DeeEmm/DIY-Flow-Bench/PCB/PCB Bottom.png

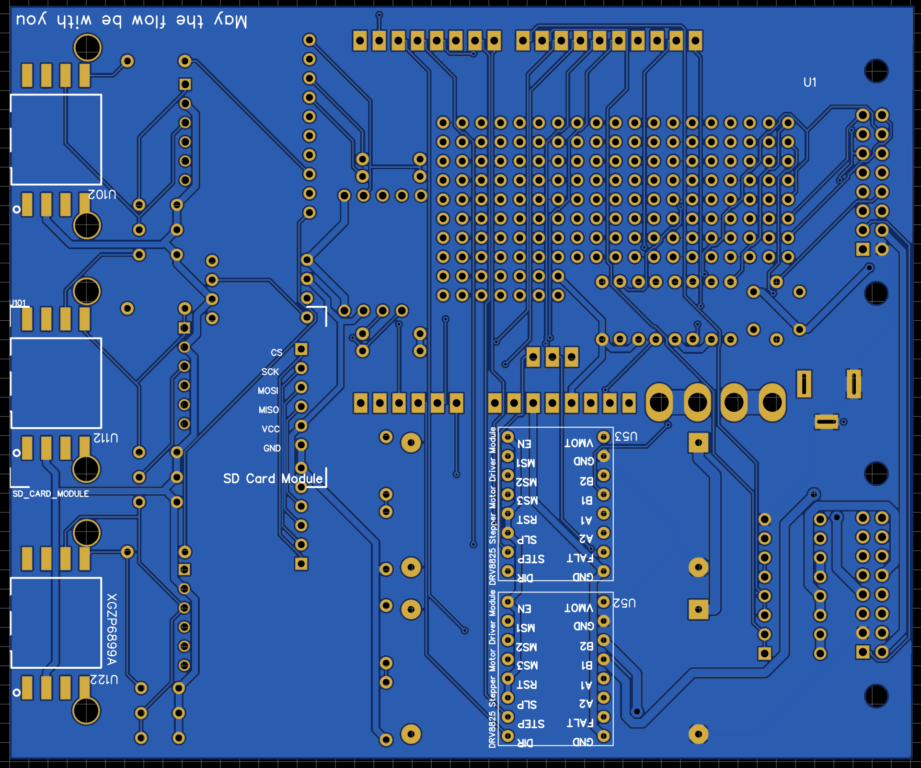
PCB/PCB Bottom.png
