DeeEmm/DIY-Flow-Bench/PCB/PCB Top.png

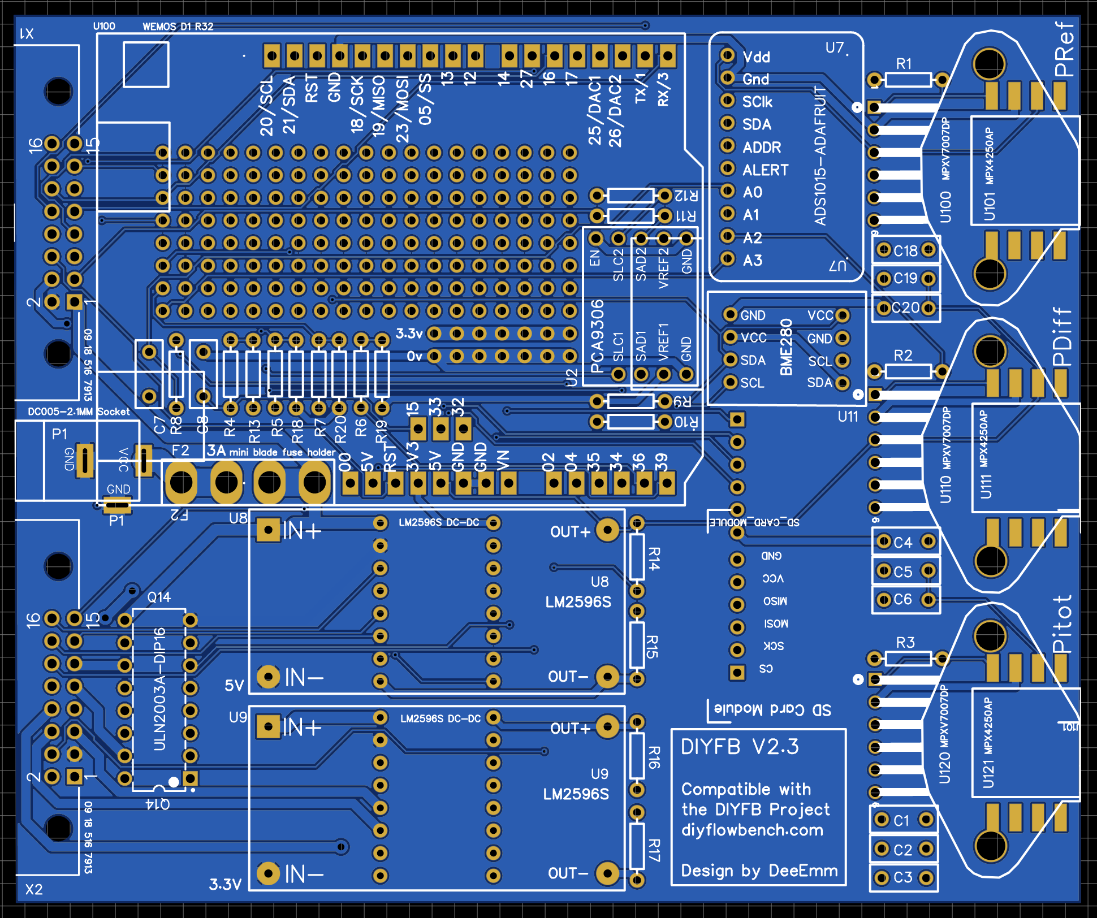
PCB/PCB Top.png
