DeeEmm/DIY-Flow-Bench/docs/BOM_DIY-FLOW-BENCH-V2-3.csv

ID | Name | Designator | Footprint | Quantity | Manufacturer Part | Manufacturer | Supplier | Supplier Part | Price
1 | 330nF | C1 | 3MM_X_7.5MM_W/_.5MM_LEADS_AT_5MM | 1 | CT4-0805Y334M500 | CT4-0805Y334M500 | LCSC | C3784
2 | 10nF | C2,C5,C19 | 3MM_X_7.5MM_W/_.5MM_LEADS_AT_5MM | 3 | CT4-0805B103K500F3 | FH | LCSC | C94713 | 0.027
3 | 1uF | C3,C6,C7,C8,C20 | 3MM_X_7.5MM_W/_.5MM_LEADS_AT_5MM | 5 | CT4-0805B105K500F3 | FH | LCSC | C94708 | 0.053
4 | 330nF | C4,C18 | 3MM_X_7.5MM_W/_.5MM_LEADS_AT_5MM | 2 | CT4-0805Y334M500 | ReliaPro | LCSC | C3784
5 | mini blade fuse holder | F2 | BLADE FUSE PCB V | 1 | ?
6 | DC005-2.1MM Socket | P1 | RS-PRO 884-0957 DC005-2.1MM | 1 | RS PRO Through Hole DC Power Socket 2.1mm Right Angle 2A | RS | RS-Online | 884-0957
7 | ULN2003A-DIP16 | Q14 | DIP-16_L20.4-W5.8-P2.54-LS7.6-BL | 1 | ULN2003A-DIP16 | MIXIC | LCSC | C112203 | 0.167
8 | 10KΩ(1002) | R1,R2,R3,R4,R5,R6,R7,R13,R14,R15,R16,R17,R18,R19,R20 | RESISTOR | 15 | MF1/4W-10KΩ±1% T52 | CCO | LCSC | C119347 | 0.01
9 | 0Ω(LINK) | R8 | RESISTOR | 1 | MF1/4W-10KΩ±1% T52 | CCO | LCSC | C119347 | 0.01
10 | 4k7Ω | R9,R10,R11,R12 | RESISTOR | 4
11 | WEMOS D1 R32 | U1 | WEMOS_ESP32_D1 | 1
12 | Sparkfun PCA9306 Logic Level Translator | U2 | SPARKFUN PCA9306 V2 | 1 |  | PCA9306 | Sparkfun | PCA9306
13 | ADS1015-ADAFRUIT | U7 | ADS1015_MODULE | 1 | ADS1015_12Bit | Adafruit
14 | LM2596S DC-DC | U8,U9 | LM2596S | 2 | OZ0055 | - | QLOUNI | -
15 | PROTO-AREA | U10 | PROTO-AREA | 1 |  |  | DeeEmm | DIYFB-V2.2-PROTO-AREA
16 | BME280-Dual-Footprint | U11 | BME280-DUAL-FOOTPRINT | 1
17 | SD_CARD_MODULE | U50,U51 | SD_CARD | 2
18 | DRV8825 Stepper Motor Driver Module | U52,U53 | DRV8825 STEPPER MOTOR DRIVER CARRIER | 2 | DRV8825 Stepper Motor Driver Module
19 | MPX4250AP | U100,U110,U120 | FREESCALE_CASE_867B-04 | 3 | ?
20 | MPXV7007DP | U101,U111,U121 | SENSOR-SMD_MPXV7007DP | 3 | MPXV7007DP | NXP(恩智浦) | LCSC | C881771 | 15.174
21 | XGZP6899A | U102,U112,U122 | SENSOR-SMD_XGZP6899A | 3 | GZP6899A001KPW50K | Sencoch(芯感智) | LCSC | C3038031 | 8.988
22 | 09 18 516 7913 | X1,X2 | 918516X913 | 2
