DeeEmm/DIY-Flow-Bench/ESP32/DIY-Flow-Bench/tools/MAF polynomial calcs V3.xlsx

Sheet: ACDELCO_92281162
V3
X Values | Y Values
millivolts | kg/hour | Calculated |  | C6 | C5 | C4 | C3 | C2 | C1 | C0
 |  |  | Coeff | 1.114334908e-21 | -3.244159168e-17 | 9.639231496e-13 | 0.000000006 | 0.000010148 | 0.007062544 | 1.734046571 | DEC
0 | 0 |  |  | 1.114334908e-21 | -3.244159168e-17 | 9.639231496e-13 | 6.388302762e-09 | 1.014759427e-05 | 0.007062543912 | 1.734046571 | E+n
10 | 1.81 | 1.805693167 | R2 | 0.9999999999
20 | 1.88 | 1.879407747
30 | 1.96 | 1.955228987 |  | C0 | C1 | C2 | C3 | C4 | C5 | C6
40 | 2.04 | 2.033195794 |  | 1.734046571 | 0.007062544 | 0.000010148 | 0.000000006 | 9.639231496e-13 | -3.244159168e-17 | 1.114334908e-21 | DEC
50 | 2.12 | 2.113347304 |  | 1.734046571 | 0.007062543912 | 1.014759427e-05 | 6.388302762e-09 | 9.639231496e-13 | -3.244159168e-17 | 1.114334908e-21 | E+n
60 | 2.19 | 2.195722886
70 | 2.28 | 2.280362134
80 | 2.37 | 2.367304874
90 | 2.46 | 2.456591161
100 | 2.55 | 2.548261276
110 | 2.64 | 2.64235573
120 | 2.74 | 2.73891526
130 | 2.84 | 2.837980831
140 | 2.94 | 2.939593633
150 | 3.05 | 3.043795086
160 | 3.15 | 3.150626832
170 | 3.26 | 3.260130741
180 | 3.37 | 3.372348907
190 | 3.48 | 3.48732365
200 | 3.61 | 3.605097513
210 | 3.72 | 3.725713265
220 | 3.84 | 3.849213897
230 | 3.98 | 3.975642624
240 | 4.1 | 4.105042884
250 | 4.23 | 4.237458337
260 | 4.37 | 4.372932866
270 | 4.51 | 4.511510577
280 | 4.65 | 4.653235794
290 | 4.8 | 4.798153066
300 | 4.95 | 4.94630716
310 | 5.09 | 5.097743064
320 | 5.25 | 5.252505988
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
4910 | 1520.51 | 1520.506551
4920 | 1530.03 | 1530.027543
4930 | 1539.59 | 1539.591654
4940 | 1549.2 | 1549.199004
4950 | 1558.85 | 1558.849716
4960 | 1568.54 | 1568.543911
4970 | 1578.28 | 1578.28171
4980 | 1588.06 | 1588.063234
4990 | 1597.89 | 1597.888605
5000 | 1607.75 | 1607.757946

Sheet: BOSCH_0280218067
V3 |  |  |  | Values include reverse flow portion from 1v down to 0v
X Values | Y Values
millivolts | kg/hour | Calculated |  | C6 | C5 | C4 | C3 | C2 | C1 | C0
 |  |  |  | Coeff | -2.736176114e-20 | 1.006005487e-15 | -2.686283635e-12 | -0.000000006 | 0.000090925 | -0.152947520 | 81.928368451 | DEC
20 | 73.6 | 78.90573578 |  |  | -2.736176114e-20 | 1.006005487e-15 | -2.686283635e-12 | -6.476436318e-09 | 9.092490865e-05 | -0.1529475199 | 81.92836845 | E+n
40 | 71.6 | 75.95552625 |  | R2 | 0.9999536889
60 | 69.6 | 73.07741399
80 | 67.6 | 70.2710636 |  |  | C0 | C1 | C2 | C3 | C4 | C5 | C6
100 | 65.6 | 67.53613052 |  | Coeff | 81.928368451 | -0.152947520 | 0.000090925 | -0.000000006 | -2.686283635e-12 | 1.006005487e-15 | -2.736176114e-20 | DEC
120 | 62.6 | 64.87226139 |  |  | 81.92836845 | -0.1529475199 | 9.092490865e-05 | -6.476436318e-09 | -2.686283635e-12 | 1.006005487e-15 | -2.736176114e-20 | E+n
140 | 61.6 | 62.27909448
160 | 59.6 | 59.75626
180 | 57.6 | 57.30338055
200 | 55.6 | 54.92007145
210 | 53.6 | 53.75438368
230 | 51.6 | 51.47469388
250 | 50.6 | 49.26358341
270 | 48.6 | 47.12064513
290 | 47.6 | 45.04546629
310 | 45.6 | 43.03762893
330 | 43.6 | 41.09671026
350 | 42.6 | 39.22228299
370 | 40.6 | 37.41391573
390 | 39.6 | 35.67117333
410 | 37.6 | 33.99361726
430 | 36.6 | 32.38080597
450 | 34.6 | 30.83229526
470 | 33.6 | 29.34763861
490 | 31.6 | 27.92638757
510 | 30.6 | 26.56809209
530 | 29.6 | 25.2723009
550 | 27.6 | 24.03856186
570 | 26.6 | 22.8664223
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
4860 | 1613.6 | 1611.19599 | 1611.513903
4880 | 1640.6 | 1639.404426 | 1640.171333
4900 | 1669.6 | 1668.051774 | 1669.322696
4920 | 1695.6 | 1697.143676 | 1698.976986
4940 | 1723.6 | 1726.685822 | 1729.143362
4960 | 1753.6 | 1756.683946 | 1759.831147
4980 | 1805.5 | 1787.14383 | 1791.049834

Sheet: DELPHI AF10118
V3
X Values | Y Values
millivolts | kg/hour | Calculated |  | C6 | C5 | C4 | C3 | C2 | C1 | C0
 |  |  | Coeff | -9.556008283e-19 | 1.317681456e-14 | -6.821730339e-11 | 0.000000168 | -0.000180578 | 0.080079937 | -1.006588218 | DEC
0 | 0 | 0 |  | -9.556008283e-19 | 1.317681456e-14 | -6.821730339e-11 | 1.680282772e-07 | -0.000180577572 | 0.0800799375 | -1.006588218 | E+n
600 | 5.62 | 10.46663831 | R2 | 0.9985975854
800 | 8.982 | 9.643659746
940 | 10.711 | 10.02249742 |  | C0 | C1 | C2 | C3 | C4 | C5 | C6
1000 | 12.44 | 10.52796485 | Coeff | -1.006588218 | 0.080079937 | -0.000180578 | 0.000000168 | -6.821730339e-11 | 1.317681456e-14 | -9.556008283e-19 | DEC
1300 | 19.597 | 16.55600609 |  | -1.006588218 | 0.0800799375 | -0.000180577572 | 1.680282772e-07 | -6.821730339e-11 | 1.317681456e-14 | -9.556008283e-19 | E+n
1400 | 22.382 | 19.85212344
1500 | 25.456 | 23.73566309
1600 | 29.251 | 28.15422496
1700 | 33.526 | 33.05135173
1800 | 38.137 | 38.37167655
1900 | 43.036 | 44.0653827
2000 | 48.175 | 50.09197514
2100 | 53.987 | 56.42336415
2200 | 59.222 | 63.04626083
2400 | 74.112 | 77.19698273
2600 | 91.259 | 92.78153075
2800 | 111.144 | 110.3118333
3000 | 132.95 | 130.5299208
3200 | 158.262 | 154.3194554
3400 | 187.177 | 182.5732261
3600 | 217.724 | 216.0166104
3800 | 258.503 | 254.9870015
4000 | 295.631 | 299.1692013
4250 | 342.461 | 359.6618743
4500 | 421.04 | 420.7196224
4750 | 490.925 | 472.4091462
5000 | 490.925 | 498.9563941
 |  |  |  | NOTE: Calculated data column should match the Y column values. It is calculated from the generated polynomials and X value. Use it as a validation check
 |  |  |  | C0 | -1.006588218
 |  |  |  | C1 | 0.0800799375
 |  |  |  | C2 | -0.000180577572
 |  |  |  | C3 | 1.680282772e-07
 |  |  |  | C4 | -6.821730339e-11
 |  |  |  | C5 | 1.317681456e-14
 |  |  |  | C6 | -9.556008283e-19

Sheet: BOSCH_0280002421
V3
X Values | Y Values
millivolts | kg/hour | Calculated |  | C6 | C5 | C4 | C3 | C2 | C1 | C0
 |  |  | Coeff | 1.698421826e-19 | -2.424047372e-15 | 1.821794921e-11 | -0.000000059 | 0.000123116 | -0.094665483 | 18.539247499 | DEC
0 | 0 | 0 |  | 1.698421826e-19 | -2.424047372e-15 | 1.821794921e-11 | -5.853131689e-08 | 0.0001231159214 | -0.09466548312 | 18.5392475 | E+n
1231.5 | 15 | 14.98592449 | R2 | 0.9999999127
1475.8 | 30 | 30.04502093
1831 | 60 | 59.94071279 |  | C0 | C1 | C2 | C3 | C4 | C5 | C6
2307.4 | 120 | 120.0341167 | Coeff | 18.539247499 | -0.094665483 | 0.000123116 | -0.000000059 | 1.821794921e-11 | -2.424047372e-15 | 1.698421826e-19 | DEC
2921.2 | 250 | 250.0564767 |  | 18.5392475 | -0.09466548312 | 0.0001231159214 | -5.853131689e-08 | 1.821794921e-11 | -2.424047372e-15 | 1.698421826e-19 | E+n
3287.4 | 370 | 369.7892392
3546.1 | 480 | 480.214746
3843.2 | 640 | 639.9343947
4149.9 | 850 | 849.9891884
4331.2 | 1000 | 1000.01018
 |  |  |  | NOTE: Calculated data column should match the Y column values. It is calculated from the generated polynomials and X value. Use it as a validation check
 |  |  |  | C0 | 18.5392475
 |  |  |  | C1 | -0.09466548312
 |  |  |  | C2 | 0.0001231159214
 |  |  |  | C3 | -5.853131689e-08
 |  |  |  | C4 | 1.821794921e-11
 |  |  |  | C5 | -2.424047372e-15
 |  |  |  | C6 | 1.698421826e-19

Sheet: BOSCH_0280218008
V3
X Values | Y Values
millivolts | kg/hour | Calculated |  | C6 | C5 | C4 | C3 | C2 | C1 | C0
 |  |  | Coeff | 3.87964694e-19 | -6.742284983e-15 | 5.333133272e-11 | -0.000000215 | 0.000488590 | -0.526769493 | 215.833017131 | DEC
0 | 0 | 0 |  | 3.87964694e-19 | -6.742284983e-15 | 5.333133272e-11 | -2.150081845e-07 | 0.0004885899551 | -0.5267694935 | 215.8330171 | E+n
1339.5 | 15 | 14.98890353 | R2 | 0.9999999329
1625.1 | 30 | 30.03942921
2010.9 | 60 | 59.94244566 |  | C0 | C1 | C2 | C3 | C4 | C5 | C6
2556.4 | 120 | 120.0470834 | Coeff | 215.833017131 | -0.526769493 | 0.000488590 | -0.000000215 | 5.333133272e-11 | -6.742284983e-15 | 3.87964694e-19 | DEC
3265.5 | 250 | 249.9928146 |  | 215.8330171 | -0.5267694935 | 0.0004885899551 | -2.150081845e-07 | 5.333133272e-11 | -6.742284983e-15 | 3.87964694e-19 | E+n
3671.7 | 370 | 369.9022205
3949 | 480 | 480.1526031
4260 | 640 | 639.918381
4572.7 | 850 | 850.0161192
 |  |  |  | NOTE: Calculated data column should match the Y column values. It is calculated from the generated polynomials and X value. Use it as a validation check
 |  |  |  | C0 | 215.8330171
 |  |  |  | C1 | -0.5267694935
 |  |  |  | C2 | 0.0004885899551
 |  |  |  | C3 | -2.150081845e-07
 |  |  |  | C4 | 5.333133272e-11
 |  |  |  | C5 | -6.742284983e-15
 |  |  |  | C6 | 3.87964694e-19

Sheet: BOSCH 0280218038
V3
X Values | Y Values
millivolts | kg/hour | Calculated |  | C6 | C5 | C4 | C3 | C2 | C1 | C0
 |  |  | Coeff | 1.500832877e-19 | -2.326988882e-15 | 1.814731441e-11 | -0.000000071 | 0.000167232 | -0.168837155 | 60.012246926 | DEC
0 | 0 | 0 |  | 1.500832877e-19 | -2.326988882e-15 | 1.814731441e-11 | -7.088416805e-08 | 0.0001672318786 | -0.1688371547 | 60.01224693 | E+n
1269.5 | 10.28169014 | 10.25327361 | R2 | 0.999999914
1406 | 15.42253521 | 15.49089444
1710 | 30.84507042 | 30.76295998 |  | C0 | C1 | C2 | C3 | C4 | C5 | C6
2156.3 | 61.69014085 | 61.76721282 | Coeff | 60.012246926 | -0.168837155 | 0.000167232 | -0.000000071 | 1.814731441e-11 | -2.326988882e-15 | 1.500832877e-19 | DEC
2752.2 | 123.3802817 | 123.3177158 |  | 60.01224693 | -0.1688371547 | 0.0001672318786 | -7.088416805e-08 | 1.814731441e-11 | -2.326988882e-15 | 1.500832877e-19 | E+n
3507 | 257.0422535 | 257.1172307
3939.3 | 380.4225352 | 380.3320377
4234.9 | 493.5211268 | 493.5731809
4566.9 | 658.028169 | 658.0192969
 |  |  |  |  |  |  |  |  |  |  |  | 71 | 73
 |  |  |  |  |  |  |  |  |  |  |  | 55.7632696 | 57.33406593
 |  |  |  |  |  |  |  |  |  |  |  | 0 | 0
 |  |  |  |  |  |  |  |  |  |  |  | 10 | 10.28169014
 |  |  |  |  |  |  |  |  |  |  |  | 15 | 15.42253521
 |  |  |  |  |  |  |  |  |  |  |  | 30 | 30.84507042
 |  |  |  |  |  |  |  |  |  |  |  | 60 | 61.69014085
 |  |  |  |  |  |  |  |  |  |  |  | 120 | 123.3802817
 |  |  |  |  |  |  |  |  |  |  |  | 250 | 257.0422535
 |  |  |  |  |  |  |  |  |  |  |  | 370 | 380.4225352
 |  |  |  |  |  |  |  |  |  |  |  | 480 | 493.5211268
 |  |  |  |  |  |  |  |  |  |  |  | 640 | 658.028169
 |  |  |  |  |  |  |  |  |  |  |  | (flowRateKGH / oldMafArea) * newMafArea;
 |  |  |  | NOTE: Data is transposed from 0208217531 as this uses same HPM5 style sensor but has different housing diameter
 |  |  |  | C0 | 60.01224693
 |  |  |  | C1 | -0.1688371547
 |  |  |  | C2 | 0.0001672318786
 |  |  |  | C3 | -7.088416805e-08
 |  |  |  | C4 | 1.814731441e-11
 |  |  |  | C5 | -2.326988882e-15
 |  |  |  | C6 | 1.500832877e-19

Sheet: BOSCH 0280217531
V3
X Values | Y Values
millivolts | kg/hour | Calculated |  | C6 | C5 | C4 | C3 | C2 | C1 | C0
 |  |  | Coeff | 1.459714168e-19 | -2.263235762e-15 | 1.765012772e-11 | -0.000000069 | 0.000162650 | -0.164211479 | 58.368075777 | DEC
0 | 0 | 0 |  | 1.459714168e-19 | -2.263235762e-15 | 1.765012772e-11 | -6.894213605e-08 | 0.0001626501833 | -0.1642114792 | 58.36807578 | E+n
1269.5 | 10 | 9.972362 | R2 | 0.999999914
1406 | 15 | 15.06648637
1710 | 30 | 29.92013916 |  | C0 | C1 | C2 | C3 | C4 | C5 | C6
2156.3 | 60 | 60.07496042 | Coeff | 58.368075777 | -0.164211479 | 0.000162650 | -0.000000069 | 1.765012772e-11 | -2.263235762e-15 | 1.459714168e-19 | DEC
2752.2 | 120 | 119.9391482 |  | 58.36807578 | -0.1642114792 | 0.0001626501833 | -6.894213605e-08 | 1.765012772e-11 | -2.263235762e-15 | 1.459714168e-19 | E+n
3507 | 250 | 250.072923
3939.3 | 370 | 369.9119819
4234.9 | 480 | 480.050628
4566.9 | 640 | 639.991371
 |  |  |  | NOTE: Calculated data column should match the Y column values. It is calculated from the generated polynomials and X value. Use it as a validation check
 |  |  |  | C0 | 58.36807578
 |  |  |  | C1 | -0.1642114792
 |  |  |  | C2 | 0.0001626501833
 |  |  |  | C3 | -6.894213605e-08
 |  |  |  | C4 | 1.765012772e-11
 |  |  |  | C5 | -2.263235762e-15
 |  |  |  | C6 | 1.459714168e-19

Sheet: BOSCH 0280218019
V3
X Values | Y Values
millivolts | kg/hour | Calculated |  | C6 | C5 | C4 | C3 | C2 | C1 | C0
 |  |  | Coeff | 1.912436353e-19 | -3.589391483e-15 | 3.06368606e-11 | -0.000000130 | 0.000308055 | -0.344050939 | 146.507540239 | DEC
0 | 0 | 0 |  | 1.912436353e-19 | -3.589391483e-15 | 3.06368606e-11 | -1.30212445e-07 | 0.0003080547392 | -0.3440509394 | 146.5075402 | E+n
1239 | 8 | 7.873897204 | R2 | 0.9999992952
1364.4 | 10 | 10.25636546
1524.1 | 15 | 14.91101283 |  | C0 | C1 | C2 | C3 | C4 | C5 | C6
1874.8 | 30 | 29.86112554 | Coeff | 146.507540239 | -0.344050939 | 0.000308055 | -0.000000130 | 3.06368606e-11 | -3.589391483e-15 | 1.912436353e-19 | DEC
2371 | 60 | 60.17983608 |  | 146.5075402 | -0.3440509394 | 0.0003080547392 | -1.30212445e-07 | 3.06368606e-11 | -3.589391483e-15 | 1.912436353e-19 | E+n
2999.8 | 120 | 119.8670596
3749.4 | 250 | 250.1023378
4169.5 | 370 | 369.926057
4457.8 | 480 | 480.0223084
 |  |  |  | NOTE: Calculated data column should match the Y column values. It is calculated from the generated polynomials and X value. Use it as a validation check
 |  |  |  | C0 | 146.5075402
 |  |  |  | C1 | -0.3440509394
 |  |  |  | C2 | 0.0003080547392
 |  |  |  | C3 | -1.30212445e-07
 |  |  |  | C4 | 3.06368606e-11
 |  |  |  | C5 | -3.589391483e-15
 |  |  |  | C6 | 1.912436353e-19

Sheet: BOSCH 0280217123
V3
X Values | Y Values
millivolts | kg/hour | Calculated |  | C6 | C5 | C4 | C3 | C2 | C1 | C0
 |  |  | Coeff | 4.284611064e-21 | 1.353821019e-16 | -8.807727452e-13 | 0.000000003 | 0.000004256 | -0.005188161 | -0.000474950 | DEC
0 | 0 | 0 |  | 4.284611064e-21 | 1.353821019e-16 | -8.807727452e-13 | 2.949491767e-09 | 4.255630533e-06 | -0.005188161384 | -0.0004749497582 | E+n
1483.7 | 8 | 8.054453699 | R2 | 0.9999995229
1581.9 | 10 | 10.01021913
1789.8 | 15 | 14.84595676 |  | C0 | C1 | C2 | C3 | C4 | C5 | C6
2273.9 | 30 | 30.15989377 | Coeff | -0.000474950 | -0.005188161 | 0.000004256 | 0.000000003 | -8.807727452e-13 | 1.353821019e-16 | 4.284611064e-21 | DEC
2886.8 | 60 | 59.89751006 |  | -0.0004749497582 | -0.005188161384 | 4.255630533e-06 | 2.949491767e-09 | -8.807727452e-13 | 1.353821019e-16 | 4.284611064e-21 | E+n
3625.5 | 120 | 120.0422488
4472.7 | 250 | 249.986505
4940.6 | 370 | 370.0036877
 |  |  |  | NOTE: Calculated data column should match the Y column values. It is calculated from the generated polynomials and X value. Use it as a validation check
 |  |  |  | C0 | -0.0004749497582
 |  |  |  | C1 | -0.005188161384
 |  |  |  | C2 | 4.255630533e-06
 |  |  |  | C3 | 2.949491767e-09
 |  |  |  | C4 | -8.807727452e-13
 |  |  |  | C5 | 1.353821019e-16
 |  |  |  | C6 | 4.284611064e-21

Sheet: VDO_5WK96132Z
V3
X Values | Y Values
millivolts | kg/hour | Calculated |  | C6 | C5 | C4 | C3 | C2 | C1 | C0
 |  |  | Coeff | -5.037325452e-19 | 7.412988999e-15 | -3.886082116e-11 | 0.000000098 | -0.000100137 | 0.059430983 | -1.095527704 | DEC
0 | 0 | 0 |  | -5.037325452e-19 | 7.412988999e-15 | -3.886082116e-11 | 9.785115778e-08 | -0.0001001373663 | 0.05943098274 | -1.095527704 | E+n
5 | 1.78 | 0.05381361982 | R2 | 0.9999124262
10 | 2.23 | 1.127655567
20 | 2.69 | 2.130474697 |  | C0 | C1 | C2 | C3 | C4 | C5 | C6
40 | 3.14 | 3.066603983 | Coeff | -1.095527704 | 0.059430983 | -0.000100137 | 0.000000098 | -3.886082116e-11 | 7.412988999e-15 | -5.037325452e-19 | DEC
60 | 3.58 | 3.940235609 |  | -1.095527704 | 0.05943098274 | -0.0001001373663 | 9.785115778e-08 | -3.886082116e-11 | 7.412988999e-15 | -5.037325452e-19 | E+n
80 | 4.03 | 4.755423726
100 | 4.48 | 5.5160872
120 | 4.92 | 6.226012329
140 | 5.38 | 6.888855539
160 | 5.81 | 7.508146058
180 | 6.28 | 8.087288561
200 | 6.72 | 8.629565802
220 | 7.25 | 9.13814121
240 | 7.55 | 9.616061475
260 | 7.86 | 10.0662591
280 | 8.17 | 10.49155494
300 | 8.48 | 10.89466071
320 | 8.81 | 11.27818145
340 | 9.14 | 11.64461804
360 | 9.47 | 11.99636958
380 | 9.81 | 12.33573585
400 | 10.17 | 12.6649197
420 | 10.53 | 12.98602939
440 | 10.89 | 13.30108096
460 | 11.27 | 13.61200058
480 | 11.66 | 13.92062678
500 | 12.05 | 14.22871281
520 | 12.45 | 14.53792884
540 | 12.88 | 14.8498642
560 | 13.3 | 15.16602961
580 | 13.73 | 15.48785935
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
4820 | 911.05 | 936.4145627
4840 | 923.3 | 949.6491056
4860 | 935.61 | 962.9712182
4880 | 948 | 976.3776507
4900 | 960.48 | 989.8650049
4920 | 973.06 | 1003.429731
4940 | 985.73 | 1017.068126
4960 | 998.53 | 1030.776328
4980 | 1011.42 | -1.095527704
5000 | 1023.98 | -1.095527704

Sheet: MH95_3000_100
V3
X Values | Y Values
millivolts | kg/hour | Calculated |  | C6 | C5 | C4 | C3 | C2 | C1 | C0
 |  |  | Coeff | #VALUE! | #VALUE! | #VALUE! | #VALUE! | #VALUE! | #VALUE! | #VALUE! | DEC
0 | 0 | 0 |  | #VALUE! | #VALUE! | #VALUE! | #VALUE! | #VALUE! | #VALUE! | #VALUE! | E+n
880 1 | 1156 | #VALUE! | R2 | #VALUE!
896 1 | 1271 | #VALUE!
912 1 | 1390 | #VALUE! |  | C0 | C1 | C2 | C3 | C4 | C5 | C6
928 1 | 1512 | #VALUE! | Coeff | #VALUE! | #VALUE! | #VALUE! | #VALUE! | #VALUE! | #VALUE! | #VALUE! | DEC
945 1 | 1637 | #VALUE! |  | #VALUE! | #VALUE! | #VALUE! | #VALUE! | #VALUE! | #VALUE! | #VALUE! | E+n
961 1 | 1767 | #VALUE!
977 1 | 1900 | #VALUE!
993 2 | 2037 | #VALUE!
1009 | 2179
1025 | 2325
1042 | 2476
1058 | 2631
1074 | 2792
1090 | 2958
1106 | 3130
1122 | 3307
1139 | 3490
1155 | 3678
1171 | 3873
1187 | 4075
1203 | 4283
1219 | 4498
1235 | 4720
1252 | 4948
1268 | 5185
1284 | 5428
1300 | 5680
1316 | 5939
1332 | 6207
1349 | 6483
1365 | 6767
1381 | 7060
1397 | 7361
1413 | 7672
1429 | 7992
1445 | 8322
1462 | 8661
1478 | 9009
1494 | 9368
1510 | 9737
1526 | 10117 |  |  | NOTE: Calculated data column should match the Y column values. It is calculated from the generated polynomials and X value. Use it as a validation check
1542 | 10506
1559 | 10907
1575 | 11319
1591 | 11741 |  |  | C0 | #VALUE!
1607 | 12176 |  |  | C1 | #VALUE!
1623 | 12621 |  |  | C2 | #VALUE!
1639 | 13078 |  |  | C3 | #VALUE!
1656 | 13548 |  |  | C4 | #VALUE!
1672 | 14029 |  |  | C5 | #VALUE!
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
4677 | 543155
4693 | 549762
4709 | 556427
4725 | 563149
4741 | 569930
4758 | 576769
4774 | 583667
4790 | 590624
4806 | 597641
4822 | 604718
4838 | 611855
4855 | 619052
4871 | 626311
4887 | 633630
4903 | 641012
4919 | 648455
4935 | 655960
4952 | 663528
4968 | 671159
4984 | 678854
5000 | 686611

Sheet: CALCS
Gram/sec | kg/h
2.38 | 8.568 | 0
2.68 | 9.648 | 181 | 1.81 | {0,0}, | 0 | 0 | 0 | 0 | 1.78 | 2.23 | 2.69 | 3.14 | 3.58 | 4.03 | 4.48 | 4.92 | 5.38 | 5.81 | 6.28 | 6.72
3.02 | 10.872 | 188 | 1.88 | {1500,142}, | 7.25 | 7.55 | 7.86 | 8.17 | 8.48 | 8.81 | 9.14 | 9.47 | 9.81 | 10.17 | 10.53 | 10.89 | 11.27 | 11.66 | 12.05 | 12.45
3.38 | 12.168 | 196 | 1.96 | {1625,176}, | 12.88 | 13.3 | 13.73 | 14.19 | 14.64 | 15.09 | 15.58 | 16.06 | 16.56 | 17.06 | 17.58 | 18.11 | 18.64 | 19.19 | 19.75 | 20.31
3.78 | 13.608 | 204 | 2.04 | {1750,210}, | 20.91 | 21.5 | 22.09 | 22.72 | 23.34 | 24 | 24.66 | 25.33 | 26.02 | 26.73 | 27.45 | 28.2 | 28.95 | 29.73 | 30.53 | 31.34
4.21 | 15.156 | 212 | 2.12 | {1875,248}, | 32.19 | 33.05 | 33.94 | 34.84 | 35.77 | 36.72 | 37.69 | 38.69 | 39.69 | 40.72 | 41.77 | 42.83 | 43.91 | 44.98 | 46.09 | 47.2
4.68 | 16.848 | 219 | 2.19 | {2000,286}, | 48.33 | 49.47 | 50.61 | 51.77 | 52.92 | 54.09 | 55.28 | 56.47 | 57.67 | 58.89 | 60.13 | 61.38 | 62.64 | 63.92 | 65.22 | 66.53
5.18 | 18.648 | 228 | 2.28 | {2125,326}, | 67.88 | 69.23 | 70.63 | 72.03 | 73.45 | 74.92 | 76.41 | 77.92 | 79.47 | 81.05 | 82.64 | 84.28 | 85.97 | 87.67 | 89.42 | 91.2
5.73 | 20.628 | 237 | 2.37 | {2250,370}, | 93.03 | 94.89 | 96.78 | 98.7 | 100.67 | 102.67 | 104.7 | 106.78 | 108.88 | 111.03 | 113.2 | 115.42 | 117.67 | 119.95 | 122.28 | 124.64
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
 |  | 149220 | 1492.2
 |  | 150159 | 1501.59
 |  | 151103 | 1511.03
 |  | 152051 | 1520.51
 |  | 153003 | 1530.03
 |  | 153959 | 1539.59
 |  | 154920 | 1549.2
 |  | 155885 | 1558.85
 |  | 156854 | 1568.54
 |  | 157828 | 1578.28
 |  | 158806 | 1588.06
 |  | 159789 | 1597.89
 |  | 160775 | 1607.75
