DeeEmm/DIY-Flow-Bench/3D Parts/110mm Dia MAF Mount v4.stl

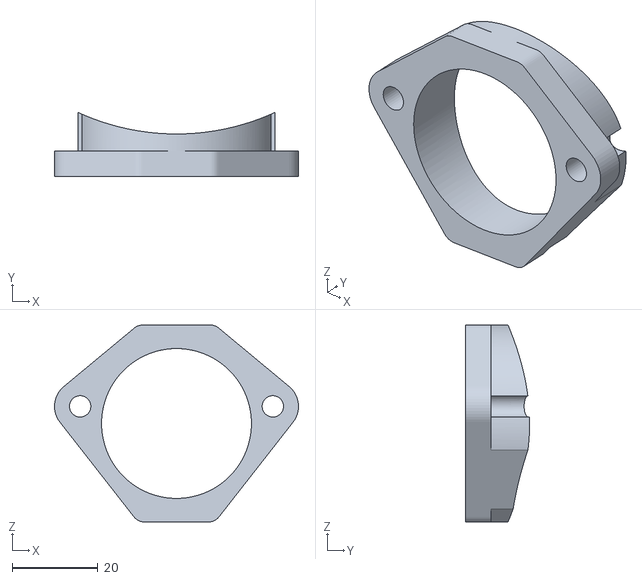
[picture p4: CAD file, 2020-08-11]
3D Parts/110mm Dia MAF Mount v4.stl
57.0 x 15.0 x 46.0
