DeeEmm/DIY-Flow-Bench/(list of files, cad)

Other CAD files:
3D Parts/110mm Dia MAF Mount v4.f3d
