DeeEmm/DIY-Flow-Bench/(threads)

Thread 1 (2019-12-06):

Add support for additional pressure sensors

DeeEmm, 2019-12-06:
Integrate support additional sensors within the code.

DeeEmm, 2019-12-08:
Moved out to V2

DeeEmm, 2019-12-23:
Added support for two BMP libraries

Closed 2019-12-23.

Thread 2 (2019-12-06):

Add support for temperature sensor

DeeEmm, 2019-12-06:
Add integration for temperature sensors

DeeEmm, 2019-12-08:
Moved out to V2

DeeEmm, 2019-12-20:
Added integration for BMP280 adafruit sensor

Closed 2019-12-20.

Thread 5 (2019-12-06):

Add error / info / warning popups to menu display

DeeEmm, 2019-12-06:
Use integrated tcMenu function to display warning / info / error messages over main display.

One example for this is if the calibration or leak checks return a non-compliant condition.

DeeEmm, 2019-12-08:
Build 19120801

Created error handling function and split display popover dialog out into separate function.

void errorChecking(int errorNum)
void displayDialog(const char *dialogTitle, const char *dialogMessage)
void onDialogFinished(ButtonType btnPressed, void* /*userdata*/) {

Closed 2019-12-08.

Thread 7 (2019-12-06):

Update calibration functions

DeeEmm, 2019-12-06:
Calibration functions currently use a two point method to determine response slope, however this only works for MAF sensors with a linear output.

It is proposed that MAF algorithms are to be hard coded such that the MAF sensors characteristics are defined by a lookup table or by mathematical means if possible.

For this reason it will only be necessary to calibrate the sensor to a single known value.

It is also proposed that a Compact Disc is used as the calibration orifice as this is a commonly available object.

DeeEmm, 2019-12-08:
Added support for single calibration offset.

Menu function 'Calibrate Offset' will compare current flow to calibrationFlowRate value at the calibration test pressure defined by calibrationRefPressure and store the difference in NVM.

This offset is then used in float getMafFlowCFM () function to offset flow value.

calibrationFlowRate is set to 14.7 (cfm) by default in configuration.h this is the flow rate of the hole in the centre of a compact disc at 10"/wg

For this value to be correct, calibrationRefPressure must also be set to 10 (in/wg)

Closed 2019-12-08.

Thread 8 (2019-12-06):

Reference pressure menu item

DeeEmm, 2019-12-06:
Add menu item to be able to select the reference pressure value

DeeEmm, 2019-12-08:
Moving out to V2

DeeEmm, 2022-12-19:
Commit https://github.com/DeeEmm/DIY-Flow-Bench/commit/31bd75b5060e5e4ee337d3f3975db7e8dafa8cfe adds ability to select reference pressure for adjusted flow. Adjusted flow is displayed in GUI. Clicking on flow reading swaps display tile between flow value and adjusted flow value

Closed 2022-12-19.

Thread 9 (2019-12-06):

Max flow error check

DeeEmm, 2019-12-06:
Ref pressure check - compare actual pressure against stored max ref pressure (ie max flow).

If pressure drop is approaching stored value, then the flow is nearing limits of vac source, so display error message on screen to alert user.

DeeEmm, 2019-12-08:
Added function to display popup dialog on screen to show error message.

Function void errorChecking()

can also be expanded to cover other checks if required.

Closed 2019-12-08.

Thread 10 (2019-12-07):

Change MAF scaling to use lookup table

DeeEmm, 2019-12-07:
Integrate lookup table for MAF sensor within a separate file called from within calibration.h

Users can then create simple volts / flow lookup table to describe the output function of their MAF sensor.

File should be named with MAF part number to make it easy for others to identify the data.

File format should be header file with function that loads data into array.

MAF is therefore set at compile time.

DeeEmm, 2019-12-07:
Created MAF data files within src/mafData subdir

MAF Data stored within array.
Can use either mV/CFM or raw analog data as reference

Files created
exampleSensor.h
SIEMENS_5WK9605.h
DELPHI_AF10118.h

Closed 2019-12-07.

Thread 12 (2019-12-08):

Add support for additional languages

DeeEmm, 2019-12-08:
Language based strings split out into separate file (EN_Language.h)

Include call to file can easily be changed for difference languages

~~Also need to translate tcMenu files for full language support~~

Need to look at how to handle web page translations

DeeEmm, 2021-08-20:
Created Wiki page for language support - https://github.com/DeeEmm/DIY-Flow-Bench/wiki/Langauge-Support

DeeEmm, 2021-08-25:
For web page translation the easiest way to handle language support is to simply translate index.html

This avoids needing to implement additional complex code to manage language templates.

May revisit this down the track but for now I am closing it out

Closed 2021-08-25.

Thread 14 (2019-12-09):

Make sure that we are reading MAF data array from lowest value to highest

DeeEmm, 2019-12-09:
MAF check is looking for first higher value in data array, however this will only work is we are reading the array from its lowest value to its highest.

This may not be an issue if MAF Data file is sorted in correct order but need to verify this is the case as if data is in high to low order the value returned will be incorrect (it will return first value)

DeeEmm, 2019-12-10:
Have sorted data in low to high order in Delphi MAF data file.

Still need to do further validation on error.

DeeEmm, 2020-08-01:
After consideration, MAF Data files need to be in the correct format / order so this check is redundant.

Closed 2020-08-01.

Thread 16 (2019-12-10):

Low flow error when no sensor connected

DeeEmm, 2019-12-10:
Sensor input floating so code returns a low flow error.

DeeEmm, 2019-12-10:
added additional validation checking in bench running function

Closed 2019-12-10.

Thread 18 (2019-12-20):

Compile error for BMP280 library

DeeEmm, 2019-12-20:
Code will not compile when BMP280 sensor calls are enabled

DeeEmm, 2019-12-20:
Issue with pre-directives casusing library not to be initiated correctly in all cases.

Restructured pre-directives so that they worked in all cases

Closed 2019-12-20.

Thread 19 (2019-12-23):

Add support for RH sensor

DeeEmm, 2019-12-23:
Need to include RH measurements to allow correct conversion of Mass to Volumetric flow

Look at integration of DHT11 Sensor / Library

DeeEmm, 2019-12-23:
Added support for DHT11 using simple DHT library - https://github.com/winlinvip/SimpleDHT

Need to test as sampling rate is 1khz so may need to delay read to every 2 secs or so

ModchipMan, 2019-12-24:
Is Humidity displayed on LCD in some Menu..?

DeeEmm, 2019-12-26:
No, but I've now added it to the menu. Will be included in next release.

Also fixed compilation error #23 DHT11 Won't compile

DeeEmm, 2020-07-28:
Humidity now included in Build 20072901 using Adafruit BME280 combined sensor

Closed 2020-07-28.

Thread 20 (2019-12-23):

Verify Pressure sensor types

DeeEmm, 2019-12-23:
Need to validate / verify pressure sensor choice and code for:

- Reference pressure sensor (should use absolute pressure sensor)
- Baro pressure sensor (requires absolute pressure sensor)

ModchipMan, 2019-12-23:
MPXV7007DP as ref pressure, works, but the maths needs work, raw value at atmosphere is 510-520, so will need to calibrated for zero reading, probably at bench start time or when you do bench calibration..

ModchipMan, 2019-12-23:
ilibBMP280 as intake temp and Baro pressure, works, but needs these two lines in each section or it dosnt update values, just stays on startup value,
ilibBmp280.awaitMeasurement();
ilibBmp280.triggerMeasurement();
Temp dosnt really need rounding..

DeeEmm, 2019-12-26:
I've uncommented the lines in the code in the next release.

MPXV7007DP _should_ give a zero value as it is a differential sensor. It should not need calibrating as it's only displaying the difference between the two ports.

Will take a further look.

ModchipMan, 2019-12-26:
MPXV7007DP has a raw value of around 512 - 2.5v, which is about centre of 1024 or 5v, the 2 x ports both take vac or pressure, the only difference is  if you get less or more raw value with vac or pressure, hence differential pressure between the ports
So im using the port that raw value rises with pressure and reduces with vacuum, leaving the other port open to atmosphere.
with weather change and between both the MPXV7007DP's  the other being pilot pressure they can be between 510-520 raw value difference.
I think because they are si fine in resolution they see weather pressure change as well.
You should be up and running soon and can have a look..

DeeEmm, 2019-12-26:
There were some issues with the formula used to decode the input for the DP sensor. Should be good now.

Closed 2020-08-03.

Thread 21 (2019-12-23):

Calibration offset giving large negative value

DeeEmm, 2019-12-23:
Need to validate & test

DeeEmm, 2020-08-04:
Discussions on calibration function - https://diyflowbench.com/forum/software/29-calibration-function#54

DeeEmm, 2020-08-06:
Calibration offset appears to be working fine however large values appear to be as a result of the flow conversion function convertMafFlowInWg().

I'm not too sure at this stage if this is a valid result. More testing / research needed.

I will close this out and open another issue

Closed 2020-08-06.

Thread 22 (2019-12-23):

Floating MAF voltage

DeeEmm, 2019-12-23:
MAF I/P showing 4v with no sensor disconnected.

Need to validate with sensor connected

ModchipMan, 2019-12-23:
Im getting 3.42cfm with zero flow.

DeeEmm, 2019-12-23:
Does it disappear if you add the following line to your Maf Data file
{0,0},

Add it above the other values

ModchipMan, 2019-12-24:
added above to MAF Data file, still the same with weather change, it is now at 3.48cfm

DeeEmm, 2020-08-03:
MAF decode now tested and stable

Closed 2020-08-03.

Thread 24 (2019-12-24):

Erratic Rotary Encoder

ModchipMan, 2019-12-24:
This could be my wiring issue.
I have the 2 x Caps 150n attached
fly lead length is about 2ft long from encoder to arduino.
Pin A = D2
Pin B = D3
Pin C= GND
switchP1 = GND
switchP2 = D5

Issue is it will only go in a down direction with counter clockwise rotation or clockwise rotation, The push button for OK is very hit and miss to function.

DeeEmm, 2019-12-26:
Do you get the same results if the caps are removed?

ModchipMan, 2019-12-26:
Its the same with or with out caps..

ModchipMan, 2019-12-29:
I have found out what is causing this,
its the the delays in program
I created a simple menu with tcMenu and it worked a treat, as soon as i added delay(1000); in to program, the encoder become very hit and miss..

ModchipMan, 2019-12-29:
Also, the encoder needs the 150n caps, or it also becomes erratic.

DeeEmm, 2019-12-30:
Cool. Good catch. I will remove the delay from the next update. Just set it to zero for the time being.

The delay was only there to give us an easy way to stabilise the display readout. We can also achieve that by other methods. (eg sample average).

DeeEmm, 2019-12-30:
What build are you using?

The delay has already been removed in the latest version

DeeEmm, 2020-08-03:
Any update on this?

DeeEmm, 2020-08-06:
I'm going to close this one out. I cannot reproduce it.

Closed 2020-08-06.

Thread 26 (2020-04-26):

Frequency based MAF sensor

DeeEmm, 2020-04-26:
Add support for frequency based MAF sensors

As requested by Branco Jurgec via FB - https://www.facebook.com/branko.jurgec?comment_id=Y29tbWVudDoyNzA3NTkwOTg5Mjk4OTk2XzI5OTIwOTY4NDA4NDg0MDg%3D

DeeEmm, 2021-08-21:
Example Frequency MAF data file. (GM Monaro)

```
/***********************************************************
 * VDO-AFM-043.h
 *
 * Manufacturer: VDO | Siemens
 * Part#: AFM-043 | 25008302 | A2C59506198
 * MAF file for type: GM GenIII LS1 / VT-VX-VY 5.7 Commodore / Monaro
 * File units = 100 * gm / sec
 * Comments: Basic test data
 * Status:
 * Support: https://github.com/DeeEmm/DIY-Flow-Bench/wiki/MAF-Data-Files
 * Discussion: https://github.com/DeeEmm/DIY-Flow-Bench/discussions/51
 ***/
#pragma once

#include "../mafData.h"
#include "../constants.h"

MafData::MafData () {

}

/***********************************************************
 * MAF Type
 *
 ***/
String MafData::mafSensorType () {

	String mafSensorType = "VDO-AFM-043";

	return mafSensorType;

}

/***********************************************************
 * MAF Output Type
 *
 * VOLTAGE
 * FREQUENCY
 ***/
int MafData::MAFoutputType() {

	int MAFoutputType = FREQUENCY;

	return MAFoutputType;
}

/***********************************************************
 * MAF Data format
 *
 * KEY_VALUE
 * RAW_ANALOG
 ***/
int MafData::MAFdataFormat () {

	int  MAFdataFormat = KEY_VALUE;
	return MAFdataFormat;
}

/***********************************************************
 * MAF Units
 *
 * KG_H
 * MG_S
 ***/
int MafData::MAFdataUnit () {

	int MAFdataUnit = MG_S;
	return MAFdataUnit;
}

/***********************************************************
 * Kay>Val MAF Data
 *
 ***/
long MafData::getMafData() {

	long mafLookupTable [][2] = {
		{1500,214},
		{1625,259},
		{1750,307},
		{1875,359},
		{2000,415},
		{2125,474},
		{2250,540},
		{2375,610},
		{2500,685},
		{2625,767},
		{2750,855},
		{2875,948},
		{3000,1050},
		{3125,1159},
		{3250,1276},
		{3375,1402},
		{3500,1534},
		{3625,1695},
		{3750,1866},
		{3875,2052},
		{4000,2229},
		{4125,2416},
		{4250,2616},
		{4375,2826},
		{4500,3048},
		{4625,3283},
		{4750,3530},
		{4875,3791},
		{5000,4066},
		{5125,4354},
		{5250,4657},
		{5375,4974},
		{5500,5306},
		{5625,5655},
		{5750,6019},
		{5875,6398},
		{6000,6795},
		{6125,7209},
		{6250,7641},
		{6375,8091},
		{6500,8558},
		{6625,9045},
		{6750,9550},
		{6875,10074},
		{7000,10620},
		{7125,11184},
		{7250,11770},
		{7375,12376},
		{7500,13004},
		{7625,13654},
		{7750,14326},
		{7875,15020},
		{8000,15738},
		{8125,16479},
		{8250,17244},
		{8375,18032},
		{8500,18846},
		{8625,19684},
		{8750,20548},
		{8875,21438},
		{9000,22353},
		{9125,23295},
		{9250,24264},
		{9375,25260},
		{9500,26284},
		{9625,27337},
		{9750,28417},
		{9875,29527},
		{10000,30666},
		{10125,31834},
		{10250,33033},
		{10375,34262},
		{10500,35521},
		{10625,36813},
		{10750,38135},
		{10875,39490},
		{11000,40877},
		{11125,42297},
		{11250,43750},
		{11375,45237},
		{11500,46758},
		{11625,48313},
		{11750,49902},
		{11875,51199},
		{12000,51199}
	};

}
```

NOTE: Need to use interrupt capable pin to be able to measure frequency

DeeEmm, 2021-08-24:
Frequency based MAF sensor code implemented.

MafData file format changed from class structure back to header file to address conflicts.

WIKI info for MAF file creation updated

```
/***********************************************************
 * ACDELCO-19330122.h
 *
 * Manufacturer: AC Delco
 * Part#: 19330122
 * MAF file for type: Corvette Z06
 * File units = 100 * gm / sec
 * Comments: Basic test data
 * Status:
 * Support: https://github.com/DeeEmm/DIY-Flow-Bench/wiki/MAF-Data-Files
 * Discussion: https://github.com/DeeEmm/DIY-Flow-Bench/discussions/51
 ***/
#ifndef MAFDATA
#define MAFDATA

//#ifdef ACDELCO_19330122

#include "../constants.h"

/***********************************************************
 * MAF Type
 *
 ***/

String mafSensorType = "ACDELCO_19330122";

/***********************************************************
 * MAF Output Type
 *
 * VOLTAGE
 * FREQUENCY
 ***/

int MAFoutputType = FREQUENCY;

/***********************************************************
 * MAF Units
 *
 * KG_H
 * MG_S
 ***/

int MAFdataUnit = MG_S;

/***********************************************************
 * Kay>Val MAF Data
 *
 ***/

 long mafLookupTable [][2] = {
		{1500,142},
		{1625,176},
		{1750,210},
		{1875,248},

                ... etc ...

		{11625,39951},
		{11750,41377},
		{11875,42845},
		{12000,44360}
	};
#endif
```

DeeEmm, 2023-02-01:
Codebase has changed substantially and as a result the code for frequency based MAFs is now broken.

Need to revisit this feature and get it working again.

The main issue that was encountered was the interrupt nature of operation clashing with the task based operation. This was the reason that this code was removed.

Need to find a better way of implementing frequency based support

DeeEmm, 2023-02-01:
I've pushed this out to the next release as I need to get the basic code finalised.

DeeEmm, 2023-02-02:
Just going to leave an idea here, whilst doing some work on the shield I had the idea that the frequency measurement should be moved out to hardware by using a frequency to voltage converter. This will eliminate the software interrupt issues whilst still catering for both types of MAF.

MAF data will need to be remapped from frequency to voltage, but this should be simple to do in excel. Software will see no differentiation between MAF types.

This needs some more investigation but it  could be as simple as utilising an external converter like [this one](http://www.icstation.com/frequency-voltage-converter-module-1khz-digital-analog-voltage-signal-conversion-module-p-12428.html) or integrating an IC directly into the shield.

The BOB above is limited to 1khz which I believe makes it unsuitable to read most MAFs which are IRO 0-3khz but there are likely other more suitable solutions out there.

DeeEmm, 2023-04-12:
Further to the above discussion of a hardware based frequency converter I stumbled across the following whilst looking for MAF Data...

https://www.thirdgen.org/forums/tpi/596907-cheap-frequency-voltage-converter.html

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

It's an old post but no reason it should not work..

> I found this going thru some of my old stuff. Its a circuit that uses an LM2917 freqency to voltage converter. I used this for a year or two before I converted over to a PCM that could read the MAF in directly. It works reasonably well for reading in the freqency based MAFs. Basically the circuit works as a charge pump that pumps charge into a capacitor that results in a voltage thats proportional to the frequency. The output is 0-5V for 0-12000 Hz input. The only special concerns with the circuit is that the 1000pf cap. and 55 kohm resistors need to be 5% or tighter tolerance wise. Its also recommended to use a mica capacitor for the 1000pf unit as they have very little variation with temperature. Also, make sure all electrolytic caps used in the circuit are rated for at least 35V, and proper polarity is observed.
>
>You'll need to assemble it yourself, but it shouldnt cost more than $15-20 dollars for the parts.

Thread 27 (2020-04-26):

Support for pressure drop benches

DeeEmm, 2020-04-26:
Add support for pressure drop style benches

Requested by Edvinas Juodviršis on FB

DeeEmm, 2021-07-27:
Created discussion #59

DeeEmm, 2024-09-21:
I'm bringing this forwards.

Officeial discussion - https://github.com/DeeEmm/DIY-Flow-Bench/discussions/173

DeeEmm, 2024-09-22:
Functional code published in build 24092301.

Please test and report back in support thread #173

Thanks.

/DM

DeeEmm, 2024-11-11:
Going to close this as working

Closed 2024-11-11.

Thread 28 (2020-07-29):

CFM Reads Zero on V1 Beta Release #9

930MAF, 2020-07-29:
Just loaded beta9 for some reason the CFM only reads zero the MAF voltage does change
 with airflow. I may be doing something wrong.
A clear and concise description of what the bug is.

**To Reproduce**
Steps to reproduce the behavior:
1. Go to '...'
2. Do this '....'
3. See error

**Expected behavior**
A clear and concise description of what you expected to happen.

**Arduino (please complete the following information):**
 - Firmware Version: [e.g. 1.0.20042001]
 - Hardware Type [e.g. Mega 2560]

**Additional context**
Add any other context about the problem here.

DeeEmm, 2020-07-29:
Check your configuration file to make sure that the pin assignments and configuration match that which you previously used. Some of the defaults may have changed now that the ilib BME280 library has been removed.

930MAF, 2020-07-29:
Using A0 the CFM stays at 0.00 but the MAF voltage changes from 0.00 to 4.00 volts when I use A1 the MAF voltage stays at 4.00 volts and CFM reads 0.00

This in the pin config in configuration.h

// Define Physical Pins

    #define VOLTAGE_PIN A0

    #define MAF_PIN A1

    #define REF_PRESSURE_PIN A2

    #define REF_VAC_PIN A3

   #define PITOT_PIN A4

    #define TEMPERATURE_PIN A5

    #define REF_BARO_PIN A6

    #define HUMIDITY_PIN A7

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

930MAF, 2020-07-30:
did some messing around and changed from this

//int numRows = sizeof(mafMapData)/sizeof(mafMapData[0]);

int numRows = sizeof(mafMapData[0])/sizeof(mafMapData[0][0]);

to this

int numRows = sizeof(mafMapData)/sizeof(mafMapData[0]);

//int numRows = sizeof(mafMapData[0])/sizeof(mafMapData[0][0]);

now it displays CFM

not sure if this dosen't cause other issues

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

DeeEmm, 2020-07-31:
Val, I'll have to do some testing to determine what I was doing there. It's basically setting the size of the array based on the number of data points in the mafData file. If it was previously not responding, and now you are getting valid figures then perhaps it is now correct.

It's been six months or so since I last looked at the code, It is possible I was half way through testing something that I failed to finish. (and have subsequently forgotten).

Keep me posted with your testing. When I have had a chance to do some testing myself I will report back here.

DeeEmm, 2020-07-31:
BTW. Anyone else seeing this same issue?

DeeEmm, 2020-07-31:
It is possible that this is related to bug #14 which also relates to mafData files. I note that this is still open and was last updated in December. I will do a review on mafData file importing and try to close both of these out. It's important to get this right as everything depends on it.

DeeEmm, 2020-07-31:
BTW @930MAF what MAF are you using?

930MAF, 2020-07-31:
5WK9605 and a 74-9505 For Ford MAF also I am going to use a 1K potentiometer as a voltage divider to check to see my MAF data is reading from low to high and increment properly.

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

DeeEmm, 2020-07-31:
Do you have data for the 74-9505 sensor? is this in volts / kg/h?

It might interest you to know that I've just added some data for a Ford Ford 1L3F-12B579-AB sensor in the forums. It is possible that this might be shared with your sensor? Might be worth a part number comparison / checkup.

https://diyflowbench.com/forum/mafdata/15-ford-1l3f-12b579-ab

This is in RAW analog data point format (1024 data points)

The data originated from the megasquirt site, so I assume it is accurate.

DeeEmm, 2020-07-31:
BTW, if you have MAF data, please share it in the MAF data forum - https://diyflowbench.com/forum/mafdata

930MAF, 2020-07-31:
Also another thing I notice if a use one of the included MAF samples such as DELPHI_AF10118.h the CFM increase up to.5 volts anything above .5v on the maf pin the CFM will decrease and becomes unstable. So I made a test maf data file all I did was add a zero to the MV column so the Left millivolts column start at100 and ends at 5000 the right KGH/1000 column starts at 100 and ends at 660000. This gives me 0 CFM to 324CFM to if I set the 5000mv much above 660000 KGH/1000   the CFM displays 326 and  then the CFM displays a negative number and starts counting back down. This just a test maf file has no calibration value. Just want if the CFM would increment smoothly for ov to 5v.

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

DeeEmm, 2020-07-31:
That's a good validation method.

So when you use test values in the MAF file that exceed 660000 the behaviour is that the CFM displays a negative number and starts counting back down?

This could indicate that we are overflowing a variable somewhere.

930MAF, 2020-07-31:
Yes that is what I am seeing.

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

DeeEmm, 2020-08-01:
So I've been testing and made some changes to the code that I'm pretty happy fix this issue.

There's a few changes, including a bit of a schoolboy error in the mafData files where instead of 0-5000mv (5v) I had the scaling at 0-500mv (0.5v) which had a bit of an obvious effect (oops).

In testing this all out I also added some additional debug commands to the serial API.

To see a realtime printout of the MAF voltage + kg/h value and calculated cfm value, just issue a 'D' command via the serial interface. To turn it off again, issue a 'd'. Full listing of the API functions are in the WIKI - https://github.com/DeeEmm/DIY-Flow-Bench/wiki/API

Let me know how you get on.

930MAF, 2020-08-02:
Nice!

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

DeeEmm, 2020-08-03:
If there's no objections I'm going to close this one out.

Closed 2020-08-03.

Thread 29 (2020-07-31):

MAF Data File configuration variables

DeeEmm, 2020-07-31:
**Describe the solution you'd like**

Additional variables in MAF Data files to be able to differentiate between different MAF Types

Discussion in forums - https://diyflowbench.com/forum/software/18-maf-data-file-standardisation#27

The inclusion of the following variables will allow differentiation between different sensor types when the data file is read in. It will also provide some amount of future-proofing as additional types can easily be added should it be required.

MAF Output Type
- Voltage
- Frequency

MAF Data Format
- Key / Value
- RAW Analog data

MAF Data Unit
- mg/s
- kg/h

DeeEmm, 2020-08-01:
Added in Build 20080201

Closed 2020-08-01.

Thread 31 (2020-08-03):

Drop support for BMP sensor in favour of BME sensor

DeeEmm, 2020-08-03:
**Is your feature request related to a problem? Please describe.**
No

**Describe the solution you'd like**
Drop support for BMP sensor in favour of BME sensor

**Describe alternatives you've considered**
None

**Additional context**
BMP sensor does not support humidity.
BME sensor is more appropriate choice for project

DeeEmm, 2020-08-04:
BMP support removed as part of issue #32

Closed 2020-08-04.

Thread 32 (2020-08-03):

LS2 MAF file is pushing memory over 8k limit

DeeEmm, 2020-08-03:
**Describe the bug**
Memory issue when using Analog MAF data

**To Reproduce**
Steps to reproduce the behavior:
1. Memory error when trying to upload program

**Expected behavior**
Program should upload

**Arduino (please complete the following information):**
 - Firmware Version: 1.0.20080307
 - Hardware Type:  Mega 2560

**Additional context**
Only happens when trying to compile for analog MAF sensor support.
Trying to compile for LS2 MAF

DeeEmm, 2020-08-03:
Flash / Program memory  256k bytes (of which 8k is used for the bootloader)
SRAM / Runtime memory  8k bytes
EEPROM 4k byte

LS2 MAF file is pushing memory over 8k limit.

Have reduced program size as much as possible without having a refactoring, but size is still too big.

Will look at using PROGMEM directive to push the MAF array into the program memory space

DeeEmm, 2020-08-03:
Using PROGMEM unnecessarily complicates the program.

Have managed to reduce MAF array size by changing from a 2D array to 1D. Program now loads. (yay)

This most likely also means that there will be an upper limit to key>data array size of approx 256.

DeeEmm, 2020-08-04:
Fixed in Build 20080401

Closed 2020-08-04.

Thread 33 (2020-08-03):

Humidity correction creating error in calculated result

DeeEmm, 2020-08-03:
**Describe the bug**
CFM reading high when baro + temp + RH correction enabled

**To Reproduce**
Steps to reproduce the behavior:
1. Enable baro + temp + RH correction

**Expected behavior**
Results not dissimilar to those recorded with ambient settings

**Arduino (please complete the following information):**
 - Firmware Version: 1.0.20080307
 - Hardware Type: Mega 2560

**Additional context**
BME280 sensor being used

DeeEmm, 2020-08-03:
Need to determine which is causing issue - Baro / temp / RH

DeeEmm, 2020-08-04:
Humidity correction is causing issue

DeeEmm, 2020-08-04:
Value read from sensor expressed as 36% but code required 0.36

Changed line 321 to -  relativeHumidity =  SparkFunBME280.readFloatHumidity() / 100;

Fixed in Build 20080401

Closed 2020-08-04.

Thread 34 (2020-08-04):

Update calibration file settings in WIKI

DeeEmm, 2020-08-04:
The calibration file settings need to be added to the configuration page in the WIKI.

Essentially the setting and a short explanation of what it does needs to be added for each setting.

For example...

***

### SELECT BOARD TYPE

_Uncomment / Comment board as required. (Default Board is Mega2560.)_
#define ARDUINO_MEGA_2560
//#define ARDUINO_UNO

***

### GENERAL SETTINGS

 _Minimum pressure that we consider the bench is 'operational' / 'running' / vac source is on_
#define MIN_BENCH_PRESSURE 0

_Flow rate in cfm below which bench is considered off_
#define MIN_FLOW_RATE 3          

_Number of scans over which to average output (helps stabilise results)_
#define CYCLIC_AVERAGE_BUFFER 5  

_Minimum voltage that we consider the bench is 'operational' / 'running' / vac source is on_
#define MIN_MAF_MILLIVOLTS 100

Closed 2020-08-04.

Thread 35 (2020-08-04):

Validation

DeeEmm, 2020-08-04:
- [x] Creation of calibration plates
- [ ] 3rd party calibration of test orifices
- [ ] Calibration of bench to test orifice
- [ ] Verification of correct flow rates for other test orifice sizes
- [ ] Results obtained from more than one system

DeeEmm, 2020-08-04:
Need to validate system operation on different benches

DeeEmm, 2021-07-19:
I have closed out the V1 project #54 as the new ESP32 development has now taken over where that left off.

Whilst this task was associated with the V1 project it still remains open as validation is still required.

I still need people to get on board with building and evaluating the DIYFB controllers.

My aim is now to package up the ESP32 boards along with the DIYFB Shield and offer them to the community for testing.

DeeEmm, 2023-02-01:
I've moved this to the V2 release as calibration orifices and a method for commonising test orifices. Originally the proposed method was to use a CD as this had a common and universal size that could easily be found worldwide. The issue found with this during testing was that the CD deformed under pressure which broke the seal to the bench receptacle. Whilst it was okay for lower test depression values, the issue became evident for higher test depressions.

I did make some orifice plates to a known dimension and calculate the flow rates, which was good for testing but this is not a great solution for everyone else.

The current best method is to use a saw blade as these are flat, made from steel and have a common universal bore size.

Further testing is required to determine what the flow rates are for the commonly available bore sizes

DeeEmm, 2024-11-04:
(moved comment from #76)

I want to open this up again and discuss some methods for flow validation so that we can agree on a set of universal tests.

Ultimately we need to establish the accuracy of DIYFB based systems. More specifically we need to establish the accuracy of sensor based systems running the DIYFB code. So rather than look at the system as a whole, we do need to look at each one as the sum-total of it's parts.

It is easy to do some bench to bench comparisons to compare what we all get flowing a common reference sample. But what we really need to do is record ALL sensor / data streams when doing so. This way we can compare not only the result, but how each individual bench has determined that measurement. It will give a better idea for the reasons for any differences in flow

Down the track, this methodology can also be used by new bench builders when setting up their benches to provide a kind of benchmark snapshot that can be analysed by the community. A bit like a hardware log file that can be used to help fix issues or validate builds.

We've been using the CD orifice tests for while now, and whilst these are super accessible, they fall over at higher depressions as they tend to warp and deform, leading to leaks. What I proposed a while back was to expand this test to include circular saw blades. These are also found in standard sizes (10 / 20 / 30mm) and also in imperial sizes (1/4, 1/2, 5/8").

So firstly we need to determine the flow values for these items. I did already purchase a bunch of blades and give them to a local fella to get them flowed, but despite following up several times I never received any results. I have access to another local bench, as well as potentially one stateside, so my next task is to populate a matrix of flow values.

I will update the code to generate an file that includes all of the necessary data. This way the file can be generated and then either posted here, or emailed to me so that the data can be analysed. I plan to keep all of the data in a spreadsheet or database so that we can keep track of the performance of the systems running the DIYFB code as well as undertake statistical analysis.

But. What I need is to determine a range of tests, or a testing regimen that can be carried out. Here's what I am thinking so far....

1 - RAW open test. This is with no flow calibration values or leak offsets. Just open system.
2 - RAW leak test. Same but with closed system
3 - RAW orifice test. Same with nominated test orifice (can be repeated for several different orifice sizes)
4 - Calibrated open test
5 - Calibrated leak test
6 - Calibrated orifice test(s). Calibrated system flowing nominated orifice(s)

Would be great to do this across 10/20/30mm orifice range and for range of depressions. Maybe 5 / 10 / 15"

Test 3 will be interesting as this will demonstrate the difference between the calibrated value and actual. In a perfect world
the MAF will correctly show the flow.

Test 6 should theoretically show no difference between the calibrated value and actual as it has been calibrated.

What other tests should we consider?? Please discuss!

DeeEmm, 2025-02-13:
Based on observation by @black-top, we are seeing some deviation between the results recorded by different MAF sensors in a side-by-side comparison - https://github.com/DeeEmm/DIY-Flow-Bench/discussions/141#

The reasons for this variation are at this point unknown. We have largely been taking the accuracy of the MAF data at face value, as focus has been elsewhere with the code development. But now that the code development is essentially finished for the current version, we no need to shift our attention to accuracy.

The fundamental basis for accuracy of the system is the accuracy of the MAF data used to decode the MAF signal. If we have bad MAF data, then the decoded flow value will be inaccurate. Whilst we have tested the system to compare the generated results against the results from the MAF data tables, we have not yet validated the MAF Data tables themselves.

So this is where we currently stand. We need to devise a way to be able to test the MAF data for any given MAF sensor to validate it. This only needs to be done once for each MAF sensor.

----------------------------------------------------

My thoughts copied from other thread - https://github.com/DeeEmm/DIY-Flow-Bench/discussions/141#

So we calibrate at a chosen data point. i.e. Ideally approx 80% of published MAF flow. If we calibrate at the higher end of the flow scale, any error should theoretically decrease as the flow reduces. If we calibrate at the lower end of the flow scale (for any given MAF) then any error could potentially increase as flow increases.

Next we test at various other data points along the scale - perhaps 10% increments. Maybe ideally at 5% increments

This means that we need multiple calibrated orifices, or a way to approximate them.

I did purchase this device some time ago...

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

It's a drafting device for drawing circles. A quick way to approximate different orifices.

We could calculate the idea sharp edged orifice diameter for any given flow and reference pressure and then set this device to that diameter. This would allow a quick and easy validation test but would obviously not be as accurate as a proper manufactured and calibrated orifice. But I would expect that it could get to within a few CFM of target. Enough to be able to validate the MAF to within a reasonable error.

----------------------------------------------------

With some care and accuracy, it would even be possible to map a MAF sensor across its entire range. This may actually generate more accurate results than using a generic MAF data table as the characteristics would be 'tuned' to the actual flow bench. i.e. the MAF data would be compensated for any losses or deviations arising from the design or integration of the MAF sensor.

This is definitely possible now that the method for converting flow data into 6th order polynomial data has been cracked. We could theoretically do this with just a handful of data points - much like the published Bosch MAF data.

Using this method ANY MAF sensor could be used, whether it had data or not...

- Install MAF
- Determine required flow value at predefined reference pressure
- Calculate ideal sharp edged orifice diameter
- Take voltage readings with orifice installed
- Repeat at various data points throughout MAFs published (or assumed) range
- Pump voltage + flow values into polynomial calculator to generate polynomials

DeeEmm, 2025-02-13:
Thinking further on this...

Lets say we adopt this as the preferred way to set up a new bench. We can provide an online calculator that allows the user to input the measured values and generate the polynomials. We can then save that data in a database. This way we can store multiple different snapshots of the same MAF, which will highlight differences between benches. It would also store a characterisation for each MAF of actual measured data, nit just published data.

It would also provide a quick lookup for anyone who wants to use a MAF - enter the MAF part number and it will show the polynomials / max flow / etc.

Of course this would depend on the accuracy of the orifuce used. So it would be good to do some tests to try and work out how accurate this could be

DeeEmm, 2025-02-13:
(Some food for thought)

black-top, 2025-02-13:
My system is made with 100mm diameter pipe, and MAF adapters are bellmouth velocity stack shape that gradually match MAF housing size. For 067 MAF I can make a 100mm housing to match the pipe, but 5wk MAF are one piece design, so I can't remove the flow element from it, so the size is fixed for it and a lot of MAFS are like that.
Yes, I agree that it is a single observation, and we can not draw conclusions from it, because the actual cause is not entirely clear, but I still think that using % error correction, to match as close as possible lets say 3 or 4 orifice flow, is far better than subtracting offset from single orifice flow. Even if the results are not match 100% on all orifices, it is still more accurate than match 100% at only one point.
The option to generate polynomials from measured points looks like the best solution so far, because it eliminates variables. But we get additional problems like orifice sets. That variable "orifice" looks like an interesting solution, but it might be flexing different amounts depending on diameter, etc. Maybe the better solution will be a single metal plate with multiple holes, similar to D.W. calibration plate shown in his book. The main problem with D.W. plate is that all orifices have different angles. If we decide optimal 6 or 8 hole diameters (all need to fit to a single plate) and we do it with the same angle, say 45°, I think it will be possible to order a batch of these plates at a reasonable price. Laser cut will be the cheapest option, but holes are not perfect, and the chamfer needs to be machined afterward, so maybe CNC milling from lets say 2 or 3mm mild steel plate will be optimal.

black-top, 2025-02-13:
And BTW, capturing all available data at the same time for data validation is great to have, because writing down all data by hand while switching between flow variables, adjusting the pressure and etc, increases the risk of the error. There are quite a lot of steps to do for each measurement, especially if switching between different mafs or comparing data with cylinder head measurements, not just with orifice plates.

black-top, 2025-02-13:
Ok, I understand what You are saying. In that case, offset calibration is correct, but we should adjust the curve to match flow with different size orifices or generate a new curve from scratch.

DeeEmm, 2025-02-13:
Yes. I think that if we use a method like the one I outlined, then we can match the curve to the bench. The question is whether this method will give accurate results.

it is obviously bette with a range of calibrated orifices, but I do not think that this is achievable for the average user.

It should also follow that the MAF sensor should give the same results for every bench without the curve needing to be adjusted, just the initial offset calibration. This is also something that we need to validate.

black-top, 2025-02-16:
I did some more testing today. My flow bench pipe is 100mm id and I use original MAFs housings, and I made adapters with gradually changing diameters to match MAF housings, but as You have mentioned that housing diameter might be the problem, I did a simple experiment.  I set flow bench at 28" pressure with a 100cfm orifice and just kept reducing the MAF housing diameter setting until flow was matching 100CFM.  After that, I tested CD at 10" at pressure.
Results are with reduced maf size diameter to match 100cfm orifice, the CD flow also match expected flow in 1-2CFM range.
So the MAF curve is matching with these settings.
 I did same test with two MAF mounted one after the other (067 and 5WK), with two mafs the correct 067 readings was at 70mm diameter setting (close to 72mm 5wk diameter) and did same test with only 067 maf in the system, at this time I get correct readings with 80mm housing diameter even if original housing is 82mm and the pipe is 100mm.
In all tests, the calibration flow offset was set to 0.

Thread 36 (2020-08-04):

MPX4250 Ref Pressure Scaling error

930MAF, 2020-08-04:
When using the MPX4250 for pressure ref pin A2 i am seeing -43 at zero volts and 1044 at 4.8 volts.

**Arduino (please complete the following information):**
 - Firmware Version: Release V1 Beta Release #13 · Build 20080401
 - Hardware Type  Mega 2560 DFROBOT display

DeeEmm, 2020-08-07:
refPressureKpa = (((refPressMillivolts / supplyMillivolts ) - 0.04) / 0.00369) - getBaroPressure(KPA);

DeeEmm, 2020-08-07:
Added some additional code for dealing with the barometric offset in Build 20080704

DeeEmm, 2020-08-09:
No further response so I'm going to mark this as closed.

Closed 2020-08-09.

Thread 37 (2020-08-04):

BME280 Sensor fault causes blank display.

930MAF, 2020-08-04:
If  a BME 280 is selected in the config.h for Baro, Temp or humidity sensor it will not boot up the display, it will stay blank.  but if you fire up the serial monitor it will return The sensor did not respond. Please check wiring.
Using SPARKFUN_BME280

**Arduino (please complete the following information):**
Firmware Version: Release V1 Beta Release #13 · Build 20080401
Hardware Type Mega 2560 DFROBOT display

**Additional context**
Add any other context about the problem here.

DeeEmm, 2020-08-05:
I think that this is a conflict with I2C addresses between the display and BME unit. (they both default to 0x77)

On the BME unit I have, there are some solder pads on the underside that need to be changed to change the address. There are three pads at the opposite end of the hole marked 'ADR'

https://cdn.sparkfun.com/r/600-600/assets/learn_tutorials/4/1/9/bottomside.png

The trace to the left pad (Pad 'I') needs to be cut
The trace to the left pad (Pad 'O') needs to be soldered

I'm changing the code at the moment but have some compilation errors I'm working through.

DeeEmm, 2020-08-06:
I'm still seeing the issue after resolving the compilation errors. I think it may be a conflict between the Sparkfun and TCmenu libraries. I'm going to reach out to the TCmenu dev and see if he has any ideas.

DeeEmm, 2020-08-06:
Okay, after a bit of digging I've found the reason for the issue. On line 138 there is a freeze statement

`while(1); //Freeze`

This was in the original BME280 example. It's not a very good way of error handling as it just locks up the system.

I've commented it out for now but need to work out why the BME is failing to initiate.

DeeEmm, 2020-08-06:
Fixed in Build 20080603

DeeEmm, 2020-08-07:
Going to mark this as closed.

Closed 2020-08-07.

Thread 38 (2020-08-06):

Version and build not displaying on lcd screen

DeeEmm, 2020-08-06:
**Describe the bug**
Version and build not displaying on lcd screen

**To Reproduce**
View version / build menu items

**Expected behaviour**
version / build to be show.

**Arduino (please complete the following information):**
 Build 20080602

**Additional context**
Might be a variable type / variable typecasting issue

DeeEmm, 2020-08-06:
Fixed in Build 20080603

Closed 2020-08-06.

Thread 39 (2020-08-06):

Flow value fractional part displaying zero

DeeEmm, 2020-08-06:
**Describe the bug**
Flow value fractional part displaying zero on LCD screen

**Expected behavior**
flow value displayed to 1 or 2 decimal points

**Arduino (please complete the following information):**
 - Firmware Version: Builld 20080603
 - Hardware Type: Mega 2560

DeeEmm, 2020-08-06:
Changed datatype long to double

DeeEmm, 2020-08-06:
Fixed in build 20080604

Closed 2020-08-06.

Thread 40 (2020-08-06):

Adjusted flow value displays zero

DeeEmm, 2020-08-06:
**Describe the bug**
Adjusted flow value displays zero

**To Reproduce**
View AFlow value on LCD

**Expected behaviour**
AFlow value displays scaled version of actual flow based on ref pressure.

**Arduino (please complete the following information):**
 - Firmware Version: Build 20080603
 - Hardware Type Mega 2560

**Additional context**
Add any other context about the problem here.
It's not working, but not really sure it's needed on a MAF style bench

DeeEmm, 2020-08-06:
Changed long ints to doubles

Fixed in Build 20080604

Closed 2020-08-06.

Thread 41 (2020-08-06):

Pitot bar graph display

DeeEmm, 2020-08-06:
Display pitot differential (Percentage) as a bar graph on the LCD display or alternatively external LED bar graph

This would give quick visual indication of high / low flow areas without having to view numbers on the screen.

KirikauKiwi, 2024-11-25:
This would be useful, also this would be a good way to display the changing P_total for the non-pitot probing of the port, i.e. the single port probe as discussed in #249

Thread 42 (2020-08-06):

Flow conversion generating large differences

DeeEmm, 2020-08-06:
**Describe the bug**
Issue described in bug #21 where converted flow figures seem to be abnormally different fro original value.

**To Reproduce**
Flow values converted by the convertMafFlowInWg() function appear to be large / different
eg 100cfm@4" = 158cfm@10"

**Expected behaviour**
Unsure. More info needed

**Arduino (please complete the following information):**
 - Firmware Version: Build 20080604
 - Hardware Type: Mega 2560

**Additional context**
The large difference in values may be normal. Need to validate whether results are okay.

DeeEmm, 2020-08-07:
Validated code (found source of original code).

Looks to be normal.

Have added additional comments to function

Closed 2020-08-07.

Thread 46 (2020-08-15):

Validate mass > volumetric flow calc

DeeEmm, 2020-08-15:
**Describe the bug**
Reference pressure not included in mass > cfm calcs

Mass flow value is ABSOLUTE (unaffected by environment).  Does reference pressure affect the calculation from Mass flow to Volumetric flow?

**Expected behavior**
CFM should be accurately calculated from Mass flow value for ALL test environments

**Additional context**
Currently only barometric pressure is taken into account in conversion. I suspect that reference pressure also needs to be factored into algorithm.

**Example**

 - 28"/wg is approximately equivalent to 1.01psi.
 - Current conversion in undertaken at atmospheric pressure with baro correction for environment (nom 14.7 psi).
 - Therefore at 28" reference pressure the reference pressure is effectively (14.7-1.01)=13.06psi.
 - This offset provides a deviation of some 20cfm at a nominal flow value of 150cfm.

**Need to validate results.**

Either:
 - Conversion is calculated at nominal barometric pressure and then result is offset for environment (baro + ref pressure)
 - Both baro and reference pressure offset are factored into conversion

DeeEmm, 2020-08-16:
The calculation from mass flow into volumetric flow is made using the formula found here - https://www.pdblowers.com/tech-talk/volume-and-mass-flow-calculations-for-gases/

The formula is based on the ideal gas law and states pressure simply as 'gas pressure'. I believe that this is generally regarded as static (barometric) pressure however in our use case we should really adjust this value as the pressure at the MAF will be slightly lower than the ambient barometric pressure due to the restriction caused by the test object.

I have modified the convertMassFlowToVolumetric function to take the reference pressure into account in the conversion.

` mafFlowCFM = ((massFlowLbm * 1545 * tempInRankine) / (molecularWeight * 144 * gasPressure)); `

I think validation of this should be considered as part of the RC testing

DeeEmm, 2020-08-16:
Change committed in Build 20081601

Closed 2020-08-16.

Thread 60 (2021-07-29):

Support for digital gauges

DeeEmm, 2021-07-29:
Add support for standard digital gauge protocol to be able to record valve lift as suggested by Edvinas Juodviršis.

- Support standard serial gauge protocol.
- Lift value recorded and stored with flow data
- Lift value displayed on dashboard

DeeEmm, 2021-07-29:
Some information on serial gauge protocol - https://sites.google.com/site/marthalprojects/home/arduino/arduino-reads-digital-caliper

DeeEmm, 2021-07-29:
Additional Gauge protocol information

https://hackaday.io/project/511-digital-dial-indicator-cnc-surface-probe

https://forum.arduino.cc/t/garant-digital-dial-indicator-encoder-digimatic-rs232-without-data-cable/543582

DeeEmm, 2021-09-22:
Received ebay el-cheapo digital dial indicator that has serial data capabilities.

Not planning to take a look at this just yet as I need to finalise the shield design and testing but it's here and ready to go when I do.

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

baker27, 2021-09-23:
Do you need code for reading the dial indicator?

DeeEmm, 2021-09-23:
If you have some or want to write some, that'd be great.

I was going to adapt the examples above

KirikauKiwi, 2024-11-13:
@DeeEmm do you have the [serial cable](https://vi.aliexpress.com/item/1005006288776709.html) to plug in to your digital dial indicator?

It also looks like there are [USB versions](https://vi.aliexpress.com/item/1005002989551967.html) of the DDI too, the port on the DDI is USB and not a proprietary style like on the serial version.

I wonder if the data output is the same for the DDI's measuring 0.01mm and 0.001mm as the USB version has a 0.01 or 0.001 selector switch on the box in the middle of the USB cable.

DeeEmm, 2024-11-13:
I don't recall. I suspect not. I seem to recall that I found the pin outs and intended to solder direct. But that looks like a bargain and worth it for the cable alone.

The USB version looks like it's using a UART Serial converter.

IIRC the intent was to use Serial 2 to connect the gauge, so the first style is more appropriate.

Gauge[Serial] -> ESP32[serial 2]

The USB version would need to be converted back to straight serial to connect to serial 2 so you would need to add a USB host controller into the pipe...

Gauge[Serial] -> UART Slave -> UART Master -> ESP32[serial 2]

DeeEmm, 2024-11-13:
> I wonder if the data output is the same for the DDI's measuring 0.01mm and 0.001mm as the USB version has a 0.01 or 0.001 selector switch on the box in the middle of the USB cable.

Not sure. I seem to recall that they follow a common standard, so suspect that they output would be the same. This is definitely true if they are using a UART as they are simply converting the data stream

DeeEmm, 2024-11-13:
Bought a couple for 'research' purposes :laughing:

stefan63, 2024-11-17:
Me thinking loud again.........
If we are using 1.8 deg (200 steps/rev) stepper motors driving a lead screw with 2mm pitch will gwt us (1 mm) / 800 =
0,00125 mm  / revolution. Knowing this will make the messurement with a digital gauge unnecessary!
https://www.circuitist.com/how-to-calculate-steps-per-mm-lead-screw-and-gt2-timing-belt/

DeeEmm, 2024-11-17:
> Me thinking loud again......... If we are using 1.8 deg (200 steps/rev) stepper motors driving a lead screw with 2mm pitch will get us (1 mm) / 800 = 0,00125 mm movement/step. Knowing this will make the messurement with a digital gauge unnecessary! https://www.circuitist.com/how-to-calculate-steps-per-mm-lead-screw-and-gt2-timing-belt/

Indeed. This is the exact idea. Also with automated valve adjustment and automated flow control it will be possible to map the entire valve lift range automatically.

stefan63, 2024-11-17:
Maybe one of those could work, almost plug&play!
https://www.aliexpress.com/item/1005007160376705.html?

stefan63, 2024-11-17:
There is also .9 degree steppers available ;)

Den sön 17 nov. 2024 22:29Mick Percy ***@***.***> skrev:

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

Thread 61 (2021-08-05):

OTA Update

DeeEmm, 2021-08-05:
Add support for OTA firmware update.

Using SPIFFS / ESP partitioning it is possible to perform an 'over the air' firmware update allowing users to update firmware via the web GUI.

This massively simplifies the process of installing firmware updates making this more accessible to the end users.

OTA does however require some amount of free partition space, which will impact storage capacity for datalog files.

One solution is to add support for and SD card and move all datalog storage there.

DeeEmm, 2021-08-05:
Added request for SD card support #62

stefan63, 2024-10-29:
OTA   Github => ESP32
https://medium.com/@adityabangde/esp32-firmware-updates-from-github-a-simple-ota-solution-173a95f4a97b

Best regards/Stefan

DeeEmm, 2024-10-29:
Thanks Stefan.

I am trailing the  ESPAsyncWebServer version as this is the Webserver library that we use. Although I did take a look at a few others.

One caveat that I did not know is that once the ESP has been updated Over-The-Air, it will no longer update using serial, which I think is a bit of a barrier at this point in time. This is related to the way that the partition schema works.  Essentially the OTA update is alternately stored on the OTA1 and OTA2 partitions. Whereas the USB update is stored to the Main partition which is only a fallback in case OTA1/2 are corrupted or cleared.

For OTA to work successfully the update process needs to solely use OTA. This is not an issue per-se, but does require commitment that once the switch is made it will define how all future updates are managed.

What I am currently working on is to extend the current file upload functionality so that the user can manually upload the firmware binary via the GUI. This means that we can package up the Binary and index.html files into each Github release so that the update path for anyone with a working installation is simply a case of uploading the firmware.bin and index.html files via the browser. No need to crack out a computer compile and connect it up to the flow bench.

Ultimately we could extend this to use the full  OTA functionality, in which case the update process would fetch the files from a remotely hosted server triggered by an update function in the GUI. This then negates the need for users to download anything and allow them to check to see if there is an update available from the UI.

But I think for the time being a simplified disconnected update using the DIYB GUI is a good compromise.

stefan63, 2024-10-29:
I agree and ESP32 download tool is already available an quite easy to use.
https://www.aeq-web.com/esp32-flash-tool-exported-program-upload-bin-hex-file/?lang=en

DeeEmm, 2024-10-29:
The binary created by VSCode compiler is available within the project tree at .pio/build/release/firmware.bin

I've merged commits from the OTA branch as the GUI firmware update is now working. #185

For time being I will close this out as complete but may revisit it if we decide to implement OTA proper

Closed 2024-10-29.

Thread 63 (2021-08-05):

Review ESPduino I/O

DeeEmm, 2021-08-05:
With reference to Issue #62 SD Card Support, we need to review available / spare I/O on the current ESPduino board to determine whether it has enough I/O to support all planned features. These include:

Support for Pitot / Orifice benches
Support for Fan bank control
Support for VFD Fan speed control
Support for SD Cards
Support for external measuring devices
Support for Stepper valve opener

It is possible to provide SD or additional I/O support via I2C which may negate the need for additional I/O, however this introduces additional componentry which may simply be negated by moving to a different ESP processor / breakout board.

This task therefore should aim to:

- Capture & tally all current and future planned I/O requirements, preferably allowing spare capacity for future expansion.
- Compare I/O requirements with ESPduino I/O availability
- Compare I/O requirements with other ESP32 processors / breakout boards
- Make an informed choice for processor selection

### Best case
- All features supported
- 25% spare I/O capacity

### Marginal case
- All features supported
-  no spare capacity

### Worse case
- insufficient I/O

Potential solutions...

- Prioritise Features
- Reuse I/O (no need for simultaneous MAF and Orifice support)
- Use I2C devices (Pressure / baro / I/O etc)
- Employ expansion boards

At this stage I am confident that all features can be supported on the same shield, however processor choice and control methodology may need to change.

DeeEmm, 2021-08-05:
I will finalise this before Merging the ESP32 code.

DeeEmm, 2021-08-17:
This is what I currently have assigned. We either have no spare or 3 spare depending on whether the BME280 is used to handle temp, baro & relh...

```
/***********************************************************
* ESP32 / ESP32DUINO
*
* NOTE: the ESPDuino has 18 available I/O pins
* On the Wemos D1R32 board there are also 3 additional I/O pins not on the header - 15/32/33
*
* Available GPIO Pins = 2/4/35/34/36/39 | 18/19/23/5/13/12 | 14/27/16/17/25/26
* 1/3/21/22 reserved for Serial / I2C Additionally 16/17 reserved for external gauge data connection
***/
#ifdef ESP32DUINO

    #define BOARD_TYPE              "ESP32DUINO"

    // Define Physical Pins

    // VAC CONTROL
    #define VAC_SPEED_PIN           14                      // DAC speed reference for VFD
    #define VAC_BLEED_VALVE_PIN     27                      // DAC bleed valve control

    #define VAC_BANK_1              5                       // vac motor(s) on/off
    #define VAC_BANK_2              13                      // Provision for staged Vac motor control
    #define VAC_BANK_3              12                      // Provision for staged Vac motor control

    //STEPPER MOTOR CONTROLLER
    #define AVO_ENBL                18             
    #define AVO_STEP                19
    #define AVO_DIR                 23

    #define VOLTAGE_PIN             0

    // SENSORS
    #define SPEED_SENSOR_PIN        25                       // turbine speed for turbo flow bench

    #define MAF_PIN                 2
    #define REF_PRESSURE_PIN        4
    #define DIFF_PRESSURE_PIN       35
    #define PITOT_PIN               34

    #define TEMPERATURE_PIN         26                      // NOTE: these become spare if BME280 used
    #define REF_BARO_PIN            36                      // NOTE: these become spare if BME280 used
    #define HUMIDITY_PIN            39                      // NOTE: these become spare if BME280 used

    // COMMS

    #define SERIAL0_TX              1                       // API
    #define SERIAL0_RX              3                       // API
    #define SERIAL2_TX              16                      // GAUGE PROTOCOL
    #define SERIAL2_TX              17                      // GAUGE PROTOCOL
    #define SCA_PIN                 21                      // BME280 etc
    #define SCL_PIN                 22                      // BME280 etc

    // Wemos D1R32 also has additional spare I/O points broken out on the board but not in the header (defined below)
    // Preference is NOT to use these in the core code as it ties the project to this specific board (other boards do not have these)
    // These are included here for for users making a custom shield that need additional I/O

    #define SPARE_PIN_1     15
    #define SPARE_PIN_2     32
    #define SPARE_PIN_3     33

#endif
```

This pin mapping also includes pins for the following future features:

- Staged vac motor handling
- VFD control
- External gauge serial protocol
- Orifice and pitot style benches
- Stepper controlled valve opener
- Turbo speed sensor

I have not included SD card support. It seems pointless utilising an SD card when we can easily access data files via the GUI.

With the Wemos D1R32 board there are also 3 additional I/O available on the board but not broken out to the headers. So there is some spare capacity should users want to hack the shield to do other stuff. (6 spare in total if I2C used for the BME280)

So I think that the ESPduino is still a good option for the standard project board and has some spare availability to accommodate other stuff down the track.

I have considered moving from the ESPduino to a smaller footprint to save some space but ultimately I do not see the value as the shield still needs space to include pressure sensors, stepper drivers, PSU, etc. These really determine the physical size. Additionally once mounted inside a case with the relevant external ports and connectors broken out to be able to hook it up, making a compact sized board really has little value.

Closed 2021-08-17.

Thread 66 (2021-08-05):

ESP32 Data Logging

DeeEmm, 2021-08-05:
ESP32 Web UI
- [x] Log to SPIFFS
- [x] Display from SPIFFS
- [x] Datalog Metrics file (lift reference)
- [ ] ~~SD card integration~~
- [ ] Serial communication
- [x] Data export (Save to disc)
- [ ] Automation (auto stepper for valve lift)

DeeEmm, 2021-08-25:
I've moved this out of the ESP32 port with the aim of releasing the ESP32 port sooner

DeeEmm, 2023-05-10:
I'm going to call this one done for the time being. Most of the functionality has been integrated into V2 with the exception of SD card support and Automation, which are both captured under separate tasks

DeeEmm, 2024-10-29:
Re-opening based on improving data logging functionality for V3 - Forum discussion #184

Need to split out some of these features into individual tasks - specifically automation (Poss V4 feature)

Data logging improvements relate to data captured and how it is presented / managed

Thread 68 (2021-08-05):

Device Status (ESP32)

DeeEmm, 2021-08-05:
- [x] IP Address
- [x] Memory Usage
- [x] ~~Uptime~~
- [x] Maf Sensor Info
- [x] Pressure sensors Info
- [x] Baro sensor Info
- [x] RH Sensor Info
- [x] Temp sensor Info

DeeEmm, 2021-08-05:
Already Completed

Closed 2021-08-05.

Thread 69 (2021-08-05):

ESP32 Web UI

DeeEmm, 2021-08-05:
- [x] Basic Web Page
- [x] Update data via web sockets
~~Process user actions (Calibrate etc)~~
- [x] Configuration settings dialog
- [x] Add API hooks
- [x] Status Messages
- [x] Auto refresh

DeeEmm, 2021-08-06:
Auto refresh / data streaming added.

Data is streamed via websocket to browser.

Datastream can be started / stopped with on/off buttons on main page.

We can also tie additional relay outputs to these buttons to control fans

DeeEmm, 2021-08-07:
Calibration moved into dedicated task #75

Closed 2021-08-07.

Thread 70 (2021-08-05):

ESP32 Server Initialisation

DeeEmm, 2021-08-05:
- [x] WiFi AP Mode
- [x] Filesystem report
- [x] IP and Multicast DNS name report
- [x] Initialise SPIFFS content (check if exists)
- [x] Serve default AP webpage to client
- [x] Create Byte array for initial vanilla web page
- [x] Create minified monolithic file (html.index.gzip) in data folder
- [x] Move separate html+js+css files into SRC folder

DeeEmm, 2021-08-07:
Need to combine server file data into one file to be able to easily upload to server on initial boot.

(Minified + monolithic HTML + Javascript + CSS)

Initial AP style GUI consists of file upload dialog

- User boots device
- User connect direct to device using AP mode (http://diyfb.local)
- Default AP web page consists simply of file upload dialog
- User uploads index.html.gzip monolithic webpage
- Default AP web page is replaced by index.html.gzip webpage
- User can now update wifi details and save them which creates new config file
- User reboots device which connects to local WiFi

System is now ready and operational

- User only needs to update one file which is provided as part of download in data folder (NOTE: need to move html/js/css to SRC folder)
- Generally a byte array is used for creating the web page, however a byte array is larger than the data it stores as it includes the hex prefix. Minified will most likely be smaller.

DeeEmm, 2021-08-19:
- Server on initial connection will detect if index.html file is present and ask user to upload it if not.
- Monolithic index.html file created and working so user only has to upload single index.html file which contains css + js + html
- only remaining part is to pre-load the configuration and calibration values from memory to allow the user to create the configuration.json and calibration.json files

Closed 2021-08-19.

Thread 71 (2021-08-05):

ESP32 Server Functions

DeeEmm, 2021-08-05:
~~Realtime Clock~~
~~Uptime~~
- [x] File download (SPIFFS)
- [x] File upload (SPIFFS)
- [x] File delete (SPIFFS)

DeeEmm, 2021-08-05:
File download cannot be achieved by websockets which would have been my preference to keep all data handling in one place

Generally we can only serve a file in response to a download request from the browser which means that we cannot 'push' the file to the client via web sockets. This is a security measure to prevent malicious use. However, HTML5 does allow us to do this (see link below), but it requires browser side code which is not compatible for all browsers (yes IE we are talking about you)

So currently we will handle the file download within the server request handlers in the setup function as this does not require additional browser-side code

https://blog.logrocket.com/programmatic-file-downloads-in-the-browser-9a5186298d5c/

DeeEmm, 2021-08-05:
File Delete function completed.

DeeEmm, 2021-08-06:
File upload function completed

Closed 2021-08-06.

Thread 72 (2021-08-05):

ESP32 Configuration Settings

DeeEmm, 2021-08-05:
- [x] Wifi SSID / Password / AP Name
- [x] DNS / Hostname
~~OTA Update (SPIFFS)~~
- [ ] Calibration
~~MAF Sensor Selection (SPIFFS)~~
- [x] Data refresh rate

DeeEmm, 2021-08-07:
Moved calibration update task to dedicated task #75

Closed 2021-08-07.

Thread 74 (2021-08-06):

Hardware abstraction

DeeEmm, 2021-08-06:
At the moment the hardware layer is integrated into the core. Very specifically there is a bunch of library related code that resides within core.ino. This is a bit of an artifact from when the project was just a single file and whilst I have been slowly working towards functional code segregation it needs more work.

I've been addressing some of this as I've been working through the ESP32 port, but there's lots more to do. Ideally the hardware / sensor related processing should be split out into its own file, or even better it's own class / library. This then allows us to separate the core functionality into distinct and easy to understand sections and will provide an abstraction layer between the sensors and the core code. Ultimately this then allows easier adaptation for different hardware configurations and also leaves the core (i.e. maths) functions a lot cleaner with no sensor or hardware related code in there. Where the core code needs to pull in sensor data, it can be done through the class instance.

I have made a start on writing a sensor class which will achieve this. This may eventually expand into a complete hardware class and also incorporate the outputs as well, but at the moment I'm just including the sensor inputs.

This is a fairly large (and breaking) change, but one I feel should be done before V2, so I'm adding it to the ESP Port project.

As it stands there are some issues with the existing sensor libraries and so rather than waste time trying to fix them, it makes more sense to me to write a HAL and deal with them properly.

I'll push my current changes to the ESP32 branch and create a new branch for the HAL stuff.

/DM

DeeEmm, 2021-08-13:
Addressed in build 21081301 with refactor of code to object based class::method structure

Closed 2021-08-13.

Thread 75 (2021-08-07):

Update calibration data handling

DeeEmm, 2021-08-07:
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

The calibration handling ~~ideally~~ needs to be rewritten ~~or at a minimum reconsidered~~

We current display the calibration offset value in the browser within the config settings which is just a visual representation of the config.json file. The calibration offset is not user-editable and can only be updated by performing a calibration.

Currently to update the calibration data we...

- Invoke the calibration from the browser
- Calculate the offset taking into account the reference orifice flow data (stored in the calibration settings)
- Then we push the new offset value to the browser
- Update the calibration form values
- Next we invoke the browser to 'save' the config form back to the ESP32 (as per a normal config update).

This avoids writing an extra calibration function within the ESP32 code as we reuse existing code and communication protocols but we are playing message pingpong and it's not really an elegant way of doing things. It's ended up this way as I have built on the pre-existing calibration functions, and now that we have added another communications layer with websockets trying to avoid code replication has ended up making things a bit too trickety-complicado.

Just to throw some additional complexity into the mix, we can also invoke a calibration from the API which means that if there is not an active websocket connection to a browser we cannot save the calibration data.

So we need to update the calibration handling

### Some considerations

- SPIFFS memory is at a premium and so keeping the codebase small is preferable.
- We should consider that we do not really want to end up with feature bloat with yet another page / modal dialog / form etc. just to display and manage the calibration values.
- With consideration however, this could be a more elegant solution overall.
- We still have to add leak test calibration data
- We should consider future requirements.
- Do we segregate calibration data from configuration data?

### Constraints

- Calibration along with calibration data storage handling should be done entirely server-side
- We can push the updated values to the browser / API as a response to update browser / API clients
- Calibration data should be non-editable
- Need to include leak test data
- Need to accommodate additional future data

DeeEmm, 2021-08-14:
Calibration workflow:

### Leak Test

leak test is automatic.
- user blocks bench off
- ref pressure is basically maxed out with no flow detected
- If ref pressure (vac) is above a threshold (in config file) then we must be in leak test mode
- if reference pressure is within LEAK_TEST_TOLERANCE of REF_PRESS then we turn ref pressure gauge green + display message
- if ref pressure is not within  LEAK_TEST_TOLERANCE of REF_PRESS then we turn ref pressure gauge red + display message
- Colours changed by document.getElementById("MyElement").className = "MyClass";
- this will also work with test piece on and valve closed - so at start of test user should see a green 'go' light when the valve is closed

### Flow Calibration

- User blocks bench off with calibration orifice
- User enters flow and ref pressure values for orifice
- User records calibration
- All future values use this value to offset flow figures.

https://github.com/DeeEmm/DIY-Flow-Bench/wiki/Calibration

DeeEmm, 2021-08-19:
Also need to pre-load calibration data on initial server creation

DeeEmm, 2021-08-19:
Build 21081902 Automatically creates both calibration and configuration json files if not present.

Closed 2021-08-20.

Thread 76 (2021-08-19):

Sensor Unit Tests

DeeEmm, 2021-08-19:
Check all sensor streams and code operate as expected. Many changes have happened in the code refactoring and so unit testing for each sensor needs to be carried out.

- [x] MAF Sensor
- [x] Reference Pressure
- [x] Temperature
- [x] Baro Pressure
- [x] Relative Humidity
- [x] Pitot Pressure
- [x] Differential Pressure

DeeEmm, 2021-09-22:
BME280 code tested / updated and working. Just need to validate humidity.

Reference pressure code inc ADS1015 ADC tested and working. Should be same for other devices using the ADC but will validate those separately.

DeeEmm, 2023-02-15:
All sensors validated in bench tests but further real world testing required.

DeeEmm, 2024-11-02:
I want to open this up again and discuss some methods for flow validation so that we can agree on a set of universal tests.

Ultimately we need to establish the accuracy of DIYFB based systems. More specifically we need to establish the accuracy of sensor based systems running the DIYFB code. So rather than look at the system as a whole, we do need to look at each one as the sum-total of it's parts.

It is easy to do some bench to bench comparisons to compare what we all get flowing a common reference sample. But what we really need to do is record ALL sensor / data streams when doing so. This way we can compare not only the result, but how each individual bench has determined that measurement. It will give a better idea for the reasons for any differences in flow

Down the track, this methodology can also be used by new bench builders when setting up their benches to provide a kind of benchmark snapshot that can be analysed by the community. A bit like a hardware log file that can be used to help fix issues or validate builds.

We've been using the CD orifice tests for while now, and whilst these are super accessible, they fall over at higher depressions as they tend to warp and deform, leading to leaks. What I proposed a while back was to expand this test to include circular saw blades. These are also found in standard sizes (10 / 20 / 30mm) and also in imperial sizes (1/4, 1/2, 5/8").

So firstly we need to determine the flow values for these items. I did already purchase a bunch of blades and give them to a local fella to get them flowed, but despite following up several times I never received any results. I have access to another local bench, as well as potentially one stateside, so my next task is to populate a matrix of flow values.

I will update the code to generate an file that includes all of the necessary data. This way the file can be generated and then either posted here, or emailed to me so that the data can be analysed. I plan to keep all of the data in a spreadsheet or database so that we can keep track of the performance of the systems running the DIYFB code as well as undertake statistical analysis.

But. What I need is to determine a range of tests, or a testing regimen that can be carried out. Here's what I am thinking so far....

1 - RAW open test. This is with no flow calibration values or leak offsets. Just open system.
2 - RAW leak test. Same but with closed system
3 - RAW orifice test. Same with nominated test orifice (can be repeated for several different orifice sizes)
4 - Calibrated open test
5 - Calibrated leak test
6 - Calibrated orifice test(s). Calibrated system flowing nominated orifice(s)

Would be great to do this across 10/20/30mm orifice range and for range of depressions. Maybe 5 / 10 / 15"

Test 3 will be interesting as this will demonstrate the difference between the calibrated value and actual. In a perfect world
the MAF will correctly show the flow.

Test 6 should theoretically show no difference between the calibrated value and actual as it has been calibrated.

What other tests should we consider?? Please discuss!

DeeEmm, 2024-11-04:
I've moved discussion to #35 and going to close this out.

Closed 2024-11-04.

Thread 77 (2021-08-19):

Review error / status messages

DeeEmm, 2021-08-19:
Need to tidy up error and status message handling

DeeEmm, 2021-08-20:
Removed status message reporting from API - API now only returns status via Serial link. It made no sense to have API triggering messages on the Web-UI.

Added a 'boot message'. This is the default value used for the System Status Message and will be visible in the WebUI on initial power-up. This both initialises the Message field and gives users something to tweak. BOOT_MESSAGE is defined within the configuration header file (configuration.h)

DeeEmm, 2021-08-21:
Need to detect size of mafData array and then do some maths to interpolate data values.

For a 12 bit array we can just use the raw value, but for a 10 bit array our 12 bit reference will not work, so we need to work out which two values fall either side of our reference value and then do some interpolation to calculate the actual value. We could of course limit the reference value to 10 bits (probably a good idea initially) but then we lose that extra resolution.

We are already doing a similar thing with the key>value style mafData array as this is not a fixed length array.

There we are using the following interpolation formula:

```
Y=Y0+(((X-X0)(Y1-Y0))/(X1-X0))

where Y = flow and X = Volts
```

We might even be able to recycle this code and move it into a function

DeeEmm, 2021-08-25:
Need to determine what message are displayed to the user via the WebUI.

- [ ] Error messages
- [ ] Status messages
- [ ] Confirmation messages

Need to determine what clears down error messages

- [ ] User confirmation
- [ ] Error remedied
- [ ] Continued operation (error ignored but no longer active)

DeeEmm, 2021-09-22:
API Status messages were being reported to the GUI status field. This was also related to #97 where the status message was incorrectly being sent by debug.print method

Moved API status messages out of global scope and changed to serial.print method.

DeeEmm, 2021-09-23:
Message: 'Flow limit reached'

Description: 'Test object flow exceeds Vac source capability'

Need to display to user when measured flow approaches maximum flow capability of vac source.

Also need to include config setting to set threshold
Also need to be able to calibrate this value i.e. record flow with no test piece

DeeEmm, 2023-01-27:
Some further thoughts on this...

Bench limits can be determined by testing the reference depression. If depression cannot be maintained when increasing flow requirements the bench has reached it's limit. This can be used to determine the flow limit for the bench.

There's essentially two ways I can see this working

1. A range of orifices can be measured to determine what the maximum achievable flow is for a given reference pressure. This flow value can then be 'hard coded' by manually entering it as a configuration parameter.
2. The depression value can be compared to vacuum control 'on-the-fly'. Limit is reached when vacuum control is at or approaching 100% modulation, but reference pressure cannot be maintained

Basically if the reference depression cannot be maintained for a given flow rate, then test piece is outflowing the vac source.

There are two ways to set this up:

1. Manually enter the calculated / measured limit and then compare flow rate to this limit. i.e. if flow_rate >= flow_rate_limit
2. Test limit 'on-the-fly' by comparing vac_speed_ref to ref_pressure. This does not require any specific limit to be measured or set and works for all depressions / flow rates

Option 2 is more flexible but requires integrated vac speed control. Option 1 will work for any setup but requires that the user sets up the initial flow limit.

Thread 79 (2021-08-21):

Maf Data conversion from 10 to 12 bit analog data on the ESP32

DeeEmm, 2021-08-21:
Old analog conversion on Mega / Uno was 10 bit resolution (1024 data points) but ESP32 is capable of 12 bit resolution (4096 data points). In the short term this means that the old code does not work. In the long term it may mean updating both the code and the mafData files to take advantage of the better data resolution.

Proposal is to get code working with existing mafData but with a view to be able to utilise higher resolution data files should they be available.

DeeEmm, 2021-08-21:
Need to detect size of mafData array and then do some maths to interpolate data values.

For a 12 bit array we can just use the raw value, but for a 10 bit array our 12 bit reference will not work, so we need to work out which two values fall either side of our reference value and then do some interpolation to calculate the actual value. We could of course limit the reference value to 10 bits (probably a good idea initially) but then we lose that extra resolution.

We are already doing a similar thing with the key>value style mafData array as this is not a fixed length array.

There we are using the following interpolation formula:

```
Y=Y0+(((X-X0)(Y1-Y0))/(X1-X0))

where Y = flow and X = Volts
```

We might even be able to recycle this code and move it into a function

DeeEmm, 2021-08-21:
Also need to convert from 5v to 3.3V.

Old key>value array data range is from 0-5000 (0-5v) which means that we can no longer use raw analog values to directly interrogate the data array. We first need to scale the reference value, the data or potentially both.

So it looks like the best course of action is going to be to to re-write the MAF data file handling. This will also be in line with Issue #76 which requires a full review and update of the sensor code.

So It is going to be better to use an arbitrary array length that also has an arbitrary scaling. This way we do not care how many data points we have, or what voltage they were recorded at. or even if they relate to voltage. By doing this, we should also then be able to accommodate the frequency based MAF data that we need to integrate as part of issue #26.

I think that we should firstly move to a 2D array for all data. i.e.

```
{{key1, val1} , {key2,val2}, {etc..}}
```

It will be easy enough to transpose the existing array data that we have for analog sensors. where the key value simply takes the existing array reference value.

```
{1,2,5,7,9}

becomes...

{
  {0,1},
  {1,2},
  {2,5},
  {3,7},
  {4,9}
}
```

This move commonalises all Maf Data arrays into the same basic structure which makes the code easier.

We can then use class methods to determine what type of data it is and what scaling it was recorded at.

I have already converted the mafData files to a class / method style of code structure so that we can have multiple instances of maf data, that all share the same data names and data types without generating pages of compiler errors, so we should end up with something like this...

```
class MafData {

	public:
		MafData();
		String mafSensorType ();
		int MAFdataFormat ();
		int MAFdataUnit ();
		int MAFoutputType();
		long getMafData();

		long mafLookupTable[][2];

	private:

};
```

We can expand on the methods above with additional methods as required.

DeeEmm, 2021-08-23:
I've converted the MafData files back to basic header files as I was unable to resolve some clashes with the class definitions. I tried to control this using namespaces but ended digging myself a deeper hole so decide to revert back to the original way of handing this. This has changed the way we interact with the mafData but as all of that stuff is currently in flux changing it is not really an issue.

We still have the array changes noted above and are using a 2D array as a lookup table for all data types (voltage / frequency / etc)

How the array is processed is the same in all instances as it is a simple lookup function.

We take an arbitrary sensor value (millivolts / herts / baked-beans / etc)  and we then look up the corresponding value from the lookup table. This value is in mass-flow (kg/h or g/s). Apart from scaling, the result will always be mass-flow, irrespective of what the input is.

We get the sensor value from the sensors class, so it is there that the analog input value is converted into the relevant format to work with the lookup table. As all mafData variables are exposed to the sensor class it simply uses mafOutputType to determine how to translate the raw sensor value into whatever value the lookup table needs.

In the case of a voltage based sensor I have changed the voltage and input resolution to 3.3v / 12 bit.

```
int mafFlowRaw = analogRead(MAF_PIN);
double mafMillivolts = (mafFlowRaw * (_hardware.getSupplyMillivolts() / 4095.0)) * 1000;
return mafMillivolts;
```

...which concludes this particular issue request. However there is still some work to do to address #26

/DM

Closed 2021-08-23.

Thread 80 (2021-08-22):

Add Software Trimpots

DeeEmm, 2021-08-22:
Conversion between 5v field devices and the 3.3v ESP will be done on the shield with signal conditioning. This should also include some form of trim pot and test point so that the input voltage can be calibrated.

This requests ads software 'trimpots' to  the input channels so that the value can be further dialled in should it require it.

Each Trimpot can either be

- A constant value within the configuration file
- A configurable value that can be dialled in by the API / calibration

As the 5v-3.3v conversion tuff needs to be done for the ESP32. I'm adding this to the ESP32 Port project

DeeEmm, 2021-08-22:
It should be noted that we can already view raw sensor voltage data via the API.

DeeEmm, 2021-08-22:
For the moment I've added some definitions to the config file...

```
#define PREF_TRIMPOT 0.0
```

etc...

DeeEmm, 2021-08-23:
Added trimpots to all input data streams within sensors class.

For example...

```
double mafMillivolts = (mafFlowRaw * (_hardware.getSupplyMillivolts() / 4095.0)) * 1000;
mafMillivolts += MAF_TRIMPOT;
return mafMillivolts;
```

Trimpot value can be determined by comparing measured sensor output voltage and calculated voltage in API. The trimport should be set to the difference to bring the calculated value in-line.

This procedure will form part of initial calibration when setting up the shield.

I may revisit this at a later stage to refine how we do this but for a one-off routine I think it is acceptable.

Closed 2021-08-23.

Thread 81 (2021-08-23):

Review 10-12 bit conversion for all inputs

DeeEmm, 2021-08-23:
Review all sensor inputs:
- Convert from 5v to 3.3v reference
- Convert from 10 bit to 12 bit resolution

DeeEmm, 2021-08-23:
Have already updated MAF sensor and board voltage reference (#79). Need to roll out for remaining inputs prior to unit tests (#76)

Example conversion (from MAF sensor)

```
int mafFlowRaw = analogRead(MAF_PIN);
double mafMillivolts = (mafFlowRaw * (_hardware.getSupplyMillivolts() / 4095.0)) * 1000;
return mafMillivolts;
```

NOTE:
```
_hardware.getSupplyMillivolts()
```
References 3.3 volt supply and integrates supply fluctuations into sensor calculations.

4095 bit resolution = 12 bits

DeeEmm, 2021-08-23:
Remaining references to 10 bit / 5v replaced

Closed 2021-08-23.

Thread 83 (2021-08-23):

Review sensor code

DeeEmm, 2021-08-23:
- [x] MAF Sensor
- [x] Reference Pressure
- [x] Temperature
- [x] Baro Pressure
- [x] Relative Humidity
- [x] Pitot Pressure
- [x] Differential Pressure

DeeEmm, 2021-08-24:
Reviewed MAF code. Have updated code to work for frequency or voltage based MAF sensors.

Needed to do some Voodoo to get ISR to work within class structure. See comments in sensors.h for more details

DeeEmm, 2021-08-24:
#26 closed out - Frequency based MAF support

DeeEmm, 2021-08-24:
Moved sensor related code from maths class into sensors class.
Added GPIO initialisation to hardware class
Reenabled BME280 libraries
General code review

Closed 2021-08-24.

Thread 84 (2021-08-24):

Finalise Orifice and Pitot bench code

DeeEmm, 2021-08-24:
Finalise calculations for ratiometric style orifice and pitot based benches.

Both systems use differential pressure measurements across the reference orifice along with reference pressure to calculate flow.

We need to be able to determine what orifice is being used along with the calibrated flow value for the orifice to be able to calculate the flow.

Suggest that orifice flow values are stored in the configuration parameters in the same way that we currently store the calibration orifice data. This allows the user to manually input the flow data for each of the orifices that they use.

Orifice selection can be made manually via WebUI, or better automatically. Unsure if fan / VFD control can be used to determine what orifice is being used as there will be overlap cases where it would difficult to calculate. A better method would be to use a 'tool' code that uses an electrical method for determining the orifice that is being used.

E.G. Binary coded decimal (BCD) A simple 3 wire system will cater for 8 permutations (2^3). NOTE: we have exactly 3 I/O spare if we used I2C for BME280

DeeEmm, 2021-08-25:
This is more in depth than I anticipated so I have moved it out of the ESP32 port as it will ultimately hold release up.

The net result is that the code will still get finished in the same amount of time, but the ESP32 port can be released sooner.

I have also expanded this updated to include Venturi style benches as well.

Thread 87 (2021-08-25):

[BUG] Not joining WiFi Client network

DeeEmm, 2021-08-25:
**Describe the bug**
Not joining client network

**Expected behavior**
Joins network

**Arduino (please complete the following information):**
 - ESP32

DeeEmm, 2021-08-25:
Config file not loaded early enough.

Added call to load config prior to WiFi connection

Closed 2021-08-25.

Thread 97 (2021-09-21):

[BUG] API disabled by debug mode

DeeEmm, 2021-09-21:
**Describe the bug**
API disabled by debug mode

**To Reproduce**
API only active when debug mode = on

**Expected behavior**
API normally active

**Additional context**
Suspect Serial.print / Debug.print swapped

DeeEmm, 2021-09-21:
Replaced debug.print commands with serial.print

Closed 2021-09-21.

Thread 100 (2021-09-23):

Zero out differential sensors

DeeEmm, 2021-09-23:
**Is your feature request related to a problem? Please describe.**
Differential sensors zero point may drift depending on system design / construction / ambient conditions

**Describe the solution you'd like**
Add a zero button to differential sensors to allow ambient condition to be zero'd

This applies to Pitot, Diff pressure and also Ref pressure as they all use MPX7007DP sensors

DeeEmm, 2024-11-11:
Related to #213 GUI Pitot Display Changes

DeeEmm, 2024-11-16:
I'm going to close this issue out as it is part of #213

Closed 2024-11-16.

Thread 101 (2021-09-23):

Message: 'Flow limit reached'

DeeEmm, 2021-09-23:
Message: 'Flow limit reached'

Description: 'Test object flow exceeds Vac source capability'

Need to display to user when measured flow approaches maximum flow capability of vac source.

Also need to include config setting to set threshold
Also need to be able to calibrate this value i.e. record flow with no test piece

_Originally posted by @DeeEmm in https://github.com/DeeEmm/DIY-Flow-Bench/issues/77#issuecomment-925510153_

KirikauKiwi, 2024-12-12:
Something similar to this would be useful to show that the MAF sensor has gone over range, currently the MAF tile displays 0.0 when the over range occurs.

DeeEmm, 2024-12-12:
haha, I noted earlier that there is already a TODO comment in the MAF code to remind me to do this

It should ideally trigger a system message that is displayed on the GUI where it currently reports the uptime

The only issues is that the the system messaging is yet to be started.

Thread 105 (2022-10-12):

[BUG] - Missing file extensions in configuration.h

DeeEmm, 2022-10-12:
**Describe the bug**
File extensions missing in MAF Data file calls in configuration.h

```
// Uncomment One sensor only
#define MAF_SENSOR_FILE "mafData/ACDELCO_92281162.h"
// #define MAF_SENSOR_FILE "mafData/ACDELCO_19330122.h"
// #define MAF_SENSOR_FILE "mafData/VDO_AFM_043.h"

// #define MAF_SENSOR_FILE  "MH95_3000_100"                 // PMAS MH95-3000 in 100mm housing      
// #define MAF_SENSOR_FILE  "mafData/SIEMENS_5WK9605"       // Data from Tonys tests
// #define MAF_SENSOR_FILE  "mafData/DELPHI_AF10118"        // kg/hr - Data from efidynotuning.com/maf.htm

// #define MAF_SENSOR_FILE  "mafData/TEST"                  // Test Data
```

DeeEmm, 2022-10-14:
Fixed in Dev branch

Closed 2022-10-14.

Thread 110 (2022-12-01):

[BUG] ERROR: Too many messages queued

DeeEmm, 2022-12-01:
**Describe the bug**
"ERROR: Too many messages queued " message in serial monitor

**ESP32 (please complete the following information):**
 - Firmware Version: V.2.0-RC.3-WIP Build 22120103
 - Hardware Type  Wemos D1 R32

**Additional context**
Possibly related to task priority / timing and similar issue with Wifi connection

DeeEmm, 2022-12-12:
This is actually not an error. There is a limit of 16 messages per second - https://github.com/me-no-dev/ESPAsyncWebServer/issues/504

The above error message is only displayed when in debug mode.

Otherwise excess messages are silently discarded

Marking as closed.

Closed 2022-12-12.

Thread 111 (2022-12-01):

[BUG] WiFI fails to connect and defaults to AccessPoint

DeeEmm, 2022-12-01:
**Describe the bug**
Fails to connect to Wifi and falls back to create an AccessPoint

**To Reproduce**
Steps to reproduce the behaviour:
1. reboot board

**Expected behaviour**
Connection to Wifi network

**ESP32 (please complete the following information):**
 - Firmware Version: V.2.0-RC.3-WIP Build 22120103
 - Hardware Type . Wemos D1 R32

**Additional context**
Repeated reboots will eventually get Wifi to connect
Was working fine with same code on ESP-WROVER-KIT dev board
Suspect timing / priority issue
Possibly related to BUG #110

DeeEmm, 2022-12-12:
Similar issue reported here https://github.com/espressif/arduino-esp32/issues/2501 where wifi connection cannot be established. Issue appears to be related to Arduino port of ESP-IDF Wifi library. Several workarounds are suggested some of which I have implemented in commit https://github.com/DeeEmm/DIY-Flow-Bench/commit/7fd547915a78ec22b1302372bc8705cbd1587b81

Establishing wifi connection is now much more reliable (although still not perfect)

Closed 2022-12-12.

Thread 113 (2022-12-07):

Automatic MAF reorientation

DeeEmm, 2022-12-07:
**Is your feature request related to a problem? Please describe.**
Reorientation of MAF sensor for reversing bench flow direction

**Describe the solution you'd like**
MAF reorientates automatically

**Describe alternatives you've considered**
Removing and reinstalling MAF in opposite direction

**Additional context**
MAF removal and reinstallation is cumbersome.

Add some method by which the MAF sensor can be automatically reoriented. This may be possible using a stepper motor and cartridge style MAF.

DeeEmm, 2023-05-10:
The requirement for MAF reorientation is negated when the Audi RS4 MAF is used as this is capable of reading flow in both directions. Whilst  that solution does not physically reorient the MAF sensor is should be adequate in most cases for measuring reverse flow.

Closed 2023-05-10.

Thread 125 (2023-02-01):

MAF Sensor calibration verification methods

DeeEmm, 2023-02-01:
MAF Sensors

- [x] Add data for additional MAF sensors
~~- [ ] Add MAF selection menu~~
~~- [ ] Add MAF Selection via SPIFFS~~
- [x] Add calibration verification methods
~~- [ ] Add support for frequency based MAF sensors~~

DeeEmm, 2024-10-24:
Current calibration discussions #178 / #179

Closed 2024-11-11.

Thread 136 (2023-03-31):

MAF Transfer function for Slot style MAF sensors

DeeEmm, 2023-03-31:
### Discussed in https://github.com/DeeEmm/DIY-Flow-Bench/discussions/135

<div type='discussions-op-text'>

<sup>Originally posted by **DeeEmm** March 30, 2023</sup>
I've put together a quick Excel sheet to translate flow values between different pipe diameters. This allow you to use a slot / cartridge style MAF sensor in a different diameter pipe.

The function is based on volumetric flow velocity formula

```
v = Q / (π · (ø / 2)²)
```

Where
```
Q = Volume flow rate
v = Flow velocity
A = Cross-sectional area
r = Radius
ø = Diameter
```

The formula specifically relates to volumetric flow but should also work for mass flow as the ratiometric relationship between flow and area is the same for both.

Essentially it works as follows. First we convert the flow value to a velocity using the area of the pipe

```
velocity = original_flow_value / original_area
```
or...
```
velocity = original_flow_value / (3.145*(original_diameter / 2)^2)
```

Then we convert this back into a flow value again using the new area

```
new_flow = velocity * new_area
```
or...
```
new_flow = velocity * 3.145*(new_diameter /2)^2
```

Essentially this is just scaling the flow value by the change in pipe area.

The formula is included in the attached Excel sheet. Just paste your MAF flow values in the first column, put in the pipe diameters and drag the formulas down in the second and third columns to suit.

[Flow Transfer Function.xlsx](https://github.com/DeeEmm/DIY-Flow-Bench/files/11110385/Flow.Transfer.Function.xlsx)
</div>

.
### Add transfer function into code to allow end user to configure pipe diameter that they are using.

This requires that original MAF diameter is included within the MAFData file.

User can enter pipe diameter within configuration settings (this will default to original diamter for fixed diamters)

Flow data can then be transposed as part of the MAFData lookup function...

Data-lookup > Data-transpose > Transposed-Flow-Value

DeeEmm, 2023-04-04:
Function added in build 23040302 (Commit https://github.com/DeeEmm/DIY-Flow-Bench/commit/7a2b8deaacc0ce50266aa295c98dd9f75399a60c).

The MAF data files now contain the MAF housing diameter that the flow data relates to. This is generally the OEM housing size but may be other non-standard diameters for custom MAF definitions.

Then on the configuration page in the WebUI there is a MAF Diameter setting. This is the size of the installed housing.

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

The code then scales the flow value based on the difference in housing area using these two values

```
OEM housing area : Installed housing area
```

This will work for both larger and smaller than original MAF housings

If either value is set to zero or the two values are the same the calculation is not performed and the original MAF flow data is used. This means that the scaling is only applied if the original diameter is listed in the MAF Data file and a positive non-standard diameter is entered into the GUI.

Ultimately all new MAF Data files should include the housing diameter that the MAF data was recorded with.

Closed 2023-04-04.

Thread 156 (2023-09-19):

2 hole bench & 2 MAF Sensors

Ronnie180, 2023-09-19:
Not an issue but more a thought & added feature. Reading through this awesome project It hit me that a lot including me tend to build a 2 hole bench, one for Head flowing & one for Carburetor flowing especially for smaller benches used for small single or twin cylinder engines, that way adaptors don't have to be changed. Just close off the one that isn't being used but I've also seen several big diy 2 hole bench builds with flow upwards of 800 cfm's. So just a thought but maybe incorporate it to read 2 seperate MAFS so that a second one can be added & not have to be removing & changing  just one Maf to the hole that is being used or flipped if not using the RS4 Audi as I was informed it flows both ways anyway. Just a thought...

DeeEmm, 2023-09-19:
As per our Discord discussion it should be possible to do this with the current hardware.

Thread 157 (2023-12-17):

LiftGraph.png file has blank data

DeeEmm, 2023-12-17:
Yes it saves liftdata.json and it show values correctly in text format when I open it with notepad, but image LiftGraph.png show 12kb size and 800x750 pix, but when the file is opened it is empty, there is no image, the opened image shows as a transparent rectangle. A simple solution for now is just a screenshot, but probably there is a bug in code, because same problem on phone and pc when image is saved.
Another small detail that would be convenient is the possibility to change not only the lift interval but also the maximum lift and maximum flow values on the graph in the configuration. Now the graph looks out of proportion with the maximum 1000cfm when measuring for example up to 350cfm.

_Originally posted by @black-top in https://github.com/DeeEmm/DIY-Flow-Bench/discussions/155#discussioncomment-7875544_

DeeEmm, 2024-11-25:
Just testing this and appears to be working fine.

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

@black-top are you still seeing this issue?

Does anyone else see the same problem?

black-top, 2024-11-25:
Yes, I get a blank image. If I open an image with a different program, I still see the same view. Same on an Android phone.

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

DeeEmm, 2024-11-25:
Can I ask what browser you are using? Looks to be Chrome?

I'm using Chrome / Firefox / Opera here wth no issues but I run a MAC so do not have a way to test Internet Explorer.

The conversion from the SVG image displayed in the UI to downloadable image happens entirely in the browser. The process takes the SVG image, converts it and presents it the browser as a download. This is done in javascript at runtime.

I suspect that the issue is therefore be browser related. The big question is how / why.

One easy thing to test is to change the file format. I've just committed a change to the DEV branch that changes the file from PNG to JPG. Give that a whirl and see if it is any different.

You will need to compile / upload as well as use the index.html in the data folder.

Let me know if that makes a difference

black-top, 2024-11-30:
Don't have any time to do testing right now, so tested  only different browsers with same firmware in esp32. It looks like the problem is with Firefox, because at the flow bench win7 pc with Firefox and on an Android phone with Firefox, the problem is the same.  With Opera browser, image saving is working.

stefan63, 2024-11-30:
Firefox is picky my experience to!
Chrome is restrictive but at least it give you an option ;)

Den lör 30 nov. 2024 kl 18:06 skrev Black-top ***@***.***>:

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

DeeEmm, 2024-12-01:
Thanks @black-top. Will take a look at the requirements for the image saving in FF.

I use Chrome.

DeeEmm, 2024-12-10:
I have replicated this issue locally in FF.

Changing file download type from PNG to JPG did not resolve the issue.

Seems as if the canvas is not being saved properly. (SVG is painted onto HTML canvas and then saved as an image). There are some references to issues with FF and fixes discussed, but it looks like those fixes are already present in the code.

Currently we have no CSS data associated with the canvas as none is needed, but there is at least some commentary online that it is important to integrate the CSS. Perhaps this needs to be present for this work in FF.

Will try and test again.

DeeEmm, 2025-01-09:
Just re-tested this to work on a fix and this issue now appears to be resolved.

This may possibly be Firefox related - perhaps a recent update. My FF version is V 133.0.3

Closed 2025-01-09.

Thread 158 (2023-12-20):

No option to select the capture mode for adjusted/unadjusted flow.

DeeEmm, 2023-12-20:
Another small thing is that there is no option to select the capture mode for adjusted/unadjusted flow. Now it is only capturing the unadjusted flow.
It would also be good if a table with lift and flow values was shown under the graph, because the exact values are not clearly visible on the graph

_Originally posted by @black-top in https://github.com/DeeEmm/DIY-Flow-Bench/discussions/155#discussioncomment-7907329_

- [ ] Capture mode for lift graph
- [ ] Table of results
- [ ] Dynamic table of results

Also related to #184 - Data logging

DeeEmm, 2024-11-11:
This has two parts. The capture mode, which I think could probably be brought forwards into the RC9 release so that users can choose what value is being stored (ACFM, SCFM,  Adjusted ACFM or Adjusted SCFM) and the table of results.

To a degree both of these are integrated and part of a larger change planned for the V3 release. However, at present only the ACFM value is stored in the flow graph, which may not suit everyones use case.

So I will to bring part of this forwards into the RC9 release and once that is completed we can then push back the remaining features

DeeEmm, 2024-11-23:
Capture datatype pretty much done, just need to save settings to config.

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

The descriptions in the drop down update to reflect current status.

Closed 2024-11-23.

Thread 159 (2023-12-21):

Pitot input calibration for air speed probing

DeeEmm, 2023-12-21:
Will be nice to have feature for pito input calibration for air speed probing so it will display air speed in m/s or ft/s instead of differential pressure if pito input is unused with maf or orifice style flow bench.

My small pump starts to lose pressure after approximately 150-160cfm @ 28in H2o, so corrected and uncorrected flow numbers start to diverge,  so I probably will change to my big pump that was too powerful for my electrical installation, but now I have VFD, so it should be ok.

I still need to fix few leaks and do calibrations for flow bench.

_Originally posted by @black-top in https://github.com/DeeEmm/DIY-Flow-Bench/discussions/155#discussioncomment-7918628_

DeeEmm, 2024-11-11:
This is related to #213 for the Pitot GUI changes so brining forwards into RC9 releae

DeeEmm, 2024-11-16:
I'm going to close this issue out, All pitot related changes are now in #213

Closed 2024-11-16.

Thread 162 (2024-08-05):

Compilation error: 'tiny' does not name a type

stefan63, 2024-08-05:
**Software Version**
- RELEASE (e.g. V.2.0-RC.6)
- BUILD_NUMBER (e.g. Build 23041301)

**Describe the bug**
A clear and concise description of what the bug is.

**Expected behavior**
Trying to upload but Arduino IDE keep complaining with.
"Compilation error: 'tiny' does not name a type   🙁
Seams to be an issue with sensors.cpp how di I solve this?"
......................#ifdef BME_IS_ENABLED
#define TINY_BME280_I2C
#include "TinyBME280.h"
tiny::BME280 _BMESensor;
TwoWire I2CBME = TwoWire(0);
#endif............

"Arduino IDE Version: 2.3.2
Date: 2024-02-20T10:04:35.814Z
CLI Version: 0.35.3"

**Steps to reproduce the bug**
I simply try to upload the sketch and no complains about missing librarys.

**ESP32 (please complete the following information):**
 - Hardware Wemos D1 R32]
 - ESP Firmware ?

**Additional context**
Would be nice to know wich librarys and library versions that was used during a successful upload :D

DeeEmm, 2024-08-06:
Hi Stefan.

I suspect that it might be that the TinyBME280 library is not registered in the Arduino IDE so it cannot find the TinyBME280.h file.

My recommendation is to consider swapping to use the VSCode IDE as there are environment files provided in the project that automagically set up library dependencies. This has to be done manually on the Arduino IDE.

/DM

DeeEmm, 2024-08-06:
For info on installing with the VSCode IDE please refer to the wiki documentation

https://github.com/DeeEmm/DIY-Flow-Bench/wiki/Installation

Let me know how you get on.

/DM

stefan63, 2024-08-18:
Sorted out for now by commenting out the currently non existing BME280 in my test setup.

Closed 2024-08-18.

Thread 163 (2024-08-21):

Toggle switch to allow for dual use of Diff press sensor Pdiff / Pitot

stefan63, 2024-08-21:
Just a thought, if we could implement a switch "software or hardware controlled" to select betwen Pdiff and Pitot we might be able to save some  $  and a sensor?

stefan63, 2024-11-03:
Thinking loud is not always the best haha...
Maybe just close this suggestion since I realize that this need to involve a solenoid valve to be able to switch negative pressure port location from tube to ambient pressure and therefore no savings to be made!
Kind regards/Stefan

DeeEmm, 2024-11-04:
On some aftermarket systems they use a pneumatic manifold to switch tubing configuration. These are commonly used in pneumatic logic and are available at industrial suppliers. This would take care of the physical connection.

The manifolds also can have electrical switches to determine the position.

Switching the sensor source based on an input or even a soft key on the GUI is definitely possible.

Thread 164 (2024-09-03):

[BUG] Baro pressure incorrectly displayed in UI

DeeEmm, 2024-09-03:
**Software Version**
- RELEASE V2.0-RC.6
- BUILD_NUMBER 23041301

**Describe the bug**
Baro pressure value is / 10

maher-nakesh, 2024-09-03:
try this
https://t.ly/zy17A
select the desired compiler in the installer

DeeEmm, 2024-09-03:
Code review in progress.

DeeEmm, 2024-09-04:
OK. so I've fixed this issue, it was sending the incorrect value to the UI

I will not release the fix just yet as there is a small amount of refactoring happening that I am still in the middle of.

Here's the fix for anyone who wants to manually implement it...

in webserver.cpp on line 1042 change...

`  dataJson["BARO"] = sensorVal.BaroKPA;`

to

`  dataJson["BARO"] = sensorVal.BaroHPA;`

This fix will appear from build 24090301 onwards.

Closed 2024-09-04.

Thread 178 (2024-10-22):

[BUG] Leak Test Calibration data - out of range

DeeEmm, 2024-10-22:
**Software Version**
- RELEASE (e.g. V.2.0-RC.7)

**Describe the bug**
Calibration value for leak test incorrect / out of range

Reported by @black-top

Review leak test calibration code

DeeEmm, 2024-10-22:
Looks like the calibration data is simply not being saved to or read from the calibration file.

The -1000 value is just an arbitrary value used in the initialisation...

`
/***********************************************************
 * Calibration Data
 ***/
struct CalibrationData {
  double leak_cal_press_val = 1000.0;
  double leak_cal_vac_val = -1000.0;
  double leak_cal_val = 0.0;
  double flow_offset = 0.0; 
};
`

The reason that the calibration data is not being read or written is that the code is commented out in Calibration::parseCalibrationData

I've uncommented it and tweaked a couple of things.

I will upload to master.

DeeEmm, 2024-10-22:
okay. uploaded to master.

@black-top can you test and see if this fixes the issue

black-top, 2024-10-22:
Thank you for your quick response. Now the "measured leak test value" always stays -1 instead of -1000 as before.

DeeEmm, 2024-10-22:
Haha. okay. So I'm guessing it's either not writing to or reading from the calibration file.

I uncommented the code that was already there, but there is obviously a reason that it was commented out

I'll try and take a look tonight.

DeeEmm, 2024-10-28:
Just trying to get the flow calibration discussion back on topic so moving the discussion from the flow calibration thread to here

https://github.com/DeeEmm/DIY-Flow-Bench/issues/179

@stefan63
> I guess and think that the leak check could be done at a far lower pressure than 28" no reasont to press the system to it maximum. After all its just a way to test for leaks so not super critical but to be able to leak check we need ti be able to create a stable vacuum/pressure and be able to compare it from end to end, if a contant regulation have to be done it will indicate a leak. I also feel that a modulated blead valve is more prcice than a motor speed regulation ever can be, no matter if its a VFD or other type of PID regulated speed controller.

Yes, these are my thoughts too, but I accept that people will want to test at higher depressions. Superflow test at 25", so essentially this is the defacto standard, whether we agree with it or not.

The big problem with trying to leak test a MAF based system is that the system is one single plenum, whereas on a depression style bench the system is split into two plenums by the orifice. So you regulate your test depression by adjusting the depression under the orifice and then measure the depression that you get above the orifice. Any differential and you've got a leak.

With the MAF style setup you cannot do this. All we really have available to us is mass flow. If we register flow, then there is a leak somewhere. In this regards we are not comparing apples with apples by adopting the 25" standard of the Superflow bench.

We can however do a simple test to determine how the reference depression impacts the ability to leak test. We simply introduce a controlled leak of say between 1-3cfm and then map the flow values over a depression range, starting off at a very low reference depression and gradually increasing it. Maybe in 1" increments.

We can also try to predict this...

Flow at the new pressure drop = (SQRT (new pressure drop/old pressure drop)) x CFM at the old pressure drop

Lets start at an arbitrary test with a leak of 1 cfm and a depression of 4" which is about what you can expect out of a shop vac.

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

As you can see the difference between testing at 4" and testing at 28" is about 1.4 cfm.

If we compare the difference between 10" and 28" it drops down to less than 0.5 cfm.

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

I think that this shows that massively increasing the test depression for the leak test does not increase the flow characteristics to the point of it being a benefit. This is different for a differential style bench where increasing the depression increases the differential.

DeeEmm, 2024-10-29:
Hi Guys. I've invited @danielerpl into this discussion from FB. Daniele is running a differential (orifice) style bench. @black-top & @stefan63 I think it is a good opportunity for all of us to get our heads together and work out a solution that works for all bench styles / applications

This is one of the few remaining issues that needs to be resolved for the V2 release. It would be good to get it solved. Obviously my first iteration missed the mark by some distance lol.

So far I think that it is clear that a solution for a MAF based system will not be appropriate for a differential based system and that even between different benches, things like test depressions will differ a lot.

The most basic solution is that the leak test is carried out manually and the resultant CFM figure is manually saved as an offset under the configuration tab > Calibration Data settings. This allows each end user to carry out the leak test that is most appropriate for their system.

~I think that there is a use case for people wanting to run BOTH MAF and Differential systems within the same bench, especially in a retrofit. So we need to consider how offsets work in this situation. Obviously we do not want to double up on the values but it does depend on bench design. Do we therefore need seperate offsets? ~ << I think this should be considered but parked for future development if the use case arises. I would assume that most designs would place the MAF in series with the differential system,

I think a good first step is to change the disabled fields for the configuration tab > Calibration Data settings, add pDiff offset and allow them to be manually updated. This will at least allow people to perform a manual leak test of their own devising.

Then we can try to figure out how to automate the leak test calibration and leak test validation...

Leak test calibration - initial leak test setup - Ideal scenario where test surface is directly blocked with no leak to give baseline leak test reading.

Leak test validation - subsequent tests carried out each time a job is set up to validate the setup - inlet to test piece is blocked to test heads for leaks i.e. loose plug / leaking valves / cracked head / etc

Thoughts...?

DeeEmm, 2024-10-30:
I've added the ability to manually update the calibration values.

This works along side the existing flow calibration function

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

black-top, 2024-10-30:
I was thinking about a solution to fit all, but there are too many differences in systems. I think the simplest and best solution right now is just the ability to manually update the calibration values. So the calibration will be the same for all designs, but the calibration process can be type-specific. The procedure can be updated easily in the wiki and without any code changes. At the end of the day, all types of flow benches need leak value in CFM.  Unless someone has a better idea to discuss and test.

I think more data for data logging will be more beneficial at this stage of code validation because it is a great opportunity to compare data with different types of flow benches, and more data will allow us to see what can cause the differences in readings, but this needs a separate topic.

KirikauKiwi, 2024-10-30:
Thinking thorough the process, the flow bench firstly need to be constructed and tested for leaks etc in the cabinet, piping etc. Once the system is deemed air tight we are then only concerned with a leak between the cylinder head and the measuring devices.

Doing a closed system test, i.e. valves shut on the head, could be difficult as if a perfect seal is achieved there will be zero air flow which will most likely cause stalling/surging in the vacuum pumps.

I think a known test orifice would have to be introduced/designed in to the system that can easily be opened during the leakage test a leakage test port as such, e.g. in the case using a CD @10" with a flow 14.4CFM. If the system is perfectly sealed you would have 14.4CFM at a 10" depression, if there was a leak in the system you would expect a greater flow number than 14.4CFM and the difference between the actual flow and the expected flow would be the leakage offset.

Testing for the leak visually is important too and should checked, with either the likes of an incense stick/joss stick and looking for the smoke being sucked in or you could use the pitot sensor with a tube attached and use it as a sniffer inside the ports and the flow bench to cylinder interface as it would pick up the change in pressure at the leak location. So it could be useful when in leakage test mode, the bench could have some sort of gauge on screen for the pitot sensor sniffer.

DeeEmm, 2024-10-30:
Using the pitot to locate leaks is an interesting idea. There are plans on the roadmap to add a graphical / manometer style display to the GUI for the pressure and pitot gauges - just an analog representation of the value. So using it for leak testing as you describe is a possibility. But that's a down the track enhancement. (V3+)

The orifice idea is used commonly from what I have read and has been discussed previously. I think that this could work equally for the MAF and differential benches if closing the inlet off completely does not work for a particular bench.

After pondering over this today, I think that the method of the test is largely unimportant, as long as the same method that is used to set the baseline is then later used to do the comparison tests. Whether that is using an orifice, or a fixed plate, and whatever the reference depression used. This can be up to the end user to determine and can be driven by both bench type and capability as well as personal preference. We can outline a generic test in the WIKI as a point of reference and mention both fixed pates and small orifices as well as high / low reference depressions. But ultimately in all cases we are simply storing a CFM offset.

The leak test calibration is therefore simply the same as the flow calibration. The flow value is saved as an offset and then applied to all subsequent measurements. Once it is set it becomes the new baseline. The end user can use the 'calibrate leak test' button to store the value automatically or manually type the value into the configuration page and save it,

I think that there may also be some value in having two leak test calibration values. One for the bench itself. i.e. a fixed offset that addresses leaks and disparities found in the system when the test surface is blocked off. And a second value for leaks detected in the job when the test piece inlet is blocked off. This translates for both MAF and Differential style benches.

The reason for this is that the first value will theoretically not change, whereas the second value will potentially change from job to job.

Ideally you want the ability to block off the test surface and run a leak test on the bench itself at any time as part of fault diagnosis. So you never want to overwrite that initial baseline value for the bench. Otherwise you remove the possibility of being able to undertake that test. Baseline data is very important for condition monitoring and fault diagnosis.

I read a story of a guy that managed to detect one of his vac motors slowly getting loose over a period of time because he was seeing a drift away from his baseline leak test values.

You also want the ability to store a temporary offset for each job.  For example you're working on a head that has a crack in it that's going to get welded up later on or has a dodgy sealing surface but will be getting a skim. So you can zero out the leakage from the crack / scratch, do your flow / port work / seat job / whatever and still generate a valid data set that isn't skewed by the crack / scratch leak.

To make the stored leak calibration data useful. The leak test validation just needs a way to compare the current test against the baseline.

Originally I was thinking of a go / no-go style of indication, but now I'm thinking that adding another tile that displays the difference between the current value and the leak test baseline value in CFM would be of more value. There's no pass / fail. The end users just decides if it is good enough by looking at the difference. Then if they want they can manually tweak the value, or hit the leak-cal button to update it and bring the differential back down to zero.

So...

- Baseline Offset (A)
- Leak Cal val (B)

Functionality...

- Both values can be manually updated via the existing configuration page.
- Hitting the leak-cal button saves the current flow value to leak Cal Val (B) only!
- The Baseline Offset (A) value is only manually updated. This will prevent it from getting accidentally overwritten (When you record the initial baseline measurement, you can save to B and manually transfer it to A)

So Value A is essentially permanent, whereas B is easy to set / change from job to job

Resultant maths...

ACFM = RawCFM + FlowCal offset + Baseline Offset (A) +  Leak Cal Offset (B)

The end user can use all or none of these. They can also manually enter in any value and for any reason into the baseline offset field. It gives the system flexibility and the end user the opportunity to use the bench on ways that we may not have considered.

black-top, 2024-10-30:
I agree, that will be the most universal solution.
Just small detail, the corrections  probably division from raw flow, not addition.

And for the leak procedure itself,    the pump surging probably can be fixed with a simple manual valve near the pump, to create a controlled leak,  to stabilize pump running and depression, so all air will flow from the "controlled leak valve" and only leaks before MAF will be registered ass flow if any leak will be induced to the system.

DeeEmm, 2024-10-30:
I think that one we start to look at closed loop motor / bleed valve control this issue will not be so much of a problem

danielerpl, 2024-10-30:
@DeeEmm thanks for adding me in this discussion.
Now I got it..... I was testing the bench with your step by step procedure explained, but was not working the function for the leak test.
I tried also the calibration and apparently it's working fine at the moment. I am not sure if the value it's correct but the result value it's. pretty closed to the expected, described on the PTS orifices I am using.
When you need some test let me know!!

DeeEmm, 2024-10-31:
OK so code updated to reflect methodology discussed above. It is worth noting that there is an allowance for reverse flow, but I am unable to test this on my setup at present.

Both the flow cal and leak cal buttons work - both will save the relevant flow value to to the appropriate settings.

Maths for flow calibration and leak calibration values as follows...

```
sensorVal.FlowCFM = _calculations.convertFlow(sensorVal.FlowKGH) + calVal.flow_offset - calVal.leak_cal_baseline - calVal.leak_cal_offset;
```

So as you can see you can use both the baseline and leak cal values independently.

There is no longer any kind of calibration test. The code for the automatic test along with the settings has been removed. If you want to validate the leak test you need to compare the numbers manually.

I will however add in the additional pane to show the differential between current flow value and leak test value.

black-top, 2024-10-31:
If I understand correctly, the total corrections value should be subtracted from the flow number ?
Because any leak will give additional flow, but If in some case orifice will flow less than should, I think negative number should be written in calibration. So I think it should be like this:

`sensorVal.FlowCFM = _calculations.convertFlow(sensorVal.FlowKGH) - ( calVal.flow_offset + calVal.leak_cal_baseline + calVal.leak_cal_offset);`

KirikauKiwi, 2024-11-01:
Another very useful tweak!!!

> So...

>Baseline Offset (A)
>Leak Cal val (B)

I would think of them as Reference Calibration & Trim offset respectively.

I can see it being very useful for the reasons already mention along with if you were trying to verify a cylinder head that has been worked on already and is claimed for example to flow X? CFM @ 28" and 500 thou lift and you upon running it up on your DIYFB it flow something different. You could then use the offset to make it match and then verify the cylinder head at different lift to see if your data matches their data, I guess allowing for the variation between their bench and yours!!! or it might possibly come in handy as a BS detector.

DeeEmm, 2024-11-01:
Funnily enough I'm actually adding an additional 'user' defined temporary offset value. Call it option (C).

It can be any flow target you want. The target CFM of a head, or a manifold or maybe an object that you have to test a gazillion of, or like you say just an offset so that your bench can match someone else's baseline. I'm sure there are a bunch of other interesting ways to use it. That way we don't need to fudge with the calibration values.

DeeEmm, 2024-11-01:
> I would think of them as Reference Calibration & Trim offset respectively.

The terminology of these things is definitely something that is worth considering.

This is where I am at with the additional tile for viewing the flow differentials...

https://github.com/user-attachments/assets/3488b180-16fb-4792-9904-9e9144ade54a

I've had to reduce the click target to the tile title to allow me to add an additional target to cycle through the flow target types...

It cycles through Baseline > Baseline+Leak > User and back again

I did this to avoid having additional buttons on the GUI and risk things getting too clunky and cluttered.

DeeEmm, 2024-11-01:
OK. Got the user differential flow target working...

https://github.com/user-attachments/assets/bdb6debc-a847-46af-8d4c-952a218498a1

The value is saved with in the calibration file and so will persist across power cycles.

As mentioned previously and elsewhere , the UI still needs a way to save the current state so that it retains the previous user view. I have some ideas on this that does not involve cookies, but that is still a way down the list.

I'll finish up testing and push the changes to master so you you guys can have a play.

If everyone is happy with the leak test and flow calibration stuff I'm keen to get it packaged up as the RC8 release

DeeEmm, 2024-11-01:
ok. just to clarify...

we create the raw cfm value from the mass flow...

```
          sensorVal.FlowKGH = _sensors.getMafFlow();
          sensorVal.FlowCFMraw = _calculations.convertFlow(sensorVal.FlowKGH);
```

we then apply the leak and flow offsets...

```
        // Apply Flow calibration and leak offsets
        sensorVal.FlowCFM = sensorVal.FlowCFMraw  - calVal.leak_cal_baseline - calVal.leak_cal_offset  - calVal.flow_offset;
```

This gives us the main flow value that is displayed in the GUI

The flow differential targets are created like this...

```
        case USERTARGET:
          sensorVal.FDiff = sensorVal.FlowCFM - calVal.user_offset;

        case BASELINE:
          sensorVal.FDiff = sensorVal.FlowCFMraw - calVal.flow_offset - calVal.leak_cal_baseline;

        case BASELINE_LEAK :
          sensorVal.FDiff = sensorVal.FlowCFMraw - calVal.flow_offset - calVal.leak_cal_baseline - calVal.leak_cal_offset;
        
```

Note that the baseline differentials are based on the raw flow value. This avoids applying the offset twice.

So for example if we want to do a leak test, we set the bench up in the same way that we originally undertook  the leak calibration (for example blocked off with a plate on the test surface). We can then select the 'Baseline' Flow differential. The resultant value should read zero.

This assumes / requires a few things...

- For initial calibration all offsets are zeroed
- First thing to be calibrated is leak test of bench with seal (or orifice) placed at test surface. This the baseline value
- Next we perform the flow calibration using the test orifice

Later, when we want to calibrate a job for leaks...

- job is placed on test surface
- valves are closed + plugs installed
- inlet ports is sealed with plate (or small orifice)
- This is the leak calibration value (or trim offset as KirikauKiwi describes it)

Note this value needs to be zeroed down for each job as it will change from job-to-job.

This is the basic functionality and flow. Agree that terminology definitely needs to be revised to avoid creating confusion / ambiguity. Would be good to align with language used by other manufacturers.

There is a caveat with this and one that I've gone through a few iterations of code and procedure with.

It is possible to flow test and leak test in any order.

```
sensorVal.FlowCFM = sensorVal.FlowCFMraw  - calVal.leak_cal_baseline - calVal.leak_cal_offset  - calVal.flow_offset;
```

Not we do not differentiate between the flow calibration value or the leak calibration value. The are all applied at the same time.

This means that if we first leak test. Then when we do the flow test, the value we store already has the leak test offset applied.

Conversely, if we do the flow test first, and then the leak test, the resultant value will be incorrect.

There is no real way to pick this up without further complicating the code. So at this point in time, it is reliant on people following the correct procedure to calibrate. But it is possible to calibrate in the wrong order and create an error of the magnitude of the leak test.

DeeEmm, 2024-11-01:
Okay. All changes now pushed to master.

Please test / review / critique and get back to me

black-top, 2024-11-01:
I did some more testing,  everything is working as intended,  I don't see any new issues.
BTW, I see now reverse flow when the pump is surging, so it looks like this code is working too.

danielerpl, 2024-11-01:
It is possible to have a step by step procedure to make the leak test and calibration test? We can put it in the wiki section. Should be very helpful bevause a wrong leak test or calibration, can make a wrong result value

DeeEmm, 2024-11-02:
Hi Daniel.

Yes we do already have the flow and leak calibration procedures in the WIKI, however I do need to update them as we have added the additional baseline values to the code.

https://github.com/DeeEmm/DIY-Flow-Bench/wiki/Calibration

I update it shortly

danielerpl, 2024-11-02:
Perfect! I got it ✌🏼
Sorry if i didn’t see it before, is my bad 😉
I was looking for it but i didn’t found it.

have you tried the functionality to update the index.html?
i was investigating on it yesterday and the first time you upload the file it works welle, but when you use the delete or file’s upload functionality nothing is working.
Also in the log nothing is displayed.
It’s like the “data” info from the html form it’s not valorized as expected
I continue to make some test to understand where is the problem

DeeEmm, 2024-11-02:
All good, just finished updating it.

Yes the file upload works perfectly here. Are you using the current versions for both the main code and index.html (in 'data' folder)?

https://github.com/user-attachments/assets/7c67dc32-a21c-4488-8a79-191f7f1ad592

If you cannot upload the index.html via the browser then you will need to upload it via VScode

DeeEmm, 2024-11-02:
> It’s like the “data” info from the html form it’s not valorized as expected

Can you post a screen shot?

KirikauKiwi, 2024-11-03:
I don't have a MAF sensor connected to my DIYFB currently, I am curious to know that with an otherwise working system sitting statically why I would have a flow difference being displayed. I would assume that a static system should read zero?

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

This also lead me to the configuration page to test the offsets etc, I intuitively entered a negative number as I wanted the reading to be lower than displayed it added it to what was already displayed.
What feels like a normal convention for everyone, for me it would be my preference to enter a negative number if I wanted to reduced the offset, it would be good to get a general consensus on this.

DeeEmm, 2024-11-03:
Could be a couple of things...

If you take a look at the configuration tab, you will note that there  are settings for minimum flow + pressure. Normally these are set to 1, which means that for all flow values below this threshold, the flow value shown on the GUI will be zeroed down.

There will always be some small +/- fluctuation in value around zero. It will never be perfectly 0.0. So the threshold values act as a filter.

Without a MAF the input value is just floating, so you will generally see some kind of value there. You can try to connect up a potentiometer to mimic the MAF. Using a large value pot like 10k, hook up the outside legs to +5v and GND and connect the middle wiper terminal to the MAF input.

BTW, the zero threshold code may be the reason the flow field does not show -ve values. i.e. it is filtering all values < threshold

black-top, 2024-11-03:
I repeated the same test in a few days, and the results looks good. CD flows in 1-2CFM with same calibrations. For cylinder head flow, there are the same problems that we were discussing about filtering. The value fluctuates in the 1–5 CFM range and sometimes in the 5–10 CFM range (with cycle average filter). Maybe turbulence from the cylinder head influences that, but my MAF is far from the cylinder head and 4 or 5  90deg bends, so it should be quite laminar.  I was trying to write down minimum values, because it looks like it repeats most accurately.
With these results, I think it will be a good option to have at settings to select simple number rounding to a whole number, because the system will probably never be that stable to see less than 1CFM with MAF setup.
Also, the"Average Minimum" filter may be worth trying.

DeeEmm, 2024-11-03:
I am happy to look at trying some different filters.  I think that reading stability is a necessary part of V2, even if it is not specifically written.

The output can be truncated by modifying the following line...

javascript.js approx line 54

```
            document.getElementById(key).innerHTML = myObj[key].toFixed(2);
```

change it to

```
            document.getElementById(key).innerHTML = myObj[key].toFixed(0);
```

Not sure how to integrate this programmatically as it affects the javascript source file. Essentially the javascript file would need to modify itself.

I've made a quick hack to add a couple of variables to the top of the javascript.js file so that it is at least easy to change. But the file will need to be recompiled by gulp. You can also do a search-and-replace in the resultant index.html file within the data folder

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

```
var decimalPlacesFlow = 0;
var decimalPlaces = 1;
```

decimalPlacesFlow relates to all flow values including the differential, whereas decimalPlaces relates to all other values

```
if (key === 'FLOW' || key === 'AFLOW' || key === 'MFLOW' || key === 'FDIFF'){
  document.getElementById(key).innerHTML = myObj[key].toFixed(decimalPlacesFlow);
} else {
  document.getElementById(key).innerHTML = myObj[key].toFixed(decimalPlaces);
}
```

DeeEmm, 2024-11-03:
Okay. so after some experimenting it looks like I can use templating variables in the javascript file which means we can pull these values out into the configuration.

I have also been playing around with the round function to allow us to round to nearest 0.5cfm

```
round(x * 2.0) / 2.0;
```

I will package up this up within the configuration settings tab as a new group of settings under the filters

Round to nearest integer
Round to nearest 0.5
Decimal places for flow variables 0/1/2
Decimal places for everything else 0/1/2

black-top, 2024-11-03:
Tomorrow I will try to edit the index file, and test it on the flow bench, but I'm not sure how to compile the javascript.js file after editing.

DeeEmm, 2024-11-03:
To 'compile' the Web UI files, we use GULP. This basically minifies and joins the HTML, Javascript and CSS together in a single GZipped file. It's not really 'compiling' in the true sense. In fact at present I have disabled the minification and GZip as we are in development and we do not have a space issue on SPIFFS. So the co-joined file is currently both humanly readable and easily editable.

You can also just upload the index.html, javascript.js and style.css files to SPIFFS separately via the file interface in the GUI and the code will still work. I've done this to make it easier for anyone who wants to play around with the GUI files.

There is some info in the WIKI on the Web UI files and GULP...

https://github.com/DeeEmm/DIY-Flow-Bench/wiki/WEB-UI

DeeEmm, 2024-11-04:
Added rounding / truncation to issue #180

DeeEmm, 2024-11-04:
> I repeated the same test in a few days, and the results looks good. CD flows in 1-2CFM with
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

Thread 179 (2024-10-22):

[BUG] Incorrect flow calibration data

DeeEmm, 2024-10-22:
**Software Version**
- RELEASE (e.g. V.2.0-RC.7)
- BUILD_NUMBER (e.g. Build 31012301)

**Describe the bug**
Incorrect flow calibration

Reported by @back-top

Review and update

DeeEmm, 2024-10-22:
Incorrect comparison in Calibration::setFlowOffset()

Changed to

  // compare it to the calibrated orifice to generate our flow offset
  double flowCalibrationOffset = convertedOrificeFlowCFM - config.cal_flow_rate;

DeeEmm, 2024-10-22:
uploaded to master.

@black-top can you test and see if this fixes the issue

DeeEmm, 2024-10-22:
Closed by accident

DeeEmm, 2024-10-23:
The difference in reading may be due to the flow calibration data being previously incorrect.

NOTE: The calibration data for the orifice needs to be entered first for the calibration to work. (flow and pressure).

Then, when you calibrate, if all goes well the offset will be zero - as your bench will be flowing exactly the same as the calibration orifice recorded flow value at the same pressure. If for some reason there is a deviation, it will record the difference as the calibration offset.

For example. Orifice flows 12cfm, but the bench reads 11cfm. The value 1 is recorded as the calibration offset. Then each subsequent time that the bench is used, it will always add 1cfm to the reading to compensate for the error.

It should be noted that there is both pressure and vacuum calibration offsets. The bench will determine if it is seeing pressure or vacuum and when you calibrate save the offset to the appropriate variable.

With regards to the value not changing, I suspect that the issue may be the same as #178 and the calibration file read / write.

DeeEmm, 2024-10-23:
Is it possible to turn debugging on and then check the serial monitor to see if you get the message "Writing to cal.json file..." when you calibrate.

Also, you should be able to download the calibration file using the file browser in the Web GUI. Look for file "cal.json".

You can open the file and view it in a text editor. It is in JSON format but pretty easy to read. You should be able to tell if the file is being updated and what values are being saved. This will hopefully tell us if it is a read issue or a write issue.

DeeEmm, 2024-10-23:
The flow offset looks like it could be valid. You can also try to edit the file and then upload it via the GUI. Set all values to zero. Alternatively you can just delete the file and it will be recreated using the default data from structs.h

This way we can tell what, if anything, is being written.

black-top, 2024-10-23:
Yes, I just deleted the file, and it is fresh for new calibration.
If I see in this case 17CFM and the CD should flow 14.4CFM, and the depression is set stable with vfd at 10'h2o ,  doesn't offset value should be 2.6?

By the way, for the leak test, I pressure tested my system, and it is leak-free, but when I seal the system, my pump starts to oscillate, and I get 2-5cfm readings, I think this is because the pump sucks air from the exhaust side when it does that.

DeeEmm, 2024-10-23:
The oscillations are likely a characteristic of the system. My guess is that the air into the system is restricted, so vacuum builds until it exceeds the pumps limit, at which point the is slip which causes reverse flow bypassing the rotors. I would imagine that this is also coupled with oscillations in the motor speed / torque, although they may be too small to notice without measurement.

I think that the leak test needs a bit of a rethink. I'm not convinced that the current philosophy is the best approach for a MAF system.

With a traditional bench the reference orifice separates the vac source from the measurement chamber. As such we can set the vac source to the desired pressure (pRef) independently of the rest of the system. We then then look at the pressure of the measurement chamber in isolation to see if there are any leaks in the setup (pDiff) by comparing the value against that achieved against a dead head. This is achieved with a small orifice limiting the system pressure but giving an accurate reference pressure.

With the MAF system I am unsure if we are able to replicate this. There is no seperation between the reference pressure and the system pressure, it is all one. If there is a leak, then the system will simply compensate by increasing the vacuum until we read the same reference pressure, essentially nullifying the test.

When I initially wrote this I was trying to replicate the superflow leak test, but I now realise that I had not fully considered the differences between the systems.

The reason that it was commented out is that it was still a work in progress. as it remains unfinished on the roadmap ( #125 )

So we may need to go back to the drawing board...

This is the Superflow leak test instructions...

`
--------------------------------------------------------
5.2.5 Leakage
The flowbench measures all airflow between the calibrated range orifice and the open end of the device
under test, including air leakage anywhere in the path. This leakage can be measured and compensated
for in the FlowCom flow readings.
1. Close all normal openings on the test device (close the valves on a cylinder head, block off the end of a
filter or muffler, etc.).
2. Set the flowbench to range #1 (see section "5.2.1 Setting the Flow Direction and Range" on page
30).
3. Enter a leakage value of zero:
3a. Press TEST button ( F3 ) on the FlowCom panel. The Test menu appears.
3b. Use the UP or DOWN ARROW buttons to scroll to Leakage. Press ENTER button ( leakage rate screen appears.
). The Enter
4. 5. 6. 7. 8. 3c. Using the numeric keypad, press 0, then press ENTER.
3d. Use the UP or DOWN ARROW buttons to scroll to the desired units of measurement. This must
match the units used in the normal testing.
3e. Press ENTER to return to the previous screen.
3f. Press any of the F keys to return to the current data screen.
Set the Test Pressure to the desired value (see section "5.2.2 Setting the Test Pressure" on page
32).
Press the green motor ( ) button to turn ON the flowbench motors.
Allow the flowbench reading to stabilize, and note the flow rate.
Turn the flowbench motors OFF.
Repeat step 3 and enter the leakage value.
--------------------------------------------------------
`

When the superflow bench measures flow, it is simply the comparison between pRef and pDiff, which it is able to do as these tap points sit either side of the orifice plate. (differential)

So I think that we need a different approach.

Using the MAF sensor is the obvious choice (we currently use pRef). It stands to reason that if there is no flow in the system, we should see zero flow. I was initially thinking that this may not be accurate enough, as most MAF will struggle to measure down to such small values, but then after reading the Superflow instructions, which only compensates in steps of 1 cfm. I realised that this does not matter...

- If the MAF sensor is able to detect flow, it can be used to provide the compensation figure.
- If it is unable to measure sub cfm values, then the deviation is trivial and can safely be ignored.
- If the deviation is large, then the user needs to address the leak and re-test.
- If the MAF sensor cannot measure larger cfm values to order of say 1-5cfm (or more), then this will surely means that the - - MAF is not accurate enough for use in this type of application.

So. I think that the current leak test code and process should be changed.

- Leak test performed at very low pRef (need to determine what value to recommend)
- Leak test uses MAF cfm value
- At point where pump regulation is controlled by the ECU, pRef is automatically controlled (Perform Leak Test button action)
- Leak Test compensation field to be added, which saves measures cfm value to offset all subsequent measurements

Thoughts?

black-top, 2024-10-24:
I agree with most of the thoughts, but for leak test pressure, I think we should use same depression as the measurement (in most cases, 28"h20), because the higher the depression, the higher the chance for leaks and the leak value itself, so if a leak test is performed at the same depression as the measurements, it should be close to the reality. At low pressures, I get a 0 flow value all the time, but even with a needle-sized hole, I can see some flow.  The problem in my case is the pump oscillations  at higher pressures with a sealed system,  but maybe active control can be tuned to avoid that,  maybe with PID? It can also oscillate even more with PID...
Other thought, may be the flow offset calibration is enough with the MAF setup for both leak and flow offset?  The leakage is important only before the MAF sensor, that is why I was trying to put it close to the cylinder head, but turbulent airflow was the problem for reading fluctuations, but still if the leak is after the MAF sensor, it really does not matter even if the leak is hi if the pump sufficient to keep the set depression.
So in conclusion, may be flow offset will be sufficient for a MAF  style bench, and may be different orifices can be used for these tests, for example, a small hole orifice for leak test offset and a CD or saw blade for main calibration,  to get accurate small readings for leak tests.
Another thing that might help in my pump oscillation situation is that audi MAF has the ability to measure reverse flow ( I think its 0-1V range is reverse flow ant 1-5V is forward flow) so maybe it can be used to compensate for oscillations.

DeeEmm, 2024-10-24:
I did some digging and found that Superflow use 25" to do their leak test. However, they are also measuring on the smallest measurement range. i.e. the smallest orifice. Our test is essentially using the largest orifice. i.e. system wide open. So it is maybe not apples and apples.

Ironically, whilst digging I found the hyperflow instructions. They have a novel way of testing. This involves sucking air from a barbed fitting using your mouth and a length of tube. You do this until the manometer deflects a certain amount. You then put your finger on the end of the tube. If the manometer stays at the same level after a period of time, then there are no leaks. I assume that the system is completely sealed to do this. In this case the pressure is largely immaterial. A small vacuum can easily identify a leak in the system., even a pin hole leak. But this is a different principle to the one we are using as we have an open system.

When I was digging I also found that many Superflow users have a permanent leak offset value to the value of 3cfm, which to me does not sound right.  This could be indicative that the method itself is flawed. This differential could even be a result of the bench design. What I find surprising is that users just punched the value into their flow com and not think any more about it, simply because that's what the instructions tell them. One commenter suggested that the leaks came from the orifice plate mechanism, which seems entirely possible. But how on earth can you trust any measurement that the bench produces if it starts off with an in built error of 3cfm. That's just madness. One commentator stated that when sharing results, the differences they see from bench to bench for the same heads could be because some people simply do not bother to leak test. He then  went on to say that as long as it was repeatable on his bench then all was good. This seems to be the common consensus, however when someone states that, all I hear is that the accuracy is bunk.

Testing at the normal measurement depression would eliminate any non linearity in the leak as pRef increased. So this does make the most sense. I think that the test pressure will also be different from bench to bench, depending on what vac source people are using. I think that this is the most reasonable way to document the test. - Basically use the reference pressure you would normally use.

PID control is definitely on the roadmap, but just not at this point.

Are the oscillations any better if you test at 25"? Is there a reason that Superflow leak test at 25"? Is it to overcome the oscillations?

DeeEmm, 2024-10-24:
Also... yes I can add in mode to the smoothing.

DeeEmm, 2024-10-24:
Added #180

black-top, 2024-10-24:
If the tool is not repeatable, it's driving me crazy. That is why I'm trying to figure out the stability issues.

25"h2o was the standard before 28"h2o,so  maybe the reason is that ?

The higher depression don't help much with oscillations, it just changes oscillation frequencies and I can feel at pump exhaust that air pulsates in both directions, so I think that concludes that it sucks air back in the system from exhaust side.    It stabilizes more at over 100"h2o, but I think it is not worth chasing this problem at this stage.

I was testing my system with a hand held vacuum pump tester, but it was difficult to seal the exhaust side, but it is because of my construction, so it's kind of a similar procedure.

So I did leakage testing with compressed air and soupy water. So my system is leak-free. That is why I think that flow calibration should be good enough for now.

Probably a small orifice at the normal measurement depression for the "leak test" and a regular size orifice for normal flow offset will be sufficient solution for now.

DeeEmm, 2024-10-24:
The 'leak' test is not really testing the physical system. That should only really need to be performed once. After it is built. Once it is tested, there should be no need to re-test the system unless there is some damage. Although it is a good idea to re-do this test periodically. Your initial test with soapy water and compressed air is good enough. You have proven your construction is good.

The leak test is really to test the head is sealed to the bench.  So ideally it needs to be done for each job.

- Initially you take a baseline reading, with the bench blanked off, which should be zero flow
- Then each time you set a job up, you blank off the inlet port of the head and re-test the flow.
- It should also read zero

To do this you do not really need a 'leak-test' function. After all you are just performing a regular flow test. The expected result is that the flow should be zero.

The leak test calibration (offset) is only if you find a leak or register flow and you want to normalise this leaky value as zero. This could also be a manually inputted field  in the configuration settings

I agree, that for a MAF based system with sealed and glued manifolds, there is very little value in leak testing the system and recording an offset. Simply as the system itself should not leak. If you have a leaky MAF system, then there are some serious issues with it.

Also as you pointed out, leaks downstream of the MAF are irrelevent. Which essentially excludes any leaks in the vacuum source.

Reality is that you can pretty much negate the need for the leak test if you are satisfied that the head is sealed to the bench properly. This could be by simple procedure, or by using some sealing method that satisfies your confidence.

However as this is a generic solution, I do somehow need to cater for a leak test for other scenarios, such as a retrofit to a leaky Superflow bench lol.

On reflection I think that the best solution might be to have a field under the configuration tab that can be manually updated. As such leak test calibration then becomes a manual process. The leak test itself is just a regular test. The offset is just a way to apply a fixed offset to all measured values

With regards to using an orifice to leak test. It could possibly work...

- Perform calibration offset measurement - this records actual flow value of orifice
- Fit head to bench and instead of closing off inlet port, fit test orifice to inlet port
- Provided that test orifice flows less than the port. flow value should not be able to exceed the calibrated value
- Any increase in flow over the recorded flow value, means that there is a leak
- Again this can be performed as a regular flow test. No need for a specific leak test. unless we want to record a permanent offset

As an aside. My original idea with the leak test was to give a visual indication that the system failed the test by flashing the screen red. Similarly when the bench started to approach is limits the screen would flash red. This behaviour has not been implemented at this stage, but visual feedback would be a great thing as it simplifies things.

Thinking further on this, perhaps there is some value in adding some additional tiles on the GUI that display a differential value.  This could be a manual value / target, or simply the calibration orifice flow value.

This way it would be trivial to call up the orifice flow value and see what the current differential is. No need to navigate away from the main page. The leak test process then becomes...

- Fit head to bench and instead of closing off inlet port, fit test orifice to inlet port
- Click through tiles in GUI until calibration differential is displayed.
- Tile shows difference between orifice calibrated flow value and current flow value

- Alternate differential tiles show difference between fixed manual value and current flow / pressure etc
- This way we can add in additional test orifices or targets. Need to flow at leat 232cfm - add this as the target and it will show you how many cfm difference you are at.

black-top, 2024-10-24:
Yes I agree and configuration tab that can be manually updated is also good solution for leak value and the procedure will depend on flow bench style.

With small orifice will solve problem with pump oscilation, because it will have enough flow to keep it working.

Now probably the main question what is the problem with flow calibration and how to make it work properly, because writing data to the file looks like working as should.

black-top, 2024-10-25:
Can you add MAF (KG_H or MG_S) readings to main data screen? I saw it at serial monitor, but It will be good reference to see in main page and maybe to datalog to data file together with CFM@ lift.
I think the more data logged, the better. Maybe in the future it will be a good option to have at settings for selecting what data can be captured in the datalog file, for example, all environmental data, MAF kg/h, correction factors and etc.

DeeEmm, 2024-10-25:
Yes, this is actually on the roadmap. A more granular data logging. I originally put this off until the validation testing was done, but happy to take a look at it.

I think at this stage of the project, even with validation still in process it would be good to start looking towards the next version. It has been a long time since an update so it would be good to make some progress.

black-top, 2024-10-25:
Thank you. That will give better ability for troubleshooting, and it will be interesting to compare actual mass flow with cfm readings.

DeeEmm, 2024-10-25:
Ultimately the MAF data is the raw data and so the most accurate. If everyone was familiar with MAF flow then there would be no need for CFM readings and flow conversion. It's a bit like comparing %AFR with LAMBDA in tuning. Most people are familiar with %AFR so that's what is generally used, but LAMBDA is the better way to measure as it is fuel agnostic, but it requires a shift in thinking and reconfiguration of tuning software to work in LAMBDA.

If we record MAF + Temp + Baro + Humidity then we can always calculate the CFM. This is the best way to data log - with raw date. Essentially because CFM is calculated, it is a very vulnerable measurement. If any of the four measurements that it relies on are inaccurate then the end result is inaccurate too.

black-top, 2024-10-25:
Yes, I agree, but I think the calculated CFM value should be logged together with  MAF + Temp + Baro + Humidity, because it will be much quicker to compare just by looking at the data and seeing if there are any issues, than calculating the CFM afterward.  I think data capacity or file size should not be a problem, especially if data is saved to a PC after every test, even without SD card support.

DeeEmm, 2024-10-25:
Absolutely. The data size is trivial TBH.

I only mentioned this to state the value of the data.

We cannot get rid of CFM data as this is what 99% of people understand.

black-top, 2024-10-25:
Yes, that is true.

DeeEmm, 2024-10-26:
OK, So I have been doing come testing. Issue is half fixed. I've updated the current master.

Can do both flow cal and leak cal from the serial monitor. File is being written correctly. Values are being saved.

However, in my tests here, the calibration routines are not being called from the buttons in the GUI.  I suspect that it is either a javascript issue, or possible a bug within webserver.cpp

Need to do more testing to track it down.

black-top, 2024-10-26:
Good news! Do you need any additional testing from me, or can I wait for the full fix update?

DeeEmm, 2024-10-26:
OK, so hopefully should be fixed now. The Hardware::benchIsRunning method was tripping up on negative numbers which was restricting the FlowCal method from running.

I've added the fix to master.

Yes, if you can test to see if it behaves as expected, that would be great. There may still be an issue determining positive and negative flow.  Just need to make sure that the relevant values are gong to the correct variables

DeeEmm, 2024-10-26:
BTW, the bench has to be running before the calibration functions can be used.

black-top, 2024-10-26:
I should press start bench, or just flow should be present? I don't use output control from the board, so I don't press start or stop flow bench.

black-top, 2024-10-26:
Ok, so calibrations look like they are working, but the flow value I think is still wrong.
{
  "FLOW_OFFSET": 0.134765275,
  "LEAK_CAL_VAC_VAL": 0,
  "LEAK_CAL_PRESS_VAL": 14.83010745
}

I see reading about 17-18CFM, and after calibration, looks like same value,
 I expect to see close to 14.40 .

DeeEmm, 2024-10-26:
It looks at pRef to determine if the bench is running.

There's no need to press start / stop if you are not using that functionality.

I should probably give the end user the option to hide those buttons

black-top, 2024-10-26:
Ok, so calibrations look like they are working, but the flow value I think is still wrong.
{
  "FLOW_OFFSET": 0.134765275,
  "LEAK_CAL_VAC_VAL": 0,
  "LEAK_CAL_PRESS_VAL": 14.83010745
}

I see reading about 17-18CFM, and after calibration, looks like same value,
 I expect to see close to 14.40 .

One small thing, when I press calibrate, I don't see actual values, so sometimes it is 0 and some time it is let say 2, because of fluctuations, so maybe the real time value on the settings page will be beneficial to "catch" value?

DeeEmm, 2024-10-27:
Yes I would also expect the same. The flow value should equal the calibrated value. Looks like I have some further digging to do.

When you say that you don't see actual values. What values are you referring to? Where? and what would you like to see?

If you can bullet point a sequence that makes sense to you, we can look at how to integrate that.

black-top, 2024-10-27:
At the settings page, I don't see any live measured data, so when I press "calibrate leak test" or "calibrate flow offset," I do it blindly, and if the value, for example, for a leak test is fluctuating from 0 to 2CFM, sometimes my calibration value can be 0 and sometimes 2 or something in between, so I can't "catch" value.  So I don't know what is better, to be able to set calibration values manually or see live data at config page and try to "catch" the right value.

DeeEmm, 2024-10-27:
Ahh gotcha. Yes, would make more sense to be able to see what is happening. The easiest solution is to move the calibration buttons onto the main tab. (Done and committed as build 24102701 ). However this is not without some risk as now they are vulnerable to being accidentally pressed.

I think that I need to hide the buttons so that a secondary action is required to calibrate. I'll figure something out.

DeeEmm, 2024-10-27:
OK. I've hidden the calibration buttons inside a modal window. To display the modal dialog, simply double click the status message. The modal dialog displays over the main page so that you can still see the data values. Hopefully this works for all screen sizes / resolutions.

Will update the WIKI to include revised instructions

DeeEmm, 2024-10-27:
Still need to figure out why the calibration / flow values are different to expected

black-top, 2024-10-27:
I can't do testing today, but it looks like that small value ""FLOW_OFFSET": 0.134765275," is not a flow difference value but a depression difference value. Maybe variables got mixed up ?

DeeEmm, 2024-10-27:
Ahh okay, will take a look. Gives me a place to start

KirikauKiwi, 2024-10-28:
Not sure if I have got this correct but looking at the code in the calibration .cpp

```
// convert the calibration orifice flow value  to our current ref pressure
  double convertedOrificeFlowCFM = _calculations.convertFlowDepression(config.cal_ref_press, RefPressure,  config.cal_flow_rate);

  // compare it to the measured flow to generate our flow offset
  double flowCalibrationOffset = convertedOrificeFlowCFM - MafFlowCFM;
```
and from what @black-top has written previously that he is getting 17-18CFM @ 10" should the flowCalibrationOffset calculation just be flowCalibrationOffset = config.cal_flow_rate - MafFlowCFM as this would directly give you the expected offset of -2.6CFM since the testing of the test orifice has been done at 10".
I see with the current calculation the test orifice would have to have the depression adjusted to get the flow rate to match 14.4CFM which would give you a different depression reading this would then stop the sqrt of 1 from happening, which I think might be the problem that @black-top is experiencing.

DeeEmm, 2024-10-28:
Yes, Just looking at this same thing.

The flow depression conversion is to allow people to calibrate at a different reference pressure than their orifice is calibrated at. It is a trivial conversion, but I did wonder if it is causing an issue, simply as I cannot see that it is anything else.

If the two reference pressures were the same the equation would be negated. The square root of 1 is 1, and if the pressure ratio is also 1 then the net effect is that the value is unchanged. But, whist the code tests for the value being equal to bypass the conversion, it is unlikely that it ever will be exactly equal so the conversion will likely be made each time.

I don't _think_ that this is the issue, but it is trivial to remove this piece of code from the calibration process. I guess that the end users could actually do this conversion outside of the app and then enter the resultant value into the calibration orifice fields as part of the initial set up. i.e. they obtain a calibration orifice that is calibrated at 15" but their bench can only achieve 12" The convert these using a calculator / excel / pen and paper, and then input the converted values into the configuration params.

It should be noted that the convertFlowDepression conversion is also used to convert the CFM displayed value on the main page. (converted CFM) This gives a live readout of the flow value at an alternate reference pressure.

I'm just working through where else this is applied, maybe we are doubling down on this conversion (don't think so, but hey?)

DeeEmm, 2024-10-28:
Ahh yes also see what you are saying RE the orifice test pressure being different to the actual test pressure.

The most accurate way would be for the test to be carried out at the orifice test pressure and remove the conversion. Ideally the end user should create / obtain a test orifice that has been measured at the test pressure they would normally run the bench at.

KirikauKiwi, 2024-10-28:
I think it would work either way that the calibration offset is just either a difference between the expected flow and the measured flow.
flowCalibrationOffset = config.cal_flow_rate - MafFlowCFM

Or you adjust the depression to match the expected flow rate during the calibration procedure  in this instance with the test orifice being a CD with 14.4CFM

The second method would work without any code modifications, just a change to the calibration method.

DeeEmm, 2024-10-28:
OK. So I've updated the way that flow calibration is undertaken, and removed the code for calibrating at a difference reference pressure to the calibrated orifice. Now the calibration must be done at orifices calibrated test pressure. I think it is cleaner and still gives people the option to manually transpose the calibrated orifice data if they want.

There's also a bunch of other updates in with this commit the main one being a change to the partition schema as well as a bug fix for initially uploading the index.html file. So, you will need to build and upload the the filesystem image after updating. (which is how I discovered the issue with index.html).

My tests indicate that flow calibration is now behaving in line with expectations, but this is only bench testing and not with vac source, so not a real-world test.

DeeEmm, 2024-10-28:
> Can you add MAF (KG_H or MG_S) readings to main data screen?

New tile added - click through on the flow display and you will see MAF data

black-top, 2024-10-28:
I tested the latest code, so now the calibration offset value is correct, but after calibration, the ACFM value stays the same, so it looks like the offset is not subtracted.

DeeEmm, 2024-10-28:
The threshold is only for the test, not the calibration.

The calibrated value is whatever the value is when the operator presses the button.

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

Thread 180 (2024-10-24):

[FEATURE REQUEST] Add additional flow smoothing filters

DeeEmm, 2024-10-24:
Include 'MODE' for averaging function for flow value smoothing

Suggested by @black-top

DeeEmm, 2024-10-28:
I've added a data filter drop down to the configuration tab in latest commit

So far all that is functional is Rolling Median smoothing, but it is written to include Cyclical Average and Mode, but the maths for those needs to be written.

DeeEmm, 2024-10-29:
Discussion relating to Mode filtering in flow calibration thread

https://github.com/DeeEmm/DIY-Flow-Bench/issues/179#issuecomment-2443394451

DeeEmm, 2024-10-29:
I'm going to assign this target to the V3 release, however it will likely be possible to squeeze additional filters in between now and then as the main core filter management code is now in place.

Potential to include filters to truncate and then use standard deviation methods...

Truncated Median
Truncated Average
Truncated Mode

We can also consider removing larger deviants from the data set...

change > x cfm

In theory if we add a number of (different) filters then hopefully each end user will find one that is suitable for their setup.

DeeEmm, 2024-11-04:
From discussion in issue https://github.com/DeeEmm/DIY-Flow-Bench/issues/178#issuecomment-2453430005

Additional flow value manipulation using truncation and rounding...

Changes to javascript.js to truncate displayed values...

```
var decimalPlacesFlow = 0;
var decimalPlaces = 1;
```
```
if (key === 'FLOW' || key === 'AFLOW' || key === 'MFLOW' || key === 'FDIFF'){
  document.getElementById(key).innerHTML = myObj[key].toFixed(decimalPlacesFlow);
} else {
  document.getElementById(key).innerHTML = myObj[key].toFixed(decimalPlaces);
}
```

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

DeeEmm, 2024-11-04:
@black-top from https://github.com/DeeEmm/DIY-Flow-Bench/issues/178#issuecomment-2453379664

> I repeated the same test in a few days, and the results looks good. CD flows in 1-2CFM with same calibrations. For cylinder head flow, there are the same problems that we were discussing about filtering. The value fluctuates in the 1–5 CFM range and sometimes in the 5–10 CFM range (with cycle average filter). Maybe turbulence from the cylinder head influences that, but my MAF is far from the cylinder head and 4 or 5 90deg bends, so it should be quite laminar. I was trying to write down minimum values, because it looks like it repeats most accurately. With these results, I think it will be a good option to have at settings to select simple number rounding to a whole number, because the system will probably never be that stable to see less than 1CFM with MAF setup. Also, the"Average Minimum" filter may be worth trying.

After pondering this last night. I think that this needs further investigation. We should easily be able to get down to sub CFM measurements. We see fractional values in the MAF table and also interpolate the MAF data. If we use simulated input, the readings are very stable, which leads me to think that the fluctuations are external, and potentially hardware related. I think the pulsing that you see when you close off the inlet at 28" is indicative of this. It would be really good to try and isolate the cause.

It would be good to try and pin down the exact cause of the fluctuations. Whilst software filters are an 'easy' solution, they are not taking causality into account. We are only addressing the symptom of the problem and not the problem itself.

Do you have an oscilloscope?. The first step is to determine whether the fluctuations are external to the board. You can monitor the input voltage of the MAF wth a scope to determine this.

Assuming that the fluctuations are external, we then need to determine if they are from the MAF, or as a result of system design, which ideally requires measuring the air flow with a secondary device or monitoring system pressure.

If it is a physical phenomenon, I would expect it to be easily measurable.

If it is not a physical phenomenon, then the solution would be electronic filtering in the form of RC filter(s). There is already a rudimentary RC filter in the design. But the values can easily be tweaked. I think that this would be a more appropriate solution and more robust.

DeeEmm, 2024-11-04:
@Black-top I've added the changes to truncate / round the flow values in the GUI to the configuration tab. Let me know how this works for you. You will need to upload both the project and the index.html file

DeeEmm, 2024-11-04:
Screenshots...

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

black-top, 2024-11-04:
I have been trying to solve those issues since the beginning. The latest iteration has properly shielded cable to MAF, and since rs4 MAF needs 12V and 5V for reference, I made a small pcb based on a speeduino power supply, so a 5V power supply with all filtering and stabilization is connected a few centimeters away from the MAF connector. The 5V is as stable as possible, don't see any variation. I was probing signals with scope and don't see any noise, unless easp32 is connected to the pc, but I connect it only for firmware update, so it is not connected all the time. The MAF signal at the connector, compared to the signal at the PCB is undisturbed. All grounds are connected to the same place, so there are no ground loops. I see some signal pulsating directly from MAF, there is also some small variation in depression. My guess is that air flow is pulsing, and that might be the cause.  I think I need to add a manual valve near the pump, for "controlled leak", so the pump will run stable.

I lost track a little bit. I don't need to do code modifications, it is already in the master?

black-top, 2024-11-04:
Well, close loop control will be great, but it requires a lot of work, and probably quite complex strategies. Probably one PWM output for vfd and a second pwm output for DBW. Or maybe at first just DBW pwm output, but pump control leave manual, because two control systems might fight each other. Or maybe a simple strategy for vfd just ramp up pump speed open loop and PID only for DBW control.

DeeEmm, 2024-11-04:
A very basic implementation might not be too bad. Just controlling the bleed valve, with manual vac motor control.  No bells and whistles, just a very basic control.

I'm thinking that if it adds value to the initial release and helps us to produce a more stable / accurate measurements, then it will actually help with validation, which I see as the most important issue at present.

black-top, 2024-11-04:
Yes, even basic control setup will be a big step forward and probably will solve some issues with stability.

DeeEmm, 2024-11-04:
I will take a look after I've finished with what I'm currently working on.

black-top, 2024-11-05:
I tested the rounding functions, and it looks like everything is working as intended, didn't find any issues.

KirikauKiwi, 2024-11-05:
@black-top great to read that probing with a scope the DIYFB signals appear noise free and that the MAF and pressure sensors are showing signs that are indicating actual air flow pulsation, awesome stuff that the sensors are picking this up.
Do you have a water manometer that can measure 28" it would be a good test to see if the water level is also pulsing up and down too, double verification.
Do the pulsations exist all the time or do they increase when the level of vacuum increases.
Then you can be certain about where they are coming from and then look at physical methods of trying to control the pulsations.

I would be curious to know if the pulsations are 50 or 60Hz or multiples of. If so, this could be due to the motor being AC driven, the pulsations could also be coming from blades on the impeller inside the housing. You may have to look at coming up with some sort of pulsation damper for your system.
Are you are using a regenerative style of blower/airpump?

black-top, 2024-11-06:
@KirikauKiwi
 I have somewhere my old water manometer from the old flow bench setup, but the pump exceeds 100"h2o at low lifts, so I need to be careful with vfd to not suck water into the system. I also have manometers for carb/itb synchronization, so I think I will connect one of these for reference. Pump is driven by VFD, so I think it is probably the resonance of the system, but not just 50/60hz from main.  I don't have much spare time, so I can't play too much with it, but I will do more electronics testing, maybe FFT on signals, to see frequencies if close loop bleed valve control still don't give a better stability. I think it needs some air just to keep running stable.  Yes, both pumps s are regenerative style of blower/air pump.

KirikauKiwi, 2024-11-07:
Great idea with the FFT on the signals, it could help identify if it is indeed air pulsations in the pipes.
One idea I had today whilst out driving if it is air pulsations is to try either an accumulator plumbed in to your system, or the likes of a quarter wave or hermholtz side branch resonator to act as a fluid damper.

DeeEmm, 2024-11-11:
Based on the philosophy of 'if it's currently in the GUI it has to work' I've moved this into the RC9 stuff.

DeeEmm, 2025-01-06:
Stumbled across the following whilst looking for data on issue #307

Savitzky–Golay filter - https://en.wikipedia.org/wiki/Savitzky-Golay_filter

Seems like it might be suitable for flow smoothing.

It requires equally spaced data and can work on a live data stream.

DeeEmm, 2025-01-13:
I've added some basic filters for Average, median and mode.

Each filter can be tweaked / tuned using the following macro variables in system.h

```
// MAF Data Filters
#define ALPHA_MEDIAN 0.01f
#define ALPHA_AVERAGE 0.65f
#define ALPHA_MEAN 0.1f
```

Will close this  out for the time being, we can revisit this later if these do not meet our needs or need to be modded

Closed 2025-01-13.

Thread 182 (2024-10-28):

Temp conversion "RANKINE"

KirikauKiwi, 2024-10-28:
Whilst looking through the code for #179 I noticed this in the calculations.cpp Line 180 The RANKINE offset should be +491.67 looks like a copy and paste with the KELVIN offset.
Not sure if it is actually used in the code anywhere, but thought best to point it out in case it is.

```
// Then convert DegC to required value and return
  switch (unitsOut) 	{

    case DEGF:
      convertedTemp = (inputTempDegC * 1.8) + 32;
      return convertedTemp;
      break;

    case RANKINE:
      convertedTemp = (inputTempDegC + 273.15 ) * 1.8;
      return convertedTemp;
      break;

    case KELVIN:
      convertedTemp = inputTempDegC + 273.15;
      return convertedTemp;
      break;
```

DeeEmm, 2024-10-28:
This is correct.

°R equals K multiplied by, 9 divided 5

9/5 = 1.8

Hence conversion to Kelvin and then from Kelvin to Rankine

Could also have used

°R = °C * 1.8 + 491.67

Much of a muchness really

DeeEmm, 2024-10-28:
BTW.

In an older iteration of the software Rankine was used in the conversion from Mass flow to volumetric flow. But those calcs now use SI units so currently not used anywhere.

DeeEmm, 2024-10-28:
Sorry was a bit hasty in closing this as it's blocked responses,

KirikauKiwi, 2024-10-28:
Yes I see, may bad in reading the code in relation to Kelvin, cheers for clarifying.

DeeEmm, 2024-10-28:
All good. It's nice to have someone to check my work.

Your feedback / advice / input is welcomed and valued

Closed 2024-10-29.

Thread 187 (2024-10-31):

[BUG]

stefan63, 2024-10-31:
**Software Version**
- RELEASE (e.g. V.2.0-RC.8)
- BUILD_NUMBER 24103101

**I want to use a XGZP6899A010KPDPN

And made this config.**

* CONFIGURE REFERENCE PRESSURE SENSOR
* If you want to modify the code to include additional reference pressure sensors
* You will need to add your volts to kPa algorithm in the function sensors->getPRef()
*
* Recommended sensor is the MPXV7007DP or XGZP6899A007KPDPN
***/

#define PREF_IS_ENABLED                                     // Comment to disable reference pressure related code

#define FIXED_REF_PRESS_VALUE 1                             // Fixed pressure value in Pascals

// Set signal source (Uncomment One line only)
// #define PREF_SRC_PIN
#define PREF_SRC_ADC

// Set sensor type (Uncomment One line only)
// #define PREF_SENSOR_TYPE_LINEAR_ANALOG
//#define PREF_SENSOR_TYPE_MPXV7007
// #define PREF_SENSOR_TYPE_MPXV7025
// #define PREF_SENSOR_TYPE_XGZP6899A007KPDPN
#define PREF_SENSOR_TYPE_XGZP6899A010KPDPN

#define PREF_MV_TRIMPOT 0.0                               // Millivolt offset
#define PREF_ANALOG_SCALE 1.0                             // Scaling factor used for raw analog value
#define PREF_ADC_CHANNEL 1

**Then I get this :( when I compile (build) in PlatformIO is there a bug in censors.ccp?**

ESP32/DIY-Flow-Bench/sensors.cpp: In member function 'double Sensors::getPRefValue()':
ESP32/DIY-Flow-Bench/sensors.cpp:651:37: error: expected ';' before 'if'
   sensorVal = sensorVolts * 5 - 12.5
                                     ^
                                     ;
ESP32/DIY-Flow-Bench/sensors.cpp:660:2:
  if (sensorVal > 0) {
  ~~
ESP32/DIY-Flow-Bench/sensors.cpp:662:4: error: 'else' without a previous 'if'
  } else {

stefan63, 2024-10-31:
Compiles fine if I change to #define PREF_SENSOR_TYPE_MPXV7007 or MPXV7025
 But nider of the XGZP6899A007KPDPN    or   XGZP6899A010KPDPN   works.

DeeEmm, 2024-10-31:
Sorry.

Yes the line is missing the terminator character.

in sensors.cpp, around line 651 change...

```
sensorVal = sensorVolts * 5 - 12.5
```

to...

```
sensorVal = sensorVolts * 5 - 12.5;
```

The code will then compile.

I believe the maths is correct as I would have pulled this from the datasheet when I added it.

DeeEmm, 2024-11-01:
Fix for this pushed in build 24100101 so I'm going to close this as is now resolved.

stefan63, 2024-11-01:
I just checked 24100101 and I guess you overlooked the 007 sensor (sorry for being pain in the a...).

	#elif defined PREF_SENSOR_TYPE_XGZP6899A007KPDPN

		// Linear response. Range = 0.5 ~ 4.5 = -7 ~ 7kPa
		sensorVal = sensorVolts * 3.5 - 8.75

	#elif defined PREF_SENSOR_TYPE_XGZP6899A010KPDPN

		// Linear response. Range = 0.5 ~ 4.5 = -10 ~ 10kPa
		sensorVal = sensorVolts * 5 - 12.5;

		Also shouldnt it be? I guess both might be working but I did:  sensorVal = (sensorVolts * 5 - 12.5);

DeeEmm, 2024-11-02:
Haha. that's typical lol.

Thanks. I'll fix it up.

Closed 2024-11-01.

Thread 195 (2024-11-04):

Move configuration.h file into SPIFFS

DeeEmm, 2024-11-04:
The "GUI Firmware updates now possible" is great feature, but I think we need the ability to select all sensors at GUI configuration because firmware.bin  files will be compiled with all default sensors ?

_Originally posted by @black-top in https://github.com/DeeEmm/DIY-Flow-Bench/discussions/189#discussioncomment-11135934_

@DeeEmm ...

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

DeeEmm, 2024-11-04:
Would also need to move pins.h from pre-compile to post-compile

Closed 2025-01-16.

Thread 203 (2024-11-07):

[BUG]Large ACFM values with most recent build

KirikauKiwi, 2024-11-07:
Using Build 24110704

I don't have a MAF sensor connected, currently using a 10 kOhm trim pot, since updating to the latest build I now get very large ACFM values.
**MAF Voltage about 0.047V**
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

This is with the Audi RS4 MAF sensor defined and PRef is defined/active.
NO calibration or leak offsets have been applied. All set to zero.

No config setting or such had been changed so remained the same as the previous build, but now I am seeing the very large ACFM numbers.

KirikauKiwi, 2024-11-07:
Checking further MAF Flow KGH is also effected very large number displayed, Adjusted flow is blank

DeeEmm, 2024-11-07:
Hmmnnn that is strange.

I am not seeing that here.

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

I cannot seem to replicate it for any combinations of values of pRef / MAF.

What do you have for version / hardware?

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

KirikauKiwi, 2024-11-08:
It appears I have something happening with my index.html file.

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

DeeEmm, 2024-11-08:
The data circle elements are for the lift graph. It is a small dot that displays the point value when hovered over. It should be commented out.

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

But.... I was looking at this last week. Perhaps your index.html file is outdated?

Maybe try to re-upload the file from the repo's data folder

Or rename the file below and upload via the GUI (delete the old file first)

[index.html.txt](https://github.com/user-attachments/files/17671072/index.html.txt)

DeeEmm, 2024-11-08:
There is one thing that I have noticed. I do not see the Adjusted Flow value update where the Depression is negative.

KirikauKiwi, 2024-11-08:
Good spot with the adjusted flow.

I am back up and running now, I think you are correct somehow my index.html hadn't updated, looking in my file browser it was from four days ago.
Something was up with my computer, and it all fixed it self with a restart.

I am see the same as you know regarding the adjusted flow.

KirikauKiwi, 2024-11-08:
The adjusted flow is working, it is not handling the negative value correctly, at least that's what I think.
If I adjust the slider I have to display a positive "Depression" on the GUI the "Adjusted Flow" appears.

https://github.com/user-attachments/assets/ed74816b-11d3-41e3-b38e-56dc545f1047

KirikauKiwi, 2024-11-08:
Digging around I found in the structs.h
```
int adj_flow_depression = 28;                  // Adjusted flow depression in inches of water
```
If I change the 28 to -28, the adjusted flow will display for a negative depression and not for a positive depression, so it inverts problem.

Consulting my C++ guru that is ChatGPT it is telling me that in C++ it does not handle the square root of a negative number correctly.
```
scaleFactor = sqrt(pressureRatio);
```

Taking the absolute values for the pressure ratio appears to work. Will this break any other calculations that use the same conversion?
```
      pressureRatio = (abs(newPressure) / abs(oldPressure));
```
I am sure there is another way to handle this too, possibly with the <complex.h>

stefan63, 2024-11-09:
Having similar issues. Plus an issue with Ref Press Sensor shows Not enabled (Using XGZP6899A010KPDPN) and sensor works and shows correct value.
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

DeeEmm, 2024-11-09:
> Having similar issues. Plus an issue with Ref Press Sensor shows Not enabled (Using XGZP6899A010KPDPN) and sensor works and shows correct value.

The fix in @KirikauKiwi last PR addresses this.

I will take a look at the sensor description. This should not effect the rest of the code.

stefan63, 2024-11-09:
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

I have like tryed to delete and reupload index.html about a million times. I finally tryed to remove all files in upload menu and then reboat the ESP and now I'm finally back in buisness. (Exept for that Diff Press Sensor information).

DeeEmm, 2024-11-09:
ok I found an issue with the pressure sensor descriptions for the info pane.  The fixes are in with the SCFM code that I am working on. I will create  PR once the code has been properly tested.

DeeEmm, 2024-11-09:
> I have like tryed to delete and reupload index.html about a million times. I finally tryed to remove all files in upload menu and then reboat the ESP and now I'm finally back in buisness. (Exept for that Diff Press Sensor information).

The trick is to go to the file dialog and delete the index.html file. It will then ask you to upload the new one.

If you try to upload without first deleting it, it will not overwrite the existing file

stefan63, 2024-11-09:
That is the way I have done it. However it didn't work at that time.
Deleting all files and then reboot the board worked!?
ESP's can be hard to tame sometimes :)

Den lör 9 nov. 2024 kl 10:57 skrev Mick Percy ***@***.***>:

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

DeeEmm, 2024-11-11:
This should be addressed in the latest PR. Let me know if this is still a problem.

Is this related to #217 ?

DeeEmm, 2024-11-11:
Ok looks like this is a different issue to #217 so will close this out

Closed 2024-11-11.

Thread 205 (2024-11-08):

Post-Compile Configuration

DeeEmm, 2024-11-08:
It's a fair bit of work to get to a dropdown for each setting. First we need to get all of the settings out into dedicated files and then we can look to create GUI elements to manage each setting. Ultimately down the track something like this would be the goal but for the time being just the ability to change settings post compile time will allow the OTA firmware to function correctly.

It's quite interesting changing the settings from pre-compile to post-compile. It presents a number of technical challenges.

We need to change the following files to be loaded after the ECU has booted

- pins.h  - pins definitions + I/O assignments
- configuration.h - configuration settings > begin() & initialise() vars setup
- maf.cpp - MAF data creation
- language.h language file

Changing to a JSON format and reading the variables in from a file is not too hard as we already use the arduinoJSON library which makes relatively easy work of this, most of the settings are easy enough to translate apart from the large data array that is used for the MAF file, which I have yet to do. There is some creative coding needed to ensure that we can typecast correctly from char* arrays to whatever variable type we require to get the settings from JSON. This typecasting was previously taken care of automagically by the #define precompile directive and was transparent. So there is an amount of work to do there. Also char* / string management in C++ is woeful. Give me PHP any day lol.

There are also some additional challenges depending where we need to replace compile time directives within the code. Previously we #include the files at the top of each class or file as required. This meant that the values from those files were available right away to use. However when we have some #ifdef statements in the header section of the class definitions, we cannot use regular conditional logic to replace them, as we cannot use if-then-else logic in the header section of the file. So some creative solutions are required.

We also need to bypass pretty much all of the code until the I/O and configuration files are present. So we need to be able to block out large portions of the code so that it skips directly to the webserver to allow the relevant files to be uploaded. The big challenge there is dealing with unassigned I/O and variables (because we've essentially removed most vars from the code) and so we have to bypass the code that relies on them whilst still allowing it to function afterwards. The existing code flow is not ideal for this as we did all of the I/O and configuration stuff first, whereas we are now trying to do it last.

Today has been working through many errors line by line to get the code to compile without having the configuration and I/O assigned.

Very challenging lol.

_Originally posted by @DeeEmm in https://github.com/DeeEmm/DIY-Flow-Bench/discussions/189#discussioncomment-11174761_

DeeEmm, 2024-11-08:
Parking this for the time being.

Changes are stashed on WIP branch.

Look to implement non-breaking changes from WIP into main code over time so that eventual move to post-compile configuration handling has less impact.

Also need to look at better controlling initialisation sequence. Sequence needs more granularity so that breaking aspects like I/O and Variable assignment can be more easily worked around.

Need to bring ALL initialisation into main startup.

DeeEmm, 2024-11-15:
Stumbled across an interesting stand alone binary uploader...

https://github.com/marcelstoer/nodemcu-pyflasher

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

This could be very useful coupled with the ability to upload binaries via the GUI. It would mean that no one needs to use VSCode to get up and running. Just download this program, flash the binary in the first instance and then all updates and setup is done via the GUI.

I did download it and test it. It seemed to happily uploaded the binary, but there is unfortunately an error on boot. It seems that this error means that there is no program present.

```
rst:0x10 (RTCWDT_RTC_RESET),boot:0x13 (SPI_FAST_FLASH_BOOT)
invalid header: 0x63206f74
invalid header: 0x63206f74
invalid header: 0x63206f74
invalid header: 0x63206f74
invalid header: 0x63206f74
invalid header: 0x63206f74
invalid header: 0x63206f74
```

Hopefully the source could be updated to work. (I suspect that this might actually be a partition issue.) anyone game enough to try?

stefan63, 2024-11-15:
I have used this ESP32 Flash tool for some of my previous projects and it works fine:
I sugest you try it before doing any unnessesary changes :D
https://www.aeq-web.com/esp32-flash-tool-exported-program-upload-bin-hex-file/?lang=en

DeeEmm, 2024-11-15:
Thanks Stefan.

Will give them a try.

DeeEmm, 2024-11-27:
Been having a play with the firmware uploader, and have a working version.

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

I've stripped out the chaff to leave just what is necessary.

ATM I'm looking at how we can spit out a combined binary as this is required for the firmware loader. This includes bootloader.bin + partitions.bin along with the firmware.bin in a single file.

Currently platformio does not support this out-of-the-box, but others have integrated the ability to do this.

With a single binary, any firmware uploader can be used, there are even browser based loaders such as this Adafruit version

https://adafruit.github.io/Adafruit_WebSerial_ESPTool/

and an expressif version

https://espressif.github.io/esptool-js/.

It should actually be noted that these browser based uploaders do support uploading separate bootloader / partition / firmware binaries, it is just a case of putting the correct memory addresses in. For example using the expressif tool works...

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

(Using this method it is also possible upload the spiffs.bin file as well.)

The underlying code that supports the browser based upload is available for anyone to use - esptool-js, which means that we can easily deploy it on the main website. [ESP-tool Documentation](https://espressif.github.io/esptool-js/docs/index.html). We could also modify it to link the source code directly to the current release to pull in the appropriate files.

We can also do the same with the Firmware loader app. Then installing code is simply a case of visiting the URL or using the app. There would be no need to manually handle files or type in register addresses, we can include all of that boilerplate stuff within the app / browser loader so that it is transparent to the user

Of course this is only needed for the initial upload. Once the device has firmware installed, we then move to the GUI style update. In this case it should be possible to do a similar thing where we can either link to, or fetch the remote firmware file.

If this can be implemented, then the steep learning curve of having to use VSCode or the Arduino IDE to flash the board will be eliminated, which I think will be a gamechanger.

There's still a bunch of work to do on this, but we now have a basic proof of concept.

DeeEmm, 2024-11-27:
So managed to sort out the creation of a merged binary.

Also expanded on this to populate a 'release' folder with the merged binary, firmware binary and GUI file...

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

The merged binary is created by the merge-firmware.py file which is called as an extra script in platformio at compile time.

So now for each commit and pull request binaries are automatically created. This means that it should be very straightforwards for anyone wanting to upgrade. Unless you are not running the default MCU. That will however be addressed when I sort out the rest of the post-compile configuration stuff.

DeeEmm, 2024-11-28:
Updated the wiki to include instructions for uploading firmware using a firmware uploader. Currently the web based version is working and the app just needs a bit of tweaking.

https://github.com/DeeEmm/DIY-Flow-Bench/wiki/Installation

I'm going to pull this back into the V2 release. I think that it will just make a more rounded product and hopefully open it up to people who are not so tech savvy.

I know it is a bit more work, but not too much.

DeeEmm, 2024-11-28:
Ahh yes. the Firmware uploader code is now uploaded to the repo - https://github.com/DeeEmm/DIYFB-firmware-flasher

At the moment the Mac App works from the VSCode environment but stalls when run standalone.

I have no way of testing on Windows. If anyone is keen to have a go.

I know that the app is not a requirement for the V2 release, but would be good to get both executables working

KirikauKiwi, 2024-11-28:
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

This is awesome!!!!!
Would be good to add to the Web flash section about which browser to use, e.g. Google Chrome and Microsoft Edge [version 89 or later](https://developer.mozilla.org/en-US/docs/Web/API/Serial#browser_compatibility) browsers

DeeEmm, 2024-11-29:
Will add that in. There' still a lot of tidying to do in the WIKI.

Current status of this is that the mods to get the config stuff moved over to configuration.json are done but not 100% tested. This is due to the MAF stuff still being in process. Currently I've created a MAF.json file and have read the MAF data into a JSON object.

```

    "sensor_type" : "ACDELCO_92281162",
    "output_type" : "voltage",
    "maf_units" : "KG_H",
    "maf_scaling" : 0.1,
    "maf_diameter" : 94,
    "maf_lookup_table" : {
        "8" : 28,
        "15" : 34,
        "23" : 43,
        "31" : 52,
        "38" : 64,
        "46" : 78,
...
        "477" : 15091,
        "485" : 15954,
        "492" : 16852,
        "500" : 17787
    }
}
```

The JSON object does allow some iteration, but this is very basic compared to using an array or vector as we did previously. I've been scouring the ArduinoJSON documentation to see how the JSON object can be accessed in a similar manner to the existing code, but it very much looks like what I need to do is create a vector from the JSON object (actually vector of vectors as it is a 2D array) and then just use the existing code as-is.

So next step is to try to iterate over the ArduinoJSON object and create the necessary vector. (as I do not see an available method to create it directly).

So, we are very close, but still a little way to go.

Will try and get this done over the weekend. I have some other commitments but keen to get this refactor completed before I get too out of step with the DEV branch.

DeeEmm, 2024-12-01:
Had a bit of a nightmare with this, Somehow managed to lose all changes by closing / reopening VSCode, so spent most of yesterday recovering the lost work. Fortunately VS history had a copy of most changes.

Was definitely something screwy going on with my VS as I previously has an issue with a locked PR. Still unsure what that issues is so need to be more vigilant with committing progress. (hadn't committed for four days - lesson learned).

Still got one small compile error that I need to fix.

```
/Users/mick/.platformio/packages/toolchain-xtensa-esp32/bin/../lib/gcc/xtensa-esp32-elf/8.4.0/../../../../xtensa-esp32-elf/bin/ld: .pio/build/esp32dev/src/datahandler.cpp.o:(.literal._ZN11DataHandler13parsePinsDataEN11ArduinoJson8V6215PB218StaticJsonDocumentILj1024EEE+0x10): undefined reference to `pins'
```

I'm out for the rest of the day so that will have to wait until tonight.

DeeEmm, 2024-12-02:
Compile error fixed, just working through validation and tidying.

Have updated the WIKI for the configuration settings... https://github.com/DeeEmm/DIY-Flow-Bench/wiki/Configuration

Will work through MAF settings next

DeeEmm, 2024-12-10:
OK. So I think this is pretty much done.

The change had a massive impact as pretty much every aspect of the code relied on data that was present in the precompile macros. This means that the code changes are pretty substantial.

Making the change broke a lot of functionality, so there has been an amount of time spent on fixing things and in some cases finding different ways of doing things. Other changes were made in the name of code improvement, wherever possible I have replaced if-else logic with switch / select, which is both faster and easier to read.

In reviewing the code I've also found other errors which I have addressed as they have arisen. These are recorded in the changelog.

Some caveats.

- The 5v pin is unable to be used to measure board voltage. It appears that this pin is related to WiFi, so whilst Wifi is in use the pin cannot be used to measure analog voltages. This is actually a bit weird as prior to the change from pins.h to pins.json the compiler never complained. I suspect that this could be as a result of the issue not being presented to the compiler error checking due to being masked by the precompile macro.
- Currently the 5v is set to fixed value. I will of course address this in future PCB versions. It should also be possible to solder a jumper to an unused pin. I'm not sure how much of an error running a fixed 5v value will introduce. I've not seen any variation to the 5v bus in testing here, but other environmental influences may need to be considered. Of course YMMV.

- Memory requirements have changed a lot and the ARDUINO_LOOP_STACK_SIZE has been increased substantially to accommodate the memory consumed by copying the JSON file data into memory. Along with this the allocation for JSON object sizes has also been increased. The consideration here is that the JSON files are to a degree liable to change size based on various factors. We can allow for this where we can predict size changes, such as for the configuration.json file but other files such as the MAF.json and language.json files are able to be modified by the end user, which could result in stack overflows / stack canary watchdog errors if the changes exceed the memory allocation. Not an immediate issue, but one to bear in mind if you see such errors.

- I have created pins.json and maf.json files, however these have not been validated. I know that there will be errors in the pins files. I will work though those next. The format of the files has changed and so will not look familiar. Unfortunately it is not possible the comment JSON files as this results in compilation errors, so the files need to be modified in conjunction with the documentation, which I also need to check and update.
- The WEMOS pins file is fully working.

- File names are dynamically detected. This is to allow the auto versioning to increment file names. These can be uploaded as-is, there is no requirement to rename the files. The code searches for 'index' / 'pins' / 'maf' strings in the filenames.

- From this version onwards it is now possible to upgrade firmware by using the 'upgrade' button in the GUI. This allows you to upload the 'update_binary' from the releases folder. This uses your existing pins / maf / config data.
- Where updates to pins / maf / config files are required as part of an update we will need to look at modifying them programatically.
- Next stages are to look at version / update detection and possibly even upgrading from the remotely hosted binaries. Lots of possibilities, but will leave those for V3. The foundation is now in place, we can build on it later.

Working branch is here - https://github.com/DeeEmm/DIY-Flow-Bench/tree/205-post-compile-configuration

I still have some tidying up to do and also want to make sure that this is tested before merging into DEV.

DeeEmm, 2024-12-10:
Ahh yes amongst the changes I changed the way that the capture works. Previously after every submission the GUI refreshed, which was a bit of a PITA. So I changed the operation to submit the form data by XHR. The only caveat here is that in getting rid of the refresh the graph does not update (it is created at page load). So to view your changes you need to refresh your browser.

I will change this behaviour, but it is a fair bit of code to move the graph data from template variables to ajax / event data, so will not do this until a later version.

At some point we will rewrite the data graph and add in the additional info to the GUI. We can look at changing the behaviour at that stage.

KirikauKiwi, 2024-12-10:
Great work under the bonnet, to the end user it won't look very different!!!!
Three things I have noticed are.
- Pitot GUI display not updating, via the API the sensor is working as expected.
- MAF Flow GUI display, with the Bosch MAF when the voltage is below 1V the display shows a very long number for some of the look up table values and displays correctly for others, it appears to alternate when doing a voltage sweep. Working as expects at voltages above 1V.
- There appears to but a latency with the GUI display updating, most noticeable with the Environmental data.

MAF Data error
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

Version and hardware information
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

Latency of GUI display updating
https://github.com/user-attachments/assets/757381ad-4f65-415a-aebf-db797994c482

KirikauKiwi, 2024-12-10:
Further information for the MAF GUI,

It appears that with the 20mV steps in the MAF lookup table that when the voltage is below 1V the large number is being display when the MAF voltage is between the 20mV steps.
```
        "86" : 94,
        "88" : 83,
```
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

DeeEmm, 2024-12-10:
I had also previously noted the out of range value for the flow. I had added fabs() to each value generated by ADC and also changed the code for the validation to prevent values going negative, which I assumed were the cause. In local tests this appeared to eliminate the out of range value, but that is obviously not the case.

I also noticed some latency in the GUI, which seemed to settle after a short time. I am unsure of the reason, possibly as a result of additional processing requirements ??

Will take another look at the OOR value and optimising the code

DeeEmm, 2024-12-10:
BTW your GUI version is very different from the current version - 2412100100. I don't think that this could be the case for the latency or OOR value, but nothing should be overlooked.

KirikauKiwi, 2024-12-10:
Thanks for the heads up, I initial flashed this 205 Build over top of the the DEV build on my ESP32.
I have cleared the flash on the ESP32 and then ran the did an upload and monitor which showed on the serial monitor as up and running, I couldn't access DIYFB local.
Went back and run the GULP commands and the upload and monitor which has worked. However the GUI version numbers is out of whack.

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

KirikauKiwi, 2024-12-10:
The pitot ∆ display is working as expected other than when it is zero'd.
After zeroing the Pitot Display the ∆ has a a small area of voltage between 2.47 - 2.5V where the ∆ is displayed as a negative above to 2.5V crossing point the ∆ is displayed correctly and it is also displayed correctly as a positive value from 0 - 2.47 V.

DeeEmm, 2024-12-10:
The @@version@@ is the template placeholder that is replaced during the gulp build.

This is present in the source file (/src/index.html)  but gets replaced during the gulp tasks when the /build/index.html is created and is carried into the /releases/V2.0-RC8_2412100100_index.html file, which is essentially just the /build/index.html file renamed and copied into the releases folder

You can see this in the gulp.js file...

`
	var result = data.replace("@@version@@", new_build_number);`

The overall process is that the GUI source files reside in the src folder

```
index.html
style.css
javascript.js
```

These are the three main files for the GUI that get combined and minfied by GULP

Additionally there is the preload.html file, which is the basis for the HTML code presented in the boot loop. This actually resides in the language.json file as a minified version but the unmodified souce version is in the /src folder.

When GULP is run (combine) the index.html, style.css and javascript.js files are combined into a single file that is stored in the /build folder.

Previously this was the index.html file that we used in the GUI. But now we copy this to the releases folder and rename it with the current version info. A small change tot eh build process but one that allows us to easily keep track of versions. In addition to the @@version@@ variable displayed in the info modal, we also have the filename as a point of reference.

It's a bit of a change for those of us used to grabbing the index.html file from the data folder, but moving forwards the documentation will direct everyone to the release folder.

DeeEmm, 2024-12-10:
> The pitot ∆ display is working as expected other than when it is zero'd. After zeroing the Pitot Display, the ∆ has a a small area of voltage between 2.47 - 2.5V where the ∆ is displayed as a negative. Above the 2.5V crossing point the ∆ is displayed correctly, it is also displayed correctly as a positive value from 0 - 2.47 V.

I want to look at all of the pressure sensors in the context of zeroing / calibration values. We added zeroing to the pitot and differential, but we really need to make trimpot and calibration functions much easier to use.

I feel that there is a bit of work to so there

DeeEmm, 2024-12-10:
As this is working with a few residual issues not directly related to the post-compile-config I've merged PR into main and will close out this issue

We can flag those incidental issues up individually under new issue reports

The zeroing / calibration discussed above is probably best taken care of as part of #236

Closed 2024-12-10.

Thread 208 (2024-11-08):

[FEATURE REQUEST]SCFM Conversion/Display/Logging

KirikauKiwi, 2024-11-08:
With a few of us getting close to having the DIYFB hardware and Flow benches/Test rigs up and running, would it be useful to implement SCFM conversions in the DIYFB firmware as this would give us a way to normalise our reading since we are not all in the same room on the same day.

Then, when we start testing our systems will are able to have flow results that will be directly comparable because of the standard set of conditions.

Having a poke around on the web this is the formula that would do it.
SCFM = ACFM × (P_act / P_std) × (T_std / T_act) × (1 / (1 - (RH / 100)))

Where the standard condition are;
P_std = Standard pressure (usually 101.325 kPa or 14.7 psi or 29.92 inHg)
T_std = Standard temperature (usually 293.15 K or 20°C or 68°F)
Dry Air 0%RH

DeeEmm, 2024-11-08:
Yes. Absolutely.

I will try and find the conversation that we previously had about standardisation, it is worth a read.

I cannot quote the exact standard number from memory, will have to look it up IIRC it was a DIN standard.

But, the most appropriate standard (and there are many) is the standard that relates to automotive power testing. i.e the standard that governs how car manufacturers test their engines / vehicles to be able to provide a SAE/DIN power rating in KW.

Using the 'dyno' test standard makes a lot of sense when you consider that (ideally) the flow testing will then be carried out exactly the same conditions as the dyno testing.

Of course It should also be possible to swap out the reference standard so that people can use a difference reference standard should they wish.

Easy enough to achieve.

I will put something together.

DeeEmm, 2024-11-09:
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

OK so I've hashed in the basic code, now I just need to do the maths part and test.

I've included several reference standards that specify Temp / Baro / RH. Unfortunately NIST do not specify RH so cannot be included (I will remove this entry)

All of these standards are either directly relevant, or generic.

DeeEmm, 2024-11-09:
I've corrected my previous reply above. it is actually ISO1585 that is the Automotive engine testing standard. SAE J1394 is the standard for non-metallic tubing, so somewhat unrelated.

DeeEmm, 2024-11-09:
> Having a poke around on the web this is the formula that would do it.
> SCFM = ACFM × (P_act / P_std) × (T_std / T_act) × (1 / (1 - (RH / 100)))

What's the source for this?

Seems a little too simplistic.

DeeEmm, 2024-11-09:
Okay. I've re-jigged the calcs for air density and broken them out into a dedicated method (calculateAirDensity). This method is used by both mass flow to volumetric flow calcs, as well as transposing between current and reference standard conditions.

I've based calcs on the following - https://neutrium.net/general-engineering/conversion-of-standard-volumetric-flow-rates-of-gas/

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

Specifically as we can calculate both the current air density and the air density at the reference standard.

The following reading may also be of interest https://www.buildingcalculators.com/standard-cfm-and-actual-cfm-convert

I've pushed the changes to the following branch - https://github.com/DeeEmm/DIY-Flow-Bench/tree/SCFM-Conversion-%23208 but not keen to create a PR until we are happy that this is correct.

I also note a comment I made within the mass to volumetric conversion relating to how we add the reference pressure to the baro for the purpose of the conversion. Whilst seperate to this conversion, it is worthwhile getting a sanity check on this

calculations->convertFlow()
```
  // TODO validate reference pressure adjustment - do we add it or subtract it? Should be baro pressure less vac amount
  double refPressurePascals = sensorVal.BaroPA - this->convertPressure(sensorVal.PRefKPA, PASCALS) ;
```

DeeEmm, 2024-11-09:
BTW the dropdown is not working. At present it is just using default values for ISO 1585

DeeEmm, 2024-11-09:
It is interesting to see that I am getting an approximate 10cfm difference between my current reading and the standard

```
Local Conditions - 23.4 | 101.79 | 45.5%
ISO 1585 Std     -   25 | 100    | 0%
```

https://github.com/user-attachments/assets/0e205fb1-80a6-426c-ae7f-9686a7c5c339

DeeEmm, 2024-11-09:
OK. Dropdown now also working.

If anyone is happy to test this and give some feedback on the SCFM.

KirikauKiwi, 2024-11-09:
Yes it is interesting, and in deed and shows exactly why when trying to compare one flow bench to another it is like comparing 🍏  to 🍊.
At least with Standard conditions applied we will be able to compare 🍏 to 🍏 and 🍊 to 🍊

In your example of a 10CFM difference this is mostly influenced by the Humidity difference as it will have the biggest scaling factor.
I see at your location it is 23.4 | 101.79 | 45.5%, I currently have 20.7 | 101.80 | 59.6%, also interesting to note as I have Temp/Humidity monitoring in several rooms at home, all temps are within 1 °C of each other, but there is a 7% difference in RH

KirikauKiwi, 2024-11-09:
Running the SCFM version now, looks bloody good, Nice work 👍

Only so far comment is that on the dashboard display it would be great to include the SCFM depression inches and the Standards number.
That way we can easily see what version of SCFM we are using at a glance.

Nice to see ISA in there too.

I am liking the look of ISO5011 as it has a good real world values for the Temp,  %RH and is based at STD sea level.
i.e. the Temp and %RH are probably a good real world median.

Will take a while to verify the formulas used in the calculations but noting is looking out of sorts currently.

❤️ this update

DeeEmm, 2024-11-09:
The depression is not part of the reference standard. As such we are free to nominate a depression reference for collective results. Obviously 28"/H2O is the obvious depression to choose, but not all of us have systems that will achieve 28" (myself included). For comparing results I propose that we measure across a range of depressions so that it can cater for all benches.

I agree that ISO5011 is the closest to real world conditions, but do like that ISO1585 specifically relates to engine test conditions. I suppose that the actual reference standard chosen is more or less arbitrary and the actual temp/baro/RH is immaterial. Once we have a result that conforms to one reference standard it is easy to convert to any other standard.

My take on ISO 1585 compared to ISO 5011 is that 1585 follows the other International standards that use 0%RH as the baseline. Obviously it is almost impossible (perhaps actually impossible) to test engines at 0%RH and so the 0%RH figure only serves as a comparison baseline.

ISO 5011 on the other hand, uses a mid range RH value which is easily achievable in test conditions. I suspect that the actual RH can directly impact the efficiency of air filters (ISO5011 is an air filter test standard) and that testing at 0% yields far more favourable results.

I agree that ISO 5011 will give results that most closely match real world conditions.

Happy to change the default to 5011

DeeEmm, 2024-11-09:
Default changed to ISO5011 and reference added to tile

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

KirikauKiwi, 2024-11-09:
I wasn't referring to fixing the SFCM tests to 28 inH2O, only to display what the inH2O has been set to in the configuration page.

Maybe what I am trying to convey is, would it also be useful to be able to view the "Standard adjusted flow" too.

DeeEmm, 2024-11-10:
> I wasn't referring to fixing the SFCM tests to 28 inH2O, only to display what the inH2O has been set to in the configuration page.
>
> Maybe what I am trying to convey is, would it also be useful to be able to view the "Standard adjusted flow" too.

There is no way to specifically offset the depression for SCFM. The depression setting in the configuration is only for the adjusted flow value, it does not change or translate the SCFM value.

SCFM is displayed at whatever the current active depression is. So the actual depression is already being displayed on the 'Depression' Tile

All calibrations (and therefore bench comparisons) must be done at the actual depression that the calibration orifice was originally tested at.

So if the orifice was tested at 10in/H2O, that is what the standard flow musts also be measured at.

Hope this makes sense.

KirikauKiwi, 2024-11-10:
Yes that makes sense.
Fact checking here. so if we have a SCFM value at what ever the measured depression is say 10 inH2O as you refer to above. I thought the SCFM @10inH2O would be able to be converted to SCFM @ ?? inH20 with the pressure ratio calculation as it is done with ACFM.
Secondly would't you be able to do the SCFM conversion on the ACFM adjusted flow, so it would make sense that the math should work either way, or am I over looking something here.

DeeEmm, 2024-11-10:
> The case for Adjusted Standardised flow
>
> I accept that some people will want to do this. But it must be applied to the Adjusted flow value and not the other way around.

Further to this, it would also need to be obvious to the user, what adjustments are applied to the adjusted flow figure...

We currently have...

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

We would need to change that to...

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

But the change is not obvious and is easily overlooked / misunderstood.

90% of blokes do not bother to read instructions / the WIKI so they would miss this sublety and end up with a measurement result that was not what they expected, plus be completely oblivious to it

It is a similar story with adding an additional tile

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

We would end up with 5 different flow tiles in that position, which for some  may be information overload when all they want is a CFM reading

-----------------------------------------------

So I am happy to add it to the adjusted flow, but unsure of the best way to proceed.

Perhaps it is a setting in the configuration and the end user selects one or the other when they initially set their bench up

DeeEmm, 2024-11-11:
Checkbox in configuration added to enable / disable standardised flow for adjusted flow value

Changes in master

KirikauKiwi, 2024-11-11:
Thanks for adding it in.

I agree with you that each bench should only be used within its actual physical performance capabilities and that calculated data is usually not as good as measured data so is best to avoid if possible, you could argue that the adjusted ACFM should be hidden away too.
The main reason to add it in for me was that it is at least keeping the standard conditions calculations across the board and in line with what can be done with the ACFM, I am interested to see how repeatable testing will be comparing ACFM to SCFM over a period of time, as in my eyes ACFM measurements are essential used like a comparator, so my test today won't be the same as my test tomorrow if the ambient conditions have changed. So if working away on a project for a few months using ACFM readings it will be hard to get any form of repeatability due to the different conditions each time the measurement are made, only the changes you make on the day will be able to be seen i.e did you improve the flow or not.

It will be interesting overall to see how good the accuracy and precision will be of the different DIYFB builds over time.

PS, Thanks for you work in this, in creating a great software and hardware tool for the community.

DeeEmm, 2024-11-11:
Thanks.

I think it is a useful feature, and for some will likely be the default mode, especially those with a shop-vac and floating depression style setup. I mean it doesn't get any simpler than a MAF and shop-vac. If that kind of system can spit out repeatable and somewhat accurate flow numbers then the software truly becomes a useful tool.

I too am very keen to see how the figures compare from bench to bench as this will be the real test. I want to get some of these additional requests added in so that we can sew up the V2 stuff. Your pitot request is next on the list.

The final change will be adding in some form of 'system report' for comparing performance data. I've got some ideas on that but will start another thread (if there is not one already)

Closed 2024-11-11.

Thread 211 (2024-11-08):

[BUG]Flow Diff view on the DIYFB GUI

KirikauKiwi, 2024-11-08:
**Software Version**
- RELEASE V.2.0-RC.8
- Build 24110802
-

**Describe the bug**
Should the three labels at the lower area of the "Flow Diff" match the first three labels from the configuration page Calibration Data, currently they do not.

It appears that all three of the Calibration Data offsets gets applied to the "Flow Rate" and "Adjusted Flow" as expected and only two of them appear to be applied to the "Flow Diff" the total numeric value is correct, but when you switch between the three options for "Flow Diff" the value only changes twice, I would expect it to change three time if there is data in all three of the calibration data.

Would it be useful to add the applied offset value to the text label that is displayed at the lower part of the "Flow Diff"
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

KirikauKiwi, 2024-11-08:
LOL, got stuck and couldn't getting my head around it, but the penny dropped finally lol.

KirikauKiwi, 2024-11-08:
I think I got caught as it looks like the "User Target" has not yet been full setup, is this correct?

DeeEmm, 2024-11-09:
Flow targets were working, but I can see that now it is not.

Normally you click on the 'Unit' part of the tile to cycle through 'User target' / 'Leak Test' / 'Baseline'.

Will take a look

DeeEmm, 2024-11-09:
I can see the event triggering in the console and being received in the serial monitor...

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

but I can also see an error...

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

I note that this is only happening for negative depression values so suspect related to that.

Will continue later this eve..

KirikauKiwi, 2024-11-09:
I think I see the same as you on the screen.
What I think is happening is that on the dashboard page, when "Flow Diff, User Target (cfm)" is displayed where is it picking up its data value from?

Because on the configuration page there in no field labeled "User Target", I only have "Baseline" and "Offset".
Should there be a "User Target" field on the configuration page?

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

DeeEmm, 2024-11-09:
Ahhh okay.

To set the user target you need to click on the value in the tile...

https://github.com/user-attachments/assets/91107995-2d66-434f-a5fb-fa3927905bfc

I added this to the dashboard rather than the config as it is something that will likely get changed often. So this way it is quick to edit.

KirikauKiwi, 2024-11-09:
It would be good I think to add the value of the offset to the view if possible on the dashboard page.

E.g. Currently its displays "Baseline (cfm)" I am suggesting to display  "Baseline (Value)(cfm)"

KirikauKiwi, 2024-11-09:
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

Ahhhh so that is what I was missing, got it now 👍

KirikauKiwi, 2024-11-09:
😂 I can confirm that it is all working as it should!!!!!! Now that I know what to do!!!!

Layer 1, User issue!!!!!!!!

Closed 2024-11-11.

Thread 212 (2024-11-09):

Create Diagnostics Page

KirikauKiwi, 2024-11-09:
**Software Version**
- RELEASE V.2.0-RC.8
- BUILD_NUMBER Build 24110802

More of a refinement than a BUG.
When viewing the INFO page, I am unable to scroll the page all the way to the bottom. I cannot see the last Pressure sensor.

Can you group the pressure sensors so they are displayed next to each other too.

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

DeeEmm, 2024-11-09:
I've reduced the font size a little to hrlp stop the overflow. Let me know how you get on

KirikauKiwi, 2024-11-09:
It has improved it a little. The text is still partially of the screen.
https://github.com/user-attachments/assets/f44f31cc-f237-4d8b-9636-003e2b5a9a79

Personally I preferred the previous text size as it appears to have changed the Dashboard too.

DeeEmm, 2024-11-11:
On the current code I've changed the test size back to previous but added a height component to the modal dialog. Let me know if that changes the issue.

You can also try to manually change the CSS using web developer in chrome and finding a height that works for your display

DeeEmm, 2024-11-11:
OK added scroll to the modals when content overflows.

Should be able to scroll the info modal upwards now.

Changes in master

Let me know how you get on

KirikauKiwi, 2024-11-11:
BUILD_NUMBER "24111107"
RELEASE "V.2.0-RC.8"

It looks like the modal changes have affected the main GUI page and not the INFO pop up page.
https://github.com/user-attachments/assets/6adb2504-d453-4b62-b457-01a8a8a912f7

I liked how the main page had a sticking point so it aligned with the top of the browser window, this has gone now.
https://github.com/user-attachments/assets/6c286a17-f875-4a93-b537-b066e2f23dae

DeeEmm, 2024-11-22:
Might rewind a bit here then.

The overall aim of the GUI is to not need to scroll. It is designed for a touchscreen / tablet.

So everything that needs to be viewed, should be visible within the view-frame without scrolling. Sometimes I forget this when I'm sitting at my 27" monitor 😆

Adding the padding in the footer has created some room for one item but caused a couple of other problems, so not really a workable solution.

I think the best solution here is to revert the changes to the footer and then look at improving the layout of the info modal, perhaps even change it to a tabbed modal to get more realestate.

DeeEmm, 2024-11-22:
There was a suggestion / discussion (somewhere) to include a page for I/O and include mimics to show the state of inputs and outputs. That seems like a logical place to move the sensor stuff. So perhaps creation of the 'diagnostics' page / modal / tab will be the end goal here and kill two birds with one keyboard.

DeeEmm, 2024-11-22:
Ok I've pencilled this in for V3, but it should be possible to get basic tabbed structure in place before then, so that we can move the sensor info.

This will reduce size of info modal and make sensor info readible.

DeeEmm, 2024-11-22:
Got a bit of an interim fix...

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

Changed it to a 2 column layout.  Let me know if that works for you.

DeeEmm, 2024-11-22:
Just tidied up the alignment a little...

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

KirikauKiwi, 2024-11-23:
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

Yes this works great.
Totally agree with you about the rewind and the GUI design/functionality being used primarily for tablet 👍

DeeEmm, 2024-11-23:
Unfortunately still need to scroll on the configuration page, but as that is not accessed too much. is a small compromise and probably less annoying than have to remember which one of the ten tabs had the setting you needed on it. 😆

KirikauKiwi, 2024-11-23:
Minor detail, I am still seeing the scroll bar in the modal window. I notice in your screen shot that it is not there.
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

DeeEmm, 2024-12-11:
Closing as completed

Closed 2024-12-11.

Thread 213 (2024-11-09):

[FEATURE REQUEST]GUI Pitot display changes

KirikauKiwi, 2024-11-09:
Assuming that the "Pitot" displayed currently on the GUIn is intended for probing port velocities
These are my suggested changes for the "Pitot" area of the DIYFB GUI.

Suggested Changes
- Heading of "Pitot" change to "Air Speed" or "Air Velocity"
- Main displayed value is currently "∆Pitot" change to "Speed Value" e.g. display the calculated speed V = sqrt [2 * {pt – ps} / r ]
- "inH2O" to "ft/s" or "m/s" or other preferred unit of velocity
- Include "Pitot ∆ (Value) inH2O" after the unit for velocity, I think will be useful to have on lower part of the display box.

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

Note: units have to be kg/m<sup>3</sup> and Pa or slug/ft<sup>3</sup> and lbs/ft<sup>2</sup> for the velocity formula.

DeeEmm, 2024-11-16:
I've closed out #213 as I feel that it can be rolled up within this change. Whatever solution is implemented on Pitot can be utilised on pDiff / pRef

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

DeeEmm, 2024-11-16:
Also closing out #159 - we'll keep all of the pitot stuff in this issue

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

DeeEmm, 2024-11-16:
First blush...

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

I will eventually add the GUI descriptors to the language overrides so that people can rename things like pitot / depression / etc to their liking.

DeeEmm, 2024-11-21:
So Pitot functionality is working (to a basic fashion).

Both Pitot and PDiff values can be zeroed down by clicking on the value in the tile.

I don't have a sensor or pot hooked up to test with so the values are just floating on my test bench...

https://github.com/user-attachments/assets/53818823-430f-40f0-81d6-1f4f4c3d4c5f

One thing that need to be determined is where the delta is measured between.

Hooking up the pitot across the sensor should return the delta without needing to calculate this in the code, but as I do not have a pitot sensor to test with, someone else may need to validate this for me.

There are a bunch of changes in this commit including the changes to loading the pin definitions and expansion of translation info.

Once everyone is hjppy I will merge the changes into the main branch

black-top, 2024-11-21:
I have a pitot tube. I will order MPXV7007DP for pitot and test it when I get it.

DeeEmm, 2024-11-21:
Created #249 - Pitot improvements to capture additional functions / improvements in pitot functionality for V3

KirikauKiwi, 2024-11-23:
- I am able to zero the differential sensor.
- I cannot zero the Pitot value, the reading ∆ ?? inH2O is not getting displayed.
- the main pitot value being displayed appears still to be the pressure value and not the calculated velocity.
- possibly add a coma between from this m/sec ∆??inH2O to m/sec, ∆??inH20

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

KirikauKiwi, 2024-11-23:
Would also be good to distinguish in someway that you have zero'd the display, as with the Differential tile, the display looks the same if it is zero'd or not.

DeeEmm, 2024-11-23:
The pitot behaviour is a bit strange for me to test. As the value is floating and not stable, it tends to jump around a bit.

A colour or intensity change might be appropriate to indicate if it has been zeroed.

At the moment clicking the value zeroes it, but there is no way to 'un-zero' the value.

So perhaps...

- Click value to zero. [value changes colour indicating it has been zeroed]
- Click value to un-zero. [value changes colour  indicating it has been un-zeroed]

This saves adding yet another control to the GUI and follows the existing control philosophy of clicking / touching the value to manipulate it.

Obvious choice is that the colour change could be red = unset / green = zeroed, but could also use an intensity change such as grey = unset / black = zeroed

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

Red / green is obviously much easier to differentiate between, however we might consider reserving red for any error reporting that we might want to add in the future.

So perhaps pink or a reddish orange.

Pink (kinda looks like a muted red)

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

Which is very easy to differentiate from red...

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

Personally I'm a fan of subtlety, and would use grey / back, however this is open to error of interpretation so a more distinct change will help people know whether the value has been zeroed without them needing to 'think'. Plus a black colour does not distinguish it from any other value state, so is easily overlooked.

Light grey...

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

And of course black..

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

We could of course make the colours user definable, but that's definitely a down the track thing.

I will make the changes and we can hone it after.

DeeEmm, 2024-11-24:
Actually discovered an error. Pitot was saving to wrong calibration variable 😨

DeeEmm, 2024-11-24:
OK so above changes are implemented but I've not created a PR yet as I want to do some more testing.

Will finish off testing once real-life work is out of the way. 😄

DeeEmm, 2024-11-24:
Ok, changes now in DEV. including cookies to retain selected tiles across page loads and reporting sensor voltage to API for pDiff and pRef sensors to aid with setting trim pots

24112402 - #213 Pitot / differential zeroing
                - #254 Report sensor voltage to API
                - Cookie to remember tile status

DeeEmm, 2024-11-24:
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

DeeEmm, 2024-11-24:
@KirikauKiwi  comments moved from #249

> Pitot Display
>
> * I cannot get the Pitot to zero, the number is changing colours, however the numerals stay the same.

The numbers are zeroing here but I don't have a pitot to test with, so flying blind a little.

Are you using Build 24112402?

> * The ∆ pressure is only displaying either 0, 1 or 2, you are not able to see the units/ones, or the decimal values.
> * Based on the above I suggest to put the m/sec above the ∆ ??? inH20, keeping them centre aligned, I think this will be less cluttered and give more space for the ∆ to be displayed.

That's the only issue with adding additional chars in there, real estate is very limited. Adding an additional line will increase the overall viewport height as it will also add a line to all of the other tiles.

I'll revert the change. I don't think that there is a need for an additional commer or delimeter as the ∆ symbol itself is the delimiter between the data.

> * The colour changing number are great to identify what can be interacted with and zeroed, like the green, not so much a fan of the pink/salmon colour it disappears in to the background for me, lack of contrast I think.

See comment above ^^^

KirikauKiwi, 2024-11-25:
Yes on Build 24112402, apologies forgot that detail!!!!!
https://github.com/user-attachments/assets/b2f4adf6-eb4a-4e1d-ab64-f404902517db

DeeEmm, 2024-11-25:
Ok think I might have found the issue...

When zeroing the current value is saved as the calibration offset...

Calibration::setPitotCalOffset()
```
  if (calVal.pitot_cal_offset == 0) {
    // update config var
    calVal.pitot_cal_offset = sensorVal.PitotKPA;
    _message.debugPrintf("Calibration::setPitotDeltaOffset %d kPa\n", calVal.pitot_cal_offset);
  } else {
    // update config var
    calVal.pitot_cal_offset = 0.0;
    _message.debugPrintf("Calibration::resetPitotDeltaOffset %d \n", 0.0);
  }

  saveCalibrationData();
```

This value is then used to offset the value assigned in the main task...

TASKgetSensorData( void * parameter )
```
        #ifdef PITOT_IS_ENABLED
        sensorVal.PitotKPA = _sensors.getPitotValue() - calVal.pitot_cal_offset;
        sensorVal.PitotH2O = _calculations.convertPressure(sensorVal.PitotKPA, INH2O) ;
        sensorVal.PitotVelocity = _sensors.getPitotVelocity();
        #endif
```

So we are only zeroing the differential

But, then when we calculate the velocity, it is grabbing the data directly from the sensor rather than the global struct...

```
	pitotPressure = this->getPitotValue();

	// get air density
	airDensity = _calculations.calculateAirDensity(sensorVal.TempDegC, sensorVal.BaroKPA, sensorVal.RelH);
```

It should be...

```
	pitotPressure = sensorVal.PitotKPA;

```

KirikauKiwi, 2024-11-25:
The zeroing is working now.

I think it might be useful to display something where the Velocity is displayed for when the ∆P is negative. I know we shouldn't probably display a negative velocity, well I guess you can, as it means it is in the opposite direction to what is expected.
e.g. Your Pitot tube is connected up incorrectly, P_total and P_static have been connected to the wrong ports and/or something else could be causing a problem.

Secondly if the output for the Pitot sensor was for some reason reading below its cross over point when both ports are open to atmosphere, this won't get displayed currently (negative velocity), so wouldn't alert you to calibrate/offset for pitot MV_TRIMPOT.

https://github.com/user-attachments/assets/2ed255a7-6a7d-4893-a012-909ca90c5f58

DeeEmm, 2024-11-25:
At the moment the velocity value's sign is removed using fabs(). So if there is negative velocity it's just displayed as a positive number.  It was also the same with the differential but I removed fabs() from that after your previous comments. It's trivial to remove it from both but...

I guess the determining factor here is how / where the user zeroes down the value. If they zero the value and then move the probe to a lower pressure area, it will show a negative value.

But I think that we need to consider if this is actually valid use case. The only real way for the value to go negative is for the user to zero down with the probe in the port. If it is zeroed at ambient then this should never happen.

Swapped probe leads should not be an issue. The calcs only look at the differential, not individual port values. In this case the fabs() function actually solves the issue of swapped leads and 'negative' velocity by dropping the sign. So the fact that the probe reads 'backwards' is not an issue if we leave the fabs() function in place. The probe will read correctly no matter which way around the leads are connected. Ultimately a lot more 'fool-proof'.

>if the output for the Pitot sensor was for some reason reading below its cross over point

Define 'some reason'.

If it is an error we are trying to detect with this change, then we should probably check for the specific error and then flag the error to the user.

The planned 'manometer' or graphic display will assist in helping the user to better visualise what is going on with the pitot values, including crossing the zero line.

As with most processes, the procedure itself forms a large part of the correct operation of the device / machine / process. The philosophy of trying to catch deviations from the correct operational procedures can have a large adverse effect on ease of use. Consider it in the same way as calibration. If it's not done correctly, then the bench will be inaccurate. So we have to trust that the user will follow the correct procedure. This is why the Wiki is so important.

KirikauKiwi, 2024-11-25:
Don’t think I explained that very well,
In the video you can see when the delta P goes negative the velocity reads zero.

KirikauKiwi, 2024-11-25:
I hadn't taken a look at the formula in the sensors.cpp for the pitot velocity before now.
```
	// Convert Pitot pressure to velocity (m3/min)
	// airVelocity = sqrt(2 * (pitotPressure - sensorVal.PRefKPA) / airDensity );
	airVelocity = sqrt(2 * (pitotPressure) / airDensity );

	// Lets make sure we have a valid value to return - check it is above minimum threshold
	// TODO - 'borrowing' min_bench_pressure
	double pitotComp = fabs(airVelocity);
	if (pitotComp > config.min_bench_pressure) {
		return airVelocity;
	} else {
		return 0.0001; // return small non zero value to prevent divide by zero errors (will be truncated to zero in display)
	}
```
Yes the fabs will work for the air velocity.  The airVelocity won't return a value for the sqrt of a negative ∆Pressure.

The velocity formula will need to take the absolute value of ∆Pressure.
```
airVelocity = sqrt(2 * abs(pitotPressure) / airDensity );
```

DeeEmm, 2024-11-25:
> Don’t think I explained that very well,
> In the video you can see when the delta P goes negative the velocity reads zero.

Yes understood

The solution is to revert the change where I allow the differential to go negative

BTW. abs() only works for integers. Needs to be fabs() for floats / doubles. You will note that this is already present on line 978

```
double pitotComp = fabs(airVelocity);
```

We only apply this to the result, not the calculation itself

DeeEmm, 2024-11-25:
Should now only display positive values.

When we add the ability to view pitot pressure we will include ability to view =/-ve pressure values.

This is not necessary for velocity for the reasons outlined previously.

Will add item to Wiki update to outline procedure for pitot zeroing / calibration

KirikauKiwi, 2024-12-01:
I have made a pull request #272 with a few suggested changes that should close this out.

DeeEmm, 2025-01-13:
As #272 is now closed I am going to close this oout

Closed 2025-01-13.

Thread 216 (2024-11-10):

[BUG] MAF data sudenly does not show in UI

stefan63, 2024-11-10:
**Software Version**
Version:V.2.0-RC.8
Build:24110901

 Wemos D1 R32
After that the bench has been running for some time (random) the MAF data dissapears and only shows 0.0.
The only way I can get it back is to delete  config.json, liftdata.json AND cal.json and then power cycle the board.
The files above is then recreating themselfs and the board and UI works normal again.
Next time it hapens I will try deleting one file at the time to pinpoint the trouble maker ;)

DeeEmm, 2024-11-11:
Did you manage to replicate this?

stefan63, 2024-11-11:
Yes, will try to upload latest version since I'm still on build:24110901.
I attatch the files, removing the config file kind of solved the problem but when I then change the maf housing size it shows that  X1000 value again. Will report back if problem still valid after update.
[cal.json](https://github.com/user-attachments/files/17702565/cal.json)
[config.json](https://github.com/user-attachments/files/17702566/config.json)
[liftdata.json](https://github.com/user-attachments/files/17702567/liftdata.json)

stefan63, 2024-11-11:
Realized that I had to change the file type to attach html ;)
[index.html.txt](https://github.com/user-attachments/files/17702630/index.html.txt)

DeeEmm, 2024-11-11:
I cannot see anything untoward in the file.

Would definitely recommend updating to the current version in Master (including index.hml file). This contains all recent changes.

stefan63, 2024-11-11:
rev 06 works much better, will try you MAF look up table A.S.A.P

DeeEmm, 2024-11-22:
Is this now resolved with current version in DEV?

DeeEmm, 2025-01-11:
I'm going to close this issue as MAF Code rewritten

Thread 217 (2024-11-11):

Scaled MAF housing returns out of range value

DeeEmm, 2024-11-11:
I am starting to work out the flow of the code!!!! it is a bit like trying to read a foreign language at times.

With the most current build 24111102, I am still getting wacky numbers on the GUI when I enter a value in the MAF Housing diameter on the config page.

They appear at least in the ball park and correct order of magnitude when I divide the result by one million., see below.
```
// Calculate the 'velocity' for the original pipe area
		mafVelocity = flowRateKGH  / PI * pow(status.mafDiameter / 2, 2);

		// scale the result with the new pipe area and convert back to mass flow
		transposedflowRateKGH = mafVelocity * PI * pow(config.maf_housing_diameter / 2, 2) / 1000000;

		return transposedflowRateKGH;
```
This is what I get on the GUI,
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

Again without the divide by one million.
```
		// Calculate the 'velocity' for the original pipe area
		mafVelocity = flowRateKGH  / PI * pow(status.mafDiameter / 2, 2);

		// scale the result with the new pipe area and convert back to mass flow
		transposedflowRateKGH = mafVelocity * PI * pow(config.maf_housing_diameter / 2, 2);

		return transposedflowRateKGH;
```
This is what I get on the GUI,
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

_Originally posted by @KirikauKiwi in https://github.com/DeeEmm/DIY-Flow-Bench/discussions/174#discussioncomment-11208752_

DeeEmm, 2024-11-11:
Confirm that using different MAF diameter results in abnormal / out of range value

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

Will investigate

DeeEmm, 2024-11-11:
Is this related to #203

KirikauKiwi, 2024-11-11:
> Is this related to #203

No, IIRC that was down to and index.html problem, I had an aged index.html, it was a little tricky to get it to update back then, but have had no other problems like that since.

DeeEmm, 2024-11-11:
Cool. kinda lost track as the two have similar symptoms.

KirikauKiwi, 2024-11-11:
If I calculate the values with pen and paper I get values that seem sensible and expected. When I did the divide by one million it puts the displayed values in the correct order of magnitude but I don't think the values are correct.

IIRC when I did the divide, it displayed about 700-800 KGH, when the manually calculated value was about 280KGH.

Good luck hunting the gremlins.

DeeEmm, 2024-11-11:
Need to track down the source that I used. I note that I did not include the URL.

I suspect that it is a scaling error - similar to that you originally suggested with mm / metres, but tied to the mass flow units

DeeEmm, 2024-11-11:
I cant find the source but the conversion formula is pretty well documented.

https://phys.libretexts.org/Bookshelves/College_Physics/College_Physics_1e_(OpenStax)/12%3A_Fluid_Dynamics_and_Its_Biological_and_Medical_Applications/12.01%3A_Flow_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

https://jackwestin.com/resources/mcat-content/fluids/continuity-equation

However the actual way I am using the formula is a bit bodgy. The formula is essentially for volumetric flow. but I am electing to ignore that on the basis that it is essentially just a ratio-metric relationship and that for the instant in time where we convert the value, there cannot be any changes in volume based on environmental changes to temp, baro and RH. So we can safely ignore them and apply the same ratio directly to the Mass Flow value

What we end up with is a simple scaling formula, This is more evident now that I have broken the area calcs out of each formula

```
// Calculate original MAF area
oldMafArea = (PI * pow((status.mafDiameter / 2), 2)) / 1000000;
// Calculate new MAF area
newMafArea = (PI * pow((config.maf_housing_diameter / 2), 2)) / 1000000;

// Calculate the 'velocity' for the original pipe area
mafVelocity = flowRateKGH / oldMafArea;
// scale the result with the new pipe area and convert back to mass flow
transposedflowRateKGH = mafVelocity * newMafArea;

```

I noted your comments relating to m3, which is the SI for Q in the formula Q=VA, so converting the area A into m2 rather than mm2 is the logical change. This is the divide by 1,000,000 aspect. Doing this generates reasonable results and the large values are now gone.

So the maths now appears to be sound, but I think that we still need to validate my bodgy formula. Have I oversimplified the conversion?

I would like to validate what we are seeing in the GUI using a third party method such as an online calculator.

DeeEmm, 2024-11-11:
Changes are on the 'Out-of-range-value-#217' branch

https://github.com/DeeEmm/DIY-Flow-Bench/tree/Out-of-range-value-%23217

DeeEmm, 2024-11-11:
I am getting very close to the GUI value using the following calculators

https://www.sensorsone.com/volumetric-flow-rate-and-diameter-to-flow-velocity-calculator/#volume-flow

and

https://www.sensorsone.com/flow-velocity-and-diameter-to-volume-flow-rate-calculator/

But there is a discrepancy of about 4cfm based on a change from the 82mm MAF to 100mm. However I see the same 4cfm discrepancy testing at 50 cfm as I do at 250cfm, So I suspect that the discrepancy is not as a result of an issue with the calculation but some other variable.

To give some perspective -  240cfm@82mm increases to 360cfm@100mm.

I'm going to create a PR and bring this into the main code. I am mostly satisfied that the calcs work but would like to do further real world testing.

KirikauKiwi, 2024-11-11:
I entered what I had typed unto verify the formulas and passed it through ChatGPT to help with the Markdown formatting and it came up with this below, using 82mm for the MAF mousing and 100mm for the New housing.

**ChatGPT output**
Ah, got it! You want the formulas and explanation **without LaTeX**, but still in a readable format. Below is the step-by-step solution, written in plain HTML for easy understanding.

### Problem Breakdown:

You have two cases for the MAF sensor: one in the original housing and one in a different-sized housing. The objective is to calculate the changes in mass flow rate due to the different cross-sectional areas of the housings, while the velocity of the air remains the same.

---

### Step 1: Case 1 — Solve for Velocity (V1)

The formula for mass flow in **Case 1** (original housing) is:

**m₁ = ρ * A₁ * V₁**

Where:
- **m₁** is the mass flow rate (kg/s),
- **ρ** is the air density (kg/m³) (same for both cases),
- **A₁** is the cross-sectional area of the original housing (m²),
- **V₁** is the air velocity (m/s) in the original housing.

We want to solve for the **velocity** (V₁). To do this, simply rearrange the formula:

**V₁ = m₁ / A₁**

Where:
- **m₁** is the mass flow rate (kg/s) in the original housing.

---

### Step 2: Case 2 — Calculate Mass Flow (m₂) in the New Housing

In **Case 2**, the MAF sensor is in a new housing with a different cross-sectional area **A₂**, but the velocity **V₁** remains the same (because the sensor reads the same air velocity).

The formula for mass flow in **Case 2** is:

**m₂ = ρ * A₂ * V₁**

Since we know **V₁** from Case 1, we can substitute it into the equation:

**m₂ = A₂ * (m₁ / A₁)**

Where:
- **m₂** is the new mass flow rate in the new housing,
- **A₂** is the cross-sectional area of the new housing,
- **A₁** is the cross-sectional area of the original housing,
- **m₁** is the mass flow rate in the original housing.

Rearranging this:

**m₂ = (A₂ / A₁) * m₁**

This equation shows that the mass flow rate **m₂** in the new housing is proportional to the ratio of the areas **A₂ / A₁** and the original mass flow rate **m₁**.

---

### Conclusion:

So, the formula for mass flow in the new housing becomes:

**m₂ = (A₂ / A₁) * m₁**

Where:
- **m₁** is the mass flow rate in the original housing,
- **A₁** is the cross-sectional area of the original housing,
- **A₂** is the cross-sectional area of the new housing.

---

### Example:

Let's say:
- The original mass flow rate **m₁ = 363.5 kg/h**,
- The area of the original housing **A₁ = 82 mm²**,
- The area of the new housing **A₂ = 100 mm²**.

#### Convert Mass Flow Rate to kg/s:
Since we are working in **kg/s**, we first need to convert **m₁** from kg/h to kg/s:

**m₁ = 363.5 kg/h ÷ 3600 = 0.101 kg/s**

#### Calculate Velocity (V₁) in Original Housing:
Now, we can solve for **V₁**:

**V₁ = m₁ / A₁ = 0.101 / (82 x 10⁻⁶) = 1231.7 m/s**

#### Calculate New Mass Flow Rate (m₂) in the New Housing:
Now, use the formula for **m₂**:

**m₂ = (A₂ / A₁) * m₁**

Substitute the values:
- **A₁ = 82 mm² = 82 × 10⁻⁶ m²**
- **A₂ = 100 mm² = 100 × 10⁻⁶ m²**

So:

**m₂ = (100 × 10⁻⁶ / 82 × 10⁻⁶) * 0.101 = 0.123 kg/s**

#### Convert m₂ back to kg/h:
**m₂ = 0.123 * 3600 = 442.8 kg/h**

Thus, in this example, the mass flow rate **m₂** in the new housing would be **442.8 kg/h**, which is higher than the original mass flow rate **m₁ = 363.5 kg/h**, because the area **A₂** is larger than **A₁**.

---

### HTML Representation (Without LaTeX):

```html
<!DOCTYPE html>
<html lang="en">
<head>
    <meta charset="UTF-8">
    <meta name="viewport" content="width=device-width, initial-scale=1.0">
    <title>MAF Sensor Mass Flow Calculation</title>
</head>
<body>
    <h1>MAF Sensor Mass Flow Rate Calculation</h1>

    <p>We have two cases for the MAF sensor:</p>

    <h2>Case 1: Original Housing</h2>
    <p>The mass flow rate in the original housing is:</p>
    <pre><code>m₁ = ρ * A₁ * V₁</code></pre>
    <p>To solve for velocity (V₁), we rearrange the formula:</p>
    <pre><code>V₁ = m₁ / A₁</code></pre>

    <h2>Case 2: New Housing</h2>
    <p>In the new housing, the mass flow rate is:</p>
    <pre><code>m₂ = ρ * A₂ * V₁</code></pre>
    <p>Substitute V₁ from Case 1:</p>
    <pre><code>m₂ = A₂ * (m₁ / A₁)</code></pre>
    <p>Final formula:</p>
    <pre><code>m₂ = (A₂ / A₁) * m₁</code></pre>

    <h3>Example Calculation</h3>
    <p>Given:</p>
    <ul>
        <li>m₁ = 363.5 kg/h</li>
        <li>A₁ = 82 mm²</li>
        <li>A₂ = 100 mm²</li>
    </ul>

    <p>Step 1: Convert m₁ to kg/s:</p>
    <pre><code>m₁ = 363.5 / 3600 = 0.101 kg/s</code></pre>

    <p>Step 2: Solve for V₁:</p>
    <pre><code>V₁ = m₁ / A₁ = 0.101 / (82 × 10⁻⁶) = 1231.7 m/s</code></pre>

    <p>Step 3: Calculate m₂:</p>
    <pre><code>m₂ = (100 × 10⁻⁶ / 82 × 10⁻⁶) * 0.101 = 0.123 kg/s</code></pre>

    <p>Step 4: Convert m₂ to kg/h:</p>
    <pre><code>m₂ = 0.123 * 3600 = 442.8 kg/h</code></pre>

    <h3>Conclusion:</h3>
    <p>The new mass flow rate in the larger housing is 442.8 kg/h.</p>
</body>
</html>
```

---

### Summary:
- **In the new housing**, with the same velocity, the mass flow rate changes because the area of the housing has changed.
- The mass flow rate in the new housing **m₂** can be calculated by multiplying the original mass flow rate **m₁** by the ratio of the areas **A₂ / A₁**.

Let me know if you'd like further clarification or more examples!

KirikauKiwi, 2024-11-11:
So it looks like it can all be done in one calculation!!!!!

**m₂ = (A₂ / A₁) * m₁**

DeeEmm, 2024-11-11:
Essentially the equation that GPT is using

```
m₁ = ρ * A₁ * V₁
```

Is the same that I used, where Q = volumetric flow and mass is ignored. i.e. flow but actual denomination is unimportant

```
Q = V * A
```

The development of the equation uses the continuity equation which states Q1 = Q2 which can be further expressed as

```
V1 * A1 = V2 * A2
```

So when we transpose for V2 we get

```
V2 = (V1 * A1) / A2
```

Which essentially gives the same  result as GPT where it scales the value based on the relationship between A1 - A2

DeeEmm, 2024-11-11:
I'm going to close this out as working.

I will also tidy up the code and include the GPT version as a comment

```
// scale the result with the new pipe area and convert back to mass flow
transposedflowRateKGH = (flowRateKGH / oldMafArea) * newMafArea;

// Chat-GPT version
// transposedflowRateKGH = flowRateKGH * (newMafArea / oldMafArea);
```

Closed 2024-11-11.

Thread 219 (2024-11-11):

[FEATURE REQUEST] Support for RC-Servo operated valves

stefan63, 2024-11-11:
I realize that stepper motor is in the todo list, but I stll want to lift the posibilty to use RC-servos to controll valves.

DeeEmm, 2024-11-11:
Is this PWM output?

stefan63, 2024-11-11:
Yes and there are loads of code hints for esp32 as well as Arduino in general.
https://en.wikipedia.org/wiki/Servo_control

DeeEmm, 2024-11-11:
PWM is pretty trivial to implement but it will require additions electronics as I suspect that the servomotor will exceed the capabilities of standard output current capacity (nominal 500mA). This is easy enough to do using a mosFET. The new PCB also now has a prototype area where additional electronics like this can be added which includes direct access to molex pins.

I suspect that we will also use the same philosophy for PWM based IAT bypass valve to fine control the bleed pressure

KirikauKiwi, 2024-11-11:
The PWM implementation will also be useful for motor control as discussed in #186 Good for DIYFB V3

Thread 220 (2024-11-11):

Maximum flow value for the graph scaling.

DeeEmm, 2024-11-11:
Together with valve lift interval can be added maximum flow value for the graph scaling.

_Originally posted by @black-top in https://github.com/DeeEmm/DIY-Flow-Bench/discussions/189#discussioncomment-11195707_

DeeEmm, 2024-11-11:
@Stefan63 I've added ability to change Datagraph scale. The setting is in the configuration. Please check and let me know if this works for you

black-top, 2024-11-11:
Scaling looks like it is working ok, but the flow numbers are now are completely wrong. Same setup, same cylinder head, all lift curve now read about 10-12CFM,  before at 13mm was 300CFM.

Closed 2024-11-11.

Thread 222 (2024-11-11):

Adjusted Standardised flow

DeeEmm, 2024-11-11:
>Perhaps it is a setting in the configuration and the end user selects one or the other when they initially set their bench up

_Originally posted by @DeeEmm in https://github.com/DeeEmm/DIY-Flow-Bench/issues/208#issuecomment-2466954136_

Closed 2024-11-11.

Thread 224 (2024-11-11):

[BUG]Calibration offset value error

KirikauKiwi, 2024-11-11:
**Software Version**
BUILD_NUMBER "24111107"
RELEASE "V.2.0-RC.8"

I am seeing an incorrect value being generated for the calibration offset, I am using the default 14.4 CFM and 10 inH2O from the calibration orifice settings no other offsets applied.

**My pre calibration flow and pressure**
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

**My post calibration flow and pressure**
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

Is anybody else seeing similar? I should be seeing a Calibration offset of about two, not thirty

KirikauKiwi, 2024-11-11:
Secondly with the leak test offset the PRef "Depression" value should also be zero'd. Using the pictures below, to then get a 28 inH2O change in "Depression" after the leak test I would have to increase my depression from -8 to -36, if it was zero'd with the leak test calibration I can then easily get to my testing "Depression".

**Pre leak test calibration**
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

**Post leak test calibration**
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

DeeEmm, 2024-11-11:
> I am seeing an incorrect value being generated for the calibration offset, I am using the default 14.4 CFM and 10 inH2O from the calibration orifice settings no other offsets applied.

This seems to be the same issue that I found on your PR #214. Are you still using your modified code?

> Secondly with the leak test offset, the PRef "Depression" value should also be zero'd.
> Using the pictures below, to then get a 28 inH2O change in "Depression" after the leak test I would have to increase my depression from -8 to -36, if it was zero'd with the leak test calibration I can then easily get to my testing "Depression" with out having to think.

Same thing applies here. This looks like it could be related to the issue I saw with your PR.

Additionally there is also an issue with terminology. At some point (not sure when) it was requested to change the description from 'pRef' to 'depression'. The issue with that change is that we have now created this 'double negative' issue.

'depression' by definition is 'vacuum'.

Originally the description was Ref Pressure (based on pRef) i.e. pressure.

So we have changed from a -ve value meaning a negative pressure i.e. vacuum, to a -ve value meaning a negative vacuum i.e. pressure - a double negative

All of the underlying code is based on +/- kPa values (pRef), and as with the PR #214 request, there are a lot of underlying code changes that have to happen to be able to flip the sign on the GUI.

The entire code philosophy is now based on SI units (kPa). So we do all calculations based on +/-kPa, DegC, hPa, etc. not depression in inches of water and cubic feet. We just convert the end units for the GUI to give us CFM and inH20. Originally the code was written using imperial maths - as it was based on feet and inches, and TBH it was a nasty mess and hard to follow. Thank heavens for metrification lol.

I would advise in the first case to make sure that you are running the standard unmodified code as the symptoms appear to be in line with the issues that I saw in your PR. Then if you are still seeing an issue we can take a deeper look.

This issue actually has some further value as I also note that a few of the other issues being reported are as a result of using an out of date index.html so I think that I need to add versioning for the generated index.html file.

KirikauKiwi, 2024-11-12:
I not using the formula I suggested in PR #214, this is with the DIYFB STD formula for Flow calibration and leak offsets.
```
// Apply Flow calibration and leak offsets
sensorVal.FlowCFM = sensorVal.FlowCFMraw  - calVal.leak_cal_baseline - calVal.leak_cal_offset - calVal.flow_offset;
```
I did at first have problems with the index.html, I will ask about the index.html in another post to keep them separate.
The formula is working in line with the expected results so I am certain it has reverted back to the DIYFB STD.

Yes understand what you say about the negative values and the depression heading, being a double negative!!!!
Personally I would prefer the  GUI "Title" to say something like Pressure 1 and Pressure 2 as I think this will help keep the code less confusing when reverse flow is implemented etc as the code for the tasks PRef and PDiff are used for, invert PRef will be doing the job of PDiff and vice versa, possible changing of the labelling of the sensors on the PCB too.
- I think currently the "Title" should match what is on the PCB currently.
Need to consider that in V3 the additional Temp sensor needed for reverse flow and its naming too, possibly a new naming convention of example T1, P1 and T2, P2. Temp and Pressure at location 1 & location 2.

Yeah, in agreement about SI units, I think they must of been thought up by someone with a bit of common sense 👍

KirikauKiwi, 2024-11-12:
Thinking forward a little too in relation to reverse flow. What we see currently as a leak is a gain in CFM, in reverse flow the leak will be a loss in CFM and in theory should be the same absolute value., but in reality could be slightly different due to the reverse flow testing will create a positive change for the reverse flow "increased Baro Pressure", where as the corrections for the normal flow direction see a "decreased Baro Pressure"
**From Calculations.cpp**
```
  // TODO validate reference pressure adjustment - do we add it or subtract it? Should be baro pressure less vac amount
  double refPressurePascals = sensorVal.BaroPA - this->convertPressure(sensorVal.PRefKPA, PASCALS) ;
```

DeeEmm, 2024-11-12:
A lot of valid commentary here. I'm breaking this out into a seperate issue - #230 - Standard Terminology

KirikauKiwi, 2024-11-12:
OK hands up 🙌, I had shot myself in the foot, only partially though. I had not rolled back all the formulas.
Which I have now done, so need a fact check as something is still happening with my calibration offset.

***First fact check please***
This is what is have reverted back to.
**DIY-Flo-Bench.ino**
```
        // Apply Flow calibration and leak offsets
        sensorVal.FlowCFM = sensorVal.FlowCFMraw  - calVal.leak_cal_baseline - calVal.leak_cal_offset  - calVal.flow_offset;

        // Create Flow differential values
        switch (sensorVal.FDiffType) {

        case USERTARGET:
          sensorVal.FDiff = sensorVal.FlowCFM - calVal.user_offset;
          strcpy(sensorVal.FDiffTypeDesc, "User Target (cfm)");
          break;

        case BASELINE:
          sensorVal.FDiff = sensorVal.FlowCFMraw - calVal.flow_offset - calVal.leak_cal_baseline;
          strcpy(sensorVal.FDiffTypeDesc, "Baseline (cfm)");
          break;

        case BASELINE_LEAK :
          sensorVal.FDiff = sensorVal.FlowCFMraw - calVal.flow_offset - calVal.leak_cal_baseline - calVal.leak_cal_offset;
          strcpy(sensorVal.FDiffTypeDesc, "Offset (cfm)");
          break;
        
        default:
          break;
        }
```
The leak calibration offset is working correctly, however when I do a calibration offset is is picking up a value higher than expected and it is also a negative, so with it being subtracted from the value we get the double negative and it is adding it to the raw value. This is with no other offsets applied.

**Flow Calibration**
https://github.com/user-attachments/assets/9c422c9a-1106-46f5-9aad-9ffffc37c76c

KirikauKiwi, 2024-11-12:
Now that my calibrations are being saved and applying the offsets correctly I have noticed something else that I would like to ask about too.

Without any calibration or offsets applied I run my theoretical bench and have a leak of 8.3 ACFM and a MAF Flow reading of 17.5 KGH both on the GUI, I do the automatic leak test on DIYFB and it now the respective flow figures are 0.00 ACFM and 0.00 KGH as would be expected, I then start my testing and increase the flow so the ACFM reading increases to say 2.5 ACFM now when I go to see the MAF Flow it is displaying 22.9 KGH.

At my weather conditions this is what I get converting it manually.
2.5 CFM of air under the given conditions (1030 hPa, 22°C, RH = 55.5%) is approximately 4.93 kg/h.

So it looks like the KGH is not being converted when either a Calibration or Leak offset is applied, or the GUI is displaying the actually RAW MAF sensor KGH

@DeeEmm can you confirm this and does it have any affect on the other calculation in DIYFB whilst a calibration and/or any other offset is applied, be it Leak, or User Target.

KirikauKiwi, 2024-11-12:
Regarding my PR #232 , I am running the master code and I am still having problems with the Calibration Flow Test, I have added a message to the PR, that hopefully better explains what is happening when I try to do the Calibration Flow test.

DeeEmm, 2024-11-13:
So what are you seeing in the GUI when you calibrate the flow?

- Disable minimum flow / pressure thresholds to display all flow values
- Reset Flow offset - note the uncorrected ACFM value
- Perform flow calibration - note value of Flow offset + corrected ACFM value

KirikauKiwi, 2024-11-13:
So with all offsets and calibrations set to zero and the minimums set to zero.

- The uncorrected ACFM value is 2.1 CFM
- Calibration flow offset -12 and the corrected ACFM is 14.4 CFM

This is with the default calibration orifice CFM of 14.4

All explained above and in the updated message in the PR #232

KirikauKiwi, 2024-11-13:
Please accept my apologies for wasting your time, I shut everything down did a clean, build and upload and then rebooted the ESP32. the Default DIYFB is working and I can no longer repeat what I was had stated above.

Sorry again for the wild goose chase 🤦‍♂️

KirikauKiwi, 2024-11-13:
I was starting to go a little crazy 😜, I can now walk away with the problem unknowingly and unwittingly resolved with a bit of egg on my face.

DeeEmm, 2024-11-13:
All good. No shame at all in raising an issue where you find one. Please don't stop. I can appreciate that these kind of issues can become massively frustrating.

The way I see it is that it is much better to raise an issue that ends up to be a non-issue, than not raise an issue that ends up significant.

I'm hoping that the versioning for the index.html file will go a long way towards helping diagnosis of problems such as these. We only have a handful of users at the moment and versioning has already been a contributing factor to several issues. So adding versioning is hopefully a good first level sanity check.

KirikauKiwi, 2024-11-13:
Cheers, Yeah there was a bit of flawed thinking going on too.

Closed 2024-11-13.

Thread 225 (2024-11-11):

[FEATURE REQUEST] Add versioning to index.html file

DeeEmm, 2024-11-11:
Build number or versioning to be added to index.html file to help drtermine what version of index.html file is currently being run.

This will help diagnose issues related to out of data index.html files

DeeEmm, 2024-11-16:
Closing - Duplicate of #228

Closed 2024-11-16.

Thread 226 (2024-11-11):

Stepper Driver Testing

DeeEmm, 2024-11-11:
The last remaining outstanding test on the PCB is the stepper drivers.

Need to undertake a test to validate the stepper drivers.

Test does not have to be related to DIYFB project. It can simply consist of arbitrary code to test PCB functionality

DeeEmm, 2024-11-17:
OK so spent this evening testing steppers.

Have unfortunately found the first issue with the PCB. Not entirely sure how, but the direction pin for the flow control stepper
(FLOW_VALVE_DIR_PIN) is assigned to a pin that can only only used for an input (35).

It also seems that the pin mapping differs from the physical layout as there are a few discrepancies, so I suspect that this has happened in the PCB design stage.

A workaround is to jumper a link from the spare output (4), which just happens to be the pin next to it.

I have amended the pin map to suit.

stefan63, 2024-11-24:
Found this regarding pin35
https://www.esp32.com/viewtopic.php?t=26008

DeeEmm, 2024-11-24:
That's interesting. Will have to check was versions the boards I have are.

Closed 2024-11-17.

Thread 227 (2024-11-12):

[FEATURE REQUEST] Swirl Meter

DeeEmm, 2024-11-12:
Following on from discussion #131 - Official Swirl Meter Thread and the push for getting RC9 completed, I have brought forwards the completion of the swirl meter code.

RC9 is a feature lock release for V2. It follows the philosophy that if it is already in the GUI, then it must work. 'No broken features'

As the swirl code was added some time back along with the GUI tile, then it follows that this needs to work.

The bulk of the code is already done, it just needs to be tested. I do already have the hardware outlined in the discussion above, so hopefully the commissioning of the code is relatively trivial.

DeeEmm, 2025-01-28:
https://docs.espressif.com/projects/esp-idf/en/latest/esp32/api-reference/peripherals/pcnt.html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

Thread 228 (2024-11-12):

[FEATURE REQUEST] index.html versioning

DeeEmm, 2024-11-12:
Add versioning to index.html file

Versioning to follow and utilise existing build numbers

Version number to be updated as part of GULP task.

DeeEmm, 2024-11-14:
OK. So I have the index.html versioning working.

This works as a gulp task and replaces a template marker within the HTML with the version number when the file is processed by gulp (compressed / minified / etc).

The resultant 'compiled' index.html file will have the version number 'hardcoded' within it. The only time that this gets overwritten is when the file is recompiled again from source by running the gulp task

The version number itself is pulled from an external file - in this case version.json. I elected to use JSON as it fitted with other aspects of the project and meant that we could use the existing gulp processes to pull in the JSON data without having to use an additional libraries.

Using JSON meant having to partially revisit the post compile stuff that I worked on as part of #205, which also meant that I could pull in the code from that branch saving a bunch of work, whilst also addressing some of the shortfalls that I previously noted.

What this now means is that moving other config files from pre-compile to upload-able JSON files like mafData and configuration.h is now possible. I have actually already moved pin definitions over as part of the current changes as well a getting rid of the external language file. The plan with the language file is to be able to upload an override file, otherwise it just pulls the default language values from structs.

The one thing that really needs to happen next is to implement a similar strategy for the main C++ compiler. This way all versioning can then be managed from within the version.json file

I have a little tidying to do and then I will publish the code.

-------------------------------

There are a bunch of follow on changes that can now be implemented...

- Remote callback to version.json to check if DIYFB is up to date (both firmware and GUI)
- Automated versioning for main DIYFB code
- Move configuration.h into configuration.json #195
- Move MAFdata.h into MAFdata.json #108
- Create languge.json override

DeeEmm, 2024-11-14:
OK. So before moving on to other stuff, I need to update the documentation to support these changes, as well as create new pin files for the other board variants.

To be able to compile this code there are also some changes to the platformio environment, so it is important for this to be captured.

I have also spent some time pondering if I should just complete the remaining changes to move MAF and Config to post compile. TBH the hard part was getting the PINs to work, which has now been resolved, so the changes to MAF and config are relatively trivial.

What this does is it then allows the GUI firmware update to work properly as the compiled binary will be board agnostic. Existing pindefs and configs will be retained across updates. So the provision of the complied binary and index file is all that will be needed. This is a natural progression of the index.html versioning and further narrows down the possibility of mismatched updates.

I know that this might seem like a bit of a detour from the current project path, but I suspect that what I spend in time implementing it I will save tenfold in support.

KirikauKiwi, 2024-11-14:
I have setup a DEV branch on my Git and have had a look at the new stuff,

I have created the pinout.json for the M5 Stack Core2 and also the other board I am working with, the ESPRESSIF ESP32S3-DEV-KIT-C, and  currently having a little error when I try to upload the board specific .json

This is from the serial monitor after I attempt to upload the pins.json
```
Waiting...
[ 58594][E][vfs_api.cpp:332] VFSFileImpl(): fopen(/spiffs/ESPRESSIF_ESP32_S3_DEV_KITC.json) failed
[222777][E][vfs_api.cpp:332] VFSFileImpl(): fopen(/spiffs/ESPRESSIF_ESP32_S3_DEV_KITC.json) failed
```

Looks like I jumped the gun, got ahead of the ball, but had seen the post 8 hours ago and after dinner tonight got in to it and have come back here to see your latest post about updating the documentation and the new pin files.

Should I wait for what you mention above to be done, or would you like me to do a Pull Request so you get the small bit of work I have done on the json pin file etc.

DeeEmm, 2024-11-14:
Sorry I have pins here, just haven't pushed the changes yet. Only just got back into it.

```
{
    "BOARD_TYPE" : "M5STACK-CORE2",
    "VAC_SPEED_PIN" : -1,
    "VAC_BLEED_VALVE_PIN" : -1,
    "VAC_BANK_1_PIN" : 19,
    "VAC_BANK_2_PIN" :-1,
    "VAC_BANK_3_PIN" :-1,
    "AVO_STEP_PIN" :  -1,
    "AVO_DIR_PIN" : -1,
    "FLOW_VALVE_STEP_PIN" : -1,
    "FLOW_VALVE_DIR_PIN" : -1,
    "VCC_3V3_PIN" : -1,
    "VCC_5V_PIN" : 35,
    "SPEED_SENSOR_PIN" :-1,
    "SWIRL_ENCODER_PIN_A" : -1,
    "SWIRL_ENCODER_PIN_B" : -1,
    "ORIFICE_BCD_BIT1_PIN" : -1,
    "ORIFICE_BCD_BIT2_PIN" : -1,
    "ORIFICE_BCD_BIT3_PIN" : -1,
    "MAF_PIN" : -1,
    "REF_PRESSURE_PIN" : -1,
    "DIFF_PRESSURE_PIN" : -1,
    "PITOT_PIN" : -1,
    "TEMPERATURE_PIN" : -1,
    "REF_BARO_PIN" : -1,
    "HUMIDITY_PIN" : -1,
    "SERIAL0_TX_PIN" :1,
    "SERIAL0_RX_PIN" :3,
    "SERIAL2_TX_PIN" :-1,
    "SERIAL2_RX_PIN" :-1,
    "SDA_PIN" : 32,
    "SCL_PIN" : 33,
    "SD_CS_PIN" : 4,
    "SD_MOSI_PIN" : 23,
    "SD_MISO_PIN" : 38,     
    "SD_SCK_PIN" : 18,
    "WEMOS_SPARE_PIN_1": -1
}

```

Not 100% on the error. But I think it might be an error in your platformIO.ini as I had a similar error here.

Take a look at any build flags where  you are defining  overrides and check that there are no spaces

```
	-D LAST_BUILD_TIME=$UNIX_TIME

        # not

	-D LAST_BUILD_TIME = $UNIX_TIME

```

I'm guessing that you are using a custom platformIo.ini. I've actually tidied it up and refactored it a little, so you might need to either pull the changes in to your local version or add any mods you've done into the new version. The changes were part of the requirements for updating the BUILD_NUMBER / VERSION variables in the main code.

You will note that there is a python script called user-actions.py called at compile time. This pulls in the version data from version.json and adds the variables to the build environment so that they replace the variables at compile time.

We check that this has happened at the bottom of system.h which is the file that system configuration precompile directives now reside in. For example...

```
#ifndef MAJOR_VERSION
#error MAJOR_VERSION UNDEFINED
#endif
...
```
Will throw a compiler error if the variables are not present in the environment.

For this process to work you will need to have python installed, which you can install via the platformIO extensions tab.

You can also uncomment the -D defines in the build_flags section in platformIO and comment out the call to user-actions.py but obviously you will then need to manually update the values.

The changes for compiling the index file in gulp are also very similar - read in the variable from the vesion.json file and then replace the GUI_VERSION in the HTML body

With regards to the rest of the code changes, there's a bit of a change to the loading philosophy. Previously everything was set up in the webserver.begin method, but I found that when I was originally working on the precompile stuff, trying to re-jig the code to allow it to fail nicely in the absence of pins data was starting to get really complicated using procedural logic.

So now everything that was in webserver.cpp has been broken out into comms, data and server functions in comms.cpp, datahandler.ccp and webserver.cpp respectively. This has allowed the program flow to be a little more controlled.

The bulk of the initialisation that was done in webserver.begin, is now in datahandler.begin. This is the stuff that you see happening in the serial monitor on boot. Basically setting up the operating environment.

So in the main file DIY-Flow-Bench.ino -> setup() we firstly call datahandler, before we even look at setting up sensors or hardware or starting the Xtasks

```
void setup(void) {

  extern struct Pins pins;

  // Initialise Data environment
  _data.begin();

  // REVIEW
  // set message queue length
  xQueueCreate( 256, 2048);

  _hardware.begin();

  _sensors.begin();
```

Then within the datahandler.begin method we run through the startup items step-by-step, much as we previously did at the top of websever.begin until we get to the index and pins files

```
    if (SPIFFS.exists("/pins.json"))  {
        pinData = loadJSONFile("/pins.json");
        if (!pinData.containsKey("BOARD_TYPE")) doBootLoop = true;
    } else {
        doBootLoop = true;
        _message.serialPrintf("!! pins.json file missing !!\n");    
    }

    // Check for index file
    if (!SPIFFS.exists("/index.html")) {
        doBootLoop = true;
        _message.serialPrintf("!! index.html file missing !!\n");    
    }

    // Initialise WiFi
    _comms.initaliseWifi();

    // Error Handler - critical files are missing !!
    // Manage on-boarding (index and config file uploading)
    // BootLoop method traps program pointer within loop until files are uplaoded
    if (doBootLoop == true) bootLoop();
```

If either file is missing, we set a flag that then calls the bootLoop method.

This essentially sets up a temporary webserver that serves an upload form and waits for the missing files to be uploaded.

```

    _message.serialPrintf("Spinning up temporary web server\n");
    _message.serialPrintf("View browser to upload missing files\n");

    tempServer = new AsyncWebServer(80);
    tempServerEvents = new AsyncEventSource("/events");

    // Upload request handler
    tempServer->on("/upload", HTTP_POST, [](AsyncWebServerRequest *request) {
        Messages _message;
        _message.debugPrintf("/upload \n");
        request->send(200);
        },
        _webserver.processUpload);

    // Index page request handler
    tempServer->on("/", HTTP_ANY, [](AsyncWebServerRequest *request){
        Language language;
        Webserver _webserver;
            request->send_P(200, "text/html", language.LANG_INDEX_HTML, _webserver.processLandingPageTemplate);
        });

    tempServer->onFileUpload(fileUpload);
    tempServer->addHandler(tempServerEvents);
    tempServer->begin();

    _message.serialPrintf("Waiting...\n");

    do {
    // capture program pointer in loop and wait for files to be uploaded

        // Process API comms
        if (config.api_enabled) {
            if (millis() > status.apiPollTimer) {
                if (Serial.available() > 0) {
                    status.serialData = Serial.read();
                    _api.ParseMessage(status.serialData);
                }
            }                    
        }

        if (SPIFFS.exists("/pins.json") && SPIFFS.exists("/index.html")) doLoop = false;

        vTaskDelay( 1 );

    } while (doLoop = true);

    tempServer->reset();

}
```

Once the files are received, it should then exit the boot loop.

I've left the serial API calls in the loop as it can be useful for debugging, however some of the commands will cause the ECU to crash as they are not initialised at this point in the code.

I have found that sometimes when uploading the files it seems to get stuck in the loop, even after the files are uploaded but rebooting the ECU then allows it to boot up normally. It is trivial to force a reboot at this point but I wanted to try and avoid that as then the WiFi needs to be reconnected, which if the end user is doing manually can be a bit frustrating.

Hopefully that gives you a bit of a head start on the new code flow

DeeEmm, 2024-11-15:
^^^ a lot of this stuff is what I'm now trying to capture in the documentation. 😄

KirikauKiwi, 2024-11-15:
Impressed with all the code changes/ refactoring that you have in this update.

DeeEmm, 2024-11-15:
Thanks 😄

Ahh yes, forgot to mention, you will need to rename your pins file to pins.json, otherwise it will not get picked up. Ideally I would like to prefix or suffix the JSON files and then use a wildcard or regex search to ignore the rest of the filename. This way the files would not need to be renamed. But for the time being it needs to be pins.json when it is uploaded.

Hmnnn maybe we could just change the extension to 'pins'. Might be easier to decode. 🤔

KirikauKiwi, 2024-11-15:
Yes, renaming the file to pins.json, seems obvious now when that it states the file names on the upload GUI,
I did however learn that the error that I posted above was due to the file name being too long, SPIFFS has a max file name of 32 characters.

Yes it would great to be able to use a logical and obvious name for the file, I have always been a fan of it does what it says on the can!

One other question is in side the .json file the "BOARD_TYPE" do we have to use, the "#ifdef" name or the '#define BOARD_TYPE' name.
```
#ifdef ESPRESSIF_ESP32_S3_DEV_KITC
#define BOARD_TYPE              "esp32-s3-devkitc-1"
```

I have tried with both now after renaming the file to pins.json and I am now getting similar to what I had with the undefined pins, which -1 fixed, it appears to be back with this update.
```
Defaulting to AP Mode
Creating WiFi Access Point:  DIYFB
Access Point IP address: 192.168.4.1
Multicast: http://diyfb.local
[   438][E][esp32-hal-gpio.c:102] __pinMode(): Invalid pin selected
[   447][E][esp32-hal-gpio.c:102] __pinMode(): Invalid pin selected
[   453][E][esp32-hal-gpio.c:102] __pinMode(): Invalid pin selected
[   459][E][esp32-hal-gpio.c:102] __pinMode(): Invalid pin selected
[   465][E][esp32-hal-gpio.c:102] __pinMode(): Invalid pin selected
[   471][E][esp32-hal-gpio.c:102] __pinMode(): Invalid pin selected
[   478][E][esp32-hal-gpio.c:102] __pinMode(): Invalid pin selected
[   484][E][esp32-hal-gpio.c:102] __pinMode(): Invalid pin selected
```

This is my pins.json, they are set the same as they were before the changing to DEV.
```
{
    "BOARD_TYPE" : "esp32-s3-devkitc-1",
    "VAC_SPEED_PIN" : -1,
    "VAC_BLEED_VALVE_PIN" : -1,
    "VAC_BANK_1_PIN" : 19,
    "VAC_BANK_2_PIN" : -1,
    "VAC_BANK_3_PIN" : -1,
    "AVO_STEP_PIN" : -1,
    "AVO_DIR_PIN" : -1,
    "FLOW_VALVE_STEP_PIN" : -1,
    "FLOW_VALVE_DIR_PIN" : -1,
    "VCC_3V3_PIN" : -1,
    "VCC_5V_PIN" : 1,
    "SPEED_SENSOR_PIN" : -1,
    "SWIRL_ENCODER_PIN_A" : -1,
    "SWIRL_ENCODER_PIN_B" : -1,
    "ORIFICE_BCD_BIT1_PIN" : -1,
    "ORIFICE_BCD_BIT2_PIN" : -1,
    "ORIFICE_BCD_BIT3_PIN" : -1,
    "MAF_PIN" : -1,
    "REF_PRESSURE_PIN" : -1,
    "DIFF_PRESSURE_PIN" : -1,
    "PITOT_PIN" : -1,
    "TEMPERATURE_PIN" : -1,
    "REF_BARO_PIN" : -1,
    "HUMIDITY_PIN" : -1,
    "SERIAL0_TX_PIN" : 43,
    "SERIAL0_RX_PIN" : 44,
    "SERIAL2_TX_PIN" : -1,
    "SERIAL2_RX_PIN" : -1,
    "SDA_PIN" : 8,
    "SCL_PIN" : 9,
    "SD_CS_PIN" : 4,
    "SD_MOSI_PIN" : 23,
    "SD_MISO_PIN" : 38,     
    "SD_SCK_PIN" : 18
}
```
Where do the PIN numbers from the pins.json file end up next to set the pins, with this new method?

DeeEmm, 2024-11-15:
The pins are now assigned in hardware...
```
Hardware::assignIO (JsonObject pinData)
```

We initially pull the JSON data into a struct, the same as we did before with other variables. Using extern structs allows us to easily pass data between methods without having to create convoluted methods to pass by value or reference. We can make entire variable collections available within methods by simply including the reference to the original struct.

```
  extern struct Pins pins;
  extern struct DeviceStatus status;

  status.boardType = pinData["BOARD_TYPE"].as<String>();

  // Store input pin values in struct
  pins.VCC_3V3_PIN = pinData["VCC_3V3_PIN"].as<int>();
  pins.VCC_5V_PIN = pinData["VCC_5V_PIN"].as<int>();
  pins.SPEED_SENSOR_PIN = pinData["SPEED_SENSOR_PIN"].as<int>();
...etc
```

Then further down we assign the I/O...

```
 pinMode(pins.VCC_3V3_PIN, INPUT);
  pinMode(pins.VCC_5V_PIN, INPUT);
  pinMode(pins.SPEED_SENSOR_PIN, INPUT);
  pinMode(pins.ORIFICE_BCD_BIT1_PIN, INPUT);
  pinMode(pins.ORIFICE_BCD_BIT2_PIN, INPUT);
```

DeeEmm, 2024-11-15:
I've included the board type in the pins file as it seems the most logical place.

```
status.boardType = pinData["BOARD_TYPE"].as<String>();
```

JSON also does not support comments, so it provides a way to identify what type of board the file is for.

DeeEmm, 2024-11-15:
So doing the same for the configuration and MAF files is mostly just a case of typing out all of the import statements.

Although I till need to work out how to process arrays in JSON for the MAF data

DeeEmm, 2024-11-15:
@KirikauKiwi I note that the BOARD_NAME you are using is "esp32-s3-devkitc-1". This is (at this stage) just a textual descriptor for user ID purposes. It's not actually used anywhere in the code other than to display in the GUI

Would 'M5STACK-CORE2' be more appropriate and easier to recognise?

KirikauKiwi, 2024-11-15:
They are two different boards, the long winded name is an ESPRESSIF dev board, that is it full name 😂, Since the pins are noe defined externally the PlatformIO board type no longer is need I assume, So I will most likely use a more user friendly name. I had the board sitting around and I am using to stay more in line with the Main DIYFB build currently to better assist in testing etc.

Having some interesting times with the pins with how they are now defined.
So the main problem I am experiencing is that three of the pins that are showing up as invalid are the pin definitions for the BME, So Temp, Baro and RH%>

Do you actually need to define a single pin to an I2C device (unless it has a physical interrupt) as you should only need to define the two pins for the I2C bus, Logically it doesn't make sense to me define a pin to a device that actually needs two pins which are defined already as the I2C bus pins, and since you can have 128 devices on the bus you would run out of pins pretty quickly if they needed to be assigned for each device.
The instance of the device is initialised with the I2CDevice.begin() is it not, so shouldn't need to be assigned to a single pinout.???

DeeEmm, 2024-11-15:
The single pin definitions are unused if the I2C is used. In that case the maf / baro / etc are connected either via the ADS or come from the BME.

If for some reason you did not want to use the BME or ADS, then you could connect directly to the ESP32 via the single pins that are defined.

So it's an either-or situation. You use one or the other

TBH early on we did not really have a standardised setup, so people were using all kinds of sensors connected directly to the ESP. Over time we've found that the best solution by far is to use the BME and ADS connected via I2C as they have far superior resolution when compared to the 12bit resolution of the ESP's inputs.

So it's kind of a legacy situation retained to cater for those who might like to do things a little differently 🤪

~The actual pin initialisation is the same as previously, even using the same values, so it should not act any differently.~

I now remember that you had to test with #ifdefs to determined if the pins were used.

I guess we need a way to replicate this behaviour now that the we have moved to post compile I/O handling

It would be easy enough to test for the -1 value in each case, but that's a whole lot of if then elses.

I will have a ponder to see if I can come up with something a little more elegant.

DeeEmm, 2024-11-15:
So maybe a key=>value array where 'key' is a uint but has a constant definition in the constants.h file

i.e.

```
int 'VCC_3V3_PIN' = 1;
```

Then the array can be iterated in a for loop using the count to index through the key values.

Each value is then tested. If it has a value greater than or equal to zero it gets assigned, if not it gets ignored.

DeeEmm, 2024-11-15:
Or we can just iterate thought it using the pointer.

KirikauKiwi, 2024-11-15:
I think the SDA/SCL pins configs will be fine, it is more the pin configs that are being set for the following.
```
"MAF_PIN" : -1,
"REF_PRESSURE_PIN" : -1,
"DIFF_PRESSURE_PIN" : -1,
"PITOT_PIN" : -1,
"TEMPERATURE_PIN" : -1,
"REF_BARO_PIN" : -1,
 "HUMIDITY_PIN" : -1,
```
Through the process of elimination the four instances of the invalid pins I have narrowed it down to,
```
"PITOT_PIN" : -1,
"TEMPERATURE_PIN" : -1,
"REF_BARO_PIN" : -1,
 "HUMIDITY_PIN" : -1
```
Overall it appears to be the pinouts that are being defined for I2C devices. that are being problematic.

DeeEmm, 2024-11-15:
Have you tried

> Overall it appears to be the pinouts that are being defined for I2C devices. that are being problematic.

The easy test is just comment those pin initialisations in hardware.cpp

```
 // pins.REF_PRESSURE_PIN = pinData["PREF_SRC_PIN"].as<int>();
  // pins.DIFF_PRESSURE_PIN = pinData["PDIFF_SRC_IS_PIN"].as<int>();
  // pins.PITOT_PIN = pinData["PITOT_SRC_IS_PIN"].as<int>();
  // pins.TEMPERATURE_PIN = pinData["TEMPERATURE_PIN"].as<int>();
  // pins.HUMIDITY_PIN = pinData["HUMIDITY_PIN"].as<int>();
  // pins.REF_BARO_PIN = pinData["REF_BARO_PIN"].as<int>();
```

DeeEmm, 2024-11-15:
oops i mean the initalisation (it's late here)

```
pinMode(pins.MAF_PIN, INPUT);
  pinMode(pins.REF_PRESSURE_PIN, INPUT);
  pinMode(pins.DIFF_PRESSURE_PIN, INPUT);
  pinMode(pins.PITOT_PIN, INPUT);
  pinMode(pins.TEMPERATURE_PIN, INPUT);
  pinMode(pins.HUMIDITY_PIN, INPUT);

```

DeeEmm, 2024-11-16:
OK so in latest change to DEV branch I've added a simple check to the pin assignment. If you get a chance to test, let me know if it addresses your pin configuration issues

KirikauKiwi, 2024-11-16:
Quick update, still trying to get to the bottom of this!!!

Hands up another dumb moment whilst burning the midnight oil in the small hours, SO obvious with some sleep 🤦‍♂️ about either using analog or I2C sensors for the Environmental sensors. I got my wires crossed about this because I wasn't thinking correctly about the way the problem I am having is presenting it self!!!!!

So my problems I am looking in to are either related to;
- ~The ESP32 S3 boards have additional pins, up to 45 available compared to the 39 available with the ESP32 boards. Which isn't a problem any longer as the Arduino framework was updated not long after the S3 variant boards came out and the boards are supported in PlatformIO.~
- The pinouts I have defined for my the DEV Kit C board I am using, any pin can be defined as a GPIO due to the way its matrix works,  different to the ESP32 boards. There are a few dedicated pins if you want to us USB +D and-D etc, but these can still be used GPIO pins if not require for the specific feature.
- Layer 1, user problems (Get some sleep!!!!)

I have fixed the layer 1 problem, and update to the this DIYFB version/build,
```
"MAJOR_VERSION" : "V2",
"MINOR_VERSION" : "0",
"BUILD_NUMBER" : "24111601",
"GUI_BUILD_NUMBER" : "24111401",
"RELEASE" : "V2.0.RC.8",
```
**I am all back up and working** with the ESP32 S3 DevKitC-1 board, while researching the problem I was having with the invalid pins, I found some interesting information about setting the pins manually via pinMode, the interaction with Serial.begin, Wire.begin and SPI.begin and board default pin configurations which I will put in a pull request.

KirikauKiwi, 2024-11-16:
One thing that I wasn't sure of initially was when doing the upload and monitor there is an noticeably longer time period passes before you see any output on the serial monitor for the DEV compared to the current master, when it is building the file system etc.
Is it possible to pop a message up before this, as the first couple of time I was thinking that something had stalled.

Now that the process gets past the pin hurdle I was having, the other information after that point showing the status of the file uploading on the serial monitor I found really useful.

Then once the two files are loaded is it possible to print to the serial monitor to "Rest the board" or is this something you can automate with a serial RTS command, then Followed by a "Connect your computer to the DIYFB WiFi" upon the reboot. I think this will help guide other end users through the process of getting DIYFB up and running/connected.

DeeEmm, 2024-11-17:
Great news. 👍

> * The pinouts I have defined for my the DEV Kit C board I am using, any pin can be defined as a GPIO due to the way its matrix works,  different to the ESP32 boards. There are a few dedicated pins if you want to us USB +D and-D etc, but these can still be used GPIO pins if not require for the specific feature.

This is actually true of the ESP32 as well, each pin has multiple potential assignments as can be seen from the WEMOS schematic

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

However, there are some functions that are tied to specific pins, such as the ADC's and comms such as SCL, SDA, MISO, MOSI etc as the rely on hardware componentry that is tied to those physical pins.

In a way this is a similar issue that you face as the M5Stack has additional componentry attached to physical pins (screen etc), which I suspect means that those pins may be hardcoded within the M5 library and not available to reassign.

> One thing that I wasn't sure of initially was when doing the upload and monitor there is an noticeably longer time period passes before you see any output on the serial monitor for the DEV compared to the current master, when it is building the file system etc.

I'm not seeing a delay in the serial monitor here. Whilst you cannot see the API call echoed to the screen, I'm sending '~' to the serial monitor straight after the first load...

https://github.com/user-attachments/assets/27126e05-c849-4ecd-bfb0-d613d95a94b4

The major change that could be causing a small delay is that now we are scanning the filesystem two additional times to look for wildcard file names for PINS_ and MAF_ files. However, we print to the serial monitor before this point

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

There is one other change that might be causing this...

Previously we included the pins definitions as part of the precompile. So they were already available within the code as hardcoded constants. This meant we knew what pins were assigned for Serial 1, so we could begin the serial with the pins assigned...

```
#if defined SERIAL0_ENABLED
Serial.begin(SERIAL0_BAUD, SERIAL_8N1 , SERIAL0_RX_PIN, SERIAL0_TX_PIN);
```
Now that we have moved the pin definition to post compile, the pins are not available until after we have read the PINS_.json file. However, in order to be able to report to the serial monitor. We can still issue a serial begin WITHOUT defining the pins. This will fall back to the default pins for the board. i.e. the USB connection.

This way we are able to start reporting to the serial monitor much earlier in the code. we now do this at the top of DataHandler.begin it is now one of the first things we do...

```
void DataHandler::begin() {

    extern struct ConfigSettings config;
    extern struct Language language;
    extern struct DeviceStatus status;

    Hardware _hardware;
    Pins pins;
    Messages _message;
    Comms _comms;

    StaticJsonDocument<1024> pinData;
    // StaticJsonDocument<1024> mafData;

    // Need to set up the data environment...

    // Start serial comms
    this->beginSerial();

    _message.serialPrintf("\r\nDIY Flow Bench");                                 
    // _message.serialPrintf("\nDIYFB Version: %s \nBuild: %s \nGUI: %s \n", RELEASE, BUILD_NUMBER, GUI_BUILD_NUMBER);                                 
    _message.serialPrintf("\nDIYFB Version: %s \nBuild: %s \n", RELEASE, BUILD_NUMBER);                                 

```

I wonder if that is somehow causing a delay in the M5 library??

DeeEmm, 2024-11-17:
Sorry missed this part...

> Then once the two files are uploaded is it possible to print to the serial monitor to "Rest the board" or is this something you can automate with a serial RTS command, then Followed by a "Connect your computer to the WiFI called DIYFB and then type diyfb.local in to your web browser " upon the reboot.Trying to think how else to guide the user through the process. As most people won't be familiar with browsing to a local add

It is trivial to do a reboot, however once the files are loaded it should automatically redirect to the main page.  I'm trying to avoid forcing a reboot as it disconnects the user from WiFi, and depending on how you have set up your WiFi connection, this can be a PITA (i.e. no auto re-connect + manually typing credentials every time). The main consideration is that it is also possible to get to the upload page after you have booted and are running. This is the case if you delete an existing file to update it, for example as part of an update.

There is a balance between how much info to include in the serial monitor and how much info to keep in the WIKI. On the one hand if you are viewing info via serial monitor and compiling code, we can assume a minimum level of competence. But on the other this may be the first experience for some users. I think that adding a link to the WIKI might be the best bang for buck here and then
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

Thread 230 (2024-11-12):

Standard Terminology

DeeEmm, 2024-11-12:
Yes, I understand what you say about the negative values and the depression heading, being a double negative!!!!
Personally I would prefer the  GUI "Title" to say something like Pressure 1 and Pressure 2 as I think this will help keep the code less confusing when reverse flow is implemented etc as the code for the tasks PRef and PDiff are used for, invert PRef will be doing the job of PDiff and vice versa, possibly consider changing the labelling for the sensors on future PCBs too.

- I think currently the "Title" should match what is on the PCB currently.

Need to consider that in V3 the additional Temp sensor needed for reverse flow and its naming too, possibly a new naming convention for example T1, P1 and T2, P2. Temp and Pressure at location 1 & location 2.

Yeah, in agreement about SI units, I think they must of been thought up by someone with a bit of common sense 👍

--------------------------

_Originally posted by @KirikauKiwi in https://github.com/DeeEmm/DIY-Flow-Bench/issues/224#issuecomment-2469522076_

DeeEmm, 2024-11-12:
> Personally I would prefer the GUI "Title" to say something like Pressure 1 and Pressure 2 as I think this will help keep the code less confusing when reverse flow is implemented etc as the code for the tasks PRef and PDiff are used for, invert PRef will be doing the job of PDiff and vice versa,

This is an interesting consideration and one I had not thought of.  I think that pRef and pDiff retain the same function, but the signs swap with the direction change i.e. vac to pressure.

> * I think currently the "Title" should match what is on the PCB currently.

Also very valid. This is pDiff / pRef / pitot - same as per the code. However it is not exactly a brilliant and inspired choice lol

> Need to consider that in V3 the additional Temp sensor needed for reverse flow and its naming too, possibly a new naming convention for example T1, P1 and T2, P2. Temp and Pressure at location 1 & location 2.

And herein is part of the problem. Initial code development has set some of these descriptions, but without consideration to things like the requirements for reverse flow. Back when I started this I was more concerned with actually making something that worked, so language choices were perhaps not the best.

As I mentioned before there is definitely room for improvement and use of common language i.e. same functional descriptors as used on traditional benches, is the way to go.

I did think of a way that the description for 'Depression' could be retained. It is possible to simply change the test when the bench is running in reverse. i.e. change it to 'Pressure' or similar. The associated code changes for dealing with the sign of the data and how offsets are handled will also ned to be changed but there is definitely value in aligning language with industry norms.

I think we should break this discussion out into a dedicated issue an review it for V3. Currently the language in the GUI is not 'broken' as such, but I will concede that there is a lot of room for improvement. That way we can agree on some standard terminology and then implement it properly.

I am also pushing back on this at this time because I know how much work it will involve.

KirikauKiwi, 2024-11-12:
> Personally I would prefer the GUI "Title" to say something like Pressure 1 and Pressure 2 as I think this will help keep the code less confusing when reverse flow is implemented etc as the code for the tasks PRef and PDiff are used for, invert PRef will be doing the job of PDiff and vice versa,
This is an interesting consideration and one I had not thought of. I think that pRef and pDiff retain the same function, but the signs swap with the direction change i.e. vac to pressure.

Yes this is true regarding the change from vac to pressure.
However DIYFB is using a ratio metric formula for getDifferentialFlow(),code snippet below for the normal flow direction. When reversing the flow won't the two values retrieved by the formula need to be inverted, because the sensorVal.PDiffKPA is actually being measured by PRef sensor in the case of reverse flow situation and vice versa

**getDifferentialFlow()**
```
	// Calculate flow rate based on calibrated orifice data, ref pressure and current pressure drop
	flowRatio = sensorVal.PDiffKPA / sensorVal.PRefKPA;
	flowRateCFM = flowRatio * orificeFlowRate;
```

KirikauKiwi, 2024-11-12:
Or another thought is that the "Titles" for these reading become dynamic, so what ever word is used for the titles gets placed depending on the use of the bench.
e.g. for a Normal flow situation the "Title" for the PRef sensor could stay as "Depression" as long as the absolute of the sensorVal.PRefKPA is used and then that same block "Title" changes to "Pressure" for reverse flow situation and would be displaying the value from sensorVal.PDiffKPA.

That way the GUI would not appear any different to the end user other than the "Titles" changing for the "Depression/Pressure" and then the "Diff pressure" only needs to display the absolute sensorVal.PDiffKPA sensor when in Normal flow and display the sensorVal.PRefKPA for reverse flow mode.

This would keep the language used as industry/accepted norms and remove the problem of the "Depression" currently displaying a negative value.

Food for thought.

KirikauKiwi, 2024-11-12:
Had the thought whilst in #224 that currently the DIYFB GUI is a mix of imperial and metric units and that when you switch to Fahrenheit that the Baro Pressure should switch to inHg or millibars which is the same as hPa 😂 as this is what is typical in the USA, not sure if hPa would be understood in the USA compare to millibars.

I get that CFM is pretty much the global standard for Engine Flow benching, dating back to the equipment being USA centric.

I find it odd here in the UK, originally from NZ. That the UK is essentially metric other than when it comes to distances and speeds being in miles and mph. 🤷‍♂️

DeeEmm, 2024-11-12:
Haha, yes, we went metric back in 1971, although we still used imperial weights and measures for produce up until the 90's, when Brussels forced everyone to switch to g + kg. Some shops still work in thou (mine included) mostly as there is still a lot of imperial machinery still around (that stuff lasts forever).

CAN generally reports in mg/sec, g/min or kg/h depending on the manufacturer (we currently don't support frequency)

MAF ECU maps generally display the values from the transfer function, so what you see is a range of arbitrary Y axis values. There is no standard as such because all transfer functions are different, some are mg/sec, some g/min, kg/h and some are frequency based. So it looks different in each case. Much like speed density tuning it's just an arbitrary load versus RPM (although admittedly MAP is a little easier to comprehend). Tuning is never actually carried out in terms of flow.

For CAN we already have the metric output which is the unconverted MAF value in kg/min. We could add in other units as these are already present in the code

We can also add in m3/min or cc/sec or whatever other units are required but would need to add the conversion code.

KirikauKiwi, 2024-11-13:
Whilst getting involved with DIYFB, I have started to ponder Calibration vs. Compensation and how they could be used in side DIYFB

Here is a summary from ChatGPT.

The terms **calibrated** and **compensated** are often used in the context of test equipment, but they refer to different concepts. Here's a breakdown of the key differences:

### 1. **Calibrated Test Equipment**

**Calibration** refers to the process of adjusting and verifying a piece of equipment against known standards to ensure that its measurements are accurate and within specified tolerances.

- **What it means**: When test equipment is **calibrated**, it has been tested and adjusted to ensure its readings match a reference standard. The equipment is checked against a known and accurate source (like a reference device, national standards, or a certified calibration source).
- **How it works**: Calibration involves comparing the equipment’s readings to a standard and making adjustments (if necessary) to ensure the equipment produces accurate measurements.
- **Purpose**: Calibration is performed to guarantee that the test equipment gives accurate and reliable results over time. It also helps maintain traceability to national or international measurement standards.
- **Example**: A **digital multimeter (DMM)** might be calibrated by comparing its voltage reading to a known reference voltage source (e.g., a precision voltage standard).

**Key Characteristics**:
- Ensures accuracy.
- Done at regular intervals.
- Typically involves adjustments or verification to bring the instrument in line with standard measurements.
- Equipment is issued a **calibration certificate** to show it is within specifications.

---

### 2. **Compensated Test Equipment**

**Compensation** refers to the adjustment made to the equipment to account for known measurement errors or deviations in specific conditions (e.g., temperature, humidity, voltage, or other environmental factors).

- **What it means**: When a test instrument is **compensated**, it is adjusted for known factors that could affect its performance. This might be a setting or correction that adjusts the instrument's readings based on environmental factors, or it could mean pre-setting certain parameters to reduce measurement errors.
- **How it works**: Compensation might not involve the same full verification process as calibration. It often deals with known environmental or operational conditions that affect the equipment's behavior, and software or hardware adjustments are made to correct for these.
- **Purpose**: The goal of compensation is to account for predictable variables that may affect measurements, such as **temperature** or **drift over time**, to keep the equipment within acceptable operational limits. It's a way to mitigate errors without needing to recalibrate.
- **Example**: A **thermometer** might be compensated for its **temperature coefficient** (i.e., how its accuracy drifts with temperature) by including a correction factor in the readout.

**Key Characteristics**:
- Adjusts for specific, known conditions or factors (e.g., temperature, drift, or non-ideal conditions).
- Does not necessarily ensure overall accuracy across all measurements.
- Compensation can be done manually by the user (e.g., entering a correction factor) or automatically by the equipment.
- Does not necessarily involve full verification against standards, unlike calibration.

---

### Key Differences Between Calibration and Compensation:

| Feature                   | **Calibration**                                            | **Compensation**                                              |
|---------------------------|------------------------------------------------------------|---------------------------------------------------------------|
| **Purpose**                | To ensure overall measurement accuracy according to a standard | To adjust for known environmental or operational effects (e.g., temperature, drift) |
| **Process**                | Involves verifying and possibly adjusting the equipment using known standards | Involves applying corrections to account for specific errors |
| **Effect**                 | Ensures the device gives accurate readings in all conditions | Adjusts for specific conditions but does not guarantee absolute accuracy |
| **Verification**           | Requires comparison to a reference or standard | May or may not involve standard comparison |
| **Frequency**              | Typically done periodically or after repairs | Can be done regularly or dynamically (e.g., real-time compensation) |
| **Example**                | Calibrating a digital voltmeter against a precision reference | Compensating a temperature sensor for ambient temperature effects |

---

### Practical Examples:
- **Calibrated Test Equipment**: A **calibrated oscilloscope** might be checked against a precision time base to ensure that its frequency measurements are accurate. The calibration process ensures that the oscilloscope is operating correctly and can be trusted to measure time and voltage correctly.

- **Compensated Test Equipment**: A **compensated power supply** might adjust its voltage output based on the load resistance to maintain consistent output, even though the exact voltage might drift under different conditions. This "compensation" helps the device maintain its performance across various operational environments.

---

### Conclusion:

- **Calibration** is a process of ensuring the accuracy of the equipment by adjusting or verifying its readings against a known standard, ensuring overall correctness.
- **Compensation** is a process of adjusting the equipment's output or readings to account for known or predictable conditions that might affect its performance, without necessarily guaranteeing full accuracy across all conditions.

Both processes are important for maintaining the performance of test equipment, but calibration is typically more comprehensive and tied to standard measurement accuracy, while compensation is about correcting known variables.

DeeEmm, 2024-11-13:
**TLDR**

The software currently does both.

- We calibrate to a known reference standard (even if that standard is of dubious quality lol)

- We compensate for temperature, humidity & barometric changes. Also in the case of Adjusted Flow, we compensate for fluctuations in reference pressure.

Thread 231 (2024-11-12):

[BUG] Wrong flow readings after an update to V2.0-RC.8, build:24111106.

black-top, 2024-11-12:
**Software Version**
- RELEASE (V2.0-RC.8,)
- BUILD_NUMBER (build:24111106)

**Describe the bug**
Wrong flow readings after an update to V2.0-RC.8, build:24111106.

More at https://github.com/DeeEmm/DIY-Flow-Bench/issues/220

> @DeeEmm Scaling looks like it is working ok, but the flow numbers are now are completely wrong. With the latest master. Same setup, same cylinder head, all lift curve now read about 10-12CFM, before at 13mm was about 300CFM. BTW the readings now are very stable; they do not fluctuate at all, but they are not even close to true. CD flow is also wrong now, after calibration now I get -3, before my value was +4, but after calibrating, the flow numbers are still wrong. All settings are the same as before. I tried to change settings to see what could be causing it, but don't see any significant effect from any changes at the settings.
>
> Maybe something with MAF housing calculations is causing it now. I use original MAF housing, so my value always was 0.

black-top, 2024-11-12:
Today's flow readings are about 20 CFM, but it looks like they are stuck, all adjusted, non-adjusted do not change more than a few CFM. I can't find a setting that can cause it, probably something with MAF housing changes in the code.

stefan63, 2024-11-12:
Uploaded Build 24111107 and it worked with  Audi Bosch .......67   but still not with Range Rover ......10 only shows strange low numbers on flow with tha cpp file.

KirikauKiwi, 2024-11-12:
@black-top the MAF Housing calculations are ignored if the value is either 0 or is the same as the internal diameter of the original MAF housing as noted is in the mafData cpp file.
So for the Bosch sensor if 0 or 82 is entered in the GUI config page the calculations are ignored, if any other value is entered the calculations will be processed.

DeeEmm, 2024-11-12:
Is the issue related to the scaling? Can we confirm this.

Also if there was a version that works, can you let me know the build number so that I can do a code compare.

I suspect that an old change may have been pulled in

black-top, 2024-11-13:
Don't know the exact build number, but the master that was working OK was downloaded on November 1.

black-top, 2024-11-13:
I don't see any significant effect on flow readings by changing all settings, especially new ones. So I dont know what is causing it, I just uploaded the (build:24111106) to test the scaling function.

DeeEmm, 2024-11-13:
Ok just so that I understand.

1. The issue is that the flow readings are showing 10-12CFM, but were previously showing 300cfm which is what you would expect from the head being measured.

>I don't see any significant effect on flow readings by changing any settings

2. What settings are you changing and what change are you expecting to see

3. Also, Is this with a scaled MAF housing?

black-top, 2024-11-13:
1: The first day when I tested the new code, flow numbers were stuck at about 10-12CFM. The next day I did some more testing, and the flow was stuck at about 20CFM. At full lift, the head was flowing before the update, about 300CFM, now it just stuck at same number at all lifts and changes only about 1CFM.  The CD flow calibration also does not work anymore, after new flow calibrations, readings are still wrong.  Today I didn't done any more testing.

2: I was just changing all the settings to see if any setting gave effect to the wrong readings to find the problem source.

3 I use the original MAF housing, my scaling was always  0.

black-top, 2024-11-13:
So I uploaded the ( build:24111106) to the spare esp32 board and tested it now, looks like it's working OK. I will try later to do more testing and to rewrite the code to the old esp32 board and test what it is doing.

DeeEmm, 2024-11-13:
> So I uploaded the ( build:24111106) to the spare esp32 board and tested it now, looks like it's working OK. I will try later to do more testing and to rewrite the code to the old esp32 board and test what it is doing.

That's great news. happy to hear that it is working again.

Let me know how you get on

Closed 2024-11-22.

Thread 233 (2024-11-12):

BME68X Pressure sensor integration

DeeEmm, 2024-11-12:
BME68X incorporated in to the code please.

_Originally posted by @KirikauKiwi in https://github.com/DeeEmm/DIY-Flow-Bench/discussions/189#discussioncomment-11230280_

DeeEmm, 2024-11-18:
Started to take a quick peek at this.

First hurdle is always trying to find a good library.

Adafruit is most common, but I will not use their libraries in a project like this as it requires an additional framework. (bloatware)

DFRobot Library is also very bloaty

I previously tried using the Bosch Sensortechnic library for the BME280 but it had a lot of issues, so I am apprehensive about using it again

The author of the TinyBME library that is used currently, does not have an equivalent BME680 library, which is a shame as it is nice and cut down.

The Zanduino library looks fairly lightweight
https://github.com/Zanduino/BME680/tree/master but is written for Arduino so may need porting

Similar story for Seeed, although this still needs trimming down as well
https://github.com/Seeed-Studio/Seeed_Arduino_BME68x/tree/master

I've forked the Zanduino library and will see if I can get it working as it is the most lightweight.

https://github.com/DeeEmm/BME680

DeeEmm, 2024-11-18:
OK, also found the following library which specifically stated it works with the Wemos D1
https://github.com/malokhvii-eduard/arduino-bme280/tree/master

KirikauKiwi, 2024-11-19:
I have my branch of the Pitot/BME68X setup, after uploading my pins.json and index.html, then rebooting. The serial monitor is hanging near the end of the "INPUT"
```
DIY Flow Bench
DIYFB Version: V2.0.RC.8
Build: 24111801
For help please visit the WIKI:
https://github.com/DeeEmm/DIY-Flow-Bench/wiki
Initialising File System
Loading Configuration
Loading Lift Data
Loading Calibration Data
PINS file Found: /PINS_ESP32_S3_DEV_KITC.json
Loading Pins Data
Parsing Pins Data
Defaulting to AP Mode
Creating WiFi Access Point:  DIYFB
Access Point IP address: 192.168.4.1
Multicast: http://diyfb.local
Initialising I/O
Input MAF_PIN: 0
Input REF_PRESSURE_PIN: 0
Input DIFF_PRESSURE_PIN: 0
Input PITOT_PIN: 0
Input SERIAL0_RX_PIN: 44
Input SDA_PIN: 8
Input SCL_PIN: 9
Input SD_MISO_PIN: 0
Input SD_SCK_
```
The SD card is not defined, and my pins.json for my ESP32 S3 DEVKITC board has the pins for the SD card as -1.

When performing a rest on the board the serial monitor hangs at the same place each time, other than the length of the last lines output differs by one or two characters. e.g. Input SD_SCK_, Input SD_SCK_PIN:, Input SD_SCK_PIN: 0

DeeEmm, 2024-11-19:
I eventually pulled the BME280 class files directly into the project so work on them locally, as updating the remote repo quickly became a PITA.

I managed to get the code to compile and loaded, but I do not get any output. I note that even if I manually send hardcoded values direct from classes 'getSensorData' method, I do not see those values in DIYFB. Kinda weird. I suspect that is it some kind of scope issue but haven't been able to find out what's happening.

I then tried to get the example working directly on the ESP32 without the DIYFB code, which should be pretty straightforwards, but was having a lot of dependency issues.

At which point I parked it as it was taking the branch I was working on too far off topic. So I've merged this changes back into Dev so that I can now create a dedicated branch for this issue.

The branch contains all of the changes that I made to integrate the 680 into the code, you will just need to adjust the configuration.h file to enable the BME680 and set temp / baro / relh to BME680.

Rather than uncommenting the library call, I have found that it is easier to copy the DeeEmm_BME680.cpp/h files into the main project directory and work on them locally.

DeeEmm, 2024-11-19:
BTW. I updated the changes that I've made to the library which are mostly just code tidying so that it is readable (I mean seriously who minifies source code lol)

I was in the process of commenting out the API stuff to simplify the code, but did not finish, so this might (probably has) broken the code.

Just uncomment the commented out SPI stuff which is easy enough to spot.

Code is very similar to BME280. Each measurement requires getting values from a bunch of registers - these are defined at top of main file. Those register values are then 'decoded' to generate final values. Not particularly tricky but lots of number crunching so difficult to follow.

We can assume that the number crunching part is okay, it's just how the generated values are accessed from code external to the library.

It should be...

- Create class instance
- Initialise Class / sensor data
- interrogate Class method to obtain values

It seems to be failing on the last part, but could also be any other part. Kinda hard to determine as there are no error messages.

Best bet might be to try and get the example working and then go from there, but I was having trouble setting up my environment to get the example to compile. I had a bunch of issues with project paths. (a local environment issue not necessarily a project issue).

All of those changes are pushed to the library, so feel free to hack on those to get it working, or if it works for you let me know how 😆

KirikauKiwi, 2024-11-20:
With this DEV branch,
```
"MAJOR_VERSION" : "V2",
"MINOR_VERSION" : "0",
"BUILD_NUMBER" : "24111901",
"GUI_BUILD_NUMBER" : "24111702",
"RELEASE" : "V2.0.RC.8",
```

<details><summary>I am getting compile errors with the BME680 library.</summary>
```
libdeps/esp32-s3/DeeEmm BME680/src/DDeeEmm_BME680.cpp:82:1: error: extra qualification 'BME680_Class::' on member 'BME680_Class' [-fpermissive]
 BME680_Class::BME680_Class() {
 ^~~~~~~~~~~~
libdeps/esp32-s3/DeeEmm BME680/src/DDeeEmm_BME680.cpp:82:1: error: 'BME680_Class::BME680_Class()' cannot be overloaded with 'BME680_Class::BME680_Class()'
In file included from libdeps/esp32-s3/DeeEmm BME680/src/DDeeEmm_BME680.cpp:8:
libdeps/esp32-s3/DeeEmm BME680/src/DeeEmm_BME680.h:101:3: note: previous declaration 'BME680_Class::BME680_Class()'
   BME680_Class();                           // Class constructor (unused)
   ^~~~~~~~~~~~
libdeps/esp32-s3/DeeEmm BME680/src/DDeeEmm_BME680.cpp:88:1: error: extra qualification 'BME680_Class::' on member 'BME680_Class' [-fpermissive]
 BME680_Class::~BME680_Class() {
 ^~~~~~~~~~~~
libdeps/esp32-s3/DeeEmm BME680/src/DDeeEmm_BME680.cpp:88:1: error: 'BME680_Class::~BME680_Class()' cannot be overloaded with 'BME680_Class::~BME680_Class()'
In file included from libdeps/esp32-s3/DeeEmm BME680/src/DDeeEmm_BME680.cpp:8:
libdeps/esp32-s3/DeeEmm BME680/src/DeeEmm_BME680.h:102:3: note: previous declaration 'BME680_Class::~BME680_Class()'
   ~BME680_Class();                          // Class destructor (unused)
   ^
libdeps/esp32-s3/DeeEmm BME680/src/DDeeEmm_BME680.cpp:97:6: error: extra qualification 'BME680_Class::' on member 'begin' [-fpermissive]
 bool BME680_Class::begin() {
      ^~~~~~~~~~~~
libdeps/esp32-s3/DeeEmm BME680/src/DDeeEmm_BME680.cpp:97:6: error: 'bool BME680_Class::begin()' cannot be overloaded with 'bool BME680_Class::begin()'
In file included from libdeps/esp32-s3/DeeEmm BME680/src/DDeeEmm_BME680.cpp:8:
libdeps/esp32-s3/DeeEmm BME680/src/DeeEmm_BME680.h:103:11: note: previous declaration 'bool BME680_Class::begin()'
   bool    begin();                          // Start using I2C Communications
           ^~~~~
libdeps/esp32-s3/DeeEmm BME680/src/DDeeEmm_BME680.cpp:106:6: error: extra qualification 'BME680_Class::' on member 'begin' [-fpermissive]
 bool BME680_Class::begin(const uint32_t i2cSpeed) {
      ^~~~~~~~~~~~
libdeps/esp32-s3/DeeEmm BME680/src/DDeeEmm_BME680.cpp:106:6: error: 'bool BME680_Class::begin(uint32_t)' cannot be overloaded with 'bool BME680_Class::begin(uint32_t)'
In file included from libdeps/esp32-s3/DeeEmm BME680/src/DDeeEmm_BME680.cpp:8:
libdeps/esp32-s3/DeeEmm BME680/src/DeeEmm_BME680.h:104:11: note: previous declaration 'bool BME680_Class::begin(uint32_t)'
   bool    begin(const uint32_t i2cSpeed);   // I2C with a non-default speed
           ^~~~~
libdeps/esp32-s3/DeeEmm BME680/src/DDeeEmm_BME680.cpp:116:6: error: extra qualification 'BME680_Class::' on member 'begin' [-fpermissive]
 bool BME680_Class::begin(const uint32_t i2cSpeed, const uint8_t i2cAddress) {
      ^~~~~~~~~~~~
libdeps/esp32-s3/DeeEmm BME680/src/DDeeEmm_BME680.cpp:116:6: error: 'bool BME680_Class::begin(uint32_t, uint8_t)' cannot be overloaded with 'bool BME680_Class::begin(uint32_t, uint8_t)'
In file included from libdeps/esp32-s3/DeeEmm BME680/src/DDeeEmm_BME680.cpp:8:
libdeps/esp32-s3/DeeEmm BME680/src/DeeEmm_BME680.h:106:11: note: previous declaration 'bool BME680_Class::begin(uint32_t, uint8_t)'
   bool    begin(const uint32_t i2cSpeed, const uint8_t i2cAddress);  // Set speed and I2C Addr.
           ^~~~~
libdeps/esp32-s3/DeeEmm BME680/src/DDeeEmm_BME680.cpp:142:6: error: extra qualification 'BME680_Class::' on member 'begin' [-fpermissive]
 bool BME680_Class::begin(const uint8_t chipSelect) {
      ^~~~~~~~~~~~
libdeps/esp32-s3/DeeEmm BME680/src/DDeeEmm_BME680.cpp:142:6: error: 'bool BME680_Class::begin(uint8_t)' cannot be overloaded with 'bool BME680_Class::begin(uint8_t)'
In file included from libdeps/esp32-s3/DeeEmm BME680/src/DDeeEmm_BME680.cpp:8:
libdeps/esp32-s3/DeeEmm BME680/src/DeeEmm_BME680.h:105:11: note: previous declaration 'bool BME680_Class::begin(uint8_t)'
   bool    begin(const uint8_t chipSelect);  // Start using either I2C or HW-SPI
           ^~~~~
libdeps/esp32-s3/DeeEmm BME680/src/DDeeEmm_BME680.cpp:160:6: error: extra qualification 'BME680_Class::' on member 'begin' [-fpermissive]
 bool BME680_Class::begin(const uint8_t chipSelect, const uint8_t mosi, const uint8_t miso,
      ^~~~~~~~~~~~
libdeps/esp32-s3/DeeEmm BME680/src/DDeeEmm_BME680.cpp:160:6: error: 'bool BME680_Class::begin(uint8_t, uint8_t, uint8_t, uint8_t)' cannot be overloaded with 'bool BME680_Class::begin(uint8_t, uint8_t, uint8_t, uint8_t)'
In file included from libdeps/esp32-s3/DeeEmm BME680/src/DDeeEmm_BME680.cpp:8:
libdeps/esp32-s3/DeeEmm BME680/src/DeeEmm_BME680.h:107:11: note: previous declaration 'bool BME680_Class::begin(uint8_t, uint8_t, uint8_t, uint8_t)'
   bool    begin(const uint8_t chipSelect, const uint8_t mosi, const uint8_t miso, const uint8_t sck);
           ^~~~~
libdeps/esp32-s3/DeeEmm BME680/src/DDeeEmm_BME680.cpp:182:6: error: extra qualification 'BME680_Class::' on member 'commonInitialization' [-fpermissive]
 bool BME680_Class::commonInitialization() {
      ^~~~~~~~~~~~
libdeps/esp32-s3/DeeEmm BME680/src/DDeeEmm_BME680.cpp:182:6: error: 'bool BME680_Class::commonInitialization()' cannot be overloaded with 'bool BME680_Class::commonInitialization()'
In file included from libdeps/esp32-s3/DeeEmm BME680/src/DDeeEmm_BME680.cpp:8:
libdeps/esp32-s3/DeeEmm BME680/src/DeeEmm_BME680.h:118:12: note: previous declaration 'bool BME680_Class::commonInitialization()'
   bool     commonInitialization();                      ///< Common initialization code
            ^~~~~~~~~~~~~~~~~~~~
libdeps/esp32-s3/DeeEmm BME680/src/DDeeEmm_BME680.cpp:208:9: error: extra qualification 'BME680_Class::' on member 'readByte' [-fpermissive]
 uint8_t BME680_Class::readByte(const uint8_t addr) const {
         ^~~~~~~~~~~~
libdeps/esp32-s3/DeeEmm BME680/src/DDeeEmm_BME680.cpp:208:9: error: 'uint8_t BME680_Class::readByte(uint8_t) const' cannot be overloaded with 'uint8_t BME680_Class::readByte(uint8_t) const'
In file included from libdeps/esp32-s3/DeeEmm BME680/src/DDeeEmm_BME680.cpp:8:
libdeps/esp32-s3/DeeEmm BME680/src/DeeEmm_BME680.h:119:12: note: previous declaration 'uint8_t BME680_Class::readByte(uint8_t) const'
   uint8_t  readByte(const uint8_t addr) const;          ///< Read byte from register address
            ^~~~~~~~
libdeps/esp32-s3/DeeEmm BME680/src/DDeeEmm_BME680.cpp:221:6: error: extra qualification 'BME680_Class::' on member 'reset' [-fpermissive]
 void BME680_Class::reset() {
      ^~~~~~~~~~~~
libdeps/esp32-s3/DeeEmm BME680/src/DDeeEmm_BME680.cpp:221:6: error: 'void BME680_Class::reset()' cannot be overloaded with 'void BME680_Class::reset()'
In file included from libdeps/esp32-s3/DeeEmm BME680/src/DDeeEmm_BME680.cpp:8:
libdeps/esp32-s3/DeeEmm BME680/src/DeeEmm_BME680.h:113:11: note: previous declaration 'void BME680_Class::reset()'
   void    reset();                                      // Reset the BME680
           ^~~~~
libdeps/esp32-s3/DeeEmm BME680/src/DDeeEmm_BME680.cpp:237:6: error: extra qualification 'BME680_Class::' on member 'getCalibration' [-fpermissive]
 void BME680_Class::getCalibration() {
      ^~~~~~~~~~~~
libdeps/esp32-s3/DeeEmm BME680/src/DDeeEmm_BME680.cpp:237:6: error: 'void BME680_Class::getCalibration()' cannot be overloaded with 'void BME680_Class::getCalibration()'
In file included from libdeps/esp32-s3/DeeEmm BME680/src/DDeeEmm_BME680.cpp:8:
libdeps/esp32-s3/DeeEmm BME680/src/DeeEmm_BME680.h:122:12: note: previous declaration 'void BME680_Class::getCalibration()'
   void     getCalibration();                            ///< Load calibration from registers
            ^~~~~~~~~~~~~~
libdeps/esp32-s3/DeeEmm BME680/src/DDeeEmm_BME680.cpp:298:9: error: extra qualification 'BME680_Class::' on member 'setOversampling' [-fpermissive]
 uint8_t BME680_Class::setOversampling(const uint8_t sensor, const uint8_t sampling) const {
         ^~~~~~~~~~~~
libdeps/esp32-s3/DeeEmm BME680/src/DDeeEmm_BME680.cpp:298:9: error: 'uint8_t BME680_Class::setOversampling(uint8_t, uint8_t) const' cannot be overloaded with 'uint8_t BME680_Class::setOversampling(uint8_t, uint8_t) const'
In file included from libdeps/esp32-s3/DeeEmm BME680/src/DDeeEmm_BME680.cpp:8:
libdeps/esp32-s3/DeeEmm BME680/src/DeeEmm_BME680.h:108:11: note: previous declaration 'uint8_t BME680_Class::setOversampling(uint8_t, uint8_t) const'
   uint8_t setOversampling(const uint8_t sensor, const uint8_t sampling = UINT8_MAX) const;  // and return current value
           ^~~~~~~~~~~~~~~
libdeps/esp32-s3/DeeEmm BME680/src/DDeeEmm_BME680.cpp:360:9: error: extra qualification 'BME680_Class::' on member 'setIIRFilter' [-fpermissive]
 uint8_t BME680_Class::setIIRFilter(const uint8_t iirFilterSetting) const {
         ^~~~~~~~~~~~
libdeps/esp32-s3/DeeEmm BME680/src/DDeeEmm_BME680.cpp:360:9: error: 'uint8_t BME680_Class::setIIRFilter(uint8_t) const' cannot be overloaded with 'uint8_t BME680_Class::setIIRFilter(uint8_t) const'
In file included from libdeps/esp32-s3/DeeEmm BME680/src/DDeeEmm_BME680.cpp:8:
libdeps/esp32-s3/DeeEmm BME680/src/DeeEmm_BME680.h:110:11: note: previous declaration 'uint8_t BME680_Class::setIIRFilter(uint8_t) const'
   uint8_t setIIRFilter(const uint8_t iirFilterSetting = UINT8_MAX) const;  // Set IIR Filter
           ^~~~~~~~~~~~
libdeps/esp32-s3/DeeEmm BME680/src/DDeeEmm_BME680.cpp:379:9: error: extra qualification 'BME680_Class::' on member 'getSensorData' [-fpermissive]
 uint8_t BME680_Class::getSensorData(int32_t& temp, int32_t& hum, int32_t& press, int32_t& gas,
         ^~~~~~~~~~~~
libdeps/esp32-s3/DeeEmm BME680/src/DDeeEmm_BME680.cpp:379:9: error: 'uint8_t BME680_Class::getSensorData(int32_t&, int32_t&, int32_t&, int32_t&, bool)' cannot be overloaded with 'uint8_t BME680_Class::getSensorData(int32_t&, int32_t&, int32_t&, int32_t&, bool)'
In file included from libdeps/esp32-s3/DeeEmm BME680/src/DDeeEmm_BME680.cpp:8:
libdeps/esp32-s3/DeeEmm BME680/src/DeeEmm_BME680.h:111:11: note: previous declaration 'uint8_t BME680_Class::getSensorData(int32_t&, int32_t&, int32_t&, int32_t&, bool)'
   uint8_t getSensorData(int32_t &temp, int32_t &hum,  int32_t &press, int32_t &gas,  const bool waitSwitch = true);  //
           ^~~~~~~~~~~~~
libdeps/esp32-s3/DeeEmm BME680/src/DDeeEmm_BME680.cpp:396:9: error: extra qualification 'BME680_Class::' on member 'getI2CAddress' [-fpermissive]
 uint8_t BME680_Class::getI2CAddress() const {
         ^~~~~~~~~~~~
libdeps/esp32-s3/DeeEmm BME680/src/DDeeEmm_BME680.cpp:396:9: error: 'uint8_t BME680_Class::getI2CAddress() const' cannot be overloaded with 'uint8_t BME680_Class::getI2CAddress() const'
In file included from libdeps/esp32-s3/DeeEmm BME680/src/DDeeEmm_BME680.cpp:8:
libdeps/esp32-s3/DeeEmm BME680/src/DeeEmm_BME680.h:112:11: note: previous declaration 'uint8_t BME680_Class::getI2CAddress() const'
   uint8_t getI2CAddress() const;                        // Return the I2C Address of the BME680
           ^~~~~~~~~~~~~
libdeps/esp32-s3/DeeEmm BME680/src/DDeeEmm_BME680.cpp:403:9: error: extra qualification 'BME680_Class::' on member 'readSensors' [-fpermissive]
 uint8_t BME680_Class::readSensors(const bool waitSwitch) {
         ^~~~~~~~~~~~
libdeps/esp32-s3/DeeEmm BME680/src/DDeeEmm_BME680.cpp:403:9: error: 'uint8_t BME680_Class::readSensors(bool)' cannot be overloaded with 'uint8_t BME680_Class::readSensors(bool)'
In file included from libdeps/esp32-s3/DeeEmm BME680/src/DDeeEmm_BME680.cpp:8:
libdeps/esp32-s3/DeeEmm BME680/src/DeeEmm_BME680.h:120:12: note: previous declaration 'uint8_t BME680_Class::readSensors(bool)'
   uint8_t  readSensors(const bool waitSwitch);          ///< read the registers in one burst
            ^~~~~~~~~~~
libdeps/esp32-s3/DeeEmm BME680/src/DDeeEmm_BME680.cpp:506:6: error: extra qualification 'BME680_Class::' on member 'waitForReadings' [-fpermissive]
 void BME680_Class::waitForReadings() const {
      ^~~~~~~~~~~~
libdeps/esp32-s3/DeeEmm BME680/src/DDeeEmm_BME680.cpp:506:6: error: 'void BME680_Class::waitForReadings() const' cannot be overloaded with 'void BME680_Class::waitForReadings() const'
In file included from libdeps/esp32-s3/DeeEmm BME680/src/DDeeEmm_BME680.cpp:8:
libdeps/esp32-s3/DeeEmm BME680/src/DeeEmm_BME680.h:121:12: note: previous declaration 'void BME680_Class::waitForReadings() const'
   void     waitForReadings() const;                     ///< Wait for readings to finish
            ^~~~~~~~~~~~~~~
libdeps/esp32-s3/DeeEmm BME680/src/DDeeEmm_BME680.cpp:512:6: error: extra qualification 'BME680_Class::' on member 'setGas' [-fpermissive]
 bool BME680_Class::setGas(uint16_t GasTemp, uint16_t GasMillis) const {
      ^~~~~~~~~~~~
libdeps/esp32-s3/DeeEmm BME680/src/DDeeEmm_BME680.cpp:512:6: error: 'bool BME680_Class::setGas(uint16_t, uint16_t) const' cannot be overloaded with 'bool BME680_Class::setGas(uint16_t, uint16_t) const'
In file included from libdeps/esp32-s3/DeeEmm BME680/src/DDeeEmm_BME680.cpp:8:
libdeps/esp32-s3/DeeEmm BME680/src/DeeEmm_BME680.h:109:11: note: previous declaration 'bool BME680_Class::setGas(uint16_t, uint16_t) const'
   bool    setGas(uint16_t GasTemp, uint16_t GasMillis) const;  // Gas heating temperature and time
           ^~~~~~
libdeps/esp32-s3/DeeEmm BME680/src/DDeeEmm_BME680.cpp:560:6: error: extra qualification 'BME680_Class::' on member 'measuring' [-fpermissive]
 bool BME680_Class::measuring() const {
      ^~~~~~~~~~~~
libdeps/esp32-s3/DeeEmm BME680/src/DDeeEmm_BME680.cpp:560:6: error: 'bool BME680_Class::measuring() const' cannot be overloaded with 'bool BME680_Class::measuring() const'
In file included from libdeps/esp32-s3/DeeEmm BME680/src/DDeeEmm_BME680.cpp:8:
libdeps/esp32-s3/DeeEmm BME680/src/DeeEmm_BME680.h:114:11: note: previous declaration 'bool BME680_Class::measuring() const'
   bool    measuring() const;                            ///< true if currently measuring
           ^~~~~~~~~
libdeps/esp32-s3/DeeEmm BME680/src/DDeeEmm_BME680.cpp:571:6: error: extra qualification 'BME680_Class::' on member 'triggerMeasurement' [-fpermissive]
 void BME680_Class::triggerMeasurement() const {
      ^~~~~~~~~~~~
libdeps/esp32-s3/DeeEmm BME680/src/DDeeEmm_BME680.cpp:571:6: error: 'void BME680_Class::triggerMeasurement() const' cannot be overloaded with 'void BME680_Class::triggerMeasurement() const'
In file included from libdeps/esp32-s3/DeeEmm BME680/src/DDeeEmm_BME680.cpp:8:
libdeps/esp32-s3/DeeEmm BME680/src/DeeEmm_BME680.h:115:11: note: previous declaration 'void BME680_Class::triggerMeasurement() const'
   void    triggerMeasurement() const;                   ///< trigger a measurement
           ^~~~~~~~~~~~~~~~~~
libdeps/esp32-s3/DeeEmm BME680/src/DDeeEmm_BME680.cpp:578:1: error: expected '}' at end of input
 }  // of method "triggerMeasurement()"
 ^
In file included from libdeps/esp32-s3/DeeEmm BME680/src/DDeeEmm_BME680.cpp:8:
libdeps/esp32-s3/DeeEmm BME680/src/DeeEmm_BME680.h:94:20: note: to match this '{'
 class BME680_Class {
                    ^
libdeps/esp32-s3/DeeEmm BME680/src/DDeeEmm_BME680.cpp: In member function 'bool BME680_Class::begin(uint8_t)':
libdeps/esp32-s3/DeeEmm BME680/src/DDeeEmm_BME680.cpp:157:3: error: 'SPI' was not declared in this scope
   SPI.begin();                                    // Start hardware SPI
   ^~~
libdeps/esp32-s3/DeeEmm BME680/src/DDeeEmm_BME680.cpp:157:3: note: suggested alternative: 'HSPI'
   SPI.begin();                                    // Start hardware SPI
   ^~~
   HSPI
libdeps/esp32-s3/DeeEmm BME680/src/DDeeEmm_BME680.cpp: In member function 'void BME680_Class::getCalibration()':
libdeps/esp32-s3/DeeEmm BME680/src/DDeeEmm_BME680.cpp:252:50: error: no matching function for call to 'BME680_Class::getData(const uint8_t&, uint8_t [((BME680_Class*)this)->BME680_Class::BME680_COEFF_SIZE1])'
   getData(BME680_COEFF_START_ADDRESS1, coeff_arr1);  // Split reading registers into 2
                                                  ^
In file included from libdeps/esp32-s3/DeeEmm BME680/src/DDeeEmm_BME680.cpp:8:
libdeps/esp32-s3/DeeEmm BME680/src/DeeEmm_BME680.h:147:34: note: candidate: 'template<class T> uint8_t& BME680_Class::getData(uint8_t, T&) const'
   template <typename T> uint8_t &getData(const uint8_t addr, T &value) const {
                                  ^~~~~~~
libdeps/esp32-s3/DeeEmm BME680/src/DeeEmm_BME680.h:147:34: note:   template argument deduction/substitution failed:
libdeps/esp32-s3/DeeEmm BME680/src/DDeeEmm_BME680.cpp:252:50: note:   variable-sized array type 'uint8_t [((BME680_Class*)this)->BME680_Class::BME680_COEFF_SIZE1]' {aka 'unsigned char [((BME680_Class*)this)->BME680_Class::BME680_COEFF_SIZE1]'} is not a valid template argument
   getData(BME680_COEFF_START_ADDRESS1, coeff_arr1);  // Split reading registers into 2
                                                  ^
libdeps/esp32-s3/DeeEmm BME680/src/DDeeEmm_BME680.cpp:253:50: error: no matching function for call to 'BME680_Class::getData(const uint8_t&, uint8_t [((BME680_Class*)this)->BME680_Class::BME680_COEFF_SIZE2])'
   getData(BME680_COEFF_START_ADDRESS2, coeff_arr2);  // one 25 bytes and the other 16
                                                  ^
In file included from libdeps/esp32-s3/DeeEmm BME680/src/DDeeEmm_BME680.cpp:8:
libdeps/esp32-s3/DeeEmm BME680/src/DeeEmm_BME680.h:147:34: note: candidate: 'template<class T> uint8_t& BME680_Class::getData(uint8_t, T&) const'
   template <typename T> uint8_t &getData(const uint8_t addr, T &value) const {
                                  ^~~~~~~
libdeps/esp32-s3/DeeEmm BME680/src/DeeEmm_BME680.h:147:34: note:   template argument deduction/substitution failed:
libdeps/esp32-s3/DeeEmm BME680/src/DDeeEmm_BME680.cpp:253:50: note:   variable-sized array type 'uint8_t [((BME680_Class*)this)->BME680_Class::BME680_COEFF_SIZE2]' {aka 'unsigned char [((BME680_Class*)this)->BME680_Class::BME680_COEFF_SIZE2]'} is not a valid template argument
   getData(BME680_COEFF_START_ADDRESS2, coeff_arr2);  // one 25 bytes and the other 16
                                                  ^
libdeps/esp32-s3/DeeEmm BME680/src/DDeeEmm_BME680.cpp: At global scope:
libdeps/esp32-s3/DeeEmm BME680/src/DDeeEmm_BME680.cpp:578:1: error: expected unqualified-id at end of input
 }  // of method "triggerMeasurement()"
 ^
libdeps/esp32-s3/DeeEmm BME680/src/DeeEmm_BME680.cpp:78:1: error: extra qualification 'BME680_Class::' on member 'BME680_Class' [-fpermissive]
 BME680_Class::BME680_Class() {
 ^~~~~~~~~~~~
libdeps/esp32-s3/DeeEmm BME680/src/DeeEmm_BME680.cpp:78:1: error: 'BME680_Class::BME680_Class()' cannot be overloaded with 'BME680_Class::BME680_Class()'
In file included from libdeps/esp32-s3/DeeEmm BME680/src/DeeEmm_BME680.cpp:1:
libdeps/esp32-s3/DeeEmm BME680/src/DeeEmm_BME680.h:101:3: note: previous declaration 'BME680_Class::BME680_Class()'
   BME680_Class();                           // Class constructor (unused)
   ^~~~~~~~~~~~
libdeps/esp32-s3/DeeEmm BME680/src/DeeEmm_BME680.cpp:83:1: error: extra qualification 'BME680_Class::' on member 'BME680_Class' [-fpermissive]
 BME680_Class::~BME680_Class() {
 ^~~~~~~~~~~~
libdeps/esp32-s3/DeeEmm BME680/src/DeeEmm_BME680.cpp:83:1: error: 'BME680_Class::~BME680_Class()' cannot be overloaded with 'BME680_Class::~BME680_Class()'
In file included from libdeps/esp32-s3/DeeEmm BME680/src/DeeEmm_BME680.cpp:1:
libdeps/esp32-s3/DeeEmm BME680/src/DeeEmm_BME680.h:102:3: note: previous declaration 'BME680_Class::~BME680_Class()'
   ~BME680_Class();                          // Class destructor (unused)
   ^
libdeps/esp32-s3/DeeEmm BME680/src/DeeEmm_BME680.cpp:94:6: error: extra qualification 'BME680_Class::' on member 'begin' [-fpermissive]
 bool BME680_Class::begin() {
      ^~~~~~~~~~~~
libdeps/esp32-s3/DeeEmm BME680/src/DeeEmm_BME680.cpp:94:6: error: 'bool BME680_Class::begin()' cannot be overloaded with 'bool BME680_Class::begin()'
In file included from libdeps/esp32-s3/DeeEmm BME680/src/DeeEmm_BME680.cpp:1:
libdeps/esp32-s3/DeeEmm BME680/src/DeeEmm_BME680.h:103:11: note: previous declaration 'bool BME680_Class::begin()'
   bool    begin();                          // Start using I2C Communications
           ^~~~~
libdeps/esp32-s3/DeeEmm BME680/src/DeeEmm_BME680.cpp:100:6: error: extra qualification 'BME680_Class::' on member 'begin' [-fpermissive]
 bool BME680_Class::begin(const uint32_t i2cSpeed) {
      ^~~~~~~~~~~~
libdeps/esp32-s3/DeeEmm BME680/src/DeeEmm_BME680.cpp:100:6: error: 'bool BME680_Class::begin(uint32_t)' cannot be overloaded with 'bool BME680_Class::begin(uint32_t)'
In file included from libdeps/esp32-s3/DeeEmm BME680/src/DeeEmm_BME680.cpp:1:
libdeps/esp32-s3/DeeEmm BME680/src/DeeEmm_BME680.h:104:11: note: previous declaration 'bool BME680_Class::begin(uint32_t)'
   bool    begin(const uint32_t i2cSpeed);   // I2C with a non-default speed
           ^~~~~
libdeps/esp32-s3/DeeEmm BME680/src/DeeEmm_BME680.cpp:105:6: error: extra qualification 'BME680_Class::' on member 'begin' [-fpermissive]
 bool BME680_Class::begin(const uint32_t i2cSpeed, const uint8_t i2cAddress) {
      ^~~~~~~~~~~~
libdeps/esp32-s3/DeeEmm BME680/src/DeeEmm_BME680.cpp:105:6: error: 'bool BME680_Class::begin(uint32_t, uint8_t)' cannot be overloaded with 'bool BME680_Class::begin(uint32_t, uint8_t)'
In file included from libdeps/esp32-s3/DeeEmm BME680/src/DeeEmm_BME680.cpp:1:
libdeps/esp32-s3/DeeEmm BME680/src/DeeEmm_BME680.h:106:11: note: previous declaration 'bool BME680_Class::begin(uint32_t, uint8_t)'
   bool    begin(const uint32_t i2cSpeed, const uint8_t i2cAddress);  // Set speed and I2C Addr.
           ^~~~~
libdeps/esp32-s3/DeeEmm BME680/src/DeeEmm_BME680.cpp:127:6: error: extra qualification 'BME680_Class::' on member 'begin' [-fpermissive]
 bool BME680_Class::begin(const uint8_t chipSelect) {
      ^~~~~~~~~~~~
libdeps/esp32-s3/DeeEmm BME680/src/DeeEmm_BME680.cpp:127:6: error: 'bool BME680_Class::begin(uint8_t)' cannot be overloaded with 'bool BME680_Class::begin(uint8_t)'
In file included from libdeps/esp32-s3/DeeEmm BME680/src/DeeEmm_BME680.cpp:1:
libdeps/esp32-s3/DeeEmm BME680/src/DeeEmm_BME680.h:105:11: note: previous declaration 'bool BME680_Class::begin(uint8_t)'
   bool    begin(const uint8_t chipSelect);  // Start using either I2C or HW-SPI
           ^~~~~
libdeps/esp32-s3/DeeEmm BME680/src/DeeEmm_BME680.cpp:141:6: error: extra qualification 'BME680_Class::' on member 'begin' [-fpermissive]
 bool BME680_Class::begin(const uint8_t chipSelect, const uint8_t mosi, const uint8_t miso,const uint8_t sck) {
      ^~~~~~~~~~~~
libdeps/esp32-s3/DeeEmm BME680/src/DeeEmm_BME680.cpp:141:6: error: 'bool BME680_Class::begin(uint8_t, uint8_t, uint8_t, uint8_t)' cannot be overloaded with 'bool BME680_Class::begin(uint8_t, uint8_t, uint8_t, uint8_t)'
In file included from libdeps/esp32-s3/DeeEmm BME680/src/DeeEmm_BME680.cpp:1:
libdeps/esp32-s3/DeeEmm BME680/src/DeeEmm_BME680.h:107:11: note: previous declaration 'bool BME680_Class::begin(uint8_t, uint8_t, uint8_t, uint8_t)'
   bool    begin(const uint8_t chipSelect, const uint8_t mosi, const uint8_t miso, const uint8_t sck);
           ^~~~~
libdeps/esp32-s3/DeeEmm BME680/src/DeeEmm_BME680.cpp:157:6: error: extra qualification 'BME680_Class::' on member 'commonInitialization' [-fpermissive]
 bool BME680_Class::commonInitialization() {
      ^~~~~~~~~~~~
libdeps/esp32-s3/DeeEmm BME680/src/DeeEmm_BME680.cpp:157:6: error: 'bool BME680_Class::commonInitialization()' cannot be overloaded with 'bool BME680_Class::commonInitialization()'
In file included from libdeps/esp32-s3/DeeEmm BME680/src/DeeEmm_BME680.cpp:1:
libdeps/esp32-s3/DeeEmm BME680/src/DeeEmm_BME680.h:118:12: note: previous declaration 'bool BME680_Class::commonInitialization()'
   bool     commonInitialization();                      ///< Common initialization code
            ^~~~~~~~~~~~~~~~~~~~
libdeps/esp32-s3/DeeEmm BME680/src/DeeEmm_BME680.cpp:181:9: error: extra qualification 'BME680_Class::' on member 'readByte' [-fpermissive]
 uint8_t BME680_Class::readByte(const uint8_t addr) const {
         ^~~~~~~~~~~~
libdeps/esp32-s3/DeeEmm BME680/src/DeeEmm_BME680.cpp:181:9: error: 'uint8_t BME680_Class::readByte(uint8_t) const' cannot be overloaded with 'uint8_t
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

Thread 234 (2024-11-12):

Basic version of PWM close loop pressure control.

DeeEmm, 2024-11-12:
The basic version of PWM close loop pressure control.

_Originally posted by @black-top in https://github.com/DeeEmm/DIY-Flow-Bench/discussions/189#discussioncomment-11223082_

DeeEmm, 2024-11-13:
> @DeeEmm mentioned about available power from the shield

VAC_BLEED_VALVE_PIN is already assigned for PWM or analog control of a 'bleed device'. It can be used for either

VAC_SPEED_PIN provides an analog output that can be connected to a VFD.

The ESP32 only has those two ADC converters, so depending on what speed control philosophy is used, the VAC_SPEED_PIN may need to drive either a VFD or a PWM style ICV / DBW device.

The overall current limit for the shield is determined by the LM2596 Buck PSU's which should provide up to 3amps with no heat sink. So we have 3v@3A plus 5v@3A. For 12v the limit is whatever sized PSU you are using to power the shield. Consider that any PWM controlled DBW or IAVC valve will require 12v as they will invariably be an automotive device so the limiting factor there is the 12v PSU.

There is a 50mA current limit on the ESP outputs. There is also a voltage disparity as well, the ESP is a 3.3v device, so it cannot drive a 5v/10v/12v device. So some form of mosFET needs to be used. Something like the IRLB8721PB which has a low enough gate voltage that it can be driven by the 3.3v output. This will allow the ESP32's ADC to drive PWM based devices at whatever current / voltage is required up to 30v/60A.

To drive a VFD, again some form of transistor will be needed. This time a mosFET is not needed as this is a low current application, so something like the trusty old 2N2222 should work just fine. Full voltage needs to be limited to 10v as the VFD requires a 0-10v reference.

For switching 12v device via the ULN2003 there is a 0.5A limit per channel, so an interposing transistorised relay is recommended. (vac motors / etc)

The stepper drivers are direct from the 12V bus. If you use an A4988 they will supply up to 3A, which will happily drive a NEMA 32 which is massive overkill for this application.

As far as using hobby servos are concerned, my advice is don't. They are not robust enough. This is essentially a semi-industrial process / machine. So component selection is important to ensure reliability and accuracy. Pay the extra few dollars for something reliable.

The choice of using something like a NEMA 14 for the valve lift is so that it can drive a lead screw that operates on the valve stem. This has the advantage of a massive force multiplication. from a typical 18Ncm NEMA 14, driving a 1mm pitch you will get 120N of force. That's a 666% increase. I appreciate that the spring is changed, but when you have 28" of pressure pushing against the valve, that's a lot of force.

Of course, there are many ways to skin a cat.

KirikauKiwi, 2024-11-14:
Thanks, this is really helpful in explaining the overall scope and the roadmap for you DIYFB project.

Thread 236 (2024-11-13):

[FEATURE REQUEST]V3, Data Display accessed from Configuration GUI page

KirikauKiwi, 2024-11-13:
Would it be useful to have a data display page that is accessible like the "Info" page is.

The idea would be to display the live sensor voltages and the sensor readings with their native units and possibly the calculated and converted values too.

I think this could be useful while trouble shooting any possible anomalies you may experience with the DIYFB like a possible faulty pressure sensor etc.

Sort of a diagnostics display.

DeeEmm, 2024-11-13:
Could also add the I/O status to this as well.

DeeEmm, 2024-12-10:
Also need to integrate #274 Trimpot Tuning into this

DeeEmm, 2024-12-10:
Additional items

- Zeroing of differential sensor voltages
- Trimpot zeroing
- General calibration / sensor reporting

DeeEmm, 2024-12-13:
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

Have a very basic modal working.

You can view it by enabling in webmaster tools. Look for datModal in the source and then set display: block

DeeEmm, 2024-12-18:
An update on this issue.

The changes to add additional modal dialogs for displaying additional data fields resulted in GUI latency issues.

The latency is not only as a result of this change, but rather that this change was the proverbial straw that broke the camels back. The actual issue is memory related and largely as a result of the changes made as part of #205 - Post Compile Configuration where data previously resident in pre-compile macros was moved into JSON files and stored in SPIFFS.

The issue there was that to load the data into run-time memory it required that it was first loaded into a JSON object before it could be assigned to run-time variables. The net result was that the data occupied twice the memory, which then caused various memory issues.

The solution to this has been to move the post compile data from JSON files into NVM. The method from which NVM 'preferences' can be moved into runtime vars is much less memory intensive.

So at the moment I am moving all settings and preferences into the NVM memory space, which will free up memory on the stack to be used for things like a data display page and also allow for an easier user experience as there will be no JSON files to manage

Added to this I have also rewritten the basic sitemap and navigational relationship between functions. Essentially now everything gets it's own dedicated HTML page and javascript header. This keeps individual page load times and sizes to an absolute minimum, which also helps to manage memory requirements.

There's still a lot of core code changes to undertake before the GUI can be fixed up. Hoping to get those done before xmas.

DeeEmm, 2025-01-05:
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

Mimic page now added as pat of the conversion to use NVM for system settings.

Code still being tested but currently an issue with the MAF conversion to be resolved.

Going to close this item out as complete. We can add to / edit content of mimic page as required.

Closed 2025-01-05.

Thread 238 (2024-11-16):

WIKI Updates

DeeEmm, 2024-11-16:
With the recent changes and upcoming RC9 release there are (and are yet to be) a lot of changes to the functionality of the code.

Whilst I try to make sure that all such changes are captured int he WIKI to support code changes, there is a definite opportunity to updated the WIKI along side existing changes.

If there is anything that you want to see, or feel could be improved on, discuss below.

DeeEmm, 2024-11-17:
From #228 Linking WIKI to GUI for targetted help...

>... in the GUI after the user has connected by Wifi with the 'Please upload the following files". This will detect which files are missing and ask for them, This could be easily expanded with additional prompts on what to do for each file.

> For example we could add something like this for the pins file...

```
Upload the PINS.JSON file for your board. This can be found in the PINS folder of the project.
If you do not see a file for your board, please see the WIKI for instructions on how to create one.
```

>We can then link directly to the relevant section.

KirikauKiwi, 2024-11-17:
Would it be useful as many starting with flow testing/porting etc may not be aware of the ball park figures of CFM to theoretical HP they may need from a flow bench, which may help them with bench design, motor selection, MAF selection. I know most of this information is out there already.

~Should I choose the RS4 MAF or the ACDELCO etc. using the very ball park figure of 0.5 CFM per HP the ACDELCO MAF would be good for about 590HP per cylinder as 277CFM @ 28inH2O vac is about 296 CFM at 1 atm and the ACDELCO should give better resolution compared to the BOSCH RS4 0-4V up to the limit of ACDELCO~ probably don't need to bore the end user with that, TLDR is that the ACDELCO is good for about 590HP per cylinder, more than enough for most I would think. @DeeEmm did I get that about right as it was question I had about MAF selection?

DeeEmm, 2024-11-17:
Yes sounds about right.

There are MAF data files for a couple of ACDELCO MAFs. but only one has validated data: the ACDELCO_92281162. This is basically the LS2 MAF used by GM and Holden all most LS2 based engines. Commonly available and easy to source.

The big question about MAF selection is the transfer data / data file. Very few have accurate published data. So often the choice is driven by available data rather then ideal MAF size.

At the top of the MAF Data files there is some info on flow rates and whether the data has been validated

I think it would be good to add a table into the WIKI that includes flow rates and potential horsepower / Kw ratings based on the airflow figures along with the validation / test status of the data.

DeeEmm, 2024-11-17:
BTW, all of the MAF data that we currently have has come from online sources.

For clarity:

**Validated** data is data where the provenance has been validated. I.e. known to work, either from being officially published OEM data, or used as part of something like the Megasquirt project. It is not necessarily validated by the DIYFB project, but equally is not just randomly untested published data.

**Tested** data is where the data has been tested on a DIYFB bench and the results verified

DeeEmm, 2024-11-17:
The table can also link direct to the MAF files in the Repo.

Can also have the same kind of data for pins files - a table that outlines available types etc - can also link to direct to file in repo

DeeEmm, 2024-11-24:
/cib

DeeEmm, 2024-11-24:
/cib

KirikauKiwi, 2024-11-25:
Would it be worth mentioning in the WIKI.
To recommend using a USB isolator when connecting your computer to the DIYFB shield, when the shield is being powered by its own PSU.

DeeEmm, 2024-11-25:
OK MAF table added to WIKI...

https://github.com/DeeEmm/DIY-Flow-Bench/wiki/Component-selection

DeeEmm, 2024-11-25:
> Would it be useful as many starting with flow testing/porting etc may not be aware of the ball park figures of CFM to theoretical HP they may need from a flow bench, which may help them with bench design, motor selection, MAF selection. I know most of this information is out there already.

It is hard to know how much info to include. The project will support pretty much any bench, so there is no ideal one size fits all, there are also vast differences in opinions on what a bench should / shouldn't be or include. for example the eternal 28" reference argument versus floating depression style benches. I feel that steering people too much may ultimately be bad for the project.

Flow figures differ vastly between heads, depending on type and valve size. A two valve wedge shaped head will flow a lot different to a multivalve pent roof head. A 30mm valve will flow differently to a 40mm valve. Porting shop A is different porting shop B. So HP targets are not something that can be easily generalised. I think that this side of things can be left to the user to find out.

I think some details that point to what the users need to consider without steering them towards any particular solution is a good idea.

DeeEmm, 2024-11-25:
#213 - Outline procedure for pitot zeroing / calibration along with differential sensor zeroing / calibration

DeeEmm, 2024-11-25:
Further comments from above thread...

> When you build your bench, make provision for fitting extra motors, then just blank off the extra holes. Its almost zero extra work, but one day you may be very glad you did this.

> Yes I definitely want to make sure it's open for that. I played with the numbers some it looks like 5 of those motors are kinda the magic number to be able to flow up to 350cfm area at 28"(44").

Elsewhere there are comments that outline the drivers for motor selection

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

DeeEmm, 2024-11-25:
Haha, didn't even notice this initially...

They have a dedicated page for flow bench motors...

> The vacuum motors on this page are suggested for your use with the "FlowBench" plans from [www.flowbenchtech.com](http://www.flowbenchtech.com/)

https://centralvacuummotor.com/flowbench.htm#gsc.tab=0

They list two motors

- LLH9563
- LH2093

I think that this data along with the selection process above gives a great starting point for vac motor selection.

I will wrap this up and add it to the Wiki

DeeEmm, 2024-11-26:
OK. Done - https://github.com/DeeEmm/DIY-Flow-Bench/wiki/Vacuum-Motor-Selection

DeeEmm, 2024-11-28:
Added some additional 'getting started / installation' pages to the WIKI. On-boarding is now a lot easier to understand. Still need to flesh out the differential bench stuff and create some connection diagrams along with updating the configuration pages

I've added the details for the firmware flasher installation pathway as currently the online expressif tool can be used. This will make it easier for the non-tech savvy to get it up and running provided they are using the default / recommended setup.

https://github.com/DeeEmm/DIY-Flow-Bench/wiki/Installation

Would really love to get the post-compile stuff sorted out for V2 as well. I know that this is a bunch of extra work but I think that for the V2 release it would round the release out nicely and be a good starting point for what happens next.

DeeEmm, 2024-12-12:
From #279 - update procedure for initial Buck PSU voltage set up and trim pot settings

DeeEmm, 2025-01-16:
WIKI Updated.

DeeEmm, 2025-01-30:
Need to update WIKI and add links in mimic for new items

DeeEmm, 2025-02-04:
Need to update MAF table with new sensors

DeeEmm, 2025-02-08:
Updated WIKI broke sensor selection out into separate section with dedicated pages for MAF / Pressure / Environmental sensors

Closed 2025-02-08.

Thread 239 (2024-11-17):

Update Serial API calls

DeeEmm, 2024-11-17:
Fitting in with the ethos of "if its currently part of the project it needs to work", the API needs a quick review and update once the RC9 stuff has been finalised.

There's not too much to do, just a quick review and update.

If there are any additional API calls that would be of use, list them below and we can potentially include them as part of the update

DeeEmm, 2024-11-17:
I will add that at this point in time the API HTTP access is a long way behind the API serial access. This will likely remain this way until V3 where we can address this as a seperate item.

I will create a seperate item for that

KirikauKiwi, 2024-11-18:
For the pressure sensors on the ADS1115,
- PRef add the Gauge value kPa
- add PDiff with ADC Value, Voltage and Gauge value kPa
- add Pitot with ADC Value, Voltage and Gauge value kPa

IIRC for the MAF sensor, these 3 reading from the ADS1115 are already in the serial API.

Would it be useful to display the PWM values and the DAC values too, they could be useful for trouble shooting when people are adding a MOSFET or OPAMP to drive their peripherals.

DeeEmm, 2024-11-24:
> * PRef add the Gauge value kPa

This is already available as part of Enum1 [E]

> * add PDiff with ADC Value, Voltage and Gauge value kPa

Added... all ADC voltage values under and raw values under [a]

[A] - ADC Voltage values
[a] - ADC Raw values

This is good from the perspective that we have now free'd up the secondary API function for each sensor (lower case values), which was previously used as voltage for most sensors. We can now customise the secondary value for something else.

> * add Pitot with ADC Value, Voltage and Gauge value kPa

Added...

[P] - Pitot value (in/H20) - Note main API values report same units as GUI.

[e] - enum2 - Pitot kPa values + Swirl value - kPa value available as part of Enums

So we have main enum [E] which reports general values and [e] which reports secondary values.

> IIRC for the MAF sensor, these 3 reading from the ADS1115 are already in the serial API.

Yes. For MAF there is the Raw MAF value [M], MAF voltage [m] and flow in kg/h [f], which is a little out of line from other sensor values.

But now we are reporting all voltages and RAW ADC values under the ADC API call, we can re-jig things a little

So main values are reported as such...

[M] - MAF Flow in KG/h
[D] - Differential in in/H2O
[T] - Temp in Deg C
[B] - Baro in hPa
[R] - Reference pressure in in/H20
[H] - Humidity in %
[P] - Pitot value in in/H2O

Nice and easy to remember

However, at present [S] is currently used for WIFI SSID and [s] for SPIFFS file list, So I've moved those to [W] and [/] respectively

We can now use secondary values for something different

[m] - MAF secondary function
[p] - Pitot secondary function
etc..

This is probably most useful for calibration / setup process - for example like tuning or setting up the trimpots as we were discussing in #254

I vote that for the time being we reserve these secondary functions in lieu of utilising them for initial setup (whatever that might look like).

ATM I'm trying to get the workflow automation working for auto branch creation. I'll upload the changes once I've got that figure out.

DeeEmm, 2024-11-24:
ahh yes - summary of current API functions...

```
  DIYFB API Commands
  ==============================
  API Response Format
  Command : Value : Checksum
  ==============================
  3 : 3.3V Voltage Value
  5 : 5V Voltage Value
  A : ADC Voltage Values
  a : ADC Raw Values
  B : Barometric Pressure
  C : Flow Offset Calibration
  D : Differential Pressure value
  E : Enum1
  F : Flow Value in CFM
  f : Flow Value in KG/H
  H : Humidity Value
  I : IP Address
  J : JSON Status Data
  j : JSON Configuration Data
  K : MAF Data Key Value
  k : MAF Data Lookup Value
  L : Leak Test Calibration
  l : Leak Test
  M : MAF RAW ADC Value
  m : MAF Voltage
  N : Hostname
  o : Active Orifice
  P : Pitot Value
  Q : MAF Data Max Value
  q : MAF Data Key Max Value
  R : Reference Pressure Value
  S : Swirl value
  T : Temperature in Celcius
  t : Temperature in Fahrenheit
  U : Uptime in hhhh.mm
  V : Version
  v : Valve lift data in JSON format
  W : WiFi SSID
  X : xTask memory usage
  ? : Help
  / : SPIFFS File List
  ~ : Restart ESP
  $ : Reset WiFi
  @ : Stream Status
  ! : Debug Mode
  < : Last Error
  ==============================
```

DeeEmm, 2024-11-25:
OK, looks like the workflow actions are now working.

Adding an assignee automagically creates a branch.

Will create a PR for the API changes

DeeEmm, 2024-11-25:
Ignore the most recent activity - Just testing the workflow out.

I've added the additional API functionality for setup to issue #242 and rolled it up with the WIKI changes for new users.

Makes more sense to look at that process holistically - documentation + GUI + Serial + etc

I'll close this out for the time being.

We can always add more suggestions + reopen later.

KirikauKiwi, 2024-11-25:
Should the new Serial API be working with Build 24112402, or has it not been rolled out in a release yet?
As the new commands I have tried are not reporting anything back.

DeeEmm, 2024-11-25:
Yes it should be.

Take a look at what is reported when you send '?'

Should be the same as above

DeeEmm, 2024-11-25:
Ooops no sorry

24112501 onwards

DeeEmm, 2024-11-25:
It's in the PR linked above

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

DeeEmm, 2024-11-29:
After looking at #266 I just remembered that we are able to interrogate the API whilst in the boot loop, however some of the API functions are not initialised at that point.

Need to mask those items that result in incorrect data / kernel panics when in boot loop.

Easy enough to do with the **status.doBootLoop** variable

DeeEmm, 2024-12-10:
Boot loop API items now masked (build 2412060044)

Closed 2024-12-10.

Thread 242 (2024-11-19):

[FEATURE REQUEST] WIKI

stefan63, 2024-11-19:
For a newbee on flow benches maybee a section of the WIKI could help to straighten some ?? in regards of flow bench types :)
Ilustration would be helpfull.
What differs those types and how do they work, where to place the sensors/hoses?
1. MAF based , "the new black"
2. Pressure drop
3. Orifice
4. Venturi

I know how to solder and take messurements (and some coding) but the worings of the flow bench types make my head spin haha...

Kind regards/Stefan

DeeEmm, 2024-11-19:
Yes we definitely need to expand the existing WIKI info to include the differential style / pressure style bench now that we have it in the code. This is currently missing.

I think it might also be good to leverage @danielerpl's experience with using the PTS plans to build a bench as this is equally applicable to other differential style benches.

DeeEmm, 2024-11-25:
I'm going to roll this action up with some additional items to improve the on-boarding process for new users.

#239 - Utilise API to assist with initial setup

danielerpl, 2024-11-25:
> Yes we definitely need to expand the existing WIKI info to include the differential style / pressure style bench now that we have it in the code. This is currently missing.
>
> I think it might also be good to leverage @danielerpl's experience with using the PTS plans to build a bench as this is equally applicable to other differential style benches.

For sure! if you need any info I am here to help everyone

DeeEmm, 2025-01-16:
I've now updated the WIKI to include info on the settings, configuration and pins pages. Clicking on the info icon on any tiles on those pages opens up the relevant section of the WIKI in a new window...

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

(maybe we need a 'dark mode' for the GUI 😄 )

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

Thread 244 (2024-11-19):

[FEATURE REQUEST]Suggested simplification of "Resolution and Accuracy" in GUI Configuration.

KirikauKiwi, 2024-11-19:
I am suggesting a small change to the Resolution and Accuracy in the GUI Configuration page.

**From this**
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

**To this**
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

It is easier to understand and feels more intuitive for me.
With these selections for Rounding and Decimal places on the GUI, does it only affect the displayed values, and not the data values used in the calculations etc.

DeeEmm, 2024-11-20:
Ahh yes. Agreed. Makes more sense.

DeeEmm, 2024-11-20:
It's funny. Had to look at the source for your post as the notification that I received showed that you had posted the HTML code.

Was scratching my head trying to work out how you managed to get the CSS from the project to work here in the forums.

😆🤣😆

KirikauKiwi, 2024-11-20:
I did first try and post the HTML as I was not sure if it was possible to or not!!!, so I edited the comment and replaced the html with photos instead!!!!

DeeEmm, 2024-11-22:
So changing the descriptions is trivial and done. However combining the decimal places with rounding is not so trivial.

We pass the decimal places directly to the GUI javascript via AJAX.

So, for FLOW_DECIMAL_LENGTH dropdown selection values...

- No DP = 0
- 1 DP (0.1) = 1
- 2 DP (0.01) = 2

We pass this value directly to the GUI...

```
 document.getElementById(key).innerHTML = myObj[key].toFixed(~FLOW_DECIMAL_LENGTH~);
```

So it is not possible to add an additional value for 0.5, even though this makes sense, as rounding and DP are different mathematical functions.

So the rounding and decimal places functions need to remain seperate for the time being as they apply to two different parts of the code.

I have changed the language as suggested for the DP drop-downs, and also changed the terminology of the rounding to further differentiate it from the DP to remove any ambiguity.

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

We can of course revisit this down the track but given the amount of work still to do for RC9 I'm going to close this out for now.

KirikauKiwi, 2024-11-23:
It amazes my that Human logic is often apparently simple, but at times still difficult in the binary world. I guess that is good for us Humans vs the Robots.

KirikauKiwi, 2024-11-23:
The decimal point shift and the rounding are only happening at the GUI level, is that correct?

If so would a more approbate Heading for this section possibly be?
**Display Resolution**

DeeEmm, 2024-11-23:
Yes only at the GUI level.  Rounding at the calc level just introduces error.

The original intent is only to make it easier to read (for a human). i.e. to help prevent the rapid changing of fractional values in the GUI.

This effect does not impact data collection or API values as the data snapshot grabs all sensor data within a microsecond window. As such it is impervious to such change.

Closed 2024-11-22.

Thread 245 (2024-11-20):

[BUG]DEV branch, The serial monitor is hanging near the end of the "INPUT" pin initialisations.

KirikauKiwi, 2024-11-20:
The serial monitor is hanging near the end of the "INPUT" with the latest DEV branch. This is happening with my ESP32 S3 board setup.
```
DIY Flow Bench
DIYFB Version: V2.0.RC.8
Build: 24111901
For help please visit the WIKI:
https://github.com/DeeEmm/DIY-Flow-Bench/wiki
Initialising File System
Loading Configuration
Loading Lift Data
Loading Calibration Data
PINS file Found: /PINS_ESP32_S3_DEV_KITC.json
Loading Pins Data
Parsing Pins Data
Defaulting to AP Mode
Creating WiFi Access Point:  DIYFB
Access Point IP address: 192.168.4.1
Multicast: http://diyfb.local
Initialising I/O
Input MAF_PIN: 0
Input REF_PRESSURE_PIN: 0
Input DIFF_PRESSURE_PIN: 0
Input PITOT_PIN: 0
Input SERIAL0_RX_PIN: 44
Input SDA_PIN: 8
Input SCL_PIN: 9
Input SD_MISO_PIN: 0
Input SD_SCK_P
```
The SD card is not defined, and my pins.json for my ESP32 S3 DEVKITC board has the pins for the SD card as -1.

When performing a rest on the board the serial monitor hangs at the same place each time, other than the length of the last lines output differs by one or two characters. e.g. Input SD_SCK_, Input SD_SCK_PIN:, Input SD_SCK_PIN: 0

I have also tried with the pins defined as my boards default SPI pins, with the same results in the serial monitor.
```
"SD_CS_PIN" : 10,
"SD_MOSI_PIN" : 11,
"SD_MISO_PIN" : 13,     
"SD_SCK_PIN" : 12,
```

_Originally posted by @KirikauKiwi in https://github.com/DeeEmm/DIY-Flow-Bench/issues/233#issuecomment-2486878468_

DeeEmm, 2024-11-20:
The issue will be the line after

This look to be the 'WEMOS_SPARE_PIN_1'

This is not present in the M5Stack pins.json file, which is I suspect why it is failing. This line need to be present.

KirikauKiwi, 2024-11-20:
I am currently working on the other board and not the M5 Stack.

This is my pins.json, the memos spare pin is present
```
{
    "BOARD_TYPE" : "esp32-s3-devkitc-1",
    "VAC_SPEED_PIN" : -1,
    "VAC_BLEED_VALVE_PIN" : -1,
    "VAC_BANK_1_PIN" : -1,
    "VAC_BANK_2_PIN" :-1,
    "VAC_BANK_3_PIN" :-1,
    "AVO_STEP_PIN" :  -1,
    "AVO_DIR_PIN" : -1,
    "FLOW_VALVE_STEP_PIN" : -1,
    "FLOW_VALVE_DIR_PIN" : -1,
    "VCC_3V3_PIN" : -1,
    "VCC_5V_PIN" : -1,
    "SPEED_SENSOR_PIN" : -1,
    "SWIRL_ENCODER_PIN_A" : -1,
    "SWIRL_ENCODER_PIN_B" : -1,
    "ORIFICE_BCD_BIT1_PIN" : -1,
    "ORIFICE_BCD_BIT2_PIN" : -1,
    "ORIFICE_BCD_BIT3_PIN" : -1,
    "MAF_PIN" : -1,
    "REF_PRESSURE_PIN" : -1,
    "DIFF_PRESSURE_PIN" : -1,
    "PITOT_PIN" : -1,
    "TEMPERATURE_PIN" : -1,
    "REF_BARO_PIN" : -1,
    "HUMIDITY_PIN" : -1,
    "SERIAL0_TX_PIN" :43,
    "SERIAL0_RX_PIN" :44,
    "SERIAL2_TX_PIN" :-1,
    "SERIAL2_RX_PIN" :-1,
    "SDA_PIN" : 8,
    "SCL_PIN" : 9,
    "SD_CS_PIN" : -1,
    "SD_MOSI_PIN" : -1,
    "SD_MISO_PIN" : -1,     
    "SD_SCK_PIN" : -1,
    "WEMOS_SPARE_PIN_1": -1
}
```

KirikauKiwi, 2024-11-20:
Digging a little further it would appear to my eye that something is happening before "Initialising I/O" because the first pin that appears in the serial monitor is the MAF_PIN it displays the pin is set to 0, however in my pins.json it is set to -1.
The pinMode setting in the hardware.cpp is >=0, so I shouldn't be seeing the pin set, This is true from the MAF_PIN onwards in my pins.json, the pins prior to this don't appear in the serial monitor as expected as they are -1.

Does this indicate that the values from the pins.json file are not setting the int value correctly in the struct Pins part of the struct.h

From the hardware.cpp
```
if (pins.MAF_PIN >= 0 ) {
    _message.serialPrintf("Input MAF_PIN: %d\n", pins.MAF_PIN );
    pinMode(pins.MAF_PIN, INPUT);
```
```
Initialising I/O
Input MAF_PIN: 0
Input REF_PRESSURE_PIN: 0
Input DIFF_PRESSURE_PIN: 0
Input PITOT_PIN: 0
Input SERIAL0_RX_PIN: 44
Input SDA_PIN: 8
Input SCL_PIN: 9
Input SD_MISO_PIN: 0
Input SD_SCK_P
```
Comparing that to my pins.json
```
    "MAF_PIN" : -1,
    "REF_PRESSURE_PIN" : -1,
    "DIFF_PRESSURE_PIN" : -1,
    "PITOT_PIN" : -1,
    "TEMPERATURE_PIN" : -1,
    "REF_BARO_PIN" : -1,
    "HUMIDITY_PIN" : -1,
    "SERIAL0_TX_PIN" :43,
    "SERIAL0_RX_PIN" :44,
    "SERIAL2_TX_PIN" :-1,
    "SERIAL2_RX_PIN" :-1,
    "SDA_PIN" : 8,
    "SCL_PIN" : 9,
    "SD_CS_PIN" : -1,
    "SD_MOSI_PIN" : -1,
    "SD_MISO_PIN" : -1,     
    "SD_SCK_PIN" : -1,
    "WEMOS_SPARE_PIN_1": -1
```

stefan63, 2024-11-20:
During my initial tests I dissabled "comented out" all sensors just to try
to get the board show a UI, this failed, I then enabled MAF sensor (without
having one hooked up) and then the board compiled correctly. Looks like the
MAF is mandatory even if not used....

Den ons 20 nov. 2024 22:48KirikauKiwi ***@***.***> skrev:

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

DeeEmm, 2024-11-21:
> I am currently working on the other board and not the M5 Stack.

What board is this?? Generally there should be no need to change the the platformIO.ini - The esp32dev board / environment should work for ALL ESP32's (even the M5Stack) as they all use the same processor.

The BOBs that the processor is mounted to, along with any additional peripherals attached are largely irrelevent. Pin clashes for peripherals should be able to be programmed around with the pin-defs.

Try compiling using the default 'esp32dev' environment

DeeEmm, 2024-11-21:
> During my initial tests I dissabled "comented out" all sensors just to try to get the board show a UI, this failed, I then enabled MAF sensor (without having one hooked up) and then the board compiled correctly. Looks like the MAF is mandatory even if not used....

It *should* work as there is a use case for differential benches where the MAF is not used, but that is a relatively new change so it is possible that the code will fail if the MAF is disabled.

At some point in V3 I will integrate the post compile configuration (configuration.json). At this point I will review each use case and make sure that disabling the MAF works as intended

DeeEmm, 2024-11-21:
> first pin that appears in the serial monitor is the MAF_PIN it displays the pin is set to 0, however in my pins.json it is set to -1.

If it is set to -1 then it should not display. It should be skipped over. Essentially only pins that are actively assigned should be reported to the serial monitor.

I did previously note a strange behaviour relating to the -1 value and suspected it was as a result of an unsigned int, however the pins struct declares all pins as ints, which are signed by default.

A point to note there is that pinmode actually accepts an unsigned int for the pin value, so sending it a '-1' is essentially setting it out of range. I note that with my board, this causes an error, hence the reason for adding the logic to test for the '-1' value

It should not be possible for pins with a value of '-1' to pass the test, it dos not make logical sense

```
  // Set Inputs
  if (pins.VCC_3V3_PIN >= 0 ) {
    _message.serialPrintf("Input VCC_3V3_PIN: %d\n", pins.VCC_3V3_PIN );
    pinMode(pins.VCC_3V3_PIN, INPUT);
  }
  if (pins.VCC_5V_PIN >= 0 ) {
    _message.serialPrintf("Input VCC_5V_PIN: %d\n", pins.VCC_5V_PIN );
    pinMode(pins.VCC_5V_PIN, INPUT);
  }
```

So the fact that it is able to print to the serial monitor is I think a clue.

The value bing printed is '0', so I would deduce that the value of the pins.struct was '0' to begin with.

By default the pins.structs are uninitialised. They only receive a value when the pins.json file is read. I suspect that the issue may lay there.

DeeEmm, 2024-11-21:
also unfortunately '0' is a valid pin number

DeeEmm, 2024-11-21:
Ok so did a quick test..

```
  // TEST - save pins data to file
  String output;
  serializeJson(pinsFileData, output);
  this->writeJSONFile(output,"/pintest.json", CONFIG_JSON_SIZE);
```

Added to bottom of load pinsData method to immediately bounce results back to a file.

Results of test...

```
{
  "BOARD_TYPE": "WEMOS_D1_R32",
  "VAC_SPEED_PIN": 25,
  "VAC_BLEED_VALVE_PIN": 26,
  "VAC_BANK_1_PIN": 13,
  "VAC_BANK_2_PIN": 12,
  "VAC_BANK_3_PIN": 14,
  "AVO_STEP_PIN": 32,
  "AVO_DIR_PIN": 33,
  "FLOW_VALVE_STEP_PIN": 27,
  "FLOW_VALVE_DIR_PIN": 4,
  "VCC_3V3_PIN": -1,
  "VCC_5V_PIN": 2,
  "SPEED_SENSOR_PIN": 15,
  "SWIRL_ENCODER_PIN_A": -1,
  "SWIRL_ENCODER_PIN_B": -1,
  "ORIFICE_BCD_BIT1_PIN": 34,
  "ORIFICE_BCD_BIT2_PIN": 36,
  "ORIFICE_BCD_BIT3_PIN": 39,
  "MAF_PIN": -1,
  "REF_PRESSURE_PIN": -1,
  "DIFF_PRESSURE_PIN": -1,
  "PITOT_PIN": -1,
  "TEMPERATURE_PIN": -1,
  "REF_BARO_PIN": -1,
  "HUMIDITY_PIN": -1,
  "SERIAL0_TX_PIN": -1,
  "SERIAL0_RX_PIN": -1,
  "SERIAL2_TX_PIN": 16,
  "SERIAL2_RX_PIN": 17,
  "SDA_PIN": -1,
  "SCL_PIN": -1,
  "SD_CS_PIN": 5
}
```

So the '-1' is getting picked up.

Next test is to dump content of pins.struct

DeeEmm, 2024-11-21:
OK,

```
serializeJsonPretty(pinsFileData, Serial);
```
Added to bottom of load pinsData

Results...

```
Parsing Pins Data
{
  "BOARD_TYPE": "WEMOS_D1_R32",
  "VAC_SPEED_PIN": 25,
  "VAC_BLEED_VALVE_PIN": 26,
  "VAC_BANK_1_PIN": 13,
  "VAC_BANK_2_PIN": 12,
  "VAC_BANK_3_PIN": 14,
  "AVO_STEP_PIN": 32,
  "AVO_DIR_PIN": 33,
  "FLOW_VALVE_STEP_PIN": 27,
  "FLOW_VALVE_DIR_PIN": 4,
  "VCC_3V3_PIN": -1,
  "VCC_5V_PIN": 2,
  "SPEED_SENSOR_PIN": 15,
  "SWIRL_ENCODER_PIN_A": -1,
  "SWIRL_ENCODER_PIN_B": -1,
  "ORIFICE_BCD_BIT1_PIN": 34,
  "ORIFICE_BCD_BIT2_PIN": 36,
  "ORIFICE_BCD_BIT3_PIN": 39,
  "MAF_PIN": -1,
  "REF_PRESSURE_PIN": -1,
  "DIFF_PRESSURE_PIN": -1,
  "PITOT_PIN": -1,
  "TEMPERATURE_PIN": -1,
  "REF_BARO_PIN": -1,
  "HUMIDITY_PIN": -1,
  "SERIAL0_TX_PIN": -1,
  "SERIAL0_RX_PIN": -1,
  "SERIAL2_TX_PIN": 16,
  "SERIAL2_RX_PIN": 17,
  "SDA_PIN": -1,
  "SCL_PIN": -1,
  "SD_CS_PIN": 5
}
```

Again '-1' value is getting picked up.

So a bit odd really. pins.struct is definitely '-1.'

This only leaves the comparison logic itself...

```
  if (pins.VCC_3V3_PIN >= 0 ) {
    _message.serialPrintf("Input VCC_3V3_PIN: %d\n", pins.VCC_3V3_PIN );
    pinMode(pins.VCC_3V3_PIN, INPUT);
  }
```

Need to find a different way to test for same

DeeEmm, 2024-11-21:
Tried a bunch of stuff, nothing works so far

Flipping the logic does not work

```
  if (!(pins.VCC_3V3_PIN < 0) ) {
    _message.serialPrintf("Input VCC_3V3_PIN: %d\n", pins.VCC_3V3_PIN );
    pinMode(pins.VCC_3V3_PIN, INPUT);
  }
```

Still lets '-1' through and prints it as '0'

I can only assume that the '0' is a limitation of the output formatting (behaving as an unsigned int) even though %d should  print as '-1'

Very bizarre behaviour.

DeeEmm, 2024-11-21:
OK. Nothing seems to work as expected. Have done a bunch  of tests.

```
 if (!(pins.VCC_3V3_PIN == -1) ) {
```

```
 if (pins.VCC_3V3_PIN != -1)  {
```

```
 if (!(pins.VCC_3V3_PIN == 99) ) {
```

Unsure what is going on there. Truly bizarre.

Note that whilst I have used the VCC_3V3_PIN in the above examples,  but the very first if statement actually works in many cases (VCC_3V3_PIN), all others afterwards do not.

Again another clue perhaps?

DeeEmm, 2024-11-21:
```
 if (pins.VCC_5V_PIN ) {
```

Works. This is because the value '0' is interpreted as false. So '-1' is seen as 0 and therefore false. (all non zero value are considered true)

I think that the issue is that the pins.struct is somehow seen an ambiguous and so does not behave as expected, this is despite it being initialised as int's. I tried hard to typecast it to try and force the desired behaviour, but nothing seems to work. Similar story if the pins.struct is initialised with all '-1' values, which I had hoped would remove the ambiguity.

I think that the best solution is to dump the pins.struct in favour of discrete variables and drop the '-1' nomenclature. The solution above is not usable simply as '0' is a valid GPIO value on most boards, but it will do as a quick and dirty fix for the interim.

Definitely needs more work

KirikauKiwi, 2024-11-21:
I am cannot recall what the changes were in respect to pin setting, between this Build: 24111901, being the current DEV build and the previous one, the previous build didn't appear to exhibit this behaviour.

I am having oddities that it appears to work for some pins and not others regarding the serial print. I added  a serial print of the prior to the pin set to show the value.
```
  _message.serialPrintf("pins.ORIFICE_BCD_BIT3_PIN value: %d\n", pins.MAF_PIN);
  if (pins.ORIFICE_BCD_BIT3_PIN >= 0 ) {
    _message.serialPrintf("Input ORIFICE_BCD_BIT3_PIN: %d\n", pins.ORIFICE_BCD_BIT3_PIN );
    pinMode(pins.ORIFICE_BCD_BIT3_PIN, INPUT);
  }
    _message.serialPrintf("pins.MAF_PIN value: %d\n", pins.MAF_PIN);
  if (pins.MAF_PIN >= 0) {
    _message.serialPrintf("Input MAF_PIN: %d\n", pins.MAF_PIN);
    pinMode(pins.MAF_PIN, INPUT);
```

This is what was output
```
Initialising I/O
pins.ORIFICE_BCD_BIT3_PIN value: 0
pins.MAF_PIN value: 0
Input MAF_PIN: 0
Input REF_PRESSURE_PIN: 0
Input DIFF_PRESSURE_PIN: 0
Input PITOT_PIN: 0
Input SERIAL0_RX_PIN: 44
Input SDA_PIN: 8
Input SCL_PIN: 9
Input SD_MISO_PIN: 0
Input SD_SCK_PIN: 0
Input WEMOS_SPARE_PIN_1: 0
Output SD_MOSI_PIN: 0
Output SE
```

Strange to me that the serial print works for the orifice, i.e does not serial print as you would expect from the code, but the MAF pin does print.
```
Initialising I/O
Input MAF_PIN: 0
Input REF_PRESSURE_PIN: 0
Input DIFF_PRESSURE_PIN: 0
Input PITOT_PIN: 0
Input SERIAL0_RX_PIN: 44
Input SDA_PIN: 8
Input SCL_PIN: 9
Input SD_MISO_PIN: 0
Input SD_SCK_P
```

If the pin is saying it is 0 from this, before the pins are being set by the pinMode, this would point to the variable not either being initialised and/or their values being set correctly?
```
 _message.serialPrintf("pins.ORIFICE_BCD_BIT3_PIN value: %d\n", pins.MAF_PIN);
```

KirikauKiwi, 2024-11-21:
Here is a comparison from the values set in the code to my pins.json for the input pins only.

int values
```
pins.VCC_3V3_PIN value: -1                            
pins.VCC_5V_PIN value: -1
pins.SPEED_SENSOR_PIN value: -1
pins.ORIFICE_BCD_BIT1_PIN value: -1
pins.ORIFICE_BCD_BIT2_PIN value: -1
pins.ORIFICE_BCD_BIT3_PIN value: -1
pins.MAF_PIN value: 0
pins.REF_PRESSURE_PIN value: 0
pins.DIFF_PRESSURE_PIN value: 0
pins.PITOT_PIN value: 0
pins.TEMPERATURE_PIN value: -1
pins.HUMIDITY_PIN value: -1
pins.REF_BARO_PIN: value -1
pins.SERIAL0_RX_PIN value: 44
pins.SDA_PIN value: 8
pins.SCL_PIN value: 9
pins.SD_CS_PIN value: -1
pins.SD_MISO_PIN value: 0
pins.SD_SCK_PIN value: 0
pins.SD_SCK_PIN value: 0
pins.WEMOS_SPARE_PIN_1 value: 0
```

The respective pins.json values
```
    "VCC_3V3_PIN" : -1,
    "VCC_5V_PIN" : -1,
    "VAC_SPEED_PIN" : -1,
    "ORIFICE_BCD_BIT1_PIN" : -1,
    "ORIFICE_BCD_BIT2_PIN" : -1,
    "ORIFICE_BCD_BIT3_PIN" : -1,
    "MAF_PIN" : -1,
    "REF_PRESSURE_PIN" : -1,
    "DIFF_PRESSURE_PIN" : -1,
    "PITOT_PIN" : -1,
    "TEMPERATURE_PIN" : -1,
    "HUMIDITY_PIN" : -1,
    "REF_BARO_PIN" : -1,
    "SERIAL0_RX_PIN" :44,
    "SDA_PIN" : 8,
    "SCL_PIN" : 9,
    "SD_CS_PIN" : -1,
    "SD_MISO_PIN" : -1,     
    "SD_SCK_PIN" : -1,
    "WEMOS_SPARE_PIN_1" : -1
```

Odd that some values are being set from the pins.json and others are not.

KirikauKiwi, 2024-11-21:
Found a reason for the MAF, REF_PRESS, DIFF_PRESS and PITOT_PIN the data handler.cpp is setting the pins from the SRC, so somewhere there needs to be a way to if/else the pins due to the configuration.json having "MAF_SRC_IS_PIN" : false, "MAF_SRC_IS_ADC" : true, or do we only need to change pinData["MAF_SRC_IS_PIN"] to pinData["MAF_PIN"] as this matches what is in the pins.json

```
pins.MAF_PIN = pinData["MAF_SRC_IS_PIN"];
pins.REF_PRESSURE_PIN = pinData["PREF_SRC_PIN"];
pins.DIFF_PRESSURE_PIN = pinData["PDIFF_SRC_IS_PIN"];
pins.PITOT_PIN = pinData["PITOT_SRC_IS_PIN"];
```

DeeEmm, 2024-11-21:
Do you mean configuration.h? the config.json file currently only saves values related to the GUI settings.

There is actually a terminology change required here to allow configuration.h to be moved into configuration.json. The existing config.json will likely be renamed to GUI_config or something similar to allow that to happen.

Can definitely guide the code flow using the existing  #defines

```
#define MAF_SRC_IS_PIN
```

But this will eventually change when the configuration is moved from pre-compile to post-compile.

(likely another can of worms lol)

I think that the SPI stuff can likely be left out as I think that it degrades to defaults when not specified.

KirikauKiwi, 2024-11-21:
The data handler.cpp is trying to set the pins as if they are using analogue sensors,
```
pins.MAF_PIN = pinData["MAF_SRC_IS_PIN"];
pins.REF_PRESSURE_PIN = pinData["PREF_SRC_PIN"];
pins.DIFF_PRESSURE_PIN = pinData["PDIFF_SRC_IS_PIN"];
pins.PITOT_PIN = pinData["PITOT_SRC_IS_PIN"];
```
If it was to use the I2C sensor it would be,
```
pins.MAF_PIN = pinData["MAF_SRC_IS_ADC"];
pins.REF_PRESSURE_PIN = pinData["PREF_SRC_ADC"];
pins.DIFF_PRESSURE_PIN = pinData["PDIFF_SRC_IS_ADC"];
pins.PITOT_PIN = pinData["PITOT_SRC_IS_ADC"];
```
Currently neither MAF_SRC_IS_PIN or MAF_SRC_IS_ADC is in the pins.json. The json has MAF_PIN

DeeEmm, 2024-11-21:
quick and easy fix

```
 }
  if (pins.ORIFICE_BCD_BIT3_PIN > 0 ) {
    pinMode(pins.ORIFICE_BCD_BIT3_PIN, INPUT);
    _message.serialPrintf("Input ORIFICE_BCD_BIT3_PIN: %d\n", pins.ORIFICE_BCD_BIT3_PIN );
    pinMode(pins.ORIFICE_BCD_BIT3_PIN, INPUT);
  }
  #ifdef MAF_SRC_IS_PIN
  if ((pins.MAF_PIN > 0)  ) {
    _message.serialPrintf("Input MAF_PIN: %d\n", pins.MAF_PIN );
    pinMode(pins.MAF_PIN, INPUT);
  }
  #endif
  #ifdef PREF_SRC_PIN
  if (pins.REF_PRESSURE_PIN > 0 ) {
    _message.serialPrintf("Input REF_PRESSURE_PIN: %d\n", pins.REF_PRESSURE_PIN );
    pinMode(pins.REF_PRESSURE_PIN, INPUT);
  }
  #endif
  #ifdef PDIFF_SRC_IS_PIN
  if (pins.DIFF_PRESSURE_PIN > 0 ) {
    _message.serialPrintf("Input DIFF_PRESSURE_PIN: %d\n", pins.DIFF_PRESSURE_PIN );
    pinMode(pins.DIFF_PRESSURE_PIN, INPUT);
  }
  #endif
  #ifdef PITOT_SRC_IS_PIN
  if (pins.PITOT_PIN > 0 ) {
    _message.serialPrintf("Input PITOT_PIN: %d\n", pins.PITOT_PIN );
    pinMode(pins.PITOT_PIN, INPUT);
  }
  #endif
  #ifdef TEMP_SENSOR_TYPE_LINEAR_ANALOG
  if (pins.TEMPERATURE_PIN > 0 ) {
    _message.serialPrintf("Input TEMPERATURE_PIN: %d\n", pins.TEMPERATURE_PIN );
    pinMode(pins.TEMPERATURE_PIN, INPUT);
  }
  #endif
  #ifdef RELH_SENSOR_TYPE_LINEAR_ANALOG
  if (pins.HUMIDITY_PIN > 0 ) {
    _message.serialPrintf("Input HUMIDITY_PIN: %d\n", pins.HUMIDITY_PIN );
    pinMode(pins.HUMIDITY_PIN, INPUT);
  }
  #endif
  #ifdef BARO_SENSOR_TYPE_LINEAR_ANALOG
  if (pins.REF_BARO_PIN > 0 ) {
    _message.serialPrintf("Input REF_BARO_PIN: %d\n", pins.REF_BARO_PIN );
    pinMode(pins.REF_BARO_PIN, INPUT);
  }
  #endif
  if (pins.SERIAL0_RX_PIN > 0 ) {
    _message.serialPrintf("Input SERIAL0_RX_PIN: %d\n", pins.SERIAL0_RX_PIN );
    pinMode(pins.SERIAL0_RX_PIN, INPUT);
  }
  if (pins.SERIAL2_RX_PIN > 0 ) {
    _message.serialPrintf("Input SERIAL2_RX_PIN: %d\n", pins.SERIAL2_RX_PIN );
    pinMode(pins.SERIAL2_RX_PIN, INPUT);
  }
```

KirikauKiwi, 2024-11-21:
Currently I have changed the datahandler.cpp to this,
```
pins.MAF_PIN = pinData["MAF_PIN"];
pins.REF_PRESSURE_PIN = pinData["PREF_PIN"];
pins.DIFF_PRESSURE_PIN = pinData["PDIFF_PIN"];
pins.PITOT_PIN = pinData["PITOT_PIN"];
```

DeeEmm, 2024-11-21:
Just mask them using same #ifdefs

At the point when we move the precompile stuff we will end up with something like...

```
"configuration.tempSensorType" :  1,
```

Where the numerical integer represents the existing temp sensor options

Then in constants we define...

```
int TEMP_SENSOR_NOT_USED = 0
int TEMP_SENSOR_TYPE_FIXED_VALUE = 1
int TEMP_SENSOR_TYPE_LINEAR_ANALOG = 2
int TEMP_SENSOR_TYPE_BME280 = 3
int TEMP_SENSOR_TYPE_BME680 = 4
int TEMP_SENSOR_TYPE_SIMPLE_TEMP_DHT11 = 5
```

Which allows us to use switch case logic to process sensor types...

```
switch (configuration.tempSensorType) {

case (TEMP_SENSOR_NOT_USED):

break;

case(TEMP_SENSOR_TYPE_FIXED_VALUE):

break;

etc...
```

We can then also use logic in the initialiseIO method...

if (configuration.tempSensorType == TEMP_SENSOR_TYPE_LINEAR_ANALOG) {
...do initialisation stuff
}
```

DeeEmm, 2024-11-21:
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

What part? method?

KirikauKiwi, 2024-11-21:
In the parsePinsData, this
```
/***********************************************************
* @name ParsePinsData
* @brief Updates pins struct from passed JSON data
* @param pinsData JSON document containing pins data
***/
void DataHandler::parsePinsData(StaticJsonDocument<1024> pinData) {

  extern struct CalibrationData calVal;
  extern struct Pins pins;
  extern struct DeviceStatus status;

  Messages _message;

  _message.serialPrintf("Parsing Pins Data \n");

  status.boardType = pinData["BOARD_TYPE"].as<String>();

  // Store input pin values in struct
  pins.VCC_3V3_PIN = pinData["VCC_3V3_PIN"];
  pins.VCC_5V_PIN = pinData["VCC_5V_PIN"];
  pins.SPEED_SENSOR_PIN = pinData["SPEED_SENSOR_PIN"];
  pins.ORIFICE_BCD_BIT1_PIN = pinData["ORIFICE_BCD_BIT1_PIN"];
  pins.ORIFICE_BCD_BIT2_PIN = pinData["ORIFICE_BCD_BIT2_PIN"];
  pins.ORIFICE_BCD_BIT3_PIN = pinData["ORIFICE_BCD_BIT3_PIN"];
  pins.MAF_PIN = pinData["MAF_PIN"];
  pins.REF_PRESSURE_PIN = pinData["PREF_PIN"];
  pins.DIFF_PRESSURE_PIN = pinData["PDIFF_PIN"];
  pins.PITOT_PIN = pinData["PITOT_PIN"];
  pins.TEMPERATURE_PIN = pinData["TEMPERATURE_PIN"];
  pins.HUMIDITY_PIN = pinData["HUMIDITY_PIN"];
  pins.REF_BARO_PIN = pinData["REF_BARO_PIN"];
  pins.SERIAL0_RX_PIN = pinData["SERIAL0_RX_PIN"];
  pins.SERIAL2_RX_PIN = pinData["SERIAL2_RX_PIN"];
  pins.SDA_PIN = pinData["SDA_PIN"];
  pins.SCL_PIN = pinData["SCL_PIN"];
  pins.SD_CS_PIN = pinData["SD_CS_PIN"];
  pins.SD_MISO_PIN = pinData["SD_MISO_PIN"];
  pins.SD_SCK_PIN = pinData["SD_SCK_PIN"];
  pins.WEMOS_SPARE_PIN_1 = pinData["WEMOS_SPARE_PIN_1"];

  // Store output pin values in struct
  pins.VAC_BANK_1_PIN = pinData["VAC_BANK_1_PIN"];
  pins.VAC_BANK_2_PIN = pinData["VAC_BANK_2_PIN"];
  pins.VAC_BANK_3_PIN = pinData["VAC_BANK_3_PIN"];
  pins.VAC_SPEED_PIN = pinData["VAC_SPEED_PIN"];
  pins.VAC_BLEED_VALVE_PIN = pinData["VAC_BLEED_VALVE_PIN"];
  pins.AVO_STEP_PIN = pinData["AVO_STEP_PIN"];
  pins.AVO_DIR_PIN = pinData["AVO_DIR_PIN"];
  pins.FLOW_VALVE_STEP_PIN = pinData["FLOW_VALVE_STEP_PIN"];
  pins.FLOW_VALVE_DIR_PIN = pinData["FLOW_VALVE_DIR_PIN"];
  pins.SD_MOSI_PIN = pinData["SD_MOSI_PIN"];
  pins.SERIAL0_TX_PIN = pinData["SERIAL0_TX_PIN"];
  pins.SERIAL2_TX_PIN = pinData["SERIAL2_TX_PIN"];
}
```

Here is my modified serial output, you can see the correct values are coming in from the data handler.cpp for the MAF, REF PRESS, DIFF PRESSURE and PITOT.

I am still having problems with the SPI PINS

KirikauKiwi, 2024-11-21:
Currently is is trying to parse this,
```
pins.MAF_PIN = pinData["MAF_SRC_IS_PIN"];
pins.REF_PRESSURE_PIN = pinData["PREF_SRC_PIN"];
pins.DIFF_PRESSURE_PIN = pinData["PDIFF_SRC_IS_PIN"];
pins.PITOT_PIN = pinData["PITOT_SRC_IS_PIN"];
```
the SRC's are not part of the pins.json file

DeeEmm, 2024-11-21:
Haha an unfortunate mistake

The pins.json file is correct, the code parsing it is not

```
    "MAF_PIN" : 0,
    "REF_PRESSURE_PIN" : 0,
    "DIFF_PRESSURE_PIN" : 0,
    "PITOT_PIN" : 0,
    "TEMPERATURE_PIN" : 0,
    "REF_BARO_PIN" : 0,
    "HUMIDITY_PIN" : 0,
```

So it should be

```
pins.MAF_PIN = pinData["MAF_PIN"];
pins.REF_PRESSURE_PIN = pinData["REF_PRESSURE_PIN"];
pins.DIFF_PRESSURE_PIN = pinData["DIFF_PRESSURE_PIN"];
pins.PITOT_PIN = pinData["PITOT_PIN"];
```

DeeEmm, 2024-11-21:
(There is some disparity in the variable naming convention)

DeeEmm, 2024-11-21:
Here's what I have in configure pins

```

/***********************************************************
 * @brief Configure pins
 * @note Conditional configuration based on board type and hardware
 * @details Initiates I/O from pin configuration in struct and reports to serial monitor
 * @details Messaging identifies I/O in event initialisation crash
 *
 ***/
void Hardware::initaliseIO () {

  Messages _message;

  extern struct Pins pins;
  extern struct DeviceStatus status;

  _message.serialPrintf("Initialising I/O \n");

  // Set Inputs
  if (pins.VCC_3V3_PIN > 0 ) {
    _message.serialPrintf("Input VCC_3V3_PIN: %d\n", pins.VCC_3V3_PIN );
    pinMode(pins.VCC_3V3_PIN, INPUT);
  }
  if (pins.VCC_5V_PIN ) {
    _message.serialPrintf("Input VCC_5V_PIN: %d\n", pins.VCC_5V_PIN );
    pinMode(pins.VCC_5V_PIN, INPUT);
  }
  if (pins.SPEED_SENSOR_PIN > 0 ) {
    _message.serialPrintf("Input SPEED_SENSOR_PIN: %d\n", pins.SPEED_SENSOR_PIN );
    pinMode(pins.SPEED_SENSOR_PIN, INPUT);
  }
  if (pins.ORIFICE_BCD_BIT1_PIN > 0 ) {
    _message.serialPrintf("Input ORIFICE_BCD_BIT1_PIN: %d\n", pins.ORIFICE_BCD_BIT1_PIN );
    pinMode(pins.ORIFICE_BCD_BIT1_PIN, INPUT);
  }
  if (pins.ORIFICE_BCD_BIT2_PIN > 0 ) {
    _message.serialPrintf("Input ORIFICE_BCD_BIT2_PIN: %d\n", pins.ORIFICE_BCD_BIT2_PIN );
    pinMode(pins.ORIFICE_BCD_BIT2_PIN, INPUT);
  }
  if (pins.ORIFICE_BCD_BIT3_PIN > 0 ) {
    pinMode(pins.ORIFICE_BCD_BIT3_PIN, INPUT);
    _message.serialPrintf("Input ORIFICE_BCD_BIT3_PIN: %d\n", pins.ORIFICE_BCD_BIT3_PIN );
    pinMode(pins.ORIFICE_BCD_BIT3_PIN, INPUT);
  }
  #ifdef MAF_SRC_IS_PIN
  if ((pins.MAF_PIN > 0)  ) {
    _message.serialPrintf("Input MAF_PIN: %d\n", pins.MAF_PIN );
    pinMode(pins.MAF_PIN, INPUT);
  }
  #endif
  #ifdef PREF_SRC_PIN
  if (pins.REF_PRESSURE_PIN > 0 ) {
    _message.serialPrintf("Input REF_PRESSURE_PIN: %d\n", pins.REF_PRESSURE_PIN );
    pinMode(pins.REF_PRESSURE_PIN, INPUT);
  }
  #endif
  #ifdef PDIFF_SRC_IS_PIN
  if (pins.DIFF_PRESSURE_PIN > 0 ) {
    _message.serialPrintf("Input DIFF_PRESSURE_PIN: %d\n", pins.DIFF_PRESSURE_PIN );
    pinMode(pins.DIFF_PRESSURE_PIN, INPUT);
  }
  #endif
  #ifdef PITOT_SRC_IS_PIN
  if (pins.PITOT_PIN > 0 ) {
    _message.serialPrintf("Input PITOT_PIN: %d\n", pins.PITOT_PIN );
    pinMode(pins.PITOT_PIN, INPUT);
  }
  #endif
  #ifdef TEMP_SENSOR_TYPE_LINEAR_ANALOG
  if (pins.TEMPERATURE_PIN > 0 ) {
    _message.serialPrintf("Input TEMPERATURE_PIN: %d\n", pins.TEMPERATURE_PIN );
    pinMode(pins.TEMPERATURE_PIN, INPUT);
  }
  #endif
  #ifdef RELH_SENSOR_TYPE_LINEAR_ANALOG
  if (pins.HUMIDITY_PIN > 0 ) {
    _message.serialPrintf("Input HUMIDITY_PIN: %d\n", pins.HUMIDITY_PIN );
    pinMode(pins.HUMIDITY_PIN, INPUT);
  }
  #endif
  #ifdef BARO_SENSOR_TYPE_LINEAR_ANALOG
  if (pins.REF_BARO_PIN > 0 ) {
    _message.serialPrintf("Input REF_BARO_PIN: %d\n", pins.REF_BARO_PIN );
    pinMode(pins.REF_BARO_PIN, INPUT);
  }
  #endif
  // if (pins.SERIAL0_RX_PIN > 0 ) {
  //   _message.serialPrintf("Input SERIAL0_RX_PIN: %d\n", pins.SERIAL0_RX_PIN );
  //   pinMode(pins.SERIAL0_RX_PIN, INPUT);
  // }
  // if (pins.SERIAL2_RX_PIN > 0 ) {
  //   _message.serialPrintf("Input SERIAL2_RX_PIN: %d\n", pins.SERIAL2_RX_PIN );

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

Thread 248 (2024-11-21):

I2C devices not being found on boot

DeeEmm, 2024-11-21:
>Nice work, I have updated the relevant files and now get past the Initialising IO part of on the serial monitor, I am now encountering a problem that the I2C devices are not being found. It is showing the correct pins for my I2C.
I changed the files directly, I will fetch the latest DEV branch and try that incase I have missed something.
```
Multicast: http://diyfb.local
Initialising I/O
Input SDA_PIN: 8
Input SCL_PIN: 9
=== SPIFFS File system info ===
Total space:      1.26 MB
Total space used: 60.54 KB
Initialising Hardware
Scanning for I2C devices...
Found 0 device(s).
Initialising ADS1115
[128700][E][Wire.cpp:513] requestFrom(): i2cRead returned Error 263
ADS1115 Connection failed
```

_Originally posted by @KirikauKiwi in https://github.com/DeeEmm/DIY-Flow-Bench/issues/245#issuecomment-2491637603_

DeeEmm, 2024-11-21:
Seems that error 263 is a timeout.

I guess check the obvious things initially...

- Wiring is correct / secure
- Pin numbers are correct
- Pull-up resistors installed

KirikauKiwi, 2024-11-22:
My hardware is working on this version / build,
```
DIY Flow Bench
Version: V.2.0-RC.8
Build: 24111107
Initialising Hardware
Scanning for I2C devices...
Found address: 72 (0x48)
Found address: 118 (0x76)
Found 2 device(s).
Initialising ADS1115
ADS1115 Initialised
Hardware Initialised
Initialising Sensors
Initialising BME280
BME280 Initialised
Sensors Initialised
File System Initialisation...
Complete.
Creating config.json file...
Creating liftdata.json file...
Loading Configuration...
Loading Lift Data...
=== SPIFFS File system info ===
Total space:      1.26 MB
Total space used: 2.45 KB
```
- I have checked wiring is correct / secure as it works with a previous build.
- The pins are correct and viewable on the serial monitor.
- I have the pinMode for the SDA and SCL set to INPUT_PULLUP in the data handler.cpp. as I don't have hardware pull-up resistors.

I tried changing the default structs.h from SDA_PIN = 99; int SCL_PIN = 99; to,  int SDA_PIN = 8;
  int SCL_PIN = 9; to check for a pin setting issue, I get the same serial monitor output either way.
```
DIY Flow Bench
DIYFB Version: V2.0.RC.8
Build: 24112102
For help please visit the WIKI:
https://github.com/DeeEmm/DIY-Flow-Bench/wiki
Initialising File System
Loading Configuration
Loading Lift Data
Loading Calibration Data
PINS file Found: /PINS_ESP32_S3_DEV_KITC.json
Loading Pins Data
Parsing Pins Data
Defaulting to AP Mode
Creating WiFi Access Point:  DIYFB
Access Point IP address: 192.168.4.1
Multicast: http://diyfb.local
Initialising I/O
Input SDA_PIN: 8
Input SCL_PIN: 9
=== SPIFFS File system info ===
Total space:      1.26 MB
Total space used: 61.28 KB
Initialising Hardware
Scanning for I2C devices...
Found 0 device(s).
Initialising ADS1115
[128706][E][Wire.cpp:513] requestFrom(): i2cRead returned Error 263
ADS1115 Connection failed
```
The serial monitor gets to the "Scanning for I2C devices..." stage and after two minutes the "Initialising ADS1115.....Connection failed" appears.

DeeEmm, 2024-11-22:
What happens if you comment out that section in the initaliseIO method?

```
  // if (pins.SDA_PIN < 99 ) {
  //   _message.serialPrintf("Input SDA_PIN: %d\n", pins.SDA_PIN );
  //   pinMode(pins.SDA_PIN, INPUT);
  // }
  // if (pins.SCL_PIN < 99 ) {
  //   _message.serialPrintf("Input SCL_PIN: %d\n", pins.SCL_PIN );
  //   pinMode(pins.SCL_PIN, INPUT);
  // }
```

DeeEmm, 2024-11-24:
Don't really have any issues at all, which I believe is due to the environment.

I never call the Wemos D1 board configuration but use the generic esp32dev configuration. AFAIK this works on all ESP32's.

As soon as you define specific board configurations then you also pull in whatever configuration restrictions have been programmed in to the configuration, such as I/O restrictions.

The compiler just needs to know the compatible instruction set to be able to compile the code, it doesn't care about the rest of the stuff. BUT it will throw errors if there are conflicts with the board configuration at compile time.

Think of the esp32dev configuration as a bare minimum setup.

Have you tried to compile using the esp32dev environment and not calling any external frameworks?

KirikauKiwi, 2024-11-24:
There doesn't appear too be a generic board version for the S3 variant of the ESP devices, I have looked through platformio and also attempted a few others with trail and error and when you run attempt to upload to the board it either say no such board or if you use esp32dev it reports back that you are using an esp32-s3.

The commenting out of the I2C pins has worked as the wire.begin(pins.SDA_PIN, pins.SCL_PIN) will be picking up the correct pins from the relevant pins.json file, so there must be some sort of issue with manually defining the pins and the automatic configuration that happens with the wire.begin() call.

This can be closed.

DeeEmm, 2024-11-24:
> if you use esp32dev it reports back that you are using an esp32-s3

That's interesting. Seems like the S3 uses a different processor...

>Remember, an ESP32-S3 isn't an ESP32 MCU, despite it's name. The ESP32-S3 has an Extensa LX7 processor, while the original ESP32 has an Extensa LX6 processor.

Might explain this. Perhaps?

Did you reply to my message yet? Can you email me your mailing address. I'll send you a shield out for testing.

DeeEmm, 2024-11-25:
I wonder if changing the MCU within the build environment would work...

```
board_build.mcu = esp32c3
```

Closed 2024-11-24.

Thread 249 (2024-11-21):

Pitot Improvements

DeeEmm, 2024-11-21:
Additional functionality for pitot probes.

Original discussion - #247

- [ ] Ability to add an offset to velocity calc to allow for single ended probe (prob also good idea to tune differential probe as well)
- [ ] Ability to select static pressure source (Baro / pRef / pDiff / Pitot)
- [ ] Ability to change measurement units
- [ ] Ability to change between velocity and pressure

KirikauKiwi, 2024-11-22:
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

See my comments here https://github.com/DeeEmm/DIY-Flow-Bench/discussions/247#discussioncomment-11346849

* [ ]  Ability to add an offset to velocity calc to allow for single ended probe (good idea to tune differential probe as well)
Why would this be needed? based on my [comments](https://github.com/DeeEmm/DIY-Flow-Bench/discussions/247#discussioncomment-11346849) above.

* [ ]  Ability to select static pressure source (Baro / pRef / pDiff / Pitot)
Why would this be needed? other than if you were eliminating a pressure sensor from your shield and using PRef and PDiff to calculate ∆P and having to manually reconfiguring their connections when wanting to measure in cylinder head port ∆P or velocity

* [ ]  Ability to change measurement units
Yes this is useful

* [ ]  Ability to change between velocity and pressure
Yes this is useful

DeeEmm, 2024-11-22:
There is already a zero function for the pitot differential method, this zeroes down the pressure differential to zero the gauge in the GUI.

The velocity offset would allow the delta calculation to be corrected due to the larger differential between the pressure port and static port. i.e. it applies to the velocity, not the pressure. For a regular pitot probe this would give you the option to calibrate the probe against a reference source. For a single ended probe (read here also 'single ended pressure sensor') it would allow you to correct the flow value error to to compensate for a lower static pressure.

The idea is that the static pressure side of the equation can be taken from any reference, even atmospheric. However once you move the static reference away from the locality of the probe, the velocity calculation will return an incorrect result as the static pressure would be higher / lower than it should be. However if you understand what that offset is and can quantify it, then you can correct the result. It's just maths.

Consider this. In an ideal scenario the static pressure of the port would be stable, it is defined by the depression and port characteristics. Assuming it is stable, it would be no different from any other point of reference that was stable. i.e. Pref, pDiff or Baro. It's just like connecting two ends of a manometer to two different locations, the relationship between those two points is still tied to the fact that the calculation is a differential pressure calculation.

The ability / requirement to change the static reference source depends on a few factors. For a single ended probe on a MAF bench the most accurate reference would be pRef. For a single ended probe on a differential bench it would be pDiff. You also might elect to use Baro, which would replicate probing with a regular manometer, a technique used by some. In this case you would not be looking at velocity, but just pressure, hence the ability to change between velocity and pressure.

Of course the pitot connected to a differential sensor would be the most accurate / best choice, but I don't think that we should exclude other options on the basis that they are inferior. For some it might be the only option available.

Think of it in the same terms as the Adjusted flow figures. They are not 'real' measurements, but still very useful none the less. Or like a toolbox. Not everyone will use every tool.

KirikauKiwi, 2024-11-24:
Pitot Display
- I cannot get the Pitot to zero, the number is changing colours, however the numerals stay the same.
- The ∆ pressure is only displaying either 0, 1 or 2, you are not able to see the units/ones, or the decimal values.
- Based on the above I suggest to put the m/sec above the ∆ ??? inH20, keeping them centre aligned, I think this will be less cluttered and give more space for the ∆ to be displayed.
- The colour changing number are great to identify what can be interacted with and zeroed, like the green, not so much a fan of the pink/salmon colour it looks disappears in to the background for my, lack of contrast I think.

Thread 252 (2024-11-23):

[FEATURE REQUEST]Start/Stop GUI buttons

KirikauKiwi, 2024-11-23:
Are the "Start Bench", "Stop Bench" buttons on the GUI currently implemented?

DeeEmm, 2024-11-23:
Yes, they currently control  'VAC_BANK_1_PIN' via Hardware::benchOn() which in turn controls the ULN2003 darlington array

The ULN2003 sinks the signal and requires an interposing 12v relay connected as follows...

12V (VCC)--------(85 )[ 12v relay coil ](86) --------X2_PIN_9

Closed 2024-11-23.

Thread 262 (2024-11-25):

Add PCB mounting holes

DeeEmm, 2024-11-25:
PCB has no mounting holes.

Mounting holes are useful for installing within cabinet style installation.

Thread 266 (2024-11-28):

GUI hangs after uploading index / pins file on initial upload

DeeEmm, 2024-11-28:
GUI should automatically redirect to main GUI page after missing files have been uploaded.

Suspect stuck in boot loop and presence of files does not break loop

Check detection of file presence

DeeEmm, 2024-11-28:
Yes the WiFi hang can often be recovered manually.

I believe the hang on initial setup is that the code gets stuck in the boot loop in datahander.cpp

```
 do {
    // capture program pointer in loop and wait for files to be uploaded

        // Process API comms
        if (settings.api_enabled) {
            if (millis() > status.apiPollTimer) {
                if (Serial.available() > 0) {
                    status.serialData = Serial.read();
                    _api.ParseMessage(status.serialData);
                }
            }                    
        }

        // This is the escape function. When all files are present and loaded we can leave the loop
        if ((status.pinsLoaded == true) && (status.mafLoaded == true) && (SPIFFS.exists("/index.html")) status.doBootLoop = false;

        // if (status.pinsFilename.isEmpty();

        vTaskDelay( 1 );

    } while (status.doBootLoop = true);
```

It should sit there until the missing files have been uploaded. This is to prevent things like pins initialisation until the pin definitions have been loaded.

The following code tests for the files.

```
        if ((status.pinsLoaded == true) && (status.mafLoaded == true) && (SPIFFS.exists("/index.html")) status.doBootLoop = false;
```

**status.doBootLoop** is reset in the **fileUpload** method...

```
    if (_data.checkUserFile(PINSFILE)){
      _data.loadPinsData();
      status.pinsLoaded = true;
    }
    if (_data.checkUserFile(MAFFILE)) {
      // _data.loadMafData();
      status.mafLoaded = true;
    }
```

It should work, but does not

DeeEmm, 2024-11-28:
The behaviour is that instead of redirecting to the index page once the files have been uploaded, it stays on the file upload page which is served as part of the boot loop process.

KirikauKiwi, 2024-11-28:
This appears to have it working, however an Anysync error now appears on the serial monitor and the diyfb.local appears as a blank white page.

- } while (status.doBootLoop = true); The single = was causing an infinite loop I believe
- status.doBootLoop = false; was missing {}
```
    do {
    // capture program pointer in loop and wait for files to be uploaded

        // Process API comms
        if (config.api_enabled) {
            if (millis() > status.apiPollTimer) {
                if (Serial.available() > 0) {
                    status.serialData = Serial.read();
                    _api.ParseMessage(status.serialData);
                }
            }                    
        }

        // if (status.pinsFilename.isEmpty();
        if ((status.pinsLoaded == true) && (SPIFFS.exists("/index.html"))) {status.doBootLoop = false;
        }
        vTaskDelay( 1 );

    } while (status.doBootLoop == true);

    tempServer->reset();

}
```

Serial monitor
```
Loading Pins Data
Parsing Pins Data
Initialising I/O
Input VCC_5V_PIN: 2
Input SPEED_SENSOR_PIN: 15
Input ORIFICE_BCD_BIT1_PIN: 34
Input ORIFICE_BCD_BIT2_PIN: 36
Input ORIFICE_BCD_BIT3_PIN: 39
Input SDA_PIN: 21
Input SCL_PIN: 22
Output VAC_BANK_1_PIN: 13
Output VAC_BANK_2_PIN: 12
Output VAC_BANK_3_PIN: 14
Output VAC_SPEED_PIN: 25
Output VAC_BLEED_VALVE_PIN: 26
Output AVO_STEP_PIN: 32
Output AVO_DIR_PIN: 33
Output FLOW_VALVE_STEP_PIN: 27
Output FLOW_VALVE_DIR_PIN: 4
=== SPIFFS File system info ===
Total space:      1.26 MB
Total space used: 81.87 KB
Initialising Hardware
Scanning for I2C devices...
Found address: 72 (0x48)
Found address: 118 (0x76)
Found 2 device(s).
Initialising ADS1115
ADS1115 Initialised
Hardware Initialised
Initialising Sensors
Initialising BME280
BME280 Initialised
Sensors Initialised
[ 65621][E][AsyncTCP.cpp:1393] begin(): bind error: -8
Server Running
```

DeeEmm, 2024-11-28:
> * } while (status.doBootLoop = true); The single = was causing an infinite loop I believe

Good catch

> This appears to have it working, however an Anysync error now appears on the serial monitor and the diyfb.local appears as a blank white page (related to the Anysync error???)

Yes asynctcp is required for the webserver

KirikauKiwi, 2024-11-29:
If I manually rest the board at this point it springs back to life, looks like the Anysync error might be related to a port already in use.

DeeEmm, 2024-11-29:
I suspect that it might be that we are spinning up a temporary webserver in datahandler.cpp to be able to load the file upload page without the Asynctcp code as it is only needed for the asynchronous events. (pushing the JSON data to the page to update the GUI)

So when we come to create the actual webserver in webserver.cpp there is an issue.

The original intent was to create a temp webserver for the boot loop and then destroy it. then create the actual webserver instance when we continue with the initialisation of the actual webserver

Need to follow the flow of the code through to see if the Asyntcp instance is being created after we leave the boot loop

KirikauKiwi, 2024-11-30:
Stopping the web server before the rest has solved the issue, see PR #270

DeeEmm, 2024-12-01:
Great work. Will test this end and report back.

DeeEmm, 2024-12-10:
Confirmed resolved

Closed 2024-12-10.

Thread 268 (2024-11-28):

[BUG]GUI Configuration Minimum Bench Pressure Dead band issue

KirikauKiwi, 2024-11-28:
Version: V2.0.RC.8
Build: 24112601
GUI: 24112502

When the "Minimum Bench Pressure" is set to 1 in the GUI configuration, it is causing a dead band across all pressure sensors of around +/- 4 inH2O which is 1 kPa.

The expected behaviour would be a dead band of +/- 1 inH2O

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

The 1 that is coming from the Minimum Bench Pressure is 1 kPa not 1 inH2O. The pressure formulas are in kPA so the Minimum Bench Pressure value will need to be converted in to kPa to correct this.
I didn't do a pull request for this as I don't know if you would prefer to do the conversion elsewhere in the code first to allow for easier unit conversions later, or add the conversion factor to the formula below.

```
// Lets make sure we have a valid value to return - check it is above minimum threshold
	double pDiffComp = fabs(sensorVal);
	if (pDiffComp > config.min_bench_pressure) {
		return sensorVal;
	} else {
		return 0.0001; // return small non zero value to prevent divide by zero errors (will be truncated to zero in display)
```

DeeEmm, 2024-11-28:
Yes, the code works in SA units (kPa). Which includes the threshold. Originally we did not have any units associated with this, so it did not really matter. The intent is that the code just reports a zero value to the GUI when it is not running.

For 'correctness' and as we have now added units to this value, we should really update it.

I will take a look to see where is most appropriate to make the change as it is used in a few places.

DeeEmm, 2024-12-10:
I've considered this as part of the #205 update and note that there is also some impact on initial set up.

To a degree this ties in with #274 'TrimPot tuning' and #236 'config data display', specifically when initially setting up and testing.

I have made improvements to the API and it is now possible to view unfiltered data there, but it would be useful to have a single page of all values. This way we can keep the GUI clean (filtered) and display unfiltered values on a configuration page.

It should be noted that the 'deadband' is intentional on the GUI. The intent is just to ensure that when the bench is off it displays zero. It can however be tuned, hence the min flow value. Ideally this should be renamed as it is now just an arbitrary threshold used in several places.

DeeEmm, 2025-01-10:
Changed comparison to use INH2O.
Increased resolution of min bench pressure / min flow values

Closed 2025-01-10.

Thread 275 (2024-12-08):

Calibrate to reference standard

DeeEmm, 2024-12-08:
Allow calibration to reference standard or defined temp / baro / humidity conditions.

Takes into account temp / baro / humidity that orifice was calibrated at

DeeEmm, 2025-01-13:
Flow calibration now uses flow data from currently active tile.

NOTE: If MAF (Mass flow) tile is selected ACFM is used.

Closed 2025-01-13.

Thread 279 (2024-12-10):

Add PCB Probe points

DeeEmm, 2024-12-10:
Add probe points to PCB for testing / commissioning

DeeEmm, 2024-12-12:
From #288 - https://github.com/DeeEmm/DIY-Flow-Bench/issues/288#issuecomment-2537587923

> So in addition to 0v / 3.3v and 5v we also have:

- VCC on ADS1115
- VCC pin on pRef sensor
- VCC pin on pDiff sensor
- VCC pin on pitot sensor

These are used as part of commissioning procedure as follows

Set the 5v buck so that you get 5v at the VCC pin of the ADS1115
Set the VCC_5V_TRIMPOT value so that the MCU reports 5v
Set PREF_MV_TRIMPOT to correct voltage at VCC pin on pRef sensor
Set PDIFF_MV_TRIMPOT to correct voltage at VCC pin on pDiff sensor
Set PITOT_MV_TRIMPOT to correct voltage at VCC pin on pitot sensor

DeeEmm, 2024-12-12:
Need to update WIKI with commissioning procedure.

Also need to include steps to prevent frying ESP when initially powering up

DeeEmm, 2025-01-14:
Add points for 3.3v and 5v I2C bus

Thread 280 (2024-12-10):

[BUG] PCB Shield 5v pin error

DeeEmm, 2024-12-10:
Pin 2 on wemos cannot be used for analog read whilst WiFi is active.

Reallocate 5v pin on next version

Thread 283 (2024-12-10):

The pitot ∆ display negative

DeeEmm, 2024-12-10:
The pitot ∆ display is working as expected other than when it is zero'd.
After zeroing the Pitot Display, the ∆ has a a small area of voltage between 2.47 - 2.5V where the ∆ is displayed as a negative. Above the 2.5V crossing point the ∆ is displayed correctly, it is also displayed correctly as a positive value from 0 - 2.47 V.

_Originally posted by @KirikauKiwi in https://github.com/DeeEmm/DIY-Flow-Bench/issues/205#issuecomment-2531580902_

KirikauKiwi, 2024-12-14:
I cannot see this since rolling back to 1a1c532

DeeEmm, 2025-01-09:
Do you see this on the current version?

Closed 2025-01-13.

Thread 288 (2024-12-11):

[BUG]40-60mV Offset with voltages from the ADS1115

KirikauKiwi, 2024-12-11:
I added this so it can be looked in to with a bit more detail after being noticed by @black-top

I have notice when I connect the MXVP7007DP sensors that they are showing a higher than expected voltage output when open to the atmosphere, I expect 2.5V and have about 2.6V give or take a few mV across the three pressure sensors. So sitting idle in the picture below you can see my Pitot is sitting at about 1" H2O.

I also noticed that with my 5V supply at 5V I was not able to get to the last couple of lookup points to display on the GUI for the MAF sensor using a 10 kOhm pot, adjusting the supply voltage up to ≈ 5.1V they are then accessible.

In the screen shot below the Pref and MAF are connected to Potentiometers and the Pitot is connected to a pressure sensor,

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

NOTE; Currently my DIYFB build is on a prototype/bread board and is connected without any of the capacitors or resistors shown on the schematic.

First referenced by @blacktop https://github.com/DeeEmm/DIY-Flow-Bench/discussions/147#discussioncomment-11508087

DeeEmm, 2024-12-11:
I've noted a similar general behaviour regarding the top end of the scale. The range seems to be shifted downwards and it is not possible to see FSD even with the pot wound right up.

I suspect that this might be somewhere in the code, however I have not found where. Initially I suspected the transfer function, but I believe that this is in line with the data sheet, although I could just be making the same error transposing the data sheet transfer function.

If the offset solves the issue then it could be a valid solution but it would obviously be better to get an understanding of why this behaviour is happening.

blacktop, 2024-12-11:
Different @black-top

KirikauKiwi, 2024-12-11:
I managed to get a bit of testing done this afternoon with the ads1115, doing a comparison between the DIYFB raw values and voltages. No changes were made to the hardware. I put together a basic bit of code to test the ADS1115 outside of the DIYFB code base.

- Library used for the was the Adafruit ADS1x15 library
- The same RAW ADC value to voltage conversion formula was used other than it being hard coded.

I tested at the voltages voltages below, adjustments to the voltage were made with a 10 turn, 10kOhm potentiometer, all voltages tested to the nearest hundredth uV, e.g. 5.000763 V
-2.50V being the zero crossing point for the MXVP sensor
- 4.98V being the max lookup value for the Bosch MAF sensor
- 5.00V being the max voltage for all sensors.

The voltages tested were compared to each other with their RAW ADC values and compared to the ideal raw RAW ADC value would be for each of the voltages.
- 2.5V, 13333
- 4.98V, 26560
- 5.00V, 26667

DIYFB RAW ADC values
- 2.50015V, 13654, this is 321 bits above the ideal
- 4.979705V, 27195 this is 635 bits above the ideal
- 5.000763V, 27310 this is 643 bits above the ideal
with the ADS1115 LSB of 187.5 uV this is 60 - 120mV above the ideal voltages.

Testing code RAW ADC values
- 2.500066V, 13314, this is  19 bits below the ideal
- 4.978354V, 26518, this is 42 bits below the ideal
- 5.000319V, 26635, this is 32 bits below the ideal
with the ADS1115 LSB of 187.5 uV this is 3.563 - 7.875mV below the ideal voltages.

What has not been tested.
- Swapping the library used in DIYFB for the ADS1115
- ADS1115 configuration either in DIYFB or the library used in DIYFB.
- Other possibilities not yet considered??? Suggestions please.

I suspect that this points to the library used in DIYFB for the ADS1115 somehow converting the input voltages to a higher RAW ADC value than expected

The ADS1115 code used for testing.
```
#include <Arduino.h>
#include <Wire.h>
#include <SPI.h>
#include <Adafruit_ADS1X15.h>

Adafruit_ADS1115 ads1115;

void setup(void)
{
  Serial.begin(9600);
  Serial.println("Hello!");

  Serial.println("Getting single-ended readings from AIN0..3");
  Serial.println("ADC Range: +/- 6.144V (1 bit = 187.5uV)");
  ads1115.begin();
}

void loop(void)
{
  int16_t adc0, adc1, adc2, adc3;
  double vadc0, vadc1, vadc2, vadc3;

  adc0 = ads1115.readADC_SingleEnded(0);
  adc1 = ads1115.readADC_SingleEnded(1);
  adc2 = ads1115.readADC_SingleEnded(2);
  adc3 = ads1115.readADC_SingleEnded(3);
  vadc0 = ads1115.readADC_SingleEnded(0) * 6.144 / 32727;
  vadc1 = ads1115.readADC_SingleEnded(1) * 6.144 / 32727;
  vadc2 = ads1115.readADC_SingleEnded(2) * 6.144 / 32727;
  vadc3 = ads1115.readADC_SingleEnded(3) * 6.144 / 32727;
  Serial.print("AIN0: "); Serial.print(adc0); Serial.print(" "); Serial.println(vadc0, 6);
  Serial.print("AIN1: "); Serial.print(adc1); Serial.print(" "); Serial.println(vadc1, 6);
  Serial.print("AIN2: "); Serial.print(adc2); Serial.print(" "); Serial.println(vadc2, 6);
  Serial.print("AIN3: "); Serial.print(adc3); Serial.print(" "); Serial.println(vadc3, 6);
  Serial.println(" ");

  delay(1000);
}
```

DeeEmm, 2024-12-11:
It's funny. I had pondered last night whether the issue was ADC related. It seemed like the most likely suspect.

It should be considered that it could also be hardware as well. It is worth probing VCC at the ADC and at the sensor to see if there is any difference as this would produce a similar effect. Testing my board here shows 5v at the buck, 5v at VCC pin on the ADS1115 and 5v at VCC on the pressure sensors. I don't expect it would be any different for you, but worth eliminating.

I've had mixed success with Adafruit and Sparkfun libraries. I seem to recall replacing the BME library due to issues.

If we can pin point the issue to the library, then it would give us a direction to move in.

I wonder if the wider community have had similar issues with the Adafruit library

DeeEmm, 2024-12-11:
Actually we are not using the adafruit library

DeeEmm, 2024-12-11:
Should be able to swap in following library call...

```
https://github.com/pprasse/ADS1115-Lite.git
```

DeeEmm, 2024-12-11:
This is interesting... https://forum.arduino.cc/t/reading-ads1115-in-continuous-mode/363701/6

DeeEmm, 2024-12-11:
just going though the ADS1115 setup and we are currently set to 128 samples per second, which is massive overkill

in Hardware::begin
```
adc.setSampleRate(ADS1115_REG_CONFIG_DR_128SPS); // Set ADC Sample Rate - 128 SPS, or every 7.8ms  (default)
// adc.setSampleRate(ADS1115_REG_CONFIG_DR_8SPS); // Set ADC Sample Rate - 8 SPS, or every 7.8ms  (default)

```

We can safely change this to 8 samples per second.

DeeEmm, 2024-12-12:
OK. Think I might have it.

in Hardware::getADCVolts where we calculate the voltage from the raw ADC value

```
    case ADS1115:
      volts = rawADCval * config.ADC_GAIN / config.ADC_RANGE;
    break;
``

We are using structs to store the ADC gain and range. Substitute these with the actual values...

```
      volts = rawADCval * 6.144 / 32767;
```

This is what I got originally...

```
A:2.376049:3.536241:0.536149:0.536149
a:12976:19312:2928:2928
```

And this is what I get with the change made...

```
A:2.430074:3.621111:0.546017:0.552017
a:12976:19312:2912:2944
```

Note that there is a difference in the calculated voltage, but the Raw value is the same.

Unsure why this is. I have quickly experimented with using different datatypes, for example changing int to int_16 as this is one of the differences with your test code, but it does not change the outcome.

Can you make the change above and re-test

KirikauKiwi, 2024-12-12:
I knew you were not a fan of the Adafruit libraries (often bloated), but it was the easiest one for me to grab with out having to do much to test with.

Many people may have not noticed the difference depending on what they were measuring, I have seen many experienced builders using spirt and laser levels that are clearly out of whack, but they still believe it to be true.

> It should be considered that it could also be hardware as well. It is worth probing VCC at the ADC and at the sensor to see if there is any difference as this would produce a similar effect. Testing my board here shows 5v at the buck, 5v at VCC pin on the ADS1115 and 5v at VCC on the pressure sensors. I don't expect it would be any different for you, but worth eliminating.

I will test the hardware voltages further tomorrow, my initial check have shown the externally measured voltages to be slightly higher than what the voltages are shown within the DIYFB API, e.g when looking at the MAF sensor with it 4.98V lookup point, the API was at about 5.03V and my scope was saying about 5.1V, but the scope voltage depends on wether I am looking at the bottom, top or a mean value, I couldn't find a measurement point that aligned.

This is with the pot adjusted to give a reading of 2.500xxxV on the MAF Sensor pin of the ADS1115.

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

This is my 5V supply line, bumped up over 5V to allow the FS reading of the MAF lookup values.

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

Tis is with the Pot adjusted to give the MAF FS reading of 1805.5KGH, 4.98V on the look up table.

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

DeeEmm, 2024-12-12:
What scope are you using? Looks a lot nicer than my Hantek 😄 (I'm too cheap to buy a proper scope). I did have a nice scope that I left back in the UK when I moved here some 20+ years ago (too big and heavy), just wasn't doing much electronics at the time.

> my initial check have shown the externally measured voltages to be slightly higher than what the voltages are shown within the DIYFB API, e.g when looking at the MAF sensor with it 4.98V lookup point, the API was at about 5.03V and my scope was saying about 5.1V, but the scope voltage depends on wether I am looking at the bottom, top or a mean value, I couldn't find a measurement point that aligned.

This raises am interesting question about initial setup. Originally the intent is to use the trimpot settings to being any deviation back in range, however this depends on where you are viewing the voltage.

From the ADCs perspective, it will be accurate if VCC at the ADC is in spec
From the Pressure sensors perspective, it will be accurate if VCC at the sensor is in spec
From the MCUs perspective, it views I2C data over the bus, so should not be impacted by voltage deviations, however if we utilise the internal ADC of the MCU to measure the VCC_5V_PIN, then MCU will be accurate if VCC at the MCU is in spec.

My measurements above are only a quick look with a DMM. I will set the scope up and take a harder look at this, but we may have a fundamental problem.

Based on the above we need to add a trimpot for the ADC itself. OR we set the 5V bus so that VCC at the ADC is correct and then trim the values for each sensor + MCU.

I think that the latter is the better solution.

- MCU does not care if 5v supply is nigher as it has on board regulator, it just needs to be trimmed so that the VCC_5V_PIN reading is accurate
- Likewise pressure sensors do not care what VCC is, but it needs to be identified and included within the transfer function as the pressure sensor is ratiometric across the acceptable VSS range. So the trim for each pressure sensor needs to be the difference between the measured value (VCC_5V_PIN) and VCC at each sensor.

So what we end up with is a commissioning procedure that looks like this...

- Set the 5v buck so that you get 5v at the VCC pin of the ADS1115
- Set the VCC_5V_TRIMPOT value so that the MCU reports 5v
- Set PREF_MV_TRIMPOT to correct voltage at VCC pin on pRef sensor
- Set PDIFF_MV_TRIMPOT to correct voltage at VCC pin on pDiff sensor
- Set PITOT_MV_TRIMPOT to correct voltage at VCC pin on pitot sensor

Furthermore if we look at a typical transfer function we can se that the voltage compoinent is taken from

KirikauKiwi, 2024-12-12:
Test comparing,  volts = rawADCval * config.ADC_GAIN / config.ADC_RANGE; VS volts = rawADCval * 6.144 / 32767;

DIYFB RAW ADC values with config.ADC_GAIN / config.ADC_RANGE

- 2.500015V, 13654, this is 321 bits above the ideal
- 4.980071V, 27196 this is 636 bits above the ideal
- 5.039949V, 27542 this is 662 bits above the ideal

DIYFB RAW ADC values with 6.144 / 32767

- 2.500951V, 13336, this is 3 bits above the ideal
- 4.980527V, 26560 this is 0 bits above the ideal
- 5.033216V, 26844 this is 36 bits above the ideal

DeeEmm, 2024-12-12:
All of this is interesting as it also relates to #279 - Add probe points on PCB

So in addition to 0v / 3.3v and 5v we also have:

- VCC on ADS1115
- VCC pin on pRef sensor
- VCC pin on pDiff sensor
- VCC pin on pitot sensor

DeeEmm, 2024-12-12:
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

Looks like that's it 👍

KirikauKiwi, 2024-12-12:
> What scope are you using? Looks a lot nicer than my Hantek 😄 (I'm too cheap to buy a proper scope)

It was an early Christmas present to myself, it is the baby of the picoscope range [picoscope 2204A](https://www.picotech.com/oscilloscope/2000/picoscope-2000-overview) Black Friday delivered to my door for a shade under £90, regular price £115

DeeEmm, 2024-12-12:
Oooh very nice. Might be time for an upgrade. Looks heaps better than the Hantek which is pretty basic...

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

KirikauKiwi, 2024-12-12:
The Picoscope [software](https://www.picotech.com/downloads) has a demo mode. It has been a while since I have used a scope I am pretty impressed with it and yeah the software seems slick, very glad that I went with a USB style scope of the like of the Rigol's etc.
Would love one of their automotive scopes but don't do that stuff anymore since moving from NZ.

DeeEmm, 2024-12-12:
> The Picoscope [software](https://www.picotech.com/downloads) has a demo mode.

Cool. Will have a play

KirikauKiwi, 2024-12-12:
> Looks like that's it 👍

It is a weird one, on paper it should be doing the same math as the values being pulled in to the formula as they are the same as in those in the hardcode. 🤷‍♂️

Main thing at least it was not too difficult to resolve!!!!!!

KirikauKiwi, 2024-12-12:
<details><summary>Did a bit of a search on the possible reasons, I am don't know enough about C++, to me the maths should work either way.</summary>
Got it! Since rawADCval is defined as an int, you'll need to ensure the division is done in floating-point arithmetic to avoid any precision issues. Here’s how you can modify the expressions to ensure accurate calculations:
```
cpp
double volts1 = rawADCval * ADC_GAIN / static_cast<double>(ADC_RANGE);
double volts2 = rawADCval * 6.144 / 32767.0;
```
By casting ADC_RANGE to double in volts1, and using 32767.0 in volts2, you ensure that the division is performed with floating-point precision. This way, both calculations should yield the same result.
So, your final code should look something like this:
```
cpp
int rawADCval; // Ensure this is properly initialized
double ADC_GAIN = 6.144;
int ADC_RANGE = 32767;

double volts1 = rawADCval * ADC_GAIN / static_cast<double>(ADC_RANGE);
double volts2 = rawADCval * 6.144 / 32767.0;
```
Both volts1 and volts2 should now give the same voltage values. If they still differ, there might be other factors at play, such as how rawADCval is obtained or any compiler-specific optimizations. 🛠️🔍
</details>

DeeEmm, 2024-12-12:
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

Yes, could have been infinitely more complex 😆

I'll close this out now. Changes are now in DEV

DeeEmm, 2024-12-12:
> you'll need to ensure the division is done in floating-point arithmetic to avoid any precision issues.

Ahh, yes makes sense. I wonder if we have any other instances of the same?

Would be worth auditing to see if we have the same issue elsewhere

DeeEmm, 2024-12-12:
Similar potential issue...

```
		case LINEAR_ANALOG : {
			long refPressRaw = analogRead(pins.REF_PRESSURE_PIN);
			sensorVolts = refPressRaw * (_hardware.get3v3SupplyVolts() / 4095.0);
			break;
		}
```

refPressRaw is a long

DeeEmm, 2024-12-12:
OK updated for all LINEAR_ANALOG cases. Changes are on the current branch I'm working on so they will be brought in on my next PR.

```
		case LINEAR_ANALOG: {
			long mafRaw = analogRead(pins.MAF_PIN);
			sensorVolts = static_cast<double>(mafRaw) * (_hardware.get3v3SupplyVolts() / 4095.00F);
			break;
		}
```

DeeEmm, 2024-12-12:
Also found in SensorData struct...

```
  long BaroPA = 0;
```

Have changed to double. This is used in Air density calcs which is obviously part of mass - volumetric conversion

DeeEmm, 2024-12-12:
Same in 5v calcs...

```
    long rawVoltageValue = analogRead(pins.VCC_5V_PIN);
    vcc5vSupplyVolts = (2 * static_cast<double>(rawVoltageValue) * 0.805860805860806F) ;
    return vcc5vSupplyVolts + config.VCC_5V_TRIMPOT;
```

KirikauKiwi, 2024-12-12:
Having a double check of everything and the raw adc values and the voltages are spot on how ever the GUI for the MAF is not displaying the correct lookup for 4.98V which should be 1805.5 KGH.

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

DeeEmm, 2024-12-12:
> Having a double check of everything and the raw adc values and the voltages are spot on, however on the GUI, the MAF value is not displaying the correct lookup for 4.98V which should be 1805.5 KGH.

What MAF are you using?

DeeEmm, 2024-12-12:
ahh ok I assume the Bosch unit.based on the value

4.97 is not seen as equal or greater than the max value, so the actual value is interpolated.

It uses linear interpolation to scale the value between the current value, and the next lowest value.

```
		} else if (Key > refValue && rowNum > 0) { // The value is somewhere between this and the previous key value so let's use linear interpolation to calculate the actual value:

			u_int KeyPrev = status.mafLookupTable[rowNum - 1][0]; // Key value for the previous row (x1)
			u_int ValPrev = status.mafLookupTable[rowNum - 1][1]; // Flow value for the previous row (y1)

			// Linear interpolation y = y1 + (x-x1)((y2-y1)/(x2-x1)) where x1+y1 are coord1 and x2_y2 are coord2
			lookupValue = ValPrev + (refValue - KeyPrev)*((Val-ValPrev)/(Key-KeyPrev));
			sensorVal.MafLookup = lookupValue;
			break;

		} else if (rowNum == status.mafDataTableRows && refValue > Key) { //we're at the largest value, this must be it
			lookupValue = Val; // lets use the associated lookup value
			sensorVal.MafLookup = Val;
			// TODO status message MAX FLOW
			break;
		}
```

However it looks as if the comparison is just returning the previous value.

I can also see that there are similar issues as above where we are mixing doubles and ints. I will sit down later and take a look at changing those. Need to do a spot of DIY before the wife comes home 😆

KirikauKiwi, 2024-12-12:
Well spotted, yes I have the Bosch MAF sensor json currently loaded.
I am only 3 bits shy, 562.5 uV is not bad for manually adjusting a potentiometer 😄

It only updates to 1805.5 KGH once I get above 5.03V.

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

black-top, 2024-12-12:
Those software issues might be a significant contributor to the fluctuating values and inaccuracies, but I think there are hardware issues too. Measuring voltage directly on the ADC board A0 (MAF input) I see 1.06V, if I disconnect MAF signal wire from the main board and measure MAF signal I see 1.00V, and on the ADC board A0 0.06V, so somewhere at the board that additional 0.06V is induced. I tested at different ground points at PCB for the oscilloscope, but don't see differences, so probably not a ground loop. I also soldered 10uf tantalum capacitor directly on ADC power pins.
Maybe ADC traces go near power traces and get induced voltage.
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

KirikauKiwi, 2024-12-12:
I have made some measurements with my setup as I am on a prototype/bread board with wire jumpers.

- The first two voltages (top to bottom) from the API connected as a working system e.g. MAF voltage is connected to A0, I adjusted the pot to get as close to 1.06V as I could. (Screen shot 1)
- The third and fourth voltages from the API are measuring the MAF output voltage not connected to A0, with the scope displaying the MAF voltage. (first photo)
- The fifth and sixth voltages from the API are with the MAF disconnnected from A0 the scope measuring A0. (Screen shot 2)

Screen shot 1.

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

Screen Shot 2.

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

black-top, 2024-12-12:
@KirikauKiwi  Does  "MAF_MV_TRIMPOT" work for you correctly?  From yesterday testing, I don't see much change at flow measurements with  0 or -0.18  "MAF_MV_TRIMPOT".

DeeEmm, 2024-12-12:
> if I disconnect MAF signal wire from the main board and measure MAF signal I see 1.00V, and on the ADC board A0 0.06V, so somewhere at the board that additional 0.06V is induced.

You are measuring the floating ADC input of the ADS1115 so you are not really seeing the voltage of the PCB, just the inside of the ADC1115.  You cannot really measure the ADC in this manner.

The pressure sensor connects direct to the ADC via a 10k current limiting resistor and tied to ground by C18 a 330nf capacitor which acts as a filter so there is no possibility that the line is getting pulled up. The voltage you see is the ADCS1115, which may not necessarily be an issue.

Did you apply the changes discussed above? They address the 0.06v issue, which is related to an issue in the ADC code

> I tested at different ground points at PCB for the oscilloscope, but don't see differences, so probably not a ground loop. I also soldered 10uf tantalum capacitor directly on ADC power pins. Maybe ADC traces go near power traces and get induced voltage.

Induced voltages should not be an issue with a DC only system. This is normally more of an issue with AC based systems or signals, especially high frequency signals where the issue presents itself as noise.

KirikauKiwi, 2024-12-12:
> @KirikauKiwi Does "MAF_MV_TRIMPOT" work for you correctly? From yesterday testing, I don't see much change at flow measurements with 0 or -0.18 "MAF_MV_TRIMPOT".

Yes they are working for me.

Are you deleting the existing configuration.json file via the Configuration GUI page and then uploading the new configuration.json file?

black-top, 2024-12-12:
Yes, yesterday I uploaded latest dev with all .json files,  CFM values are almost identical without trim pot adjustment, the results of yesterday measurements:

https://github.com/DeeEmm/DIY-Flow-Bench/discussions/147#discussioncomment-11534482

black-top, 2024-12-12:
@DeeEmm  I don't see the release folder at the latest DEV for upload files, or do I need to update differently this time?

DeeEmm, 2024-12-12:
If you go to the main page and click the dropdown,  you will see a list of current branches.

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

You can also navigate directly - https://github.com/DeeEmm/DIY-Flow-Bench/tree/DEV

black-top, 2024-12-13:
@DeeEmm  Uploaded latest dev, will do testing soon.
This is the problem I was mentioning before.
Pref and Pitot after upload config are the same, even though they are set differently at config.
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

DeeEmm, 2024-12-13:
ok will take a look. likely a cut and paste error on my part

DeeEmm, 2024-12-13:
As suspected, a cut and paste error.

It is fixed in DEV in commit [ce47e0a](https://github.com/DeeEmm/DIY-Flow-Bench/commit/ce47e0a949f000e787c5786b7ba444d3069d4c64)

Closed 2024-12-12.

Thread 292 (2024-12-12):

[BUG]preload.html, Temp Webserver hangs with json file uploads

KirikauKiwi, 2024-12-12:
Since the major changes post 205 Build, I have notice that when uploading the four json files via the preload.html page that the webpage is often not refreshing. The serial monitor shows the file as parsed.

Reloading the page in browser often get it to update the page, sometimes not. My experience is that it is more problematic with the MAF.json file compared to the other three json files.
When attempting to upload the MAF.json the web url is often stuck at diyfb.local/api????/upload, apologies as lost my copy of it from my clipboard.

This is similar to #266 and the boot loop.

I have tried increasing the delay of vTaskDelay from 1 to 1000, it doesn't appear to help as it did with increasing the delay after tempServer ->end

DeeEmm, 2024-12-12:
Take a look at your serial monitor as you upload the file in the browser. I suspect that you will see a panic related to  asyncTCP.

The file appears to upload okay, but it is crashing just after file upload for som reason.

I think that this is the reason that the redirect does not get actioned as the browser connection is closed before it is sent.

I've not got to the bottom of why this is happening yet. I suspect that it is memory related, just haven't figured out how as increasing the loop task size does not fix the issue

KirikauKiwi, 2024-12-12:
Looking at the boot loop would it be worth declaring the objects outside of the loop along with the web server initialisation as repeated creation of the objects and web server initialisation within the loop could possibly cause memory management issues or excessive resource usage.
```
void DataHandler::bootLoop()
{
    extern struct DeviceStatus status;
    extern struct BenchSettings settings;
    extern struct SensorData sensorVal;

    Hardware _hardware;
    Calculations _calculations;
    Messages _message;
    Webserver _webserver;
    API _api;
    DataHandler _data;

    bool shouldReboot = false;

    // if the weberver is already running skip sever initialisation
    if (!status.webserverIsRunning) {

      _message.serialPrintf("Spinning up temporary web server\n");
      _message.serialPrintf("View browser to upload missing files\n");

      tempServer = new AsyncWebServer(80);
      // tempServerEvents = new AsyncEventSource("/events");

      // Upload request handler
      tempServer->on("/api/file/upload", HTTP_POST, [](AsyncWebServerRequest *request) {
          Messages _message;
          _message.debugPrintf("/api/file/upload \n");
          // request->send(200);
          },
          _webserver.fileUpload);

      // Index page request handler
      tempServer->on("/", HTTP_ANY, [](AsyncWebServerRequest *request){
          Language language;
          Webserver _webserver;
              request->send_P(200, "text/html", language.LANG_INDEX_HTML, _webserver.processLandingPageTemplate);
          });

      tempServer->onFileUpload(_webserver.fileUpload);
      // tempServer->addHandler(tempServerEvents);
      tempServer->begin();

      _message.serialPrintf("Waiting...\n");

    }

    do {
    // capture program pointer in loop and wait for files to be uploaded

        // Process API comms
        if (settings.api_enabled) {
            if (millis() > status.apiPollTimer) {
                if (Serial.available() > 0) {
                    status.serialData = Serial.read();
                    _api.ParseMessage(status.serialData);
                }
            }                    
        }

        // This is the escape function. When all files are present and loaded we can leave the loop
        if ((status.configLoaded == true) && (status.pinsLoaded == true) && (status.mafLoaded == true) && (status.GUIexists == true) ){
          status.doBootLoop = false;
          break;
        }
        // if (status.pinsFilename.isEmpty();

        vTaskDelay( 1 );

    } while (status.doBootLoop == true);

    // if the weberver is already running skip sever reset
    if (!status.webserverIsRunning) {
      tempServer->end();  // Stops the server and releases the port
      delay(1000);  // 1000ms delay to ensure the port is released
      tempServer->reset();
    }
}
```

DeeEmm, 2024-12-13:
There are no declarations within the loop itself.

```
    do {
    // capture program pointer in loop and wait for files to be uploaded

        // Process API comms
        if (settings.api_enabled) {
            if (millis() > status.apiPollTimer) {
                if (Serial.available() > 0) {
                    status.serialData = Serial.read();
                    _api.ParseMessage(status.serialData);
                }
            }                    
        }

        // This is the escape function. When all files are present and loaded we can leave the loop
        if ((status.configLoaded == true) && (status.pinsLoaded == true) && (status.mafLoaded == true) && (status.GUIexists == true) ){
          status.doBootLoop = false;
          break;
        }
        // if (status.pinsFilename.isEmpty();

        vTaskDelay( 1 );

    } while (status.doBootLoop == true);

```

The other declarations are masked by the webserverIsRunning variable

```
    // if the weberver is already running skip sever initialisation
    if (!status.webserverIsRunning) {
        ...
    }
```

This way if we are already running and then delete a file, we do not recreate the webserver instance, we simply use the one that is already running.

It might be worth considering a reload after the final file is uploaded to clear down the memory.

Did you check to see whether you also see the asyncTCP panic?

DeeEmm, 2024-12-13:
``` this is what I am seeing in the serial monitor when uploading files

--- Terminal on /dev/cu.usbserial-144430 | 115200 8-N-1
--- Available filters and text transformations: colorize, debug, default, direct, esp32_exception_decoder, hexlify, log2file, nocontrol, printable, send_on_enter, time
--- More details at https://bit.ly/pio-monitor-filters
--- Quit: Ctrl+C | Menu: Ctrl+T | Help: Ctrl+T followed by Ctrl+H
CONFIG file Found:
Loading Configuration
Loading Configuration
PINS file Found: /PINS_WEMOS_D1_R32.json
Loading Pins Data
Parsing Pins Data
Loading Pins Data
Parsing Pins Data
MAF file Found: /MAF_DELPHI_AF10118.json
Loading MAF Data

***ERROR*** A stack overflow in task async_tcp has been detected.

Backtrace:0x40083a85:0x3ffdfbe00x4008bb9d:0x3ffdfc00 0x4008f071:0x3ffdfc20 0x4008d85f:0x3ffdfca0 0x4008bcac:0x3ffdfcd0 0x4008bc5c:0x0000007c  |<-CORRUPTED

  #0  0x40083a85:0x3ffdfbe0 in panic_abort at /Users/ficeto/Desktop/ESP32/ESP32S2/esp-idf-public/components/esp_system/panic.c:402
  #1  0x4008bb9d:0x3ffdfc00 in esp_system_abort at /Users/ficeto/Desktop/ESP32/ESP32S2/esp-idf-public/components/esp_system/esp_system.c:128
  #2  0x4008f071:0x3ffdfc20 in vApplicationStackOverflowHook at /Users/ficeto/Desktop/ESP32/ESP32S2/esp-idf-public/components/freertos/port/xtensa/port.c:394
  #3  0x4008d85f:0x3ffdfca0 in vTaskSwitchContext at /Users/ficeto/Desktop/ESP32/ESP32S2/esp-idf-public/components/freertos/tasks.c:3504
  #4  0x4008bcac:0x3ffdfcd0 in _frxt_dispatch at /Users/ficeto/Desktop/ESP32/ESP32S2/esp-idf-public/components/freertos/port/xtensa/portasm.S:436
  #5  0x4008bc5c:0x0000007c in _frxt_int_exit at /Users/ficeto/Desktop/ESP32/ESP32S2/esp-idf-public/components/freertos/port/xtensa/portasm.S:231

ELF file SHA256: 0000000000000000

Rebooting...

```

DeeEmm, 2024-12-13:
Very limited info on this error

```
***ERROR*** A stack overflow in task async_tcp has been detected.
```

KirikauKiwi, 2024-12-13:
> Did you check to see whether you also see the asyncTCP panic?

Yes getting a very similar asyncTCP panic to the one you posted above. There is not a lot of information available when I have been looking in to it.

The panic happens most often with the MAF.json, and most of the time for me with the other three json files. At random time some of the smaller json files will load/parse as expected.

The best I have found so far has been this,
The corruption marker in the backtrace, particularly the 0x0000007c |<-CORRUPTED, indicates that the stack memory has been overwritten or corrupted. This often occurs due to:
- Stack Overflow: The task's stack size is too small for the operations it needs to perform, leading to overwriting memory regions.
- Memory Corruption: Another part of the program might be writing into the task's stack space inadvertently, causing corruption.

KirikauKiwi, 2024-12-13:
I noticed you have added in some code to check for the stack over flows via relevant hooks, has this highlighted anything useful?

DeeEmm, 2024-12-13:
Not yet, I've not been able to spend much time on this so far.

The issue is definitely memory related, the overflow indicates that memory is being written past defined registers, which kind of implies that the memory assigned to asyncTCP is too small. But I cannot find anywhere that refers to how to manage the memory for the asyncTCP task. Perhaps this is a wild red herring chase.

I did find one issue that sounds like it might be related but not had a chance to digest it yet

https://github.com/me-no-dev/ESPAsyncWebServer/issues/1381

DeeEmm, 2024-12-13:
ok, found the issue...

in Webserver::fileUpload we check to see what file was uploaded and then do two things.

1 - We load the file if appropriate
2 - We set a variable to say that the code is loaded.

This is how we break out of the boot loop.

(commented out code below)

```
  if (final)  {
    _message.debugPrintf("Upload Complete: %s, %u bytes\n", filename.c_str(), file_size);
    request->_tempFile.close();

    // if (_data.checkUserFile(CONFIGFILE)){
    //   _data.loadConfiguration();
    //   status.configLoaded = true;
    //   redirectURL = "/";
    //   // redirectURL = "/?view=upload";
    // }
    // if (_data.checkUserFile(PINSFILE)){
    //   _data.loadPinsData();
    //   status.pinsLoaded = true;
    //   redirectURL = "/";
    //   // redirectURL = "/?view=upload";
    // }
    // if (_data.checkUserFile(MAFFILE)) {
    //   _data.loadMAFData();
    //   status.mafLoaded = true;
    //   redirectURL = "/";
    //   // redirectURL = "/?view=upload";
    // }
    // if (_data.checkUserFile(INDEXFILE)) {
    //   status.GUIexists = true;
    //   redirectURL = "/";
    // }

    request->redirect(redirectURL);
  }
}
```

Obviously executing blocking / delaying code at this point in the async process is casing the issue. So I suspect that this needs to be moved outside of Webserver::fileUpload

I did play with this before but ran into some issues

Will take another look at how to achieve this without blocking the async process

DeeEmm, 2024-12-13:
Ok. I've managed to isolate this to a single line.

Removing the redirectURL assignment seems to have 'fixed' the issue.

There is now a little oddness in that the browser does not redirect to the bootloop, but this in itself is not an issue.

For example. We delete the MAF file. The browser stays on the file manager dialog, but we then decide to close the file managed dialog and carry on using DIYFB normally.

The MAF data is already in memory and will remain there until the MCU is rebooted.

At reboot the boot sequence detect that the MAF file is missing and sends code execution into the boot loop.

DeeEmm, 2024-12-13:
we now have this...

```

  if (final)  {
    _message.debugPrintf("Upload Complete: %s, %u bytes\n", filename.c_str(), file_size);
    request->_tempFile.close();

    if (_data.checkUserFile(CONFIGFILE)){
      _data.loadConfiguration();
      status.configLoaded = true;
    }
    if (_data.checkUserFile(PINSFILE)){
      _data.loadPinsData();
      status.pinsLoaded = true;
    }
    if (_data.checkUserFile(MAFFILE)) {
      _data.loadMAFData();
      status.mafLoaded = true;
    }
    if (_data.checkUserFile(INDEXFILE)) {
      status.GUIexists = true;
    }

    request->redirect(redirectURL);
  }

```

DeeEmm, 2025-01-09:
Going to close this out as file upload replaced by NVM data

Closed 2025-01-09.

Thread 293 (2024-12-12):

[BUG]Latency

KirikauKiwi, 2024-12-12:
Version: V2.0-RC8
Build: 2412120056

Adding this here as struggling to note where we discussed this yesterday.

Since the updates to DEV branch post 205-post-compile-configuration, there is a noticeable latency in the GUI updating, most obvious with the BME sensor data, the data from the pressure sensors appears to  updating more frequently.

Whilst working on #288 I have noticed the latency while using the API too, at times taking more than one minute for a response from the API.

KirikauKiwi, 2024-12-12:
A little more information. The latency on the GUI is still present, but when switching the the relay for Start Bench and Stop Bench this is working as normal with no noticeable difference to the previous builds.

DeeEmm, 2024-12-12:
The on / off commands are sent direct to the ESP via HTTP request sent by XHR.

GUI -> javascript event listener -> Button event -> XHR request -> http://.../API/bench/on -> AsyncWebServerRequest

This works with no latency

Similarly the Server Side Events going in the opposite direction also work fine

DataHandler::buildSSEJsonData -> JSON SSE -> browser -> addEventListener('JSON_DATA') -> GUI update

There is a difference in refresh rates between environmental and sensor data, simply as the environmental data does not change as fast.

```
int ADC_SCAN_DELAY_MS = 250;
int BME280_SCAN_DELAY_MS =  1000;
```

I'm not seeing any lag or latency to the refresh values here, they appear to be working at normal rate, This is echoed by bench on/off response.

What I am seeing a delay in is the operation of the API. I'm not seeing 60 second delays but still maybe 20 seconds in some cases. Still way higher than it should be. I am also seeing some increase in page load times and initial GUI population

The latency has increased since the post-compile stuff was done. This would be related to the additional stack memory used. which has basically doubled from what it was before.

It should be noted that API calls are made in the loop, whereas all other actions are made asynchronously.

Sensor updates are done via xtasks and semaphore handoff - each sensor task (ADC / Enviro) are carried out on its own dedicated core.

Outgoing server tasks (SSE) is asynchronous

Same thing with GUI browser tasks (XHE)

There might be a possibility that upgrading the arduinoJSON7 can improve the situation. This is because it uses dynamic memory allocation for JSON documents, whereas at the moment we need to manually define them. This means tha we need to cater for the 'worst case scenario' i.e. the largest file which in our case is a 27k MAF file. It also may increase the issue as it takes up more memory than V6.

We can also spend some time going through code optimisation to see if we can make gains there although this is usually done last thing

KirikauKiwi, 2024-12-12:
I am experiencing very odd behaviour with Chrome or Safari, very slow to update and at times when you reload the page the tiles remain blank for a longtime before being populated

Here is a screen shot of two Safari Browser windows and one from Chrome, the Safari browser window that has the same values as the Chrome browser I opened as a private window, the chrome window is not an incognito window.

All three Tiles update when the voltages are changed, but MAF difference remains.

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

DeeEmm, 2024-12-12:
> I am experiencing very odd behaviour with Chrome or Safari, very slow to update and at times when you reload the page the tiles remain blank for a longtime before being populated
>

Yes this is similar to what I mentioned above,  increase in page load times and initial GUI population.

>
> All three Tiles update when the voltages are changed, but MAF difference remains.
>

Sorry I don't understand what you are saying. Can you please explain what the 'MAF difference' is.

KirikauKiwi, 2024-12-13:
Sure no problem to clarify.

I have two browser windows open simultaneously with diyfb.local as the url.
The MAF values being displayed are different in the two browser windows?? how can this be if they are using the same HTML to access the same "FLOW" data from the ESP32???

PRef, PDiff and Pitot sensors follow each other as expected in both browser windows. The MAF values will both change if I adjust the input voltage but the Values displayed are different???

KirikauKiwi, 2024-12-13:
Ignore that LOL.

It is obviously because the MAF tiles are not set the same LOL!!!!!!! Another one of those Dumb moments!!!!!!

DeeEmm, 2024-12-13:
Haha. Screen blindness. Cannot see the wood for the trees. Happens to the best of us. 😆

DeeEmm, 2024-12-13:
So browser latency might be related to the javascript.

The pipe between the MCU and the Browser is fine

It is only the GUI that is sluggish, not the data.

I have parked some stuff that I was working on by commenting it out (GUI serial monitor). Might be worth stripping that out of the code and seeing if that makes a difference (it's right at the bottom)

```

// Serial monitor modal
// https://developer.chrome.com/docs/capabilities/serial
// var port, textEncoder, writableStreamClosed, writer;
// async function connectSerial() {

//     try {

//         // Prompt user to select any serial port.
//         const port = await navigator.serial.requestPort();
//         // const port = await navigator.serial.getPort()
//         await port.open({ baudRate: 115200 });

//         textEncoder = new TextEncoderStream();
//         writableStreamClosed = textEncoder.readable.pipeTo(port.writable);

//         writer = textEncoder.writable.getWriter();
//         listenToPort();
//     } catch {
//         alert("Serial Connection Failed");
//     }
// }
// async function sendCharacterNumber() {
//     document.getElementById("lineToSend").value = String.fromCharCode(document.getElementById("lineToSend").value);
// }
// async function sendSerialLine() {
//     dataToSend = document.getElementById("lineToSend").value;
//     if (document.getElementById("addLine").checked == true) dataToSend = dataToSend + "\r\n";
//     if (document.getElementById("echoOn").checked == true) appendToTerminal("> " + dataToSend);
//     await writer.write(dataToSend);
// }
// async function listenToPort() {
//     const textDecoder = new TextDecoderStream();
//     const readableStreamClosed = port.readable.pipeTo(textDecoder.writable);
//     const reader = textDecoder.readable.getReader();
//     // Listen to data coming from the serial device.
//     while (true) {
//         const { value, done } = await reader.read();
//         if (done) {
//             // Allow the serial port to be closed later.
//             reader.releaseLock();
//             break;
//         }
//         // value is a string.
//         appendToTerminal(value);
//     }
// }
// const serialResultsDiv = document.getElementById("serialResults");
// async function appendToTerminal(newStuff) {
//     serialResultsDiv.innerHTML += newStuff;
//     if (serialResultsDiv.innerHTML.length > 3000) serialResultsDiv.innerHTML = serialResultsDiv.innerHTML.slice(serialResultsDiv.innerHTML.length - 3000);

//     //scroll down to bottom of div
//     serialResultsDiv.scrollTop = serialResultsDiv.scrollHeight;
// }
// document.getElementById("lineToSend").addEventListener("keyup", async function (event) {
//     if (event.keyCode === 13) {
//         sendSerialLine();
//     }
// })
// document.getElementById("baud").value = (localStorage.baud == undefined ? 115200 : localStorage.baud);
// document.getElementById("addLine").checked = (localStorage.addLine == "false" ? false : true);
// document.getElementById("echoOn").checked = (localStorage.echoOn == "false" ? false : true);

// // CODELAB: Add feature detection here.
// const notSupported = document.getElementById('notSupported');
// notSupported.classList.toggle('hidden', 'serial' in navigator);
```

There are also some extra modal windows - for serial monitor and the data modal along with accompanying javascript. This may also have an impact.

I really want to get the data modal up and running as it gives us somewhere to report load times and latency

DeeEmm, 2024-12-13:
We could also consider splitting everything up into seperate files and having only a minimal file for the main GUI, however this does complicate things considerably, especially for the end user needing to manage multiple files. I think that this is a last resort.

I am confident that code optimisation can resolve the issue

DeeEmm, 2024-12-13:
Fixed it for you 😉

DeeEmm, 2024-12-13:
Although javascript is just about to get larger due to additional configuration / user params.

I have previously considered embedding the HTML within the core code. We already do this with the Boot Loop if there is no index.html file. We serve up a minified version of the page that is stored within one of the language structs and only contains the file upload dialog. It is in the language struct so that people can translate it. Similarly anyone can translate the entire index.html file although we do break out individual titles and headings into the language file to prevent having to do that

In essence we already store the file in SPIFFS and send it to the browser on page load. There's really no difference where that data comes from. It takes up the same amount of room on the device and still needs to be sent to the browser on each page load.

Again it's another large change and I'm not sure that the benefits outweigh the work needed to do it.

Comparatively speaking the  HTML / Javascript is nothing compared to something like Facebook. The issue will no doubt just be crappy coding 😆

KirikauKiwi, 2024-12-13:
> I have parked some stuff that I was working on by commenting it out (GUI serial monitor). Might be worth stripping that out of the code and seeing if that makes a difference (it's right at the bottom)

I have deleted that from the src/javascript.js file and cleared the flash on my esp32 and uploaded to test. Latency is still present with no perceivable change.

DeeEmm, 2024-12-13:
Not sure how familiar you are with the Chrome 'webserver tools' extension, kind of valuable for web stuff.

It has some great features for measuring page load times etc. You can view the time taken for the first SSE event to come through...

Go to the 'Network' tab and click on 'events' after page load, this will show you to SSE data along with timestamps.

You an also view the raw data at http://diyfb.local/events

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

KirikauKiwi, 2024-12-13:
> It is only the GUI that is sluggish, not the data.

If that was so, would the serial API response not be affected??? As I am seeing the sluggishness with the API too in CoolTerm and serial monitor in VSCode.

DeeEmm, 2024-12-13:
> If that was so, would the serial API response not be affected??? As I am seeing the sluggishness with the API too in CoolTerm and serial monitor in VSCode.

I was just talking from GUI perspective, but yes you are right, so likely not javascript related.

DeeEmm, 2024-12-13:
This points to the main code being the root cause (common source)

DeeEmm, 2024-12-13:
Page load times - most of which is waiting for server response. On top of this we have the SSE delay, which again is likely mostly server delay, so for me all up I am seeing 800ms + 2207ms so just over 3 secs all up.

Not overly long, but definitely a lot longer than it was originally.

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

KirikauKiwi, 2024-12-13:
I am less familiar with java, html web based code than I am with C++ and I am still not very literate at that either.
Safari with the develop tools enabled has similar too I think. I do like how Chrome has the web serial too 👍

You can record a timeline of the page load, events etc.

https://github.com/user-attachments/assets/6efd9826-430c-441b-ba9f-9a63fc1adfd0

DeeEmm, 2024-12-13:
Ahhh Safari.

The only time I use it is to check browser compatibility and then not so often nowdays. It's a toy compared to Chrome for webdev stuff.

Web Developer tools is the defacto standard really. Safari dev tools are not bad, but definitely prefer Chrome.

KirikauKiwi, 2024-12-13:
Looking at the event stream in Chrome as you suggested I am typically seeing 2-4s and not as frequently, but still regularly 5-11s delays.

KirikauKiwi, 2024-12-13:
What changes were made to how the I2C data bus is setup/used with the 205-post-compile-configuration changes.

I am not sure if I have set it up correctly on my picoscope, but I was curious to look at the I2C bus as the scope can decode it.

The I2C bus with the current DEV build, the data appears to be not very good i.e it looks incomplete, non existent, compared to the DEV build prior to the 205-post-compile-configuration updates.
It also looks a bit inconsistent in the previous build too, i.e the data is intermittent but it looks complete as it has acknowledgements and data bytes.

I2C Bus DEV build pre 205-post-compile-configuration.

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

I2C Bus DEV build post 205-post-compile-configuration.

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

DeeEmm, 2024-12-13:
Will have a look. I think it was only the address decoding was changed from hex to decimal as JSON cannot store hex.

Wouldn't have thought that would be the issue

KirikauKiwi, 2024-12-13:
Here are a couple of wave form captures that you should be able to open in the picoscope software. Remove the .txt from the file name before opening, I had to add it so I could upload the files here.

I have a better trigger point in these files and also scoping both I2C devices and changed my scoping points to be at the pins of the ESP32, previous screen capture where taken between the BME and ADS1115.

DEV build post 205-post-compile-upload.
[20241213 DIYFB DEV build pre 205-post-compile-configuration-0002.psdata.txt](https://github.com/user-attachments/files/18126182/20241213.DIYFB.DEV.build.pre.205-post-compile-configuration-0002.psdata.txt)

DEV build pre 205-post-compile-upload.
[20241213 DIYFB DEV build post 205-post-compile-configuration-0003.psdata.txt](https://github.com/user-attachments/files/18126184/20241213.DIYFB.DEV.build.post.205-post-compile-configuration-0003.psdata.txt)

KirikauKiwi, 2024-12-13:
> Will have a look. I think it was only the address decoding was changed from hex to decimal as JSON cannot store hex.
>
> Wouldn't have thought that would be the issue

It maybe a red hearing, given I have never measured an I2C bus before, but there was a noticeable difference in the decoding of the bus by the picoscope software that I thought best to flag it as a possibility

KirikauKiwi, 2024-12-13:
Further testing of the I2C bus
If I remove the I2C bus connection from the ESP32 and check just the ESP32 I2C pins I am only getting messages about the ADS1115 at address 0x48 nothing coming from the ESP32 for the BME280 at address 0x76.
Once I connect the ADS1115 and BME back on to the bus the data from the ADS1115 is now appears.

It appears I now have the settings correct on the scope as READ and WRITES are now displayed, previously I could only see READS.
No devices connected to the ESP32 I2C bus, current DEV build.

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

ADS115 and BME connected to the ESP32 I2C bus, current DEV build.

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

No devices connected to the ESP32 I2C bus, previous DEV build you get the ADS1115 Failed message.

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

ADS115 and BME connected to the ESP32 I2C bus, previous DEV build.

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

KirikauKiwi, 2024-12-13:
Another observation is that the previous build on my was PSU 12.49V, 0.06A, 75W, the current DEV build is 12.49V, 0.09A, 1.12W so something is churning away.

DeeEmm, 2024-12-14:
> Another observation is that the previous build on my was PSU 12.49V, 0.06A, 75W, the current DEV build is 12.49V, 0.09A, 1.12W so something is churning away.

I'm seeing around 100mA here, but my PSU is pretty agricultural and only has 0.1A accuracy

At the moment I'm trying to resolve the file upload issue. I think that all of these are related to the same thing - memory allocation / memory management. This is exactly what I'm seeing with the file upload - stack and canary errors

The additional memory consumed by moving user data post compilation means that it takes up a massive amount of memory. Previously all of that data was handled by precompile macros, which essentially excluded anything that was not relevant and then compiled what was left it into its smallest form. Now we are dealing with with uncompressed text/json documents that we have to load into memory twice (once for the file in SPIFFS and again in operational memory on the stack) and so our memory usage has increased by about 300%

This will either be a memory leak, bad memory management or a combination of both. My money is on the latter.

Regarding I2C. It generally either works or it does't. I'm not sure that disconnecting a device is a valid line of enquiry. How are you initialising the bus with only one device without changing the code?, it should fail with an error on initialisation. If you are simply disconnecting the bus whilst the system is running, this is a failure mode that is not considered or tested, so essentially it is uncontrolled behaviour. It does not surprise me that it is giving you unexpected results.

It is worth considering that there is some prioritisation to the bus messaging. The ADC works on a much faster poll time than the BME.

Can I ask what symptoms are you seeing that indicate there is an issue with BME reads?

I would advise setting a test in the code to validate those observations.

For example if you suspect that there are dropped device reads, or that the device read hangs, construct a test to validate that, and then look for causality.

DeeEmm, 2024-12-14:
However. I will say that way back in my first reply I mentioned that this was a memory issue, and I think that it would be more efficient to pool together with that goal in mind.

I spent some time last night looking for memory and task reporting from the FreeRTOS codebase, however few of those fucntions are available to platformio. This is mainly because the arduino framework that platformio uses works from a compiled binary version of FreeRTOS and at teh time of compilation those additional functions were not enabled.

So it is not possible to enable them at runtime, the only way to get access to those tool is to recompile FreeRTOS from scratch.

Obviously this is a large undertaking an one outside of the scope of this project, so the quest continues to find othe suitable ways of testing  what is going on.

DeeEmm, 2024-12-14:
Dang. Looks like somehow I've fried the serial port on the ESP as I'm only seeing the bluetooth port in PIO. A reboot hasn't resolved it. Guess that's karma for being short in my reply. (sorry)

I think that what happened was that another device on the USB hub drew power back through the ESP, overloading the serial chip. I noted that when I switched my PSU off, the other USB device on the hub (Traktor mixer) rebooted.

Really need to get a powered USB hub

So entirely self-inflicted and avoidable, but also something that I've done many times before with no ill-effects. (Good job I bought a stack of Wemos boards.)

I added an API function to view heap data (x). so we now have xTask stack data (X) and Heap data (x)

Decided to do some tests...

Stack and heap with with only the index page loaded (86k)

> x:Free Heap=151684 / Max Allocated Heap=94196
> X:Stack Free Memory EnviroTask=9204 / SensorTask=9204

Then with congifuration.json uploaded (approx 2k filesize)

> x:Free Heap=151364 / Max Allocated Heap=86004
> X:Stack Free Memory EnviroTask=9204 / SensorTask=9204

Next with pins file uploaded (approx 900 bytes filesize)

> x:Free Heap=138232 / Max Allocated Heap=83956
> X:Stack Free Memory EnviroTask=672 / SensorTask=808

Note that at this point, it left the bootloop despite still requiring MAF file. Need to look at why this happened

Next I deleted the index file (86k)

> x:Free Heap=135696 / Max Allocated Heap=73716
> X:Stack Free Memory EnviroTask=656 / SensorTask=808

And then re-uploaded the index file (86k)

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

But then the serial seems to hang with no upload complete response from serial monitor

So I try try again but then get a panic...

```
UploadStart: /V2.0-RC8_2412140027_index.html
Writing file: '/V2.0-RC8_2412140027_index.html' index=0 len=192
Writing file: '/V2.0-RC8_2412140027_index.html' index=192 len=1436
Writing file: '/V2.0-RC8_2412140027_index.html' index=1628 len=612
Writing file: '/V2.0-RC8_2412140027_index.html' index=2240 len=1436
Writing file: '/V2.0-RC8_2412140027_index.html' index=3676 len=612
Guru Meditation Error: Core  0 panic'ed (LoadProhibited). Exception was unhandled.

Core  0 register dump:
PC      : 0x40112b7c  PS      : 0x00060030  A0      : 0x8010d994  A1      : 0x3ffb1ff0
A2      : 0x3ffe9548  A3      : 0x00000d30  A4      : 0x3ffe9560  A5      : 0x3ffc7a20
A6      : 0x63203a6e  A7      : 0x00000000  A8      : 0x00004620  A9      : 0x3f408c4c
A10     : 0x00000001  A11     : 0x3ffe9548  A12     : 0x3ffe9560  A13     : 0x00000b38
A14     : 0x3ffe8a70  A15     : 0x00000000  SAR     : 0x00000019  EXCCAUSE: 0x0000001c
EXCVADDR: 0x00000005  LBEG    : 0x400895c4  LEND    : 0x400895da  LCOUNT  : 0xffffffff

Backtrace:0x40112b79:0x3ffb1ff00x4010d991:0x3ffb2030 0x401644de:0x3ffb2050 0x4010b1e4:0x3ffb2070

  #0  0x40112b79:0x3ffb1ff0 in tcp_output at /Users/ficeto/Desktop/ESP32/ESP32S2/esp-idf-public/components/lwip/lwip/src/core/tcp_out.c:1305 (discriminator 4)
  #1  0x4010d991:0x3ffb2030 in tcp_recved at /Users/ficeto/Desktop/ESP32/ESP32S2/esp-idf-public/components/lwip/lwip/src/core/tcp.c:999
  #2  0x401644de:0x3ffb2050 in _tcp_recved_api(tcpip_api_call_data*) at libdeps/esp32dev/AsyncTCP-esphome/src/AsyncTCP.cpp:444
  #3  0x4010b1e4:0x3ffb2070 in tcpip_thread_handle_msg at /Users/ficeto/Desktop/ESP32/ESP32S2/esp-idf-public/components/lwip/lwip/src/api/tcpip.c:172
      (inlined by) tcpip_thread at /Users/ficeto/Desktop/ESP32/ESP32S2/esp-idf-public/components/lwip/lwip/src/api/tcpip.c:154
```

The MCU reboots but then goes to waiting for maf.json file. So it appears that the file transfer above completed despite giving an error

so I upload the VDO MAF file (approx 2k)

And then something interesting happens

> x:Free Heap=151128 / Max Allocated Heap=86004
> X:Stack Free Memory EnviroTask=9204 / SensorTask=9204

The stack watermark shows free memory of 9204 for both tasks (cores)

Obviously this is not right.

Will keep digging

KirikauKiwi, 2024-12-14:
Initial I looked at the I2C bus as part of a diagnostic work flow looking at the chain of inputs. Based on what I was observing and what I am able to physically check.

Obserservations.
- GUI is responsive to the Bench Start/Stop ✅
- GUI is reloading as expected e.g. browser refresh ✅
- GUI incoming data updating appears sluggish (initial observation and the reason behind this Bug report)
- No physical hardware changes ✅
- Change to the code base.❓
- Additional files to upload. ❓
- Serial API responses a deathly slow ❌

I then began testing the physical.
- Checking voltage outputs from the pressure sensor, and trim pots. ✅
- Now armed with the tool to decode the I2C bus ( I know!!! entering the danger zone) it showed some noticeable differences between the two build versions. ❌ hence reporting it.  (I did note that it maybe a red herring)
- Checking the code base ❓Difficult as I don't know what was changed and lack of knowledge with C++, so a slow process for me

Summary,
1. It appears that once the code is running that the GUI was working as expected other than the incoming data.
2. It may be possible that the I2C bus is affected by the memory issue. Otherwise what else would make it appear different between the builds.
3. The API response is the slowest of them all and at a guess runs in a different process which is also being affected somehow.
4. The convergence of the fault finding of #293 and #292 would indicate that it is most likely a Memory/Processing issue.

> Can I ask what symptoms are you seeing that indicate there is an issue with BME reads?

- One of the observed differences I noticed in the GUI data updates is that the BME data appears not to be updated at all for me, the ADS1115 Data was being updated albeit slowly, I am aware of the 500ms and 1000ms so I would expect to see the behaviour of the BME updates to be about twice as slow as those of the ADS updates in the GUI. It was much longer than double.
- Upon checking the decoding of the I2C bus and comparing between the two builds there was no signs of any data read or writes for the BME on the bus for the current DEV build.
- With the ESP32 being the Master on the I2C bus it would indicated that something is happening inside the ESP32 preventing the BME being the slave device providing its data to the ESP32 as the master.
- This aligns with my observations.

Is it likely something wrong with the I2C bus, no as it is working as expected with the previous DEV build, it does indicated that there is something different that is doing something to the I2C!!!

Take a look at column F in this [CSV](https://github.com/user-attachments/files/18134968/20241213.DIYFB.DEV.build.pre.205-post-compile-configuration-0004.csv) (I2C address) , it is an export of the decode from the I2C bus of the previous DEV build. you can see regular Read/Writes for the BME and more frequent Read/Writes for the ADS as expected. The read/writes are not present for the BME in the second [CSV](https://github.com/user-attachments/files/18134970/20241214.DIYFB.build.post.205-post-compile-configuration-0005.csv) which is from the current DEV build.

I am suspecting that once the memory issue is resolved/minimised that the full functionality of the I2C will return.

PS

> Guess that's karma for being short in my reply. (sorry)

I didn't find you being short in your reply, I have no problem with being questioned/challenged with this sort of thing, Trouble shooting can be a royal PITA. It is too easy to construct a test that contains bias that then confirms your observation and then conclude the wrong thing because of this.
It is always good to have a second set of eyes, ears and thought processes to fact check!!!

You are right in challenge it too, given the "DUMB" moments that occur for me.

PSS

>  I added an API function to view heap data (x). so we now have xTask stack data (X) and Heap data (x)

This looks promising 👍

KirikauKiwi, 2024-12-14:
> Regarding I2C. It generally either works or it does't.

>  I'm not sure that disconnecting a device is a valid line of enquiry. How are you initialising the bus with only one device without changing the code?

I didn't, this was was an observed difference between the the two DEV builds.

>  it should fail with an error on initialisation. If you are simply disconnecting the bus whilst the system is running, this is a failure mode that is not considered or tested, so essentially it is uncontrolled behaviour. It does not surprise me that it is giving you unexpected results.

The expected results would be in both instance for the I2C bus to stop working based on my observation of the previous builds and how the the software works, the current DEV build didn't exhibit this same behaviour as the I2C bus is still working when I removed the bus from the ESP32.

- By removing the I2C bus on the previous build you get the ADS Failure, Wire read error on the serial monitor and DIYFB stops working, which is visible in this [screen shot
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

Thread 294 (2024-12-12):

Flow Differential only compares against ACFM

DeeEmm, 2024-12-12:
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

User flow differential tile only shows differential with ACFM value.

So, when viewing other CFM values such as SCFM, the differential is incorrect.

Need to consider how to best manage User flow differential readings

KirikauKiwi, 2024-12-13:
Good spot, the simplest implementation of this would be for when the Flow diff tile is displayed that it mirrors what flow type is selected on the MAF tile.

DeeEmm, 2025-01-13:
Fixed in Build 2501110021 onwards

Closed 2025-01-13.

Thread 296 (2024-12-13):

[FEATURE REQUEST]MAF Flow KGH needs a Standardised tile SKGH @ ISO5011.

KirikauKiwi, 2024-12-13:
Since working through the [Calculated Orifice Flows @ ISO 5011 Std. Conditions](https://github.com/DeeEmm/DIY-Flow-Bench/discussions/147#discussioncomment-11523594) and having just seen #294 it became apparent that DIYFB should also have a Standardise Mass Flow too.

The number of tile views have been increasing and may become a bit unwieldy, would it be worth considering for version 3, along with unit selection that it maybe possible to reduce the apparent number of tile views by first selecting your desired views from the configuration page and/or via a metric/imperial/SI units selector.

DeeEmm, 2024-12-13:
The number of tiles is always the same (6), but the choice may be overwhelming to some.

I think that some people will get confused about the differences between SCFM / ACFM and corrected flows.

Perhaps a different 'mode' might be more appropriate where those additional options are hidden by default or a checkbox list of what ones you want to be able to access via the GUI.

Ultimately I would love a drag-and-drop style interface for the GUI where you can simply rearrange it to suit whatever your needs are. I have taken a brief look into this. it's not massively difficult, but also not trivial.

TBH as the GUI file is not tied to the main code, anyone could create whatever GUI they wanted for this. Maybe one day we'll get a GUI / Webdev on board who can take my basic HTML / javascript GUI and make something a lot more slick leveraging the existing datastreams and API. This is in part why it was written this way.

DeeEmm, 2025-01-23:
OK just had a chance to take a look at this.

The MAF sensor reports mass per time period not volume, so is uninfluenced by temperature, pressure and humidity.

If the temperature, pressure or humidity changes, causing the density of the charge to differ i.e. the number of molecules per given volume, the MAF will report the correct mass flow, as it measures the mass of the molecules that actually pass the sensor within a specified time period.

If more molecules pass the sensor, as is the case with denser air, more will be measured and the measured mass will be higher. et vice versa. So we could consider that mass flow is temperature and humidity agnostic.

However... Temperature and humidity WILL influence an objects flow characteristics in terms of volume, which may cloud the users perception of what the mass flow reading means. For example, lets say that we are measuring a super dense charge: Using a MASS measurement will make it appear that the object flows a lot more than the same object with a much less dense charge, as the molar mass will be higher.

So in this respect one needs to be careful if wanting to use mass flow measurements for determining the _volumetric_ flow characteristics of an object, as they do not really compare very well. The two metrics are not exchangeable. Using mass flow does not overcome the temperature, barometric and humidity shortcomings of volumetric flow. For a mass measurement to make any sense the temperature, barometric pressure and humidity needs to be quoted, which means that If the user is interested in volumetric flow, they should be measuring in CFM which is a much more appropriate metric.

With the most recent version (Build 2501230049 onwards) the bench can be calibrated for mass flow i.e you can store the mass flow value as the calibration offset. This means that anyone who is specifically interested in reading mass flow can both calibrate and read the bench accurately using mass flow readings.

I'm not sure of a use case for mass flow, as in 99% of cases related to ICE we are interested in the volume of air that an object can flow, not the mass. However mass flow could be useful for things like mapping other MAF sensors, or conducting tests related to molecular density.

I will update the documentation relating to using the bench for mass flow.

Regarding the feature request, we could add an inset value into each tile to report the equivalent mass flow, rather than an additional set of mass related tiles.

Thread 303 (2024-12-26):

Add wifi recovery method to API

DeeEmm, 2024-12-26:
Old wifi password stored in configuration prevents logging in to wifi. Which in turn prevents user from changing / updating password.

Add API method to reset Wifi password to default value to allow recovery in case of Wifi Password issue.

NOTE - only accessible via serial API NOT network.

DeeEmm, 2024-12-26:
Implemented in build 2412260018

Closed 2024-12-26.

Thread 307 (2025-01-05):

MAF flow value calc incorrect

DeeEmm, 2025-01-05:
Just noticed that the flow value seems to be out of whack. I'm getting a value between 624 - 790 Kg/h on my test setup, nothing lower.

_Originally posted by @DeeEmm in https://github.com/DeeEmm/DIY-Flow-Bench/issues/293#issuecomment-2571551392_
    
Most likely an issue relating to change from lookup tables to transfer function.

Tests on transfer function returned data in line with the lookup table values, so I suspect that either the transfer function has been implemented incorrectly, or the transfer function data was incorrect.

DeeEmm, 2025-01-05:
A bit of an explanation on how the transfer function works and is created.

All MAF data is now calculated on the fly from a transfer function which takes the voltage reference as an input. The transfer functions can be found in mafData.h along with other data previously found in the MAF.json files.

The transfer functions are calculated using a python file that can be found in the tools folder. There are also a number of other files that I have created that carry out functions related to converting the MAF files.  In all cases the raw data must be in JSON format. For example...

```
{
    "key" : value,
    "23" : 1443,
    "24": 1476,
    "25": 1523,
    "26": 1573,
    "etc" : etc
}
```

## mafScaleJsonValues.py

This program will take the key values in mafData.json and rescale them. All values are recalculated accordingly and a new file created.

Example: you have a file that has key values from 0-1024 and need to convert them to run from 0-500mv.

The program will rescale the key values and interpolate the data values to align with the new key values.

## mafConvertKGHtoMGS.py

The new default value for all MAF transfer functions is KG/h. This program will convert a mafData.json file in mg/s and create a new file in kg/h.

The program converts all data values from mg/sec to kg/hour

## mafTransferFunctionGenerator.py

This script reads the MAF sensor data from mafData.json file and fits a polynomial, exponential, and power law function to the data. The best fit is then plotted along with the raw data. Coefficients of the best fit function are printed to the console. (generally 6th order polynomial)

This data can then be added to mafData.h

In addition to the above. I've also added a mimic page to monitor sensor values in realtime, which should assist with this issue.

DeeEmm, 2025-01-06:
OK. so my starting point is to replicate the data generated by mafTransferFunctionGenerator.py using excel.

The mafTransferFunctionGenerator.py file was AI generated and not my work. So as we are getting an error from the data generated by it, validating the data is the first logical step.

As a comparison here are the results generated for the BOSCH 0280218067 MAF by the mafTransferFunctionGenerator file

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

And here is the implementation of that data in the getMafFlow method in sensors.cpp

```
	// 6th degree polynomial calculation (Coefficients stored in mafData class)
    for(int i = 0; i < 6; i++) {
        flowRateKGH += _maf.getCoefficient(i) * vPower;
        vPower *= mafVolts;
    }
```

There's also an alternate long hand method that I wrote which achieves the same...

```
flowRateKGH = mafCoeff0 + (mafCoeff1 * mafVolts) + (mafCoeff2 * pow(mafVolts, 2)) + (mafCoeff3 * pow(mafVolts, 3)) + (mafCoeff4 * pow(mafVolts, 4)) + (mafCoeff5 * pow(mafVolts, 5));
```

The polynomials generated by mafTransferFunctionGenerator.py are stored in mafdata.h within a class called mafData as an array of arrays...

```
    float mafCoeff[NUM_MAF_TYPES][NUM_COEFFICIENTS] = {
        {624.306263f, 25.418081f, 0.365468f, 0.002299f, 0.000003f, -0.000000f, 0.000000f}, // ACDELCO_92281162
        {817.925606f, -15.237634f, 0.091194f, -0.000073f, -0.000000f, 0.000000f, -0.000000f} // BOSCH_0280218067
    };
```

The key here is knowing that the transfer function is generated from 5th order polynomials. We can then replicate this using the LINEST function in excel.

Hopefully this will help to validate the data and give me a better understanding of what's going on.

I suspect that the implementation is the issue, however the AI generated version and my version of the calculation both give the same results. This logically leads to the way that the polynomials are being stored / handled. Hopefully dissecting everything will shed some light on what is going on.

DeeEmm, 2025-01-07:
Initial tests show deviation between mafTransferFunctionGenerator generated polynomials and Excel generated polynomials.

The excel generated code appears to give more realistic values that are in line with expectations, but is still not 100% at the value goes out of range at the top end of the scale. (more below)

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

Here's the Excel file I created...

[MAF polynomial calcs V1.xlsx](https://github.com/user-attachments/files/18327017/MAF.polynomial.calcs.V1.xlsx)

I also note that there appears to be an error with the ADC decode. Viewing the mimic data, the MAF voltage tops out at 6.14v, which is the max value for the ADC scale. We are obviously only reaching 5v, so should stop somewhat lower than that. I suspect that this may also be the reason for the flow values going out of range.

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

Looking through this issue also forced me to go back to look at the source of the raw MAF data. I think that we definitely need to validate the provenance of the data before we include it in the code. Some of the MAF data sets that were included in the previous version of the software are definitely of questionable quality. 🫤

DeeEmm, 2025-01-07:
Ahh yes. If you want to understand / learn more about using the LINEST function in excel to generate the polynomials, this is a pretty good video explanation. There are a few caveats to using it, such as creating arrays

https://www.youtube.com/watch?v=r7iXa6r5H7k

KirikauKiwi, 2025-01-07:
Happy NY, great work getting everything moved over to NVM, I have updated to the latest version of your DEV branch.

I tried to keep an eye on the work/updates over the holiday period, sorry if I am asking questions again that have been covered already.

Questions?
- The configuration page is it still a WIP i.e still needs to be updated. Currently I have a basic page view, no nice formatting etc.
- How do you access the Mimic Data you have shown above.

I am seeing similar odd data with the ADC with 0-6.144 V being shown in the API when the voltage is 0-5V this is with using a trim pot.
With a pressure sensor connected and sitting at atmospheric pressure approx 2.5V the API reports about 0.76V
With a trimpot attached to the MAF input the API shows 6.144V when the voltage is about 1.95V

DeeEmm, 2025-01-07:
A fresh pair of eyes on this issue would be handy.

I suspect that the AI generated code to create the polynomials has some errors. The Excel generated code seems to be more accurate and the polynomials can be validated directly against those generated by the trend line (the formula displayed on the Excel graph).

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

The R2 value is essential how good a fit the polynomials are to the data. The closer to 1, the better. You can see that the generated values match those for the trend line (the trend line values are rounded). From the experimentation that I have undertaken, generally the 5th and 6th order polynomials are essentially zero. (E+14, E+18)

To that end, I have tried using 4th degree polynomial calculation and whilst the fit is pretty good, it does tend to veer off at the extremities of the data. So it is clear that the zero values of the 5th / 6th order values do influence the curve.

Not sure about the calculation accuracy / mathematical comparison between Python and Excel. TBH, I have not really looked through the AI code yet. If Excel works as a tool, then thats fine. The important thing is accuracy.

The ACDELCO_92281162 data also may not be accurate. I have found some discrepancies with the data set. Some versions state mg/sec others kg/hour, so need to try and validate the reference data we have. Pretty sure that the BOSCH_0280218067 data is okay however.

KirikauKiwi, 2025-01-07:
Started with a clean sheet and now have the current DEV branch working correctly, i.e. I can now see the new/updated GUI etc.

- If I update the WIFI credentials to my local WIFi network it is failing to connect to it, is this currently a known problem???
- When adjusting the trimpot that I have connected to the PRef input it is adjusting the values for the two other pressure sensor inputs.

DeeEmm, 2025-01-07:
Both of those are likely bugs / issues.

I'm still working my way through testing all of the settings, there are still many untested.

DeeEmm, 2025-01-07:
A quick look and I cannot see any obvious issues, however I note that if I save a value it is not displayed when I revisit the page.

Doing a quick test I can see that each value is getting stored in its respective NVM variable, but there is nmo way to interrogate the NVM other than using the getVariable method.

```
!:Debug Mode On
!:Verbose Print Mode On
Saving Configuration...
Writing Configuration: Key: bSD_ENABLED  Value: 0
Writing Configuration: Key: iMIN_PRESS_PCT  Value: 80
Writing Configuration: Key: dPIPE_RAD_FT  Value: 0.328084
Writing Configuration: Key: bFIXED_3_3V  Value: 1
Writing Configuration: Key: dVCC_3V3_TRIM  Value: 0.0
Writing Configuration: Key: bFIXED_5V  Value: 1
Writing Configuration: Key: dVCC_5V_TRIM  Value: 0.0
Writing Configuration: Key: iBME_TYP  Value: 7
Writing Configuration: Key: iBME_ADDR  Value: 118
Writing Configuration: Key: iBME_SCAN_MS  Value: 1000
Writing Configuration: Key: iADC_TYPE  Value: 11
Writing Configuration: Key: iADC_I2C_ADDR  Value: 72
Writing Configuration: Key: iADC_SCAN_DLY  Value: 250
Writing Configuration: Key: iADC_MAX_RETRY  Value: 10
Writing Configuration: Key: iADC_RANGE  Value: 32767
Writing Configuration: Key: dADC_GAIN  Value: 6.144
Writing Configuration: Key: iMAF_SENS_TYP  Value: 0
Writing Configuration: Key: dMAF_MV_TRIM  Value: 1.0
Writing Configuration: Key: iMAF_SRC_TYP  Value: 18
Writing Configuration: Key: iMAF_ADC_CHAN  Value: 0
Writing Configuration: Key: iPREF_SENS_TYP  Value: 4
Writing Configuration: Key: dPREF_MV_TRIM  Value: 2.0
Writing Configuration: Key: iPREF_SRC_TYP  Value: 18
Writing Configuration: Key: iPREF_ADC_CHAN  Value: 1
Writing Configuration: Key: iFIXED_PREF_VAL  Value: 1
Writing Configuration: Key: dPREF_ALG_SCALE  Value: 1.0
Writing Configuration: Key: iPDIFF_SENS_TYP  Value: 4
Writing Configuration: Key: dPDIFF_MV_TRIM  Value: 3.0
Writing Configuration: Key: iPDIFF_SRC_TYP  Value: 18
Writing Configuration: Key: iPDIFF_ADC_CHAN  Value: 1
Writing Configuration: Key: iFIXD_PDIFF_VAL  Value: 1
Writing Configuration: Key: dPDIFF_SCALE  Value: 1.0
Writing Configuration: Key: iPITOT_SENS_TYP  Value: 4
Writing Configuration: Key: dPITOT_MV_TRIM  Value: 4.0
Writing Configuration: Key: iPITOT_SRC_TYP  Value: 12
Writing Configuration: Key: iPITOT_ADC_CHAN  Value: 1
Writing Configuration: Key: dPITOT_SCALE  Value: 1.0
Writing Configuration: Key: iBARO_SENS_TYP  Value: 7
Writing Configuration: Key: dBARO_MV_TRIM  Value: 5.0
Writing Configuration: Key: dBARO_FINE_TUNE  Value: 0.0
Writing Configuration: Key: dFIXD_BARO_VAL  Value: 101.3529
Writing Configuration: Key: dBARO_ALG_SCALE  Value: 1.0
Writing Configuration: Key: dBARO_SCALE  Value: 1.0
Writing Configuration: Key: dBARO_OFFSET  Value: 0.0
Writing Configuration: Key: iTEMP_SENS_TYP  Value: 7
Writing Configuration: Key: dTEMP_MV_TRIM  Value: 6.0
Writing Configuration: Key: dTEMP_FINE_TUNE  Value: 0.0
Writing Configuration: Key: dFIXED_TEMP_VAL  Value: 21.0
Writing Configuration: Key: dTEMP_ALG_SCALE  Value: 1.0
Writing Configuration: Key: iRELH_SENS_TYP  Value: 7
Writing Configuration: Key: dRELH_MV_TRIM  Value: 7.0
Writing Configuration: Key: dRELH_FINE_TUNE  Value: 0.0
Writing Configuration: Key: dFIXED_RELH_VAL  Value: 36.0
Writing Configuration: Key: dRELH_ALG_SCALE  Value: 1.0
Writing Configuration: Key: bSWIRL_ENBLD  Value: 0
Loading Configuration
Config NVM Free Entries: 249
```

You can view this output if you enable debug mode and verbose mode

As you can see, I saved values 1 through 7 in each of the mv trim inputs. They all appear to be in the correct place.

I suspect that there may be an issue with the read / load.

KirikauKiwi, 2025-01-07:
> When adjusting the trimpot that I have connected to the PRef input it is adjusting the values for the two other pressure sensor inputs.

 Clarifing what I mean above!!!!
 When I adjust the 10K potentiometer to vary the input voltage the PRef Voltage it is also adjusting the ADC values for PDiff and Pitot sensors

DeeEmm, 2025-01-07:
Ahhh. okay.

What values are the ADC channels set to?

DeeEmm, 2025-01-07:
Looks like defaults are all set to '1'.

I've updated them but you will need to manually save the appropriate values in the GUI

KirikauKiwi, 2025-01-07:
Adjusting the potentiometer this is what I see in the API and it is mirrored in the GUI also.

https://github.com/user-attachments/assets/397fbee5-6d35-44b9-805f-b3e3e59d1110

A quick look in the code it looks like the ADC channel are set correctly out of the places I have looked so far.

I did find this in the datahandler.cpp
```
if (!_prefs.isKey("iMAF_SRC_TYPE")) _prefs.putInt("iMAF_SRC_TYPE", ADS1115);
  if (!_prefs.isKey("iMAF_SENS_TYPE")) _prefs.putString("iMAF_SENS_TYPE", 0);
  if (!_prefs.isKey("dMAF_MV_TRIM")) _prefs.putDouble("dMAF_MV_TRIM", 0.0);
  if (!_prefs.isKey("iMAF_ADC_CHAN")) _prefs.putInt("iMAF_ADC_CHAN", 0);

  if (!_prefs.isKey("iPREF_SENS_TYP")) _prefs.putInt("iPREF_SENS_TYP", MPXV7007);
  if (!_prefs.isKey("iPREF_SRC_TYP")) _prefs.putInt("iPREF_SRC_TYP", ADS1115);
  if (!_prefs.isKey("iFIXED_PREF_VAL")) _prefs.putInt("iFIXED_PREF_VAL", 1);
  if (!_prefs.isKey("dPREF_MV_TRIM")) _prefs.putDouble("dPREF_MV_TRIM", 0.0);
  if (!_prefs.isKey("dPREF_ALG_SCALE")) _prefs.putDouble("dPREF_ALG_SCALE", 0.0);
  if (!_prefs.isKey("iPREF_ADC_CHAN")) _prefs.putInt("iPREF_ADC_CHAN", 1);

  if (!_prefs.isKey("iPDIFF_SENS_TYP")) _prefs.putInt("iPDIFF_SENS_TYP", MPXV7007);
  if (!_prefs.isKey("iPDIFF_SRC_TYP")) _prefs.putInt("iPDIFF_SRC_TYP", ADS1115);
  if (!_prefs.isKey("iFIXD_PDIFF_VAL")) _prefs.putInt("iFIXD_PDIFF_VAL", 1);
  if (!_prefs.isKey("dPDIFF_MV_TRIM")) _prefs.putDouble("dPDIFF_MV_TRIM", 0.0);
  if (!_prefs.isKey("dPDIFF_SCALE")) _prefs.putDouble("dPDIFF_SCALE", 0.0);
  if (!_prefs.isKey("iPDIFF_ADC_CHAN")) _prefs.putInt("iPDIFF_ADC_CHAN", 1);

  if (!_prefs.isKey("iPITOT_SENS_TYP")) _prefs.putInt("iPITOT_SENS_TYP", MPXV7007);
  if (!_prefs.isKey("iPITOT_SRC_TYP")) _prefs.putInt("iPITOT_SRC_TYP", ADS1115);
  if (!_prefs.isKey("dPITOT_MV_TRIM")) _prefs.putDouble("dPITOT_MV_TRIM", 0.0);
  if (!_prefs.isKey("dPITOT_SCALE")) _prefs.putDouble("dPITOT_SCALE", 0.0);
  if (!_prefs.isKey("iPITOT_ADC_CHAN")) _prefs.putInt("iPITOT_ADC_CHAN", 1);
```
changing the ADC channel to the correct values didn't correct the issue I am seeing currently.

DeeEmm, 2025-01-07:
ADC channels are set on the GUI config page.

The default values were all set to '1'

If you change the values on the config page it should resolve the issue

DeeEmm, 2025-01-07:
values are in order - MAF = 0, pRef = 1, pDiff = 2 and Pitot = 3

KirikauKiwi, 2025-01-07:
> Looks like defaults are all set to '1'.
>
> I've updated them but you will need to manually save the appropriate values in the GUI

I have manually changed them in the GUI, now there appears to be no data being displayed in the GUI, the API now shows the correct inputs regarding the potentiometers for PRef and PDiff, however Pitot is now fixed on 6.144V.

DeeEmm, 2025-01-07:
What sensor type are you using for the pitot?

DeeEmm, 2025-01-07:
NM. Checked though sensor types.

I cannot recreate here.  6.144V is FSD for the ADC. Not sure why you should see this unless the ADC input is maxed out.

DeeEmm, 2025-01-07:
What ADC value do you see for the pitot?

KirikauKiwi, 2025-01-07:
I have 10K Potentiometers on MAF, PRef, and PDiff and the MPXV7007 connected for the Pitot.

The voltage output for the Pitot sensor is sitting about 2.7V when measured, the ADC value is maxed out at 32767 via the API.
I think the Pitot problem is to do with the ADC scaling as it is sitting above the 1.9V measured previously which for me currently then gives a FS reading on the ADC.

KirikauKiwi, 2025-01-07:
Testing with the oscilloscope and the API, I am getting a FS reading for the ADC with an input voltage at about 1.95-2 volts

DeeEmm, 2025-01-07:
Weird that you are seeing FSD at 2.7V.

There is definitely an issue with the ADC scaling. I suspect that what you are seeing is related to what I an seeing with the MAF and pRef inputs. I don't have anything connected to the pDiff / Pitot inputs but I can see the same thing if I assign them to channel 1 or 2.

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

I am unsure if this issue is recent or has always been present but it obviously needs a bit of a looking at 🫤

KirikauKiwi, 2025-01-07:
It wasn't present pre the 205-post-complile update which caused the memory issues.

I recall that the memory issues did cause a problem with the ADC scaling and that we changed the get volts I think form a two look up values to the fixed formula of 6.144/32767. but that was a different problem to this one.

DeeEmm, 2025-01-07:
Yes that change was to bring the gain and range values into the method rather than calling them as it was failing sue to the memory issue.

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

I will try and revert those changes

DeeEmm, 2025-01-07:
No difference.

KirikauKiwi, 2025-01-07:
It must be the RAW ADC values that are incorrect as the get volts is only a scaling factor to this.

5V should only give a raw ADC value of approx 26600 where as we are getting the FS of 32767

DeeEmm, 2025-01-07:
Certainly seems that way. Although I cannot figure out what might be causing this.

As an observation. Dialling in the displayed value does equate to an ADC value of approx 26600, which would seem to point to the conversion being correct.

KirikauKiwi, 2025-01-07:
I have had a check of the ADS1115 data sheet and it appears the default gain is two (2) so I suspect that the gain is not being set correctly to 2/3

DeeEmm, 2025-01-07:
Yes this is it.

If I mod the library so that the default is ADS1115_REG_CONFIG_PGA_6_144V it works okay.

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

Now to work out why this is happening.

The correct value is being set in hardware->begin. This hasn't changed from the previous version.

```
if (config.iADC_TYPE != SENSOR_DISABLED) {

    _message.serialPrintf("Initialising ADS1115 ( Address: %u ) \n", config.iADC_I2C_ADDR);

    adc.setGain(ADS1115_REG_CONFIG_PGA_6_144V); // Set ADC Gain +/-6.144V range = Gain 2/3
    adc.setSampleRate(ADS1115_REG_CONFIG_DR_8SPS); // Set ADC Sample Rate - 8 SPS

    if (!adc.testConnection()) {
      _message.serialPrintf("ADS1115 Connection failed");
      while(1); // Freeze
    } else {
      _message.serialPrintf("ADS1115 Initialised\n");
    }
  }
```

I will try changing the read frequency back to ADS1115_REG_CONFIG_DR_128SPS

DeeEmm, 2025-01-07:
OK. Found the issue - the class instantiation...

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

This works. (before the top version was commented out)

Cannot recall why / when this was changed.

DeeEmm, 2025-01-07:
Updated DEV branch. There's a few other changes in there too such as additional voltage values on mimic page for VCC 5v + 3.3v

Now just need to figure out what the issue with the MAF is. 😃

Thanks for your help. 👍

KirikauKiwi, 2025-01-07:
I have noticed with the most recent DEV that you just updated to that there appears to be some latency appearing in the GUI & API updating the values.

PRef, PDiff and Pitot are all working correctly, MAF Flow KGH/CFM on the GUI is not updating, the ADC values and voltages in the API appear OK, the API Flow value in KG/H and CFM are not updating when varying the input voltage

KirikauKiwi, 2025-01-07:
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

I had a bit of a dig around and it seems that there is an issue with the ESP32's ADC 1 & 2 when the WiFi AP is being used, I   cannot see how this should have affected the setup of the external ADC being used though?????? as this problem relates to the ESP32 and its internal ADC???

Or is there some crossed wires (code based) that may have caused the ADS1115 not to have its gain set correctly.
From the hardware.cpp line102
```
 adc = ADS1115_lite(config.iADC_I2C_ADDR);
```

From the hardware.cpp line 44
```
ADS1115_lite adc;
```

This code is before the hardware begin and appears to intertwine with the external ADC setup/use, which doesn't seem like it should.
```
// Kludge to fix ADC2 + WiFi - Source: https://forum.arduino.cc/t/interesting-esp32-issue-cant-use-analogread-in-esp_wifimanager-library/679348/2
#include "soc/sens_reg.h"    // needed for manipulating ADC2 control register
uint64_t reg_b;              // Used to store ADC2 control register
int sensorValue = 0;         // variable to store the value coming from the sensor

ADS1115_lite adc;

/***********************************************************
 * @brief CONSTRUCTOR
 ***/
Hardware::Hardware() {
}

/***********************************************************
 * @brief save_ADC_Reg - Kludge to fix ADC2 + WiFi
 * @details  Save ADC2 control register value : Do this before begin Wifi/Bluetooth
 * @note Source: https://forum.arduino.cc/t/interesting-esp32-issue-cant-use-analogread-in-esp_wifimanager-library/679348/2
 ***/
void Hardware::save_ADC_Reg(void)
{
  reg_b = READ_PERI_REG(SENS_SAR_READ_CTRL2_REG);
}

/***********************************************************
 * @brief restore_ADC_Reg - Kludge to fix ADC2 + WiFi
 * @details  Restore ADC2 control register value : Do this after Wifi/Bluetooth
 * @note Source: https://forum.arduino.cc/t/interesting-esp32-issue-cant-use-analogread-in-esp_wifimanager-library/679348/2
 ***/
void Hardware::restore_ADC_Reg(void)
{
  WRITE_PERI_REG(SENS_SAR_READ_CTRL2_REG, reg_b);
  SET_PERI_REG_MASK(SENS_SAR_READ_CTRL2_REG, SENS_SAR2_DATA_INV);
}

/***********************************************************
 * @brief readAnalog - Kludge to fix ADC2 + WiFi
 * @details Read Analog pin value
 * @note Source: https://forum.arduino.cc/t/interesting-esp32-issue-cant-use-analogread-in-esp_wifimanager-library/679348/2
 ***/
long Hardware::readAnalog(int sensorPin)
{
  restore_ADC_Reg();
  sensorValue = analogRead(sensorPin);
  // Serial.print("Pin " + String(sensorPin) + " = ");
  // Serial.println(sensorValue);

  return sensorValue;

}
```

I cannot make sense of the external ADC being the ADS1115 and running over I2C how it would need to be involved in the code for the internal ADC2 and WiFi problem/work around???

DeeEmm, 2025-01-08:
The 'kludge' is to do with the ESP32 internal ADC's and is not related to the ADS1115.

On the Wemos board, you cannot use ADC Pin 2 if the WiFi is active as it will throw an error. If you try to assign pin 2 to analog read, it throws up an error. I am not 100% of the reason for this, it is something related to how the code is written that menas that when WiFi is enabled the results from pin 2 are affected.

The kludge is supposed to be a workaround for that particular issue. Essentially it creates a new analogRead() method called readAnalog. This provides access to the registers allowing the regular analogRead to take place, eliminating the error. However it did not work as expected. Sometimes the error would still show when initialising the pins, making it unreliable.

I commented it out when we were fault finding for the ADS1115 ADC issue, just in case it was causing the issue.

A fix for that issue should be possible. Even if pin 2 is required for both aspects, it should be possible to multiplex the data. However I suspect that this requires coding at the ESP_IDF level rather than via the Arduino framework, and interrogating the registers directly. This is a down-the-road problem, at least until the other issues get resolved.

Biggest issue at present is getting the MAF transfer function sorted out.

The generated trendline and polynomials match the data with a good degree of accuracy, but the implementation still has problems. Fixing the voltage issue did not resolve the problem. The flow values still veer off at the top end of the scale. Need to try to understand why this is happening.

I did read that extrapolating data using a polynomial curve does tend to lead to incorrect data when you travel past the end of the dataset, However we are calculating within the confines of the dataset. But the generated value seems to diverge long before we reach 5 volts.

KirikauKiwi, 2025-01-08:
Thanks for clarifying the ADC/WiFI issue, I just wasn't sure as to the formatting with the code relating to the two sections that changed with the commenting out to get the ADS1115 gain to be set correctly.

Are you seeing the latency issue I mentioned [above](https://github.com/DeeEmm/DIY-Flow-Bench/issues/307#issuecomment-2575537937) along with the MAF data issue mentioned too.

This has appeared for me after a5cff98d, where the data was updating as expected, to now where there is some latency again.

KirikauKiwi, 2025-01-08:
My issue with the data not displaying for the MAF sensor was due to Source for the MAF sensor on the Hardware configuration page not being set when updating to the current DEV version.

Having cleared the flash on the ESP32 this morning and reloading the current DEV version, the latency is still present but not as slow as it appeared with the same version yesterday afternoon. Going to try a restart on my computer first.

DeeEmm, 2025-01-08:
> Are you seeing the latency issue I mentioned [above](https://github.com/DeeEmm/DIY-Flow-Bench/issues/307#issuecomment-2575537937) along with the MAF data issue mentioned too.

Can you clarify where you are seeing the latency. I assume you are referring to the main Dashboard page as prior to this merge commit the mimic page did not exist.

I don't see any latency issues, but then I didn't see them (much) previously. Not sure why they are not so prevalent for me. Perhaps a browser issue? The Server Side Events (SEE) are a two-fold process. The data is packaged up by the ESP32 and sent out to the browser via the websocket connection, but it is the browser that receives, unpacks and updates the data.

Both the mimic and dashboard pages use seperate SSE streams to prevent sending / processing unnecessary data. The currently active page is set by the **status.GUIpage** variable within the webserver.cpp request handlers. This is then used to determine which SSE event to process in the main loop.

I've taken a look through the merge above and nothing really jumps out as a potential cause. The changes relate only to the mimic page, there's nothing there that really impacts the main dashboard page. The mimic page and associated data processing is entirely seperate from the main GUI Dashboard data processing.

I think that adding some kind of latency / cycle timer might be of benefit. We can split this into ESP and browser processing times. It should help to understand where any latency issues lay.

KirikauKiwi, 2025-01-08:
I first witnessed the problem on the main dashboard display with at first intermittent data updates, almost every second with the occasional stumble.
It also appears in the API when you make a request there are long delays often before the data is displayed.
I
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

Thread 311 (2025-01-07):

Millivolt trim values not saving

DeeEmm, 2025-01-07:
Millivolt trim values for MAF, pRef, pDiff, Pitot, Baro, etc not saving /displaying correctly.

When changing value and returning to config page, mv trim values are always zero.

Values appear to be written to NVM as verbose printout shows correct value. There are no errors on save

```
!:Debug Mode On
!:Verbose Print Mode On
Saving Configuration...
Writing Configuration: Key: bSD_ENABLED  Value: 0
Writing Configuration: Key: iMIN_PRESS_PCT  Value: 80
Writing Configuration: Key: dPIPE_RAD_FT  Value: 0.328084
Writing Configuration: Key: bFIXED_3_3V  Value: 1
Writing Configuration: Key: dVCC_3V3_TRIM  Value: 0.0
Writing Configuration: Key: bFIXED_5V  Value: 1
Writing Configuration: Key: dVCC_5V_TRIM  Value: 0.0
Writing Configuration: Key: iBME_TYP  Value: 7
Writing Configuration: Key: iBME_ADDR  Value: 118
Writing Configuration: Key: iBME_SCAN_MS  Value: 1000
Writing Configuration: Key: iADC_TYPE  Value: 11
Writing Configuration: Key: iADC_I2C_ADDR  Value: 72
Writing Configuration: Key: iADC_SCAN_DLY  Value: 250
Writing Configuration: Key: iADC_MAX_RETRY  Value: 10
Writing Configuration: Key: iADC_RANGE  Value: 32767
Writing Configuration: Key: dADC_GAIN  Value: 6.144
Writing Configuration: Key: iMAF_SENS_TYP  Value: 0
Writing Configuration: Key: dMAF_MV_TRIM  Value: 1.0
Writing Configuration: Key: iMAF_SRC_TYP  Value: 18
Writing Configuration: Key: iMAF_ADC_CHAN  Value: 0
Writing Configuration: Key: iPREF_SENS_TYP  Value: 4
Writing Configuration: Key: dPREF_MV_TRIM  Value: 2.0
Writing Configuration: Key: iPREF_SRC_TYP  Value: 18
Writing Configuration: Key: iPREF_ADC_CHAN  Value: 1
Writing Configuration: Key: iFIXED_PREF_VAL  Value: 1
Writing Configuration: Key: dPREF_ALG_SCALE  Value: 1.0
Writing Configuration: Key: iPDIFF_SENS_TYP  Value: 4
Writing Configuration: Key: dPDIFF_MV_TRIM  Value: 3.0
Writing Configuration: Key: iPDIFF_SRC_TYP  Value: 18
Writing Configuration: Key: iPDIFF_ADC_CHAN  Value: 1
Writing Configuration: Key: iFIXD_PDIFF_VAL  Value: 1
Writing Configuration: Key: dPDIFF_SCALE  Value: 1.0
Writing Configuration: Key: iPITOT_SENS_TYP  Value: 4
Writing Configuration: Key: dPITOT_MV_TRIM  Value: 4.0
Writing Configuration: Key: iPITOT_SRC_TYP  Value: 12
Writing Configuration: Key: iPITOT_ADC_CHAN  Value: 1
Writing Configuration: Key: dPITOT_SCALE  Value: 1.0
Writing Configuration: Key: iBARO_SENS_TYP  Value: 7
Writing Configuration: Key: dBARO_MV_TRIM  Value: 5.0
Writing Configuration: Key: dBARO_FINE_TUNE  Value: 0.0
Writing Configuration: Key: dFIXD_BARO_VAL  Value: 101.3529
Writing Configuration: Key: dBARO_ALG_SCALE  Value: 1.0
Writing Configuration: Key: dBARO_SCALE  Value: 1.0
Writing Configuration: Key: dBARO_OFFSET  Value: 0.0
Writing Configuration: Key: iTEMP_SENS_TYP  Value: 7
Writing Configuration: Key: dTEMP_MV_TRIM  Value: 6.0
Writing Configuration: Key: dTEMP_FINE_TUNE  Value: 0.0
Writing Configuration: Key: dFIXED_TEMP_VAL  Value: 21.0
Writing Configuration: Key: dTEMP_ALG_SCALE  Value: 1.0
Writing Configuration: Key: iRELH_SENS_TYP  Value: 7
Writing Configuration: Key: dRELH_MV_TRIM  Value: 7.0
Writing Configuration: Key: dRELH_FINE_TUNE  Value: 0.0
Writing Configuration: Key: dFIXED_RELH_VAL  Value: 36.0
Writing Configuration: Key: dRELH_ALG_SCALE  Value: 1.0
Writing Configuration: Key: bSWIRL_ENBLD  Value: 0
Loading Configuration
Config NVM Free Entries: 249
```

Suspect that value may not be read from NVM or written to template correctly.

DeeEmm, 2025-01-09:
Fixed in 78dd803

Data was being saved and applied correctly but was not being displayed in config page input fields. Same issue also applied to all other input fields.

Also formatted input fields to correct number format / resolution.

Closed 2025-01-09.

Thread 312 (2025-01-08):

Add cycle time / latency info to browser

DeeEmm, 2025-01-08:
Measure ESP and browser cycle times and display in browser.

Add absolute display showing both times for each page.

Will need to add javascript code to pages that currently have none

Need to determine what triggers cycle start stop in browser as it is event based and not cyclic.

DeeEmm, 2025-01-09:
Added MCU data to mimic page including following timers:

ADC task frequency (time between task execution)
BME task frequency (time between task execution)

Also added heap / stack free memory as well as BME / ADC task high water mark data.

Closed 2025-01-09.

Thread 316 (2025-01-12):

GUI Sluggish when MAF enabled

DeeEmm, 2025-01-12:
I have tested to enable MAF and can confirm that the issue with
killing the BME280 and getting a sluggish UI is still valid.
Only whay to solve it is to clean flash and reflash again. (Using DEV
downloaded @ 21:10 UTC  Jan 11 2025).
Kind regards/Stefan

_Originally posted by @stefan63 in https://github.com/DeeEmm/DIY-Flow-Bench/issues/315#issuecomment-2585426280_

GUI data stops updating on the Dashboard GUI, or becomes visually blocky, stop/stating, sluggish etc like it did since the 205-post-compile-configuration changes.

I also wouldn't expect a single change in the GUI configuration to enable the ADC for the MAF sensor to visually freeze the BME data on the Dashboard GUI.

I would also expect this change to be reversible which for me it is not currently, the only way I can get the BME data updating again is to clear the flash on the ESP32 and upload the code again.

As mentioned earlier today when I reverse this change (disable the MAF ADC) it does appear to improve/restore the API sluggishness.

My current list of issues are then;
- When I change the MAF to enable the ADC, the BME data on the dashboard GUI stops updating.
- I cannot reverse this change via the configuration GUI, I have to clear the flash and upload the code again.
- When I enable the MAF ADC, the API becomes very slow to respond, often more than 30 seconds, this does appear to improves again if the MAF is disable via the configuration GUI.
- The GUI overall has issues loading, the pages are often incomplete or load blank (known issue)
- WiFi for Local network the configuration saves but the Wifi won't connect and rolls back to WiFi AP mode. (known issue)

We know the hardware works so it has to be software related!

_Originally posted by @KirikauKiwi in https://github.com/DeeEmm/DIY-Flow-Bench/issues/307#issuecomment-2582625098_

DeeEmm, 2025-01-12:
Here is my test with a WEMOS D1 R32 clone with DEV version e7b8ad52.

I can confirm the WiFi fix has worked for me, which is making testing much less of a PITA.

Nothing else appears different to me other than now occasionally on the sluggish API from the initial upload I am now seeing some data that is like the baud rate is not set correctly.

Wemos Clone tasks

https://github.com/user-attachments/assets/218fc3b7-aecd-4834-ab27-ec4f03630f4a

API snap shot
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

_Originally posted by @KirikauKiwi in https://github.com/DeeEmm/DIY-Flow-Bench/issues/307#issuecomment-2585347721_

DeeEmm, 2025-01-12:
And since running the code on the WEMOS clone I have had two crashes that are the same.

```
assert failed: heap_caps_free heap_caps.c:381 (heap != NULL && "free() target pointer is outside heap areas")

Backtrace: 0x40083bcd:0x3ffe8200 0x4008dd75:0x3ffe8220 0x40093585:0x3ffe8240 0x40084136:0x3ffe8370 0x400935b5:0x3ffe8390 0x400df025:0x3ffe83b0 0x401a1c33:0x3ffe83d0 0x400df0c5:0x3ffe83f0 0x400e0520:0x3ffe8410 0x400e07b5:0x3ffe8470 0x400e268e:0x3ffe8490 0x400f0375:0x3ffe84d0 0x400ede7d:0x3ffe8520 0x400edf8d:0x3ffe8570 0x400ee175:0x3ffe85c0 0x40186999:0x3ffe85e0 0x40186a15:0x3ffe8610 0x401870c6:0x3ffe8630
```

_Originally posted by @KirikauKiwi in https://github.com/DeeEmm/DIY-Flow-Bench/issues/307#issuecomment-2585348717_

DeeEmm, 2025-01-12:
Issue now confirmed by @stefan63 and additional test by @KirikauKiwi

My big issue is that I cannot replicate this issue locally, so i need to try and understand why that is, so that I can begin to fault find.

Breaking the contributing factors down to try and isolate the root cause we have the following:

- Enabling MAF sensor causes slow scan times
- Change made in ac591a2 seems to be the [origin of issue](https://github.com/DeeEmm/DIY-Flow-Bench/compare/148f4ab..ac591a2)
- After enabling the MAF, disabling the MAF does not recover the issue

Things that do not appear to be a factor:

- ESP32 Board type
- Declaration of ADS1115-lite library
- Semaphore in main loop (controls API calls)

Things that Help / Improve issue:

- My hardware setup??? (Actual factor unknown)

What else have we identified that either contributes to, or reduces the problem?
What else have we eliminated by way of testing?

------------------

I guess I would like to start by analysing differences in hardware. We are after all running the same code. If we can isolate what makes my system impervious to the issue, I can then set my system up to replicate the issue. We may also be able to identify hardware components that are suitable / not suitable and add them to the recommended components list.

I will sit down later and document my exact setup, we can then try and identify any differences between what I have, and what you guys are running. Here's a basic start...

--------------------

- Wemos D1 R32 clone MCU (I need to formally identify this one)
- PicoDev BME280 BOB
- Sparkfun pca9306 logic level shifter BOB
- Generic ADS1115 ADC BOB (I need to formally identify this one)
- Generic SD card BOB (I need to formally identify this one)

- Official DIYFB shield + components as per [Schematic](https://github.com/DeeEmm/DIY-Flow-Bench/blob/master/PCB/Schematic_DIY-FLOW-BENCH-V2-3.jpg) Component tolerances are general and not high spec.

At the moment I only have two pots hooked up for testing as follows:

A10K pot on MAF input
A10K pot on pRef input

pDiff and Pitot inputs are currently floating.

------------------------

This is my pins data. Note that the '4294967295' value is actually the integer representation of  '-1' (0xffffffff)

Saving Pins data to NVM...
Writing Pins data: Pin: VAC_SPEED  Value: 25
Writing Pins data: Pin: VAC_BLEED_VALVE  Value: 26
Writing Pins data: Pin: VAC_BANK_1  Value: 13
Writing Pins data: Pin: VAC_BANK_2  Value: 12
Writing Pins data: Pin: VAC_BANK_3  Value: 14
Writing Pins data: Pin: AVO_STEP  Value: 32
Writing Pins data: Pin: AVO_DIR  Value: 33
Writing Pins data: Pin: FLOW_VALVE_STEP  Value: 27
Writing Pins data: Pin: FLOW_VALVE_DIR  Value: 4
Writing Pins data: Pin: VCC_3V3  Value: 4294967295
Writing Pins data: Pin: VCC_5V  Value: 4294967295
Writing Pins data: Pin: SPEED_SENS  Value: 15
Writing Pins data: Pin: SWIRL_ENCODER_A  Value: 4294967295
Writing Pins data: Pin: SWIRL_ENCODER_B  Value: 4294967295
Writing Pins data: Pin: ORIFICE_BCD_1  Value: 34
Writing Pins data: Pin: ORIFICE_BCD_2  Value: 36
Writing Pins data: Pin: ORIFICE_BCD_3  Value: 39
Writing Pins data: Pin: MAF  Value: 4294967295
Writing Pins data: Pin: PREF  Value: 4294967295
Writing Pins data: Pin: PDIFF  Value: 4294967295
Writing Pins data: Pin: PITOT  Value: 4294967295
Writing Pins data: Pin: TEMPERATURE  Value: 4294967295
Writing Pins data: Pin: REF_BARO  Value: 4294967295
Writing Pins data: Pin: HUMIDITY  Value: 4294967295
Writing Pins data: Pin: SERIAL0_TX  Value: 1
Writing Pins data: Pin: SERIAL0_RX  Value: 3
Writing Pins data: Pin: SERIAL2_TX  Value: 16
Writing Pins data: Pin: SERIAL2_RX  Value: 17
Writing Pins data: Pin: SDA  Value: 21
Writing Pins data: Pin: SCL  Value: 22
Writing Pins data: Pin: SD_CS  Value: 5
Writing Pins data: Pin: SD_MOSI  Value: 23
Writing Pins data: Pin: SD_MISO  Value: 19
Writing Pins data: Pin: SD_SCK  Value: 18
Writing Pins data: Pin: SPARE_PIN_1  Value: 4294967295
Writing Pins data: Pin: SPARE_PIN_2  Value: 4294967295
Loading Pins Data

-----------------------------

Things that I can immediately think of testing that may be different on my setup

- Adding additional pots to pRef an Pitot inputs. - I would not expect this to make a difference but worth testing.
- Removing SD card BOB - SD code is commented out, but is in circuit and pins are assigned.

If anyone can see / think of any other differences between your setup and mine, post below and I will test to see if I can replicate the problem here.

DeeEmm, 2025-01-12:
Some additional info.

The ADS1115 is a generic ebay version - https://www.ebay.com.au/itm/303971402874 However, the version that I received is different from most photos (note the markings - 16 bit i2c adc +p g ahw-198)

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

Unsure if this is relevant. St the moment I do not have another version to try. Jaycar do not appear to stock them. Will try Aztronics + Altronics

-------------------------------------

I tested reassigning SD card pins to '-1' and disconnecting the SD card BOB from the main board, however the performance remains the same.

-------------------------

Tried disabling the MAF and rebooting - Performance remained the same

-------------------------

Tried clearing flash and re-uploading to default configuration (MAF disabled) - Performance was different, however it was the opposite to what was expected.

Normal Task frequencies

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

After clearing flash + vanilla upload

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

The ADS task time has increased five-fold.

To clarify this is the time it takes from the end of previous ADS task to the beginning of next ADS task and should be determined by the ADC / BME scan intervals

So the ADS task scan interval actually increased with the MAF disabled.

This could indicate that the BME task was greedier and therefore held the task preventing the ADS from running. This is the exact opposite to what you guys see, but may be indicative of the mechanism that causes both. (i.e. task 'greediness'). This gives me an idea to measure how many times each task executes.

Theoretically, each task should be able to run in accordance with the scan time proportions  i.e.

```
**_BME scan : ADS scan_**
```

which is currently **1 : 4** or **1 sec : 250 millisecs**. This is also approximately what I see in the Task frequencies on my setup.

I will try to devise some counters to count how many cycles each task runs for. We can then compare results

DeeEmm, 2025-01-12:
Added a simple scan counter to the mimic page. This takes a rolling average of the number of times each task is run in succession.

KirikauKiwi, 2025-01-12:
I have been able to sudo recreate the problem at a very elementary level with the test code I created to test the BME and ADS in isolation.

By sudo I mean that sorry to mention it @DeeEmm looking at the I2C bus. I can see similar behaviour on the I2C bus in the test code that I am seeing with there I2C bus in the DIYFB code just by varying the delay at the end of my code block.

What I have found in changing a delay in my test code that the I2C bus visibly changes and once I decrease the delay below a certain level the I can no longer see the I2C address for the BME appear in the I2c bus decode.

What I am seeing in my test code when I describe as a visible change is depicted in the two images at the bottom of this post.

When running the code with a 125ms delay the BME data block on the I2C bus takes about 1.8ms to complete.
If I change the delay down to IIRC 50ms or lower that the BME address starts to disappear from the I2C decode.

The test code I created with the help of ChatGPT as my coding skills a very poor used the same libraries as DIYFB, Tiny280 and ADS1115_lite and I have tried to set it up as close as possible to DIYFB by using semaphore handling and the sam board, env top etc.

This is the test code .cpp
```
#include <Wire.h>
#define TINY_BME280_I2C
#define BME280_I2C_ADDRESS 0x76
#include <TinyBME280.h>
#include <ADS1115_lite.h>
#include <freertos/FreeRTOS.h>
#include <freertos/semphr.h>

// Create instances for BME280 and ADS1115
tiny::BME280 _BME280Sensor; // Initialize without address
ADS1115_lite adc(0x48); // Pass the I2C address directly in the constructor

// Create a semaphore for I2C bus access
SemaphoreHandle_t i2cSemaphore;

void setup() {
    Serial.begin(115200);
    Wire.begin();
    _BME280Sensor.beginI2C((int)118);

    // Create the semaphore
    i2cSemaphore = xSemaphoreCreateMutex();
    if (i2cSemaphore == NULL) {
        Serial.println("Failed to create semaphore!");
        while (1);
    }

    // Initialize BME280 with address 0x76
    if (!_BME280Sensor.begin()) {
        Serial.println("Could not find a valid BME280 sensor, check wiring!");
        while (1);
    }

    // Set gain and sample rate for ADS1115
    adc.setGain(ADS1115_REG_CONFIG_PGA_6_144V);
    adc.setSampleRate(ADS1115_REG_CONFIG_DR_8SPS);

    Serial.println("Setup complete!");
}

void loop() {
    // Take measurements and print BME280 data
    if (xSemaphoreTake(i2cSemaphore, portMAX_DELAY)) {
        float temperature = _BME280Sensor.readFixedTempC() / 100.0F;
        float humidity = _BME280Sensor.readFixedHumidity() / 1000.0F;
        float pressure = _BME280Sensor.readFixedPressure() / 100.0F;

        Serial.print("Temperature: ");
        Serial.print(temperature);
        Serial.println(" C");

        Serial.print("Humidity: ");
        Serial.print(humidity);
        Serial.println(" %");

        Serial.print("Pressure: ");
        Serial.print(pressure);
        Serial.println(" hPa");

        // Release the semaphore after reading BME280
        xSemaphoreGive(i2cSemaphore);
    }

    // Read from ADS1115
    for (int i = 0; i < 4; i++) {
        if (xSemaphoreTake(i2cSemaphore, portMAX_DELAY)) {
            // Set the multiplexer for the appropriate channel
            switch (i) {
                case 0:
                    adc.setMux(ADS1115_REG_CONFIG_MUX_SINGLE_0);
                    break;
                case 1:
                    adc.setMux(ADS1115_REG_CONFIG_MUX_SINGLE_1);
                    break;
                case 2:
                    adc.setMux(ADS1115_REG_CONFIG_MUX_SINGLE_2);
                    break;
                case 3:
                    adc.setMux(ADS1115_REG_CONFIG_MUX_SINGLE_3);
                    break;
            }

            // Trigger the conversion
            adc.triggerConversion();

            // Wait for the conversion to complete (adjust the delay as necessary)
            delay(10); // You can fine-tune this delay based on your needs

            // Read the conversion result for the selected channel
            int16_t adcValue = adc.getConversion();
            float voltage = adcValue * (6.144 / 32767.0);

            Serial.print("Analog Input ");
            Serial.print(i);
            Serial.print(": ");
            Serial.print(voltage);
            Serial.print(" V");
            Serial.print(": ");
            Serial.print(adcValue);
            Serial.println(" R");

            // Release the semaphore after reading from ADS1115
            xSemaphoreGive(i2cSemaphore);
        }
    }

    Serial.println(); // Print a newline for better readability

    // Delay for the ADS1115 sample rate
    delay(125); // Wait for 125 ms to respect the 8 SPS rate
}
```

I2C decode with 125ms delay.
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

I2C decode with 125ms delay commented out.
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

What I speculate from these observations in this isolated test, is that something in the DIYFB code is affecting the implementation or the timings in relation to the I2C bus.

KirikauKiwi, 2025-01-12:
Small update, I am sometimes seeing the BME data when the delay is commented out. The I2C decode appears different to when the delay is implemented.

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

DeeEmm, 2025-01-12:
It's not quite the same. There are some errors in your code as well.

The for-loop essentially does nothing it basically incrementally sets each channel, So it will always only read channel 4

There should also be no delay in the ADC reads. It does not need to wait for the conversion to finish as the library implicitly does this within the getConversion method...

From library documentation...
```
      adc.triggerConversion(); //Start a conversion.  This immediately returns
      Raw = adc.getConversion(); //This polls the ADS1115 and wait for conversion to finish, THEN returns the value
```

The loop within the DIYFB code also does not delay. It is the frequency that each task is called that is controlled independently with the scan interval timers. This is not the same as just adding a delay in the loop.

The tasks operate independently of the loop. The tasks are not part of the loop.

The loop itself keeps running. The only delay in the loop is to prevent the watchdog from triggering (1ms) as otherwise it scans too fast and triggers the WDT

```
vTaskDelay( 1 );  //mSec delay to prevent Watch Dog Timer (WDT) triggering for empty task
```

One of the reasons I previously mentioned that watching the I2C bus to try and diagnose code errors is that you only see a very small snapshot of the data. The assumption that the BME data reads are not happening based on not seeing them in the snapshot is folly. To get an idea of the actual bus activity it really needs to be datalogged and analysed.

It really is much better to try and diagnose this issue from within the code itself.

DeeEmm, 2025-01-12:
My Bad the loop does cycle through all four channels

Remove the timer from the ADC reads as it is not needed and not present in the DIYFB code

```
#include <Wire.h>
#define TINY_BME280_I2C
#define BME280_I2C_ADDRESS 0x76
#include <TinyBME280.h>
#include <ADS1115_lite.h>
#include <freertos/FreeRTOS.h>
#include <freertos/semphr.h>

// Create instances for BME280 and ADS1115
tiny::BME280 _BME280Sensor; // Initialize without address
ADS1115_lite adc(0x48); // Pass the I2C address directly in the constructor

// Create a semaphore for I2C bus access
SemaphoreHandle_t i2cSemaphore;

void setup() {
    Serial.begin(115200);
    Wire.begin();
    _BME280Sensor.beginI2C((int)118);

    // Create the semaphore
    i2cSemaphore = xSemaphoreCreateMutex();
    if (i2cSemaphore == NULL) {
        Serial.println("Failed to create semaphore!");
        while (1);
    }

    // Initialize BME280 with address 0x76
    if (!_BME280Sensor.begin()) {
        Serial.println("Could not find a valid BME280 sensor, check wiring!");
        while (1);
    }

    // Set gain and sample rate for ADS1115
    adc.setGain(ADS1115_REG_CONFIG_PGA_6_144V);
    adc.setSampleRate(ADS1115_REG_CONFIG_DR_8SPS);

    Serial.println("Setup complete!");
}

void loop() {
    // Take measurements and print BME280 data
    if (xSemaphoreTake(i2cSemaphore, portMAX_DELAY)) {
        float temperature = _BME280Sensor.readFixedTempC() / 100.0F;
        float humidity = _BME280Sensor.readFixedHumidity() / 1000.0F;
        float pressure = _BME280Sensor.readFixedPressure() / 100.0F;

        Serial.print("Temperature: ");
        Serial.print(temperature);
        Serial.println(" C");

        Serial.print("Humidity: ");
        Serial.print(humidity);
        Serial.println(" %");

        Serial.print("Pressure: ");
        Serial.print(pressure);
        Serial.println(" hPa");

        // Release the semaphore after reading BME280
        xSemaphoreGive(i2cSemaphore);
    }

    // Read from ADS1115
    for (int i = 0; i < 4; i++) {
        if (xSemaphoreTake(i2cSemaphore, portMAX_DELAY)) {
            // Set the multiplexer for the appropriate channel
            switch (i) {
                case 0:
                    adc.setMux(ADS1115_REG_CONFIG_MUX_SINGLE_0);
                    break;
                case 1:
                    adc.setMux(ADS1115_REG_CONFIG_MUX_SINGLE_1);
                    break;
                case 2:
                    adc.setMux(ADS1115_REG_CONFIG_MUX_SINGLE_2);
                    break;
                case 3:
                    adc.setMux(ADS1115_REG_CONFIG_MUX_SINGLE_3);

            // Trigger the conversion
            adc.triggerConversion();

            // Read the conversion result for the selected channel
            int16_t adcValue = adc.getConversion();
            float voltage = adcValue * (6.144 / 32767.0);

            Serial.print("Analog Input ");
            Serial.print(i);
            Serial.print(": ");
            Serial.print(voltage);
            Serial.print(" V");
            Serial.print(": ");
            Serial.print(adcValue);
            Serial.println(" R");

            // Release the semaphore after reading from ADS1115
            xSemaphoreGive(i2cSemaphore);
        }
    }

    Serial.println(); // Print a newline for better readability

    // Delay for the ADS1115 sample rate
    delay(125); // Wait for 125 ms to respect the 8 SPS rate
}
```

KirikauKiwi, 2025-01-12:
I am only trying to help the best I can!!!

> The for-loop essentially does nothing it basically incrementally sets each channel, So it will always only read channel 4

It works, I see different voltages and they change independently of one another!!

Do with my observation as you wish, but to my eyes it appears that what ever is happening in the code is inadvertently affecting something that is related to the data going to and coming from the I2C bus.

My test is in isolation and yes will of course be different from what you have implemented in the DIYFB code, my isolation test does however show that by varying the delay is affecting the I2C bus and this is mirroring  what I have seen and been able to measure in when running the DIYFB code.

I don't disagree with you about the data logging of the bus would be a better solution, unfortunately I don't have a logic analysers to be able to do this!!!!

> It really is much better to try and diagnose this issue from within the code itself.

I agree with you on this as I also believe it to be a software issue, I have been reporting what I am seeing able to measure at a hardware level which is obviously affected by the software instructing it. I am sure you would also expect software changes to make changes to how the hardware operates as this is what it is design to do.

KirikauKiwi, 2025-01-12:
I would expect that the the enable of the MAF input is somehow affecting the timings too as you are going from reading three of the analogue inputs on the ADS1115 to four.
What I don't understand is why it is not reversible, as if the code that is being enabled, disabled with the change it should be reversible, but it is not, so this would indicate that the code is not working correctly.

Unfortunately for me trying to work through the DIYFB code is difficult due to only having a very elementary understanding of C++, I get and understand the logic behind it but have difficulty reading the code it self.

DeeEmm, 2025-01-12:
Normal code - Spend 3 hours developing / 30 minutes debugging
AI code - Spend 3 minutes developing / 3 days debugging

There are many issues with the code that has been generated for you.

This is a better approximation of DIYFB

```
#include <Wire.h>
#define TINY_BME280_I2C
#define BME280_I2C_ADDRESS 0x76
#include <TinyBME280.h>
#include <ADS1115_lite.h>
#include <freertos/FreeRTOS.h>
#include <freertos/semphr.h>

// Create instances for BME280 and ADS1115
tiny::BME280 _BME280Sensor; // Initialize without address
ADS1115_lite adc(0x48); // Pass the I2C address directly in the constructor

// Create a semaphore for I2C bus access
SemaphoreHandle_t i2cSemaphore;

adcPollTimer = 0;
bmePollTimer = 0;
BME_SCAN_DELAY = 1000;
ADC_SCAN_DELAY = 250;

void setup() {
    Serial.begin(115200);
    Wire.begin();
    _BME280Sensor.beginI2C((int)118);

    // Create the semaphore
    i2cSemaphore = xSemaphoreCreateMutex();
    if (i2cSemaphore == NULL) {
        Serial.println("Failed to create semaphore!");
        while (1);
    }

    // Initialize BME280 with address 0x76
    if (!_BME280Sensor.begin()) {
        Serial.println("Could not find a valid BME280 sensor, check wiring!");
        while (1);
    }

    // Set gain and sample rate for ADS1115
    adc.setGain(ADS1115_REG_CONFIG_PGA_6_144V);
    adc.setSampleRate(ADS1115_REG_CONFIG_DR_8SPS);

    Serial.println("Setup complete!");
}

void loop() {
    // Take measurements and print BME280 data
    if (millis() > bmePollTimer){

        if (xSemaphoreTake(i2cSemaphore, portMAX_DELAY)) {

            bmePollTimer = millis() + BME_SCAN_DELAY;

            float temperature = _BME280Sensor.readFixedTempC() / 100.0F;
            float humidity = _BME280Sensor.readFixedHumidity() / 1000.0F;
            float pressure = _BME280Sensor.readFixedPressure() / 100.0F;

            Serial.print("Temperature: ");
            Serial.print(temperature);
            Serial.println(" C");

            Serial.print("Humidity: ");
            Serial.print(humidity);
            Serial.println(" %");

            Serial.print("Pressure: ");
            Serial.print(pressure);
            Serial.println(" hPa");

            // Release the semaphore after reading BME280
            xSemaphoreGive(i2cSemaphore);
        }
    }

    // Read from ADS1115
    if (millis() > adcPollTimer){

        if (xSemaphoreTake(i2cSemaphore, portMAX_DELAY)) {

            adcPollTimer = millis() + config.ADC_SCAN_DELAY;

            for (int i = 0; i < 4; i++) {
                // Set the multiplexer for the appropriate channel
                switch (i) {
                    case 0:
                        adc.setMux(ADS1115_REG_CONFIG_MUX_SINGLE_0);
                        break;
                    case 1:
                        adc.setMux(ADS1115_REG_CONFIG_MUX_SINGLE_1);
                        break;
                    case 2:
                        adc.setMux(ADS1115_REG_CONFIG_MUX_SINGLE_2);
                        break;
                    case 3:
                        adc.setMux(ADS1115_REG_CONFIG_MUX_SINGLE_3);

                // Trigger the conversion
                adc.triggerConversion();

                // Read the conversion result for the selected channel
                int16_t adcValue = adc.getConversion();
                float voltage = adcValue * (6.144 / 32767.0);

                Serial.print("Analog Input ");
                Serial.print(i);
                Serial.print(": ");
                Serial.print(voltage);
                Serial.print(" V");
                Serial.print(": ");
                Serial.print(adcValue);
                Serial.println(" R\n");
          }
            // Release the semaphore after reading from ADS1115
            xSemaphoreGive(i2cSemaphore);
        }
    }

    Serial.println(); // Print a newline for better readability

    delay(1);
}
```

DeeEmm, 2025-01-12:
Note: untested

DeeEmm, 2025-01-12:
I've moved the sensor tasks to core 2. Most system tasks such as wifi etc are on core 1.

See if this makes a difference

KirikauKiwi, 2025-01-12:
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

Thread 320 (2025-01-17):

Capture modal dialog not displaying correctly

DeeEmm, 2025-01-17:
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

Modal dialog used for data capture on Dashboard page in GUI not displying correctly

DeeEmm, 2025-01-17:
Fixed in Build 2501170016

Also changed modal background opacity on hover to show flow tile value.

Closed 2025-01-17.

Thread 321 (2025-01-17):

Graph data not clearing

DeeEmm, 2025-01-17:
When pressing the 'clear' button on the datagraph page the graph data clears, but when the page is refreshed, the data comes back

DeeEmm, 2025-01-20:
Resolved in Build 2501200030

Closed 2025-01-20.

Thread 322 (2025-01-18):

System page does not load correctly

DeeEmm, 2025-01-18:
> System page still not load fully, this happends frequently, need to refresh multiple times to eventally get it fully populated and to show save button. Sometimes crash during refresh so a reboot is the only way to recover.
>
> I previously noted this behaviour with the Hardware Configuration page, but after removing all non-essential items from the page, have not seen this since. I believe that the issue relates to the size of data passed to the templating function in the EspAsyncWebServer library. It seems to fall over once the file size gets too big. We can potentially move the calibration data to a dedicated page. This will reduce the data size for the System Settings page. I will take a look at this.

stefan63, 2025-01-18:
> > System page still not load fully, this happends frequently, need to refresh multiple times to eventally get it fully populated and to show save button. Sometimes crash during refresh so a reboot is the only way to recover.
> > I previously noted this behaviour with the Hardware Configuration page, but after removing all non-essential items from the page, have not seen this since. I believe that the issue relates to the size of data passed to the templating function in the EspAsyncWebServer library. It seems to fall over once the file size gets too big. We can potentially move the calibration data to a dedicated page. This will reduce the data size for the System Settings page. I will take a look at this.

That sounds like a possible solution.

Also when you are at it, maybe a reduction of tabs on the main menu would make the UI less cluttered.
Pages like System, hardware, pins, mimic will rarely be used after a working bench has been built an configurated!?
Maybe a gear icon link in upper right corner that bring up a sub menu for settings?

KirikauKiwi, 2025-01-19:
I have managed to cause an issue a few times this evening when browsing the Dashboard GUI, it appears to happening when change from from one page to another, e.g. System to Dashboard.
```
assert failed: heap_caps_free heap_caps.c:381 (heap != NULL && "free() target pointer is outside heap areas")

Backtrace: 0x40083bcd:0x3ffe8200 0x4008dd75:0x3ffe8220 0x40093585:0x3ffe8240 0x40084136:0x3ffe8370 0x400935b5:0x3ffe8390 0x400def2d:0x3ffe83b0 0x401a31c7:0x3ffe83d0 0x400defcd:0x3ffe83f0 0x400e0428:0x3ffe8410 0x400e06f9:0x3ffe8470 0x400e28da:0x3ffe8490 0x400f07c1:0x3ffe84d0 0x400ee2c9:0x3ffe8520 0x400ee3d9:0x3ffe8570 0x400ee5c1:0x3ffe85c0 0x401870e9:0x3ffe85e0 0x40187165:0x3ffe8610 0x40187816:0x3ffe8630
  #0  0x40083bcd in panic_abort at /home/runner/work/esp32-arduino-lib-builder/esp32-arduino-lib-builder/esp-idf/components/esp_system/panic.c:408
  #1  0x4008dd75 in esp_system_abort at /home/runner/work/esp32-arduino-lib-builder/esp32-arduino-lib-builder/esp-idf/components/esp_system/esp_system.c:137
  #2  0x40093585 in __assert_func at /home/runner/work/esp32-arduino-lib-builder/esp32-arduino-lib-builder/esp-idf/components/newlib/assert.c:85
  #3  0x40084136 in heap_caps_free at /home/runner/work/esp32-arduino-lib-builder/esp32-arduino-lib-builder/esp-idf/components/heap/heap_caps.c:381
      (inlined by) heap_caps_free at /home/runner/work/esp32-arduino-lib-builder/esp32-arduino-lib-builder/esp-idf/components/heap/heap_caps.c:366
  #4  0x400935b5 in free at /home/runner/work/esp32-arduino-lib-builder/esp32-arduino-lib-builder/esp-idf/components/newlib/heap.c:39
  #5  0x400def2d in miniz_def_free_func at ESP32/DIY-Flow-Bench/miniz.c:175
  #6  0x401a31c7 in mz_deflateEnd at ESP32/DIY-Flow-Bench/miniz.c:306
  #7  0x400defcd in mz_inflateEnd at ??:?
  #8  0x400e0428 in PublicHTML::decompress(unsigned char const*, unsigned int) at ESP32/DIY-Flow-Bench/publichtml.cpp:53
  #9  0x400e06f9 in PublicHTML::dataJs() at ESP32/DIY-Flow-Bench/publichtml.cpp:204
  #10 0x400e28da in std::_Function_handler<void (AsyncWebServerRequest*), Webserver::begin()::{lambda(AsyncWebServerRequest*)#34}>::_M_invoke(std::_Any_data const&, AsyncWebServerRequest*&&) at ESP32/DIY-Flow-Bench/webserver.cpp:424
      (inlined by) _M_invoke at /Users/philipcottle/.platformio/packages/toolchain-xtensa-esp32/xtensa-esp32-elf/include/c++/8.4.0/bits/std_function.h:297
  #11 0x400f07c1 in std::function<void (AsyncWebServerRequest*)>::operator()(AsyncWebServerRequest*) const at /Users/philipcottle/.platformio/packages/toolchain-xtensa-esp32/xtensa-esp32-elf/include/c++/8.4.0/bits/std_function.h:687
      (inlined by) AsyncCallbackWebHandler::handleRequest(AsyncWebServerRequest*) at libdeps/esp32dev/ESPAsyncWebServer-esphome/src/WebHandlerImpl.h:132
  #12 0x400ee2c9 in AsyncWebServerRequest::_parseLine() at libdeps/esp32dev/ESPAsyncWebServer-esphome/src/WebRequest.cpp:581 (discriminator 1)
  #13 0x400ee3d9 in AsyncWebServerRequest::_onData(void*, unsigned int) at libdeps/esp32dev/ESPAsyncWebServer-esphome/src/WebRequest.cpp:123
  #14 0x400ee5c1 in std::_Function_handler<void (void*, AsyncClient*, void*, unsigned int), AsyncWebServerRequest::AsyncWebServerRequest(AsyncWebServer*, AsyncClient*)::{lambda(void*, AsyncClient*, void*, unsigned int)#8}>::_M_invoke(std::_Any_data const&, void*&&, AsyncClient*&&, std::_Any_data const&, unsigned int&&) at libdeps/esp32dev/ESPAsyncWebServer-esphome/src/WebRequest.cpp:76
      (inlined by) _M_invoke at /Users/philipcottle/.platformio/packages/toolchain-xtensa-esp32/xtensa-esp32-elf/include/c++/8.4.0/bits/std_function.h:297
  #15 0x401870e9 in std::function<void (void*, AsyncClient*, void*, unsigned int)>::operator()(void*, AsyncClient*, void*, unsigned int) const at /Users/philipcottle/.platformio/packages/toolchain-xtensa-esp32/xtensa-esp32-elf/include/c++/8.4.0/bits/std_function.h:687
      (inlined by) AsyncClient::_recv(tcp_pcb*, pbuf*, signed char) at libdeps/esp32dev/AsyncTCP-esphome/src/AsyncTCP.cpp:971
  #16 0x40187165 in AsyncClient::_s_recv(void*, tcp_pcb*, pbuf*, signed char) at libdeps/esp32dev/AsyncTCP-esphome/src/AsyncTCP.cpp:1291
  #17 0x40187816 in _async_service_task(void*) at libdeps/esp32dev/AsyncTCP-esphome/src/AsyncTCP.cpp:164
      (inlined by) _async_service_task at libdeps/esp32dev/AsyncTCP-esphome/src/AsyncTCP.cpp:199

ELF file SHA256: 477a86a1661eb54c

Rebooting...
ets Jul 29 2019 12:21:46

rst:0xc (SW_CPU_RESET),boot:0x13 (SPI_FAST_FLASH_BOOT)
configsip: 0, SPIWP:0xee
clk_drv:0x00,q_drv:0x00,d_drv:0x00,cs0_drv:0x00,hd_drv:0x00,wp_drv:0x00
mode:DIO, clock div:1
load:0x3fff0030,len:1344
load:0x40078000,len:13964
load:0x40080400,len:3600
entry 0x400805f0
Serial started
```

KirikauKiwi, 2025-01-19:
Another observation related to this. When I click the "Settings" button the page often only partially loads, it has always reloaded fully if I refresh the page.

What is the difference between clicking on the "Setting" and refreshing the page???

KirikauKiwi, 2025-01-19:
Settings page html. page not fully loaded

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

Setting page html. when browser refreshed and page load correctly.

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

When the pages loads correctly with the browser refresh this bit of html appears, there is are two additional lines of coed appear after the blu lines in the images above.

DeeEmm, 2025-01-20:
The truncated output is a similar issue to the AsyncWebServer problem. A different mechanism but essentially the output gets truncated. Each page is constructed from three separate files - the header, which includes the navbar and banner. The main content and the footer. The HTML is converted and stored as a bytestring in the htmldata.h file. The bytestring is uncompressed by the decompressMultipleToStream method in publichtml.cpp

The call to the javascript file is the last thing on the content page. So it appears that the content is getting truncated.

Both this and the AsyncWebServer problem are similar issues, and both may be related. The main difference between the two issues is that when the decompressMultipleToStream truncates the content the footer is included, whereas when AsyncWebServer truncates the data the footer is missing

I did try previously to increase memory to try and fix this issue when I had it ont eh configuration page, but memory did not appear to be the issue.

I will take another look at this and see if I can figure something out.

KirikauKiwi, 2025-01-20:
Testing DEV Build 2501200030 version https://github.com/KirikauKiwi/DIY-Flow-Bench/commit/4c92ad230ad896c79a4b2288014d55f3fab68850

I am now having a similar issue with the dashboard GUI behaving weirdly, whilst I didn't have this problem on the previous build.

Researching the assert failed error above https://github.com/DeeEmm/DIY-Flow-Bench/issues/322#issuecomment-2601024053 I suspect it is minor differences in how the miniz is compressing the page that maybe causing the issues with the GUI.

DeeEmm, 2025-01-20:
Sorry there might be some tests still active in that commit. I've moved my testing for this issue onto a dedicated branch now.

Just working through a bunch of different tests to see if I can isolate the issue.

DeeEmm, 2025-01-20:
Just updated the DEV branch. Should be good now.

DeeEmm, 2025-01-20:
> Another observation related to this. When I click the "Settings" button the page often only partially loads, it has always reloaded fully if I refresh the page.
>
> What is the difference between clicking on the "Setting" and refreshing the page???

There should be no difference. The same http request is sent

KirikauKiwi, 2025-01-20:
Dashboard GUI, complete page load.

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

Setting GUI, partial page load.

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

Setting GUI, full page load.

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

I note that in the index.html, there is HTML code in green, it appears after the id for the Dashboard GUI
```
    <div id="tabcontainer">
    <!-- Main Tab-->
    <div id="dashboard" class="tabcontent tabcontentMain">

```
It is in a different line location in the settings.html file it is before the id.it appears before the id for the Settings GUI
```
    <!-- settings tab -->
    <div id="settings">
      <div class="config-panel">
```

Could this possible cause the issue?

DeeEmm, 2025-01-20:
> I note that in the index.html, there is HTML code in green, it appears after the id for the Dashboard GUI

That's just a comment. Should have no effect.

HTML code is essentially treated like text, it is not executable, so has no real effect on the process. It is only 'executed' (if you can call it that) by the browser.

KirikauKiwi, 2025-01-20:
Search in the compressed index.html for <br><br>, I found two instances of this double <br>, I have changed this so each instance has now only a single <br> and the page loads more reliably, but still not 100% of the time.

I think the miniz puts the <br> in and sometimes adds extras.

DeeEmm, 2025-01-22:
> Researching the assert failed error above [#322 (comment)](https://github.com/DeeEmm/DIY-Flow-Bench/issues/322#issuecomment-2601024053) I suspect it is minor differences in how the miniz is compressing the page that maybe causing the issues with the GUI.

the code is not compressed using the miniz code in the main project. It is compressed using the htmlToBytes.py script in the tools folder. This uses the zlib library. Both miniz and zlib use the same format, so there should be no issues relating to the content itself.

I suspect that the issue is memory related, miniz requires that it knows the zie of the data ahead of time, which is proivided within htmldata.h along side the byte array...

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

One thing that I want to check is how miniz is handling the uncompressed file size. I.e. it knows the size of the compressed data thta is being sent to it, but how does it know how much space the uncompressed data takes up???

DeeEmm, 2025-01-22:
So there seems to be a ceiling for the HTML file size of approx 21k

The overall compiled page sizes are as follows:

```
index - 11437 bytes
datagraph - 10501 bytes
settings - 21878 bytes
config - 17788 bytes
pins - 134449 bytes
mimic - 7400 bytes
```

Note that the setting page is actually truncated, so this is hitting a restriction somewhere. The page size is indicative of the size of that limit. If we take into account the header file size (1371) the resultant size (size ceiling) is 20507.

The reason for this limit is not readily apparent in the code. It may possibly be a limitation of Miniz or of AsynchWebServer.

The easy fix is to reduce page sizes. The current commit removes the calibration stuff from the settings page, reducing it to 17450, which loads correctly.

The proper fix however is to determine the root cause of the issue.

Closed 2025-01-23.

Thread 324 (2025-01-21):

[BUG]MAF Type not changing when selecting each MAF sensor

KirikauKiwi, 2025-01-21:
Version: V2.0-RC8
Build: 2501200041
GUI: 2412140054

When switching MAF sensors via the Hardware GUI page and returning to the dashboard GUI the MAF Flow Kg/h value does not change.
I suspect the the MAF type is not changing with the selection and the default MAF sensor settings, data set etc are still being used.

The MAF sensor type changes and saves on the hardware page, when viewed via the info page it is displayed as it has been selected from the hardware page. They match each other.

The datas value do not change on the dashboard GUI or mimic pages when changing between the MAF types.

DeeEmm, 2025-01-23:
At the moment MAF data is only loaded at boot which just follows the original way that we processed the MAF data when it resided in a file.. So whilst we can select a different MAF sensor, the system requires a reboot to load the new data into memory

Reloading the MAF data on-the-fly would not be without some penalty, the nature of which would depend on how it was processed...

At the moment when we save settings / config data, it is written to the NVM in a loop, so we do not look at individual values from the submitted form. To update the MAF data on-the-fly we would therefore need to expand the way we process the form data which increases file size.

The other option is to test to see if the MAF data has changed and reload the data if it has, but this adds an additional overhead to each cycle, which has both a memory and time cost.

We can also just reload the data on each cycle without checking. This is obviously the worst of the three options penalty-wise.

At present I don't see an issue with having to reboot to load the MAF data. Needing to change on-the-fly is a fringe case.

Ive added a javascript alert if the value is changed alerting the user that a reboot is needed.

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

stefan63, 2025-01-23:
Good solution!

Den tors 23 jan. 2025 03:59Mick Percy ***@***.***> skrev:

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

Closed 2025-01-23.

Thread 325 (2025-01-22):

I2C Improvements

DeeEmm, 2025-01-22:
> My loop time was around 1000us and now with the timings on the I2C line working correctly, my loop scan time has increase to 51000us, I am guessing this is because it now has time to get the semaphore and run its tasks correctly.

Yes I see the 51000us timing with the above values but it was around 1000us with the previous values you gave.

I'm assuming that the 51000us timing is not optimal as the loop is being blocked.

If the ADC task execution time is 71ms and the BME task execution time is 3ms, then the SSE task in the loop should still have enough time to execute its 129ms task without being blocked.

> It is a tricky process of refinement with the timers and has taken a while to get where we are currently. Let me know if you find other delays that works and I am happy to test them and verify them on the scope too.

The frequency of the events should not be an issue, there is still some quirk that we are missing. I think that all we are doing with the poll timers is increasing the delay between tasks so that the task tries to grab the semaphore when it is not competing with another task. This brings us back to trying to manage shortcomings in the code using delays and timing, which is inherently unstable, specifically as my hardware is different from yours, which is different to the next persons, which will all have different inherent timings. We cannot expect the end user to have to fine tune poll timers to get a stable system.

I think that a better way to deal with this instability is to prioritise each task so that they do not compete. A bit like a 3 gate flip flop. This way when we release the semaphore, only the task which is supposed to receive it can take the semaphore.

So we run tasks in a sequence...

```
ADC > SSE > ADC > SSE > BME > SSE > ADC > SSE > ADC > SSE > BME > SSE
```

This way the ADC task runs twice as much as the BME task and the SSE updates every time there is an update to either task.

We can then control the over scan timing using only the SSE task.

When the ADC task runs it runs for a scan (or maybe for a set number of scans to overcome the potential for an initial ghost value) and then completes. This will happen after lets say 142ms, it then releases access back to the SSE task which still has a further 358ms to want until it runs.

SSE task then runs and then alternately releases access back to the ADC / BME tasks.

When the BME task runs it runs once for 129ms before releasing back to the SSE task, which waits a further 371ms

In each case there is no clash between tasks. The SSE task is the main task, its frequency determines the frequency of the other tasks. The only caveat is that the frequency cannot be less than the duration of the longest task (BME task).

If any task takes longer, the next task simply waits until it gets access, however long that is.

>
> I will have another attempt at refining them to see if I can find the magic number to reduce the Main loop scan time down to its previous 1000us.

I think that this will be an almost impossible task to make work for all scenarios / installations. Current DEV version has your previous values in it. I will revert back to the timing values in this PR as the 51000us scan time at least provides a metric by which we can measure any changes.

I will write some basic logic to implement the sequence above and we can then both test.

As an aside I did end up pulling the trigger on the Analog Discovery 3 DRO, so I am now able to take a deeper dive into the I2C timing. I'm interested to take a look to see if I can now see the same issues that you are seeing here on my setup.

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

I will open a seperate issue for I2C improvements / stability and we can chip away at this in parallel to the other issues. It is even possible that this may improve the issues relating to page loading, after all they are directly tied to the SSE task.

We can run with the last values from this PR in the main code at is is at least more stable for others who ay share the same issue you guys are having, but I think that there is still more work to do here

_Originally posted by @DeeEmm in https://github.com/DeeEmm/DIY-Flow-Bench/issues/323#issuecomment-2606118097_

DeeEmm, 2025-01-22:
I'm not going to assign this to a specific milestone / target. If the general consensus is that the poll timer values from PR #323 provide a stable GUI, then we will use these until improvements can be made.

Other development for RC9 / V2 / V3 still needs to move forwards

DeeEmm, 2025-01-22:
OK. Task sequencing added. I also commented out the semaphore transactions as we have essentially replicated this with the code changes.

The GUI seems to be a lot more stable, however that's just a visual impression, I'm not seeing as much variation / fluctuation in the ADC values.

You will note that here is some variation in the ADC task frequency reported on the mimic page. This is because every other cycle that the ADC task fires it also includes the BME task. This needs to be fixed to report correctly but for the purposes of this test are unimportant.

BME values and task timing is rock solid.

Let me know how this appears to you.

I *think* I may have also discovered the cause of the issue that you have been seeing but requires testing to see if I'm correct. We can look at that afterwards.

KirikauKiwi, 2025-01-22:
I will test these later tomorrow.

Check the pull request for the current DEV version and also for the ADS1X15 library, I think after another iteration I have the conversion delay minimised and thus new Poll timers were required.

The performance tile now appears like this.

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

DeeEmm, 2025-01-22:
> I will test these later tomorrow.

Only the most recent commit [5f9a9e1](https://github.com/DeeEmm/DIY-Flow-Bench/commit/5f9a9e1d4b4459a3d9c473d3700a13b014f13705) needs testing on this branch.

There are also changes on the branch for issue #322 that need testing as well.

KirikauKiwi, 2025-01-23:
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

 Tested 6cfe0d8
The only thing I really noticed was that the ADC data didn't change a smoothly on the Dashboard GUI, when varying the voltage of pRef, it had a small amount of lag compared to DEV.

> I think I may have also discovered the cause of the issue that you have been seeing but requires testing to see if I'm correct. We can look at that afterwards.

Curious to test this at some stage.

Will test #322 tomorrow.

DeeEmm, 2025-01-23:
> The only thing I really noticed was that the ADC data didn't change a smoothly on the Dashboard GUI, when varying the voltage of pRef, it had a small amount of lag compared to DEV.

As the SSE event is being run in sequence the GUI will refresh at the specified rate, rather than when it is able

DeeEmm, 2025-01-23:
I think that the update frequency is also currently less than before

DeeEmm, 2025-01-23:
Branch https://github.com/DeeEmm/DIY-Flow-Bench/tree/325-i2c-improvements-test2 has an alternative fix.

This does not sequence events and so is still vulnerable to timing issues as per previous versions. I am specifically interested if this change addresses the i2c line spamming that you previously reported.

Branch https://github.com/DeeEmm/DIY-Flow-Bench/tree/325-i2c-improvements contains sequenced code.

KirikauKiwi, 2025-01-23:
> There are also changes on the branch for issue https://github.com/DeeEmm/DIY-Flow-Bench/issues/322 that need testing as well.

Took me a while to realise it was in the DEV branch.

This has tested well, with moving some items from the systems page to the new calibration page, I haven't had the partial page load issue.
The only thing to note is sometimes when navigating back the the Dashboard GUI page the ADS1115 Data in the three top tile does not load, the tiles are either blank or 0.00, I can see the data correctly on the Mimic page.

KirikauKiwi, 2025-01-23:
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

Will take a look at these soon.

DeeEmm, 2025-01-23:
> Took me a while to realise it was in the DEV branch.

I validated the changes and merged into DEV. The old branch was deleted in the merge.

I've reverted the changes to the ADC library. Can you test with the current version.

KirikauKiwi, 2025-01-23:
Take a look at the I2C bus on e7b8ad5, can you let me know what you see with that version. the data from the ADS1115 is almost constant for me I made no changes in my hardware only swapped the code and I get this.

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

KirikauKiwi, 2025-01-23:
Here is the DEV version 666772f7, which is a step backwards for me. It appears OK is on the GUI at an initial look and the performance tile, however when looking at the I2C bus there there are repeated attempts to read the data for the ADS1115.

Packet 1 is the register being set, then there should be the delay period to allow the conversion to take place then Packet 2 should appear which is the write requesting the data followed by the read which is the data being sent.
There is no delay between them here and the Write/Read for the data is happening immediately after Packet 1.

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

KirikauKiwi, 2025-01-23:
This code in the ADS1115_lite library DOES NOT!!!! implement the timing delay the isBusy() relies on the Alert/Ready pin being connected to the ESP32
```
int16_t ADS1X15::_readADC(uint16_t readmode)
{
  //  note readmode includes the channel
  _requestADC(readmode);

  if (_mode == ADS1X15_MODE_SINGLE)
  {
    uint32_t start = millis();
    //  timeout == { 138, 74, 42, 26, 18, 14, 12, 11 }
    //  added 10 ms more than maximum conversion time from datasheet.
    //  to prevent premature timeout in RTOS context.
    //  See #82
    uint8_t timeOut = (128 >> (_datarate >> 5)) + 10;
    while (isBusy())
    {
      if ( (millis() - start) > timeOut)
      {
        _error = ADS1X15_ERROR_TIMEOUT;
        return ADS1X15_ERROR_TIMEOUT;
      }
      yield();   //  wait for conversion; yield for ESP.
    }
  }
  else
  {
    //  needed in continuous mode too, otherwise one get an old value.
    delay(_conversionDelay);
  }
  return getValue();
}
```

DeeEmm, 2025-01-23:
```
while (isBusy())
```

loops until isBusy is true

```
bool ADS1X15::isBusy()
{
  return isReady() == false;
}
```

Checks to see if conversion is ready

```
bool ADS1X15::isReady()
{
  uint16_t val = _readRegister(_address, ADS1X15_REG_CONFIG);
  return ((val & ADS1X15_OS_NOT_BUSY) > 0);
}
```

Reads the register and performs bitwise 'AND' to read single byte.

Checks if this has value '1'

The current library also does same thing. Albeit slightly differently.

KirikauKiwi, 2025-01-23:
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

Where does the 1 come from???? it is a digital high!!! have you got your ESP32 connect to the Alert/Ready pin on your ADS1115??? Maybe that is the difference between yours and @Stefan63 and my hardware.

Here is the isBusy
``
bool ADS1X15::isBusy()
{
  return isReady() == false;
}

bool ADS1X15::isReady()
{
  uint16_t val = _readRegister(_address, ADS1X15_REG_CONFIG);
  return ((val & ADS1X15_OS_NOT_BUSY) > 0);
``
it the does _readRegister
``
uint16_t ADS1X15::_readRegister(uint8_t address, uint8_t reg)
{
  _wire->beginTransmission(address);
  _wire->write(reg);
  int rv = _wire->endTransmission();
  if (rv == 0)
  {
    rv = _wire->requestFrom((int) address, (int) 2);
    if (rv == 2)
    {
      uint16_t value = _wire->read() << 8;
      value += _wire->read();
      return value;
    }
  }
  _error =  ADS1X15_ERROR_I2C;
  return 0x0000;
}
``

This cannot be working unless you are wired to the ADS's Alert/Ready pin from the ESP32.

Can you see the I2C Write/Reads for this????? as this code should be sending a request to the device so a Write requesting the status and the you should see a Read when the data is sent.

DeeEmm, 2025-01-23:
My board is wired as per the schematic. Which should be the same as yours if you followed the schematic correctly

I think that you may need to dissect the code to figure out how it works. Your assumptions are incorrect.

KirikauKiwi, 2025-01-23:
Try the same code with the while isBusy commented out and see what happens on the I2C bus.

int16_t ADS1X15::_readADC(uint16_t readmode)
{
  //  note readmode includes the channel
  _requestADC(readmode);

  if (_mode == ADS1X15_MODE_SINGLE)
  {
    uint32_t start = millis();
    //  timeout == { 138, 74, 42, 26, 18, 14, 12, 11 }
    //  added 10 ms more than maximum conversion time from datasheet.
    //  to prevent premature timeout in RTOS context.
    //  See #82
    uint8_t timeOut = (128 >> (_datarate >> 5)) + 10;
    //while (isBusy())
    {
      if ( (millis() - start) > timeOut)
      {
        _error = ADS1X15_ERROR_TIMEOUT;
        return ADS1X15_ERROR_TIMEOUT;
      }
      yield();   //  wait for conversion; yield for ESP.
    }
  }
  else
  {
    //  needed in continuous mode too, otherwise one get an old value.
    delay(_conversionDelay);
  }
  return getValue();
}

DeeEmm, 2025-01-23:
However. Instead of banging your head against the computer trying to convince me.

Can you validate the tests that I proposed. 👍

DeeEmm, 2025-01-23:
I am interested in https://github.com/DeeEmm/DIY-Flow-Bench/tree/325-i2c-improvements

With current library https://github.com/DeeEmm/ADS1115_lite

KirikauKiwi, 2025-01-23:
> I am interested in https://github.com/DeeEmm/DIY-Flow-Bench/tree/325-i2c-improvements

This I believe I have respond to already and with further testing the it is a bit clunky due to the sequencing of the data from my oberservations on the GUI, oit appeared to stop start with the data updates. This was then visible on the I2C bus too.

> With current library https://github.com/DeeEmm/ADS1115_lite

Will look at this later.

I am testing the code visually to start with as a ender user would!!! I am not looking at it macroscopically and delving in to the code of using the scope, once I have looked at the visually observable I then take a look at the scope.

From the scope traces I am would then be able to say what has most like changed in the code.

> However. Instead of banging your head against the computer trying to convince me.

I am not banging my head, I am reporting my observations and what I know of the situation and what has worked to resolve the issue I was having.

>I think I may have also discovered the cause of the issue that you have been seeing but requires testing to see if I'm correct. >We can look at that afterwards.

Or is it under wraps until I have done the other validation testing, to keep the testing blind and impartial.

It would also be help if you could answer the questions I put forward too.
I am still learning as far as C++ goes and from what I read of the code it won't work unless it is connected to the Alert/Ready pin, which I know from other comments you have made is not how the DIYFB build is setup, it is not how I have my hardware configured???

Or is this part of trying to establish why your hardware appeared to work and mine and @Stefan63 didn't.

Have you inspected your I2C bus on version e7b8ad5, I am curious to know what you see???

KirikauKiwi, 2025-01-23:
> I am interested in https://github.com/DeeEmm/DIY-Flow-Bench/tree/325-i2c-improvements
>
> With current library https://github.com/DeeEmm/ADS1115_lite

The GUI appears to have lag/latency, when you change a voltage across the top three tiles, the bottom three tiles look slow to update, it is inline with what the performance tile says of around 2 sec.

Checking the I2C bus I get the same with the ADS1115 having repeated Write requests and data Reads that repeat, I don't see the register being set very often at all.

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

KirikauKiwi, 2025-01-23:
> I am interested in https://github.com/DeeEmm/DIY-Flow-Bench/tree/325-i2c-improvements
>
> With current library https://github.com/DeeEmm/ADS1115_lite

Does this work for you?

What do you see on your I2C bus????

KirikauKiwi, 2025-01-23:
This is the current DEV version 666772f7, the one single change I have made here is to comment out the `while isBusy()`everything else is unchanged.

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

What is happening here is packet one is a register set, then immediately after it packet two is the write requesting the data, packet 3 is the read sending the data, packet 4 is a new register set 5 and 6 are the write/read of the data.
This then results in the top image where all input voltages are from input one.

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

KirikauKiwi, 2025-01-23:
This is the current DEV version https://github.com/DeeEmm/DIY-Flow-Bench/commit/666772f7c25bf8f1ce8ae1517b849eefffbe7fda, the one additional change to the above, is that I have changed the conversion delay, which is set as it was in the define as 8ms.

This is still reading input one.
`
    //uint8_t timeOut = (128 >> (_datarate >> 5)) + 10;
    uint8_t timeOut = (_conversionDelay);
    //while (isBusy())
`

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

KirikauKiwi, 2025-01-23:
This is the current DEV version https://github.com/DeeEmm/DIY-Flow-Bench/commit/666772f7c25bf8f1ce8ae1517b849eefffbe7fda, the one additional change to the above, is that I have changed the code below from > to <

```
 if ( (millis() - start) < timeOut)
```

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

DeeEmm, 2025-01-23:
> Or is it under wraps until I have done the other validation testing, to keep the testing blind and impartial.
>

No, this is the code in the 325-i2c-improvements-test2 that I asked you to test previously two days ago.

> It would also be help if you could answer the questions I put forward too. I am still learning as far as C++ goes and from what I read of the code it won't work unless it is connected to the Alert/Ready pin, which I know from other comments you have made is not how the DIYFB build is setup, it is not how I have my hardware configured???

I do answer all of your questions and spend a lot of time explaining things to you so that you understand how things work. Please understand that this makes everything that I do take 3x as long as it needs to. Whilst I am happy to do this, please consider that this is not a free online C++ / javascript / HTML course.

>
> Or is this part of trying to establish why your hardware appeared to work and mine and [@stefan63](https://github.com/stefan63) didn't.
>

The project is designed to be used with the official PCB. It should be possible to breadboard this or make your own PCB by following the schematics as both you and Stefan have done. Given that you both have an issue that does not appear on my system that does not appear to be software related, means that the only logical conclusion is that it is a hardware issue, or related to differences in hardware.

I am suspicious that you may have both replicated a common error, which may be as a result of poor or misunderstood documentation. Unfortunately the dataset is too small to be able to draw any kind of logical conclusion. I also do not have access to your systems so cannot draw any data from there to try and determine where such an error may be.

despite asking several times about the I2C pull-ups you always appear to skirt around the issue.

So this process falls back to one of a slow process of change / test iterations to try and find a solution that works for ALL systems. Currently your solution does not work for me. And given that it is delay based, is unacceptable for all of the reasons that I have already given.

> Have you inspected your I2C bus on version [e7b8ad5](https://github.com/DeeEmm/DIY-Flow-Bench/commit/e7b8ad522fe65e83b93a83d45a74bf26382b3d23), I am curious to know what you see???

I see the previous issue that I fixed relating to the loop delay outside of the loop. I also see the master re-sending data request because it fails to read. This is not as a result of other / incorrect / too much data on the bus as you have assumed, it appears to be an issue with the library. (which we no longer use)

We identified these issues a week or so ago and I put forwards tests to determine the best way to resolve them. However instead of undertaking the tests that I asked, you continued down the rabbit hole playing with delays. You could have spent that time decoding the trace so that we had an actual idea of what was going on, rather than manipulating the symptoms

Please consider that what I propose a change and ask for you to test it the change is considered and part of a larger strategy to fix the issue. It is just basic scientific process. One change at a time, test and validate. Rinse and repeat.

Please just forget delays. They are not a valid solution for anything. If you want to learn. Go and learn why they are not acceptable. I have already given you several explanations, but you elect to ignore them.

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

What code where? and why? Please reference your changes with some context.

My time is very sparse. I have many concurrent projects like this one, I'm also in the middle of a house build as well as running my own company. Every second that I don't have to spend deciphering things is a plus. If this change is important or addresses an issue or improves performance please explain how and why.

> > I am interested in https://github.com/DeeEmm/DIY-Flow-Bench/tree/325-i2c-improvements
>
> This I believe I have respond to already and with further testing the it is a bit clunky due to the sequencing of the data from my oberservations on the GUI, oit appeared to stop start with the data updates.

Please define 'clunky'. I am unsure what it means in this context. "clunky: _solid, heavy, and old-fashioned_" ?? It appears to have no relationship to what we are doing here.

What I see are updates on the bus in line with the sequencing and timing defined in the code. The timing does not vary, the data sequence does not vary. it is very stable and should address the I2C 'spamming' issue that you seem to still have

I see transaction times that are faster than those in the solution that you put forwards as the code does not wait for a fixed delay but returns after the update register has been updated.

> This was then visible on the I2C bus too.

What was?

What I need is an objective view of how your system performs and whether this is acceptable in the context of GUI experience. These need to be in context with the test.

Please don't post with no explanation. This applies to screenshots too. What exactly am I looking at?? Is this good or bad? Describe what it is that you are showing me. I don't have the time to try and decypher what it is that you are tying to tell me. I am very time poor.

DeeEmm, 2025-01-24:
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

DeeEmm, 2025-01-24:
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

Pretty straightforwards request. I made it specifically unambiguous and linked to the items that I wanted you to test

however you ignore this and modify the code...

> This is the current DEV version [666772f](https://github.com/DeeEmm/DIY-Flow-Bench/commit/666772f7c25bf8f1ce8ae1517b849eefffbe7fda), the one single change I have made here is to comment out the `while isBusy()`everything else is unchanged.

Then you modify it again...

> This is the current DEV version [666772f](https://github.com/DeeEmm/DIY-Flow-Bench/commit/666772f7c25bf8f1ce8ae1517b849eefffbe7fda), the one additional change to the above, is that I have changed the conversion delay, which is set as it was in the define as 8ms.

Then you modify it again...

> This is the current DEV version [666772f](https://github.com/DeeEmm/DIY-Flow-Bench/commit/666772f7c25bf8f1ce8ae1517b849eefffbe7fda), the one additional change to the above, is that I have changed the code below from > to <

I cannot make any progress on the issue that you claim is still present if you are not prepared to help me.

Currently I have proposed two solutions

- One in dev branch which retains xTasks
- One in the branch above (325-i2c-improvements) which changes code operation to sequential

I am not interested in your modifications.

I am only interested in the code above. as-is. With no changes.

Remember - basic scientific process - one change at a time. Test and validate. Rinse and repeat.

I have no idea what you are changing, or whether you are undertaking tests as requested. This has eroded my confidence in any response that you provide.

This is further compounded by what come across as emotional responses that appear to be driven by me not accepting your solution.

KirikauKiwi, 2025-01-24:
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
Which I tested and stated my observations  above.

> however you ignore this and modify the code...
I haven't ignored this at all see above I started to modify the code one change at a time to show you what was working and what was not working with the reversion you made.

> > This is the current DEV version [666772f](https://github.com/DeeEmm/DIY-Flow-Bench/commit/666772f7c25bf8f1ce8ae1517b849eefffbe7fda), the one single change I have made here is to comment out the `while isBusy()`everything else is unchanged.
>
> Then you modify it again...
Yes I did this, again to show that one change didn't solve the issue for me, and another change didn't solve the issue for me

> > This is the current DEV version [666772f](https://github.com/DeeEmm/DIY-Flow-Bench/commit/666772f7c25bf8f1ce8ae1517b849eefffbe7fda), the one additional change to the above, is that I have changed the conversion delay, which is set as it was in the define as 8ms.
>
> Then you modify it again...
Yes again I made a single change now three in total and I am still having the issue!!

> > This is the current DEV version [666772f](https://github.com/DeeEmm/DIY-Flow-Bench/commit/666772f7c25bf8f1ce8ae1517b849eefffbe7fda), the one additional change to the above, is that I have changed the code below from > to <

> I cannot make any progress on the issue that you claim is still present if you are not prepared to help me.
I have given you exactly what has resolved the issue for me!!!

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
I have tested them both and reported that I have the issue present in both of them!!!!!!

>
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

Thread 329 (2025-01-24):

Lift data unavailable for download

DeeEmm, 2025-01-24:
Now that lit data has moved from JSOn file into NVM it is not available to download.

We therefore need to create JSON file on-the-fly to be able to export the liftdata.json file from the GUI when reuested

DeeEmm, 2025-01-25:
Also check lift data updating

DeeEmm, 2025-01-26:
Issue resolved.

Downoad request handler changes from SPIFFS to serving JSON data directly.

Also updated ArduinoJson from V6 to V7 as this version is recommended by ESPAsyncWebServer Library

Closed 2025-01-26.

Thread 330 (2025-01-24):

Review NEW ESPAsyncWebServer Library

DeeEmm, 2025-01-24:
Just noticed that there is a NEW ESPAsyncWebServer library.

https://github.com/ESP32Async/ESPAsyncWebServer

It appears that someone has picked up maintaining the old library as the old library now links to the repo above.

It states that there are LOTS of bug fixes. 👍 😄

This library is in part responsible for some of the speed and page load issues that we have experienced. So I am keen to test.

Would be good to do this before RC9

DeeEmm, 2025-01-25:
Updated to the new ESPAsynCWebServer library. This also included an update to the Async_TCP library as well, as they are now packaged together.

This change also highlighted a couple of areas for improvement which have also been updated. Specifically how we process static files such as javascript and css files. Previously these were decompressed before being sent to the browser. The reason for this is that this is how we need to handle files that are sent to the templating engine. Unfortunately when files were moved from SPIFFS into PROGMEM and compressed, there was no differentiation made between files that require template vars to be processed (file decompressed) and those that don't.

So now we just send the static files directly to the browser without touching them at all, which is not just faster but also less memory intensive. To achieve this the compression format needed to be changed from zlib to gzip. This change alone should be a big win in terms of memory and page load speed.

The update is now in the DEV branch

stefan63, 2025-01-25:
Must try the new DEV tonight :0)

Closed 2025-01-25.

Thread 335 (2025-01-26):

Review and add MAF data

DeeEmm, 2025-01-26:
Current version only has limited support for different MAF sensor types.

Review previous MAF data and convert to new format

DeeEmm, 2025-02-04:
Added support for additional sensors. Current sensor list as follows:

```
        ACDELCO 92281162
        BOSCH 0280218067
        DELPHI AF10118
        BOSCH 0280002421
        BOSCH 0280218008
        BOSCH 0280217531
        BOSCH 0280218019
        BOSCH 0280217123
```

Will add additional sensors as requested

Closed 2025-02-04.

Thread 342 (2025-01-27):

Website updates

DeeEmm, 2025-01-27:
There are a bunch of planned updates for the website.

Some of these relate to RC9, but others are nice to have features

I will capture these here and revise as required

- [ ] Update DEMO
- [ ] Reference standard calculator
- [ ] Flow reference calculator
- [ ] MAF flow calculator (diameter change)
- [ ] MAF polynomial calculator

DeeEmm, 2025-01-27:
BigDyno database - https://www.bigdynodatabase.com/DynoCF.php

Would be good to replicate similar for flow bench

DeeEmm, 2025-02-11:
New demo now created an uploaded to - https://diyflowbench.com/demo/

This is inline with current version.

Some features will not work as there is no board connected.

Remainder of items are now under V3

Thread 345 (2025-01-30):

Review default pin handling

DeeEmm, 2025-01-30:
With reference to #336 - https://github.com/DeeEmm/DIY-Flow-Bench/discussions/336#discussioncomment-12000960

Need to review how we manage pin mapping

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

Thread 363 (2025-02-10):

[BUG]

ModchipMan, 2025-02-10:
**Software Version**
- RELEASE "V2.0-RC8"
- BUILD_NUMBER "2502060002"

NOTE: Both can be found in version.json or by pressing the 'Info' button on the configuration page in the GUI

**Describe the bug**
GUI wont load, I can connect to DIYFB, but diyfb.local will not load,

**Expected behavior**
To get to DIYFB GUI

**Steps to reproduce the bug**
Outline the steps to reproduce the behavior:
1. Load firmware with esp tool or firmware flasher
2. Connect to DIYFB
3. try and open diyfb.local web browser "microsoft edge" and see page not loading

**ESP32 (please include additional information as required):**
 - Hardware Type  Wemos D1 R32
 - ESP Firmware Version (not known)
 -
**Additional context**
Add any other context about the problem here.

DeeEmm, 2025-02-10:
Can you connect using the IP address shown in the serial monitor?

ModchipMan, 2025-02-11:
checked serial monitor, found it is rebooting after it cant find BME280, which i dont have installed..
I do have a BME680.
I do have a BME280 but its 3.3v and could be a BMP280 copy..
I will probably just wait until the code supports BME680..
Iam also waiting on the shift leveller that I ordered about a month ago, and then that completes my V2.0 shield.
ohh I do have pink board ESP32-S3 ready to go when the code gets there, as well as my Wemos

Thread 371 (2025-03-08):

[BUG]Sometimes, when cyclic average, filter selected flow numbers are not present.

black-top, 2025-03-08:
**Software Version**
- RELEASE V2.0-RC9_2502110001
- BUILD_NUMBER (Build 2502110001)

Been testing the RC9 for a while. This looks like the only issue so far. I got this problem the second time. When Data Filter is selected to Cyclic Average, sometimes when the unit is turned on I don't see any flow number, just a blank spot, and only MAF FLOW in Kg/h is shown. At the mimic page, I see Flow Values. The unit restart does not fix this issue; it only starts to work when Data Filter Type is set to none, and after some time selected back to cyclic average, the flow values are shown. I don't know what is causing it, and I can't replicate it. It looks like it happens randomly.

 - Hardware Type [ Wemos D1 R32]

DeeEmm, 2025-03-08:
Thanks for the report. Will take a look and see if I can figure out what might be causing it.

Thread 377 (2025-10-05):

[FEATURE]

ericmaas, 2025-10-05:
**Feature Idea**
The current DIY Flow Bench web UI is hard-coded with a single theme. There’s no way for users to switch between alternate themes (e.g., dark, light, high-contrast) or introduce custom UI styling without directly modifying the core index.html and style.css. This makes it difficult to extend the interface for specialized use cases like:

- High-contrast dashboards for shop/bench displays.
- Custom branded themes for different environments.
- UI modifications to support additional calculated parameters (e.g., air density, VE charts, torque/power markers) without disrupting the core project.

**Solution**

- Drop multiple themes into a /html/themes/<theme-name>/ folder on the ESP32 filesystem.
- Include a header comment in each style.css file (similar to WordPress) for theme metadata (Theme Name, Author, Version, Description).
- Select the active theme through a Theme selector in the System menu of the GUI.
- Dynamically load the selected theme by swapping the CSS file (e.g., /theme/style.css → /html/themes/<selected>/style.css) and persisting the choice to the config file.

**alternatives considered**

- Hard-coding a single theme per forked version is too much to track. Commenting/uncommenting lines in HTML before flashing — not user-friendly and requires firmware rebuilds.

**Additional context**
Adding theme support would make it possible to implement advanced UI features cleanly, such as:

- Light/Dark toggle with local persistence.
- Shop-display dashboards with large tiles and minimal controls.
- Engine analysis overlays (VE vs RPM micro-charts, peak torque/power markers) without disturbing core layouts.

A theme system also opens the door for easier community contributions (e.g., high-contrast, or new features in custom themes) without modifying firmware. This opens the door to more varied contributions.

DeeEmm, 2025-10-06:
BTW. To a degree you can easily test mods to the GUI Files using the developer feature in the Chrome browser. This allows you to us a locally hosted version of files in place of files called within the code. This can be faster than changing / compiling / uploading each time

ericmaas, 2025-10-06:
I was thinking about adding an Themes folder to the HTML folder. Then having a script scan for themes in the folder. Each theme can use the style.css (a la wordpress) to identify the themes. Then them files can be added in via IDE, like platformio. At the same time i defer to you on these things as I am (barely) a front end developer these days so I think in that mindset. However, this opens the door to a lot more featuring from the front end UI/UX world.

DeeEmm, 2025-10-06:
Originally, with the uploaded monolithic file, just swapping the file out was enough to change the interface, but now that this resides in PROGMEM it is not so straightforwards. But that is not to say that it cannot be done.

Ultimately community contributions were always a goal of the project, GUI design is not my forte, so what you see is very basic and utilitarian, and probably does not really harness the capabilities of modern browsers with HTML5 functionality. It could be so much better and do so much more.

The biggest hurdle is memory, so using things like libraries, as is common nowadays is mostly out of the question as they are essentially bloatware for the most part and 80% of a libraries functions will never be used, but take up precious memory. So things have to be coded the old-school way. Pure HTML, javascript and CSS.

It's been a while since I've done anything on the project as I've been waiting for more of the PCB's to start to be built up and come online. I've also been toed up with a myriad of other things, so I really need to give myself a bit of a refresher. But if it's something that you want to take a look at we can try to figure out what that looks like and the best way to tackle it.

I would love nothing more than a bunch of different UI's with various functionality. The part where we get data from sensors is done, of course it still needs validation, but fundamentally it works and is usable. If we can start to leverage that data via GUI mods to display it in various ways, then it adds value to the project.

With regards to a themes folder, we may still be able to utilise a seperate CSS / HTML file. We would just need to be able to load it into PROGMEM. This could be an adaptation of the existing OTA update function. But as I mentioned, I need to take a look and have a bit of a refresher. Of course this does not stop you from hacking / updating / developing the raw HTML, CCS and JS files, it's only related to how we get / use them on the ESP32

DeeEmm, 2025-10-07:
The issue with using an ESP32 that shows as flash storage (USB drag and drop) is that AFAIK you need to use the ESP-IDF development framework which is a PITA. Currently all development is done under VSCode. I think that moving to ESP-IDF is a further barrier to anyone wanting to build this, with many people still favouring using the Arduino IDE. It also requires a very specific ESP32, which then means that the flexibility in available project hardware is vastly reduced. I would prefer to keep the project largely ESP agnostic.

We also already have the built in ability for OTA updates, so any perceived benefit of using drag and drop file uploading is minimal at best. In fact I would go as far as to say that exposing SPIFFS (or whatever file system) to the end user opens up the risk of people editing / overwriting / deleting files that can potentially break the system.

Currently we initiate the OTA update from the GUI and load the file via the browsers native file upload dialog. The risk is minimal and it is a process familiar to pretty much anyone who uses a browser. Plus I don't want to have to deal with a bunch of additional support requests because people have bricked their system by editing / overwriting / deleting the wrong file. So I would say that there is no actual benefit to that change, and quite possibly the opposite.

**Themes**

One thing to consider is that we cannot load a theme file on-the-fly from SPIFFS. The issue is working memory, not flash memory. The S2/S3 do not have any advantage in that regard, they essentially all have the same SRAM (which includes heap in the form of DRAM that resides within the SRAM). As soon as you try to manipulate the theme files in memory you end up with two copies and that is where the issue is. We were getting an overflow which caused all of the previous memory issues. There simply was not enough space in SRAM.

The way things currently work is that the browser files are combined, minimised and compressed _before_ being stored on the ESP32. The ESP32 does not have the processing power (actually memory) to modify those files on-board and on-the-fly, so currently any theme change needs to be done off-board before being uploaded. This conversion is all handled within VSCode before the browser files are uploaded by the python scripts in the tools folder.

The browser files are currently served directly from PROGMEM in the form of byte data. The template variables are replaced using templating function of ESPAsyncWebServer, so we never have to replicate the browser files in memory as template variables are replaced within the byte stream as it is served by the ESPwebserver library.

So to be able to implement some form of theme switching, we would need to either maintain a separate compiled binary for each theme that can be uploaded via the existing OTA update or somehow be able to upload only the (combined + minimised + compressed) browser files into PROGMEM.

At present we combine the compiled code along with the PROGMEM image and bootloader into the single binary that is provided as the release. To be able to upload just the browser files, we would need a package up a seperate binary that only overwrites the PROGMEM. This would require writing a new Python file and a GULP method to trigger it.

You can look at the current Python file that handles the creation of the release in tools > user_actions_post.py This should give you a starting point.
