DeeEmm/DIY-Flow-Bench/PCB/Schematic_DIY-FLOW-BENCH-V2-3.pdf

### CPU - Wemos D1 R32

### POWER MANAGEMENT

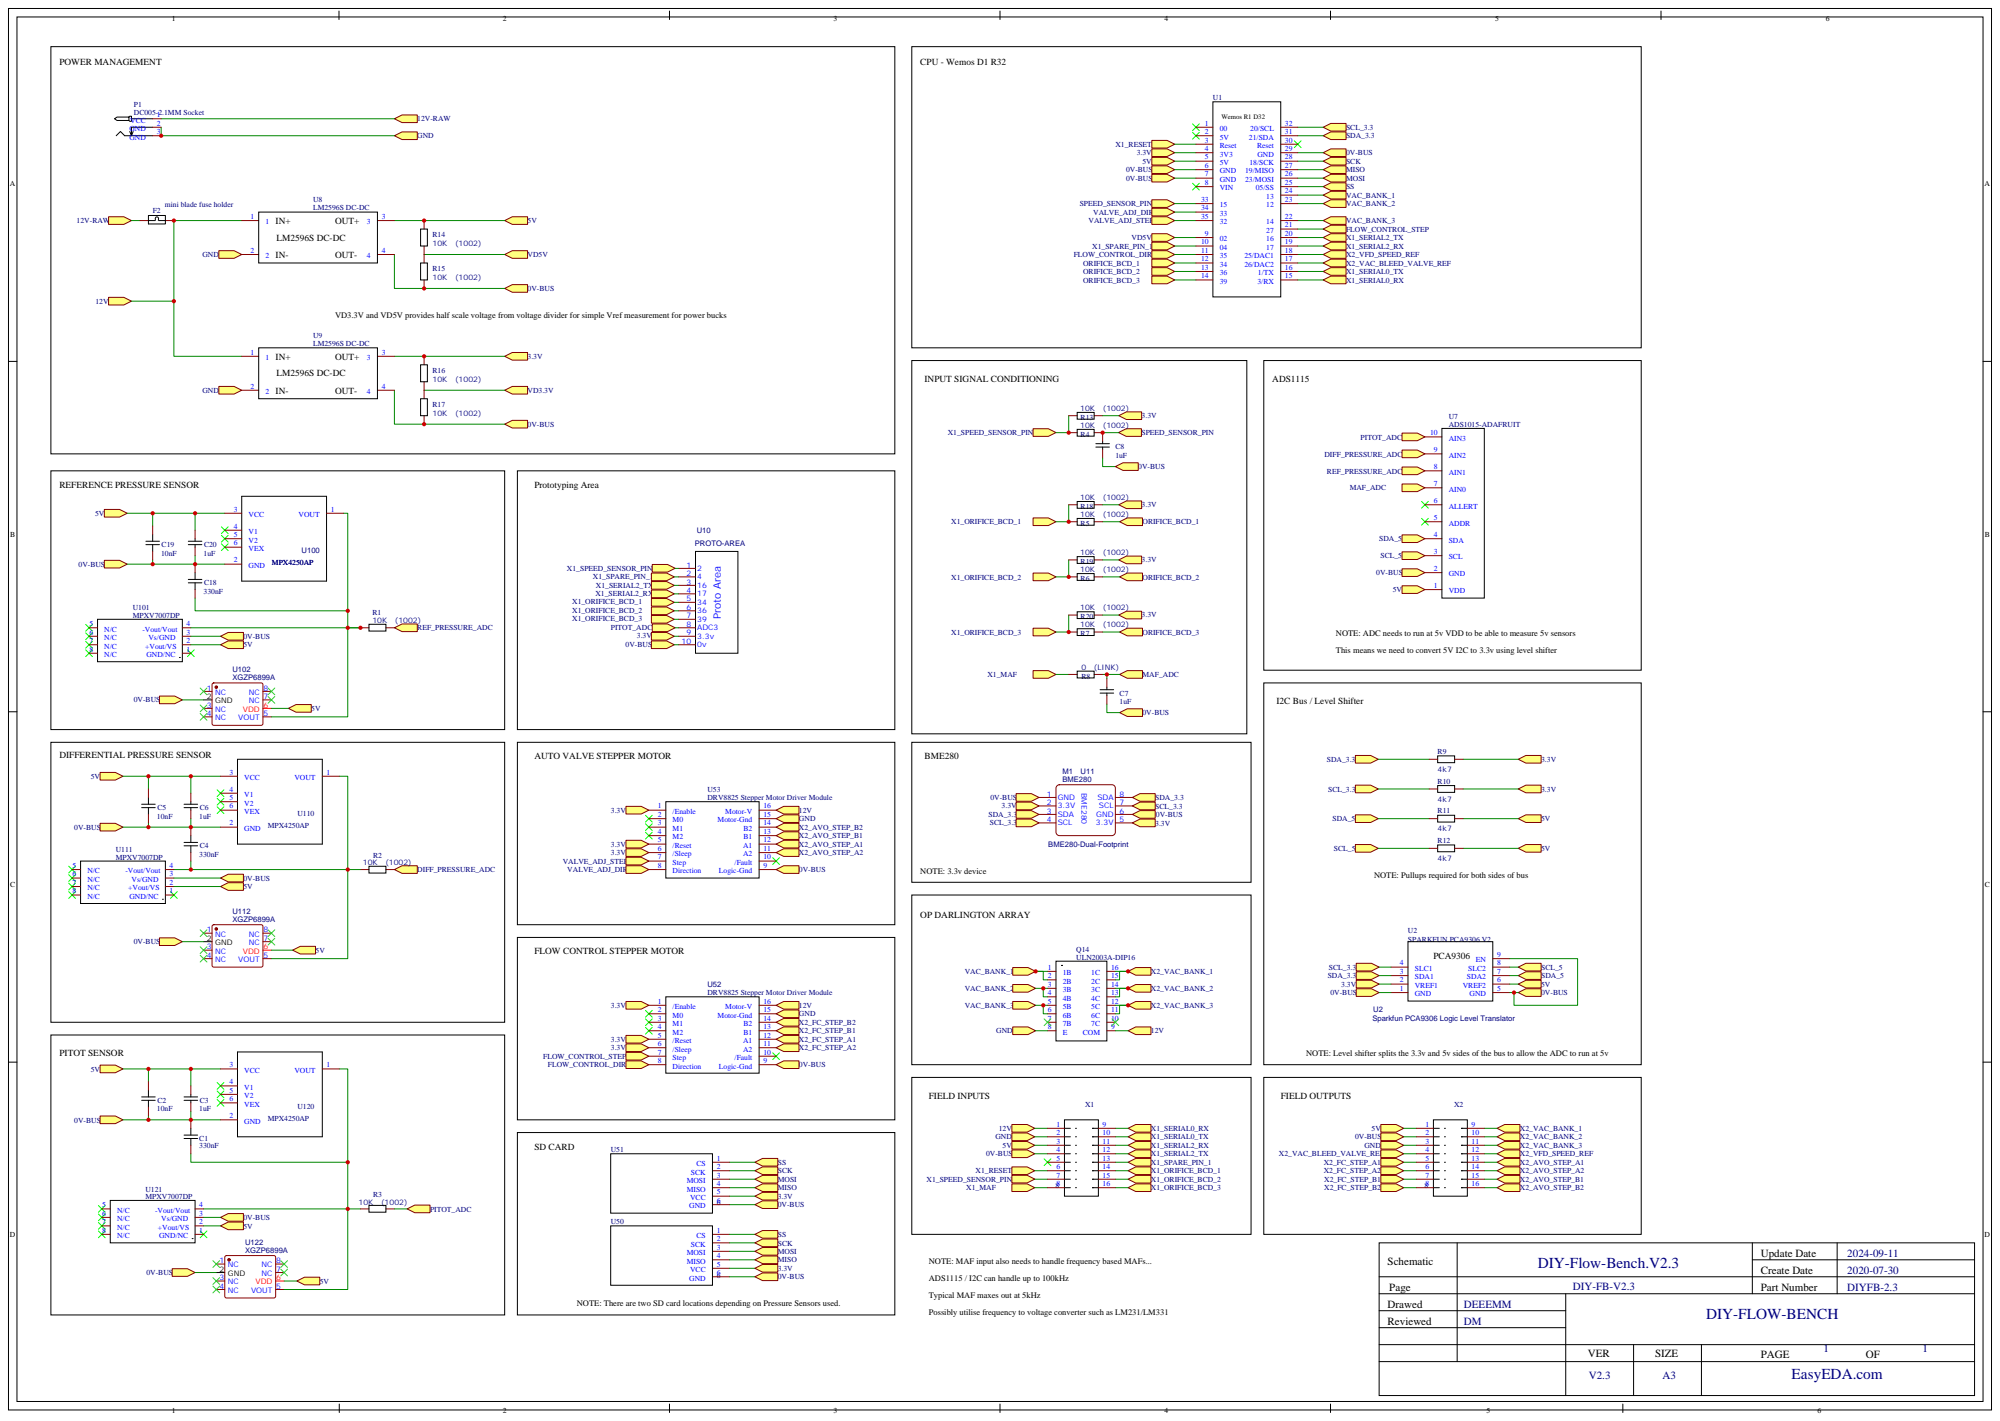
[picture p5: page 1]

mini blade fuse holder

VD3.3V and VD5V provides half scale voltage from voltage divider for simple Vref measurement for power bucks

NOTE: ADC needs to run at 5v VDD to be able to measure 5v sensors
This means we need to convert 5V I2C to 3.3v using level shifter

AUTO VALVE STEPPER MOTOR

DRV8825 Stepper Motor Driver Module

NOTE: Pullups required for both sides of bus

FLOW CONTROL STEPPER MOTOR

Sparkfun PCA9306 Logic Level Translator

NOTE: Level shifter splits the 3.3v and 5v sides of the bus to allow the ADC to run at 5v

NOTE: MAF input also needs to handle frequency based MAFs...
ADS1115 / I2C can handle up to 100kHz
Typical MAF maxes out at 5kHz
Possibly utilise frequency to voltage converter such as LM231/LM331

NOTE: There are two SD card locations depending on Pressure Sensors used.
