DeeEmm/DIY-Flow-Bench/ESP32/DIY-Flow-Bench/DIY-Flow-Bench.ino

/***********************************************************
 * @name The DIY Flow Bench project
 * @details Measure and display volumetric air flow using an ESP32 & Automotive MAF sensor
 * @link https://diyflowbench.com
 * @author DeeEmm aka Mick Percy deeemm@deeemm.com
 * 
 * @file DIY-Flow-Bench.ino
 * 
 * @brief define variables, configure hardware + main program loop
 * 
 * @remarks For more information please visit the WIKI on our GitHub project page: https://github.com/DeeEmm/DIY-Flow-Bench/wiki
 * Or join our support forums: https://github.com/DeeEmm/DIY-Flow-Bench/discussions
 * You can also visit our Facebook community: https://www.facebook.com/groups/diyflowbench/
 * 
 * @license Except where noted this project and all associated files are provided for use under the GNU GPL3 license:
 * https://github.com/DeeEmm/DIY-Flow-Bench/blob/master/LICENSE
 * 
 * The standard project board is the ESP32DUINO used in conjunction with the DIY-Flow-Bnch shield
 * Other ESP32 based boards and custom shields can be made to work. 
 * You can define custom pin definitions to suit your project in the GUI
 * 
 * Default Temperature / Barometric Pressure / Relative Humidity uses a BME280 device connected via I2C
 * The generic I2C address for the BME280 is 0x77 / 0x76 (NOTE: BME NOT BMP!!)
 *
 * Default MAF / Reference Pressure / Pitot / Differential Pressure sensors use ADS1115 Analog to digital converter via I2C
 * The generic I2C address for the ADS is 0x48 but can also be set to 0x49 / 0x4A / 0x4B by pin linking at the device
 *
 * Default MAF unit recommended is the AUDI RS4 (BOSCH 0280218067) This will measure up to approx 860cfm
 * Other MAF sensors are supported by creation and inclusion of MAF transfer function coefficients within the code
 *
 * DEPENDENCIES
 * This program has a number of core libraries that must be available for it to work. Please refer to platformio.ini > lib_deps
 * 
 *
 **/

#include <Arduino.h>
#include "freertos/semphr.h"
#include "esp_task_wdt.h"
// #include <MD_REncoder.h>
#include <math.h>
#include <Preferences.h>

#include "datahandler.h"
#include "constants.h"
#include "system.h"
#include "structs.h"
#include "mafdata.h"

#include "hardware.h" 
#include "sensors.h"
#include "calculations.h"
#include "webserver.h"
#include "publichtml.h" 
#include "messages.h"
#include "API.h"
#include "Wire.h"

#include "ADS1X15.h" // DM 'Lite' Library

// #ifndef SET_LOOP_TASK_STACK_SIZE
// #define SET_LOOP_TASK_STACK_SIZE( LOOP_TASK_STACK_SIZE );
// #endif

SET_LOOP_TASK_STACK_SIZE( LOOP_TASK_STACK_SIZE );

// Initiate Structs
BenchSettings settings;
DeviceStatus status;
SensorData sensorVal;
ValveLiftData valveData;
Language language;
CalibrationData calVal;
Configuration config;
Pins pins;

// Initiate Classes
Preferences _prefs;
DataHandler _data;
API _api;
Calculations _calculations;
Hardware _hardware;
Messages _message;
Sensors _sensors;
Webserver _webserver;
PublicHTML _public_html;

// Initiate Variables
TaskHandle_t sensorDataTask = NULL;
TaskHandle_t enviroDataTask = NULL;
// portMUX_TYPE mmux = portMUX_INITIALIZER_UNLOCKED;

// Custom sign function
template <typename T> int sgn(T val) {
    return (T(0) < val) - (val < T(0));
}

// char charDataJSON[256];
String jsonString;

// set up task timers to measure task frequency
int adcStartTime =  micros();
int bmeStartTime =  micros();
int loopStartTime = micros();

int runTask = SSE_TASK;
int adcTaskCount = 0;

/***********************************************************
 * @brief TASK: Get bench sensor data (ADS1115 - MAF/RefP/DiffP/Pitot)
 * @struct sensorVal global struct containing sensor values
 * @remarks Interrogates ADS1115 ADC and saves sensor values to struct
 * */	
  void TASKgetSensorData( void * parameter ){

  extern struct DeviceStatus status;
  extern struct SensorData sensorVal;
  extern struct CalibrationData calVal;
  extern struct BenchSettings settings;
  extern struct Configuration config;
  
  Sensors _sensors;
  Hardware _hardware;

  int sensorINT;

  for( ;; ) { // Infinite loop

      // Can we run??
      if (runTask == ADC_TASK) {

        // Set / reset scan timers
        status.adcScanTime = (micros() - adcStartTime); // how long since we started the timer? 
        adcStartTime = micros(); // start the timer
        status.bmeScanCountAverage = (status.bmeScanAlpha * status.bmeScanCount) + (1.0 - status.bmeScanAlpha) * status.bmeScanCountAverage;  // calculate Exponential moving average
        status.bmeScanCount = 1; // reset to 1 so first scan value in GUI is valid
        status.adcScanCount += 1;
        
        // Get reference voltages
        sensorVal.VCC_5V_BUS = _hardware.get5vSupplyVolts();
        sensorVal.VCC_3V3_BUS = _hardware.get3v3SupplyVolts();

        // Get MAF / Orifice / Venturi / Pitot flow data
        switch (settings.bench_type){

          case MAF_BENCH:
            if (config.iMAF_SRC_TYP != SENSOR_DISABLED) {
              sensorVal.FlowKGH = _sensors.getMafFlow();
              sensorVal.FlowCFMraw = _calculations.convertFlow(sensorVal.FlowKGH);
            }
          break;

          case ORIFICE_BENCH:
            sensorVal.FlowCFMraw = _sensors.getDifferentialFlow();
          break;

          case VENTURI_BENCH:
            //TODO
          break;

          case PITOT_BENCH:
            //TODO
          break;

          default:
            // Error bench type unknown
            _message.debugPrintf("Unknown Bench Type\n");
          break;

        }

        // Apply Flow calibration and leak offsets
        sensorVal.FlowCFM = sensorVal.FlowCFMraw  - calVal.leak_cal_baseline - calVal.leak_cal_offset  - calVal.flow_offset;

        // Apply Data filters...
        switch (settings.data_filter_type) {

          case MEDIAN:
            // Rolling Median      
            // sensorVal.AverageCFM += ( sensorVal.FlowCFM - sensorVal.AverageCFM ) * 0.1f; // rough running average.
            // sensorVal.MedianCFM += copysign( sensorVal.AverageCFM * 0.01, sensorVal.FlowCFM - sensorVal.MedianCFM );

            sensorVal.MedianCFM += ALPHA_MEDIAN * sgn(sensorVal.FlowCFM - sensorVal.MedianCFM);
            sensorVal.FlowCFM = sensorVal.MedianCFM;
          break;

          case AVERAGE:{
            // calculate Exponential moving average
            sensorVal.AverageCFM = (ALPHA_AVERAGE * sensorVal.FlowCFM) + (1.0f - ALPHA_AVERAGE) * sensorVal.AverageCFM; 
            sensorVal.FlowCFM = sensorVal.AverageCFM;
          break;
          }

          case MODE:
            //TODO - Mode
            // return most common value over x number of cycles (requested by @black-top)

            // Mean
            sensorVal.MeanCFM += ALPHA_MEAN * (sensorVal.FlowCFM - sensorVal.MeanCFM);
            sensorVal.FlowCFM = sensorVal.MeanCFM;
          break;

          case NONE:
          default:
            // No filter
            sensorVal.FlowCFM = sensorVal.FlowCFM;
          break;

        }

        // convert to standard flow
        sensorVal.FlowSCFM = _calculations.convertToSCFM(sensorVal.FlowCFM, settings.standardReference);

        // Get Flow differential values
        switch (sensorVal.FDiffType) {

          case USERTARGET:{

              switch (sensorVal.flowtile) {
                case MAFFLOW_TILE:
                  sensorVal.FDiff = sensorVal.FlowKGH - calVal.user_offset;
                  strcpy(sensorVal.FDiffTypeDesc, "User Target (kgh)");
                break;

                case ACFM_TILE:
                  sensorVal.FDiff = sensorVal.FlowCFM - calVal.user_offset;
                  strcpy(sensorVal.FDiffTypeDesc, "User Target (acfm)");
                break;

                case ADJCFM_TILE:
                  sensorVal.FDiff = sensorVal.FlowADJ - calVal.user_offset;
                  strcpy(sensorVal.FDiffTypeDesc, "User Target (ajd-cfm)");
                break;

                case SCFM_TILE:
                  sensorVal.FDiff = sensorVal.FlowSCFM - calVal.user_offset;
                  strcpy(sensorVal.FDiffTypeDesc, "User Target (scfm)");
                break;

              }

            sensorVal.FDiff = sensorVal.FlowCFM - calVal.user_offset;
            strcpy(sensorVal.FDiffTypeDesc, "User Target (cfm)");
  
            break;
          }
            
          case BASELINE:
            sensorVal.FDiff = sensorVal.FlowCFMraw - calVal.flow_offset - calVal.leak_cal_baseline;
            strcpy(sensorVal.FDiffTypeDesc, "Baseline (cfm)");
          break;
          
          case BASELINE_LEAK :
            sensorVal.FDiff = sensorVal.FlowCFMraw - calVal.flow_offset - calVal.leak_cal_baseline - calVal.leak_cal_offset;
            strcpy(sensorVal.FDiffTypeDesc, "Offset (cfm)");
          break;
                  
          default:
          break;
        }
          
        // Get pRef sensor data
        if (config.iPREF_SENS_TYP != SENSOR_DISABLED) {
          sensorVal.PRefKPA = _sensors.getPRefValue();
          sensorVal.PRefH2O = _calculations.convertPressure(sensorVal.PRefKPA, INH2O);
          if (settings.std_adj_flow == 1) {
            sensorVal.FlowADJ = _calculations.convertFlowDepression(sensorVal.PRefH2O, settings.adj_flow_depression, sensorVal.FlowSCFM);
          } else {
            sensorVal.FlowADJ = _calculations.convertFlowDepression(sensorVal.PRefH2O, settings.adj_flow_depression, sensorVal.FlowCFM);
          }
          sensorVal.FlowADJSCFM = _calculations.convertToSCFM(sensorVal.FlowADJ, settings.standardReference );
        } else {
          sensorVal.PRefKPA = 0.0f;
          sensorVal.PRefH2O = 0.0f;         
        }

        // Get pDiff sensor data
        if (config.iPDIFF_SENS_TYP != SENSOR_DISABLED) {
          sensorVal.PDiffKPA = _sensors.getPDiffValue();
          sensorVal.PDiffH2O = _calculations.convertPressure(sensorVal.PDiffKPA, INH2O) - calVal.pdiff_cal_offset;
        } else {
          sensorVal.PDiffKPA = 0.0f;
          sensorVal.PDiffH2O = 0.0f;
        }

        // Get Pitot sensor data
        if (config.iPITOT_SENS_TYP != SENSOR_DISABLED) {
          sensorVal.PitotKPA = _sensors.getPitotValue() - calVal.pitot_cal_offset;
          sensorVal.PitotH2O = _calculations.convertPressure(sensorVal.PitotKPA, INH2O) ;
          sensorVal.PitotVelocity = _sensors.getPitotVelocity(sensorVal.PitotKPA);
          sensorVal.PitotDelta = sensorVal.PitotH2O;
        } else {
          sensorVal.PitotKPA = 0.0f;
          sensorVal.PitotH2O = 0.0f;
          sensorVal.PitotVelocity = 0.0f;
        }

        if (config.bSWIRL_ENBLD) {
          // TODO #227
            // uint8_t Swirl = Encoder.read();

            // if (Swirl == DIR_CW) {
            //   sensorVal.Swirl = Encoder.speed();
            // } else {
            //   sensorVal.Swirl = Encoder.speed() * -1;
            // }
        } else {
          sensorVal.Swirl = 0;
        }
 
      adcTaskCount += 1;
      runTask = SSE_TASK;
    }
    vTaskDelay( VTASK_DELAY_ADC );  // mSec delay to prevent Watch Dog Timer (WDT) triggering and yield if required
  }
}



/***********************************************************
 * @brief TASK: Get environental sensor data (BME280 - Temp/Baro/RelH)
 * @struct sensorVal global struct containing sensor values
 * @struct status global struct containing system status values
 * @remarks Interrogates BME280 and saves sensor data to struct
 * */	
void TASKgetEnviroData( void * parameter ){

  extern struct DeviceStatus status;
  extern struct SensorData sensorVal;
  extern struct Configuration config;

  Calculations _calculations;

  for( ;; ) { // Infinite loop

    // Can we run ??
    if (runTask == BME_TASK) {  

        // Set / reset scan timers
        status.bmeScanTime = (micros() - bmeStartTime); // how long since we started the timer? 
        bmeStartTime = micros(); // start the timer
        status.adcScanCountAverage = (status.adcScanAlpha * status.adcScanCount) + (1.0 - status.adcScanAlpha) * status.adcScanCountAverage;   // calculate Exponential moving average     
        status.adcScanCount = 1;
        status.bmeScanCount += 1;
        
        // Get temp sensor data
        sensorVal.TempDegC = _sensors.getTempValue();        
        sensorVal.TempDegF = _calculations.convertTemperature(_sensors.getTempValue(), DEGF);

        // Get baro sensor data
        sensorVal.BaroHPA = _sensors.getBaroValue();
        sensorVal.BaroPA = sensorVal.BaroHPA * 100.00F;
        sensorVal.BaroKPA = sensorVal.BaroPA * 0.001F;

        // Get humidity sensor data
        sensorVal.RelH = _sensors.getRelHValue();

      runTask = SSE_TASK;
    }
    vTaskDelay( VTASK_DELAY_BME ); // mSec delay to prevent Watch Dog Timer (WDT) triggering and yield if required
	}
}





/***********************************************************
 * @brief Default setup function
 * @details Initialises system and sets up core tasks
 * @note We can assign tasks to specific cores if required (currently disabled)
 ***/
void setup(void) {

  extern struct Pins pins;
  extern struct Configuration config;

  #ifdef VERBOSE
    settings.verbose_print_mode = true; 
  #endif

  // REVIEW
  // set message queue length
  // xQueueCreate( 8, 1024);
  // xQueueCreate( 256, 2048);
  // xQueueCreate( 1024, 4096);
    
  // Initialise Data environment
  _data.begin();
  
  // Initialise Hardware
  _hardware.begin();

  // Initialise sensors
  _sensors.begin();

  // Confirm default core - NOTE: setup() and loop() are automatically created on default core 
  uint8_t defaultCore = xPortGetCoreID();                   // This core (1)
  uint8_t secondaryCore = (defaultCore > 0 ? 0 : 1);        // Secondary core (0)

  #ifdef WEBSERVER_ENABLED  
    _webserver.begin();
  #endif

  xTaskCreatePinnedToCore(TASKgetSensorData, "GET_SENS_DATA", SENSOR_TASK_MEM_STACK, NULL, 2, &sensorDataTask, secondaryCore); 
  // xTaskCreate(TASKgetSensorData, "GET_SENS_DATA", SENSOR_TASK_MEM_STACK, NULL, 2, &sensorDataTask); 

  xTaskCreatePinnedToCore(TASKgetEnviroData, "GET_ENVIRO_DATA", ENVIRO_TASK_MEM_STACK, NULL, 2, &enviroDataTask, secondaryCore); 
  // xTaskCreate(TASKgetEnviroData, "GET_ENVIRO_DATA", ENVIRO_TASK_MEM_STACK, NULL, 2, &enviroDataTask); 

  if (config.bSWIRL_ENBLD){
    // TODO #227
    // MD_REncoder Encoder = MD_REncoder(SWIRL_ENCODER_A, SWIRL_ENCODER_B);
  }

  // Report free stack and heap to serial monitor
  _message.serialPrintf("Free Stack: EnviroTask=%s  \n", _calculations.byteDecode(uxTaskGetStackHighWaterMark(enviroDataTask))); 
  _message.serialPrintf("Free Stack: SensorTask=%s  \n", _calculations.byteDecode(uxTaskGetStackHighWaterMark(sensorDataTask))); 
  _message.serialPrintf("Free Stack: LoopTask=%s    \n", _calculations.byteDecode(uxTaskGetStackHighWaterMark(NULL))); 
  _message.serialPrintf("Free Heap=%s / Max Allocated Heap=%s \n", _calculations.byteDecode(ESP.getFreeHeap()), _calculations.byteDecode(ESP.getMaxAllocHeap())); 

}




/***********************************************************
 * @brief MAIN LOOP
 * @details processes API requests 
 * @details pushes data to clients via SSE
 * 
 * @note Use non-breaking delays for throttling events
 ***/
void loop () {

  
  // Process API comms
  if (settings.api_enabled) {        
    if (millis() > status.apiPollTimer && runTask == SSE_TASK) {

        status.apiPollTimer = millis() + API_SCAN_DELAY_MS; 

        if (Serial.available() > 0) {
          status.serialData = Serial.read();
          _api.ParseMessage(status.serialData);
        }
    }                            
  }

  
  // TODO: PID Vac source Analog VFD control [if PREF not within limits]
  // _hardware.setVFDRef();
  // _hardware.setBleedValveRef();
  

  #ifdef WEBSERVER_ENABLED
    if (millis() > status.ssePollTimer && runTask == SSE_TASK) {      

      status.ssePollTimer = millis() + SSE_UPDATE_RATE; // Only reset timer when task executes
      
      // Build Server Side Events (SSE) data
      switch (status.GUIpage) {
        case INDEX_PAGE:{
          jsonString = _data.buildIndexSSEJsonData();
          break;
        }
        case MIMIC_PAGE:{
          jsonString = _data.buildMimicSSEJsonData();
          break;
        }
      }
      // Push SSE data to client
      _webserver.events->send(String(jsonString).c_str(),"JSON_DATA",millis()); 

      if (adcTaskCount > 2) {
        runTask = BME_TASK;
        adcTaskCount = 0;
      } else {
        runTask = ADC_TASK;
      }
    }
  #endif


  if (status.shouldReboot) {
    _message.serialPrintf("Rebooting...");
    delay(100);
    ESP.restart();
  }

  vTaskDelay( 1 );  //mSec delay to prevent Watch Dog Timer (WDT) triggering for empty task

  // Measure scan time
  status.loopScanTime = (micros() - loopStartTime); 
  loopStartTime = micros(); // start the timer
  
}
