DeeEmm/DIY-Flow-Bench/ESP32/DIY-Flow-Bench/constants.h

/***********************************************************
 * @name The DIY Flow Bench project
 * @details Measure and display volumetric air flow using an ESP32 & Automotive MAF sensor
 * @link https://diyflowbench.com
 * @author DeeEmm aka Mick Percy deeemm@deeemm.com
 * 
 * @file constants.h
 * 
 * @brief Define constants
 * 
 * @remarks For more information please visit the WIKI on our GitHub project page: https://github.com/DeeEmm/DIY-Flow-Bench/wiki
 * Or join our support forums: https://github.com/DeeEmm/DIY-Flow-Bench/discussions
 * You can also visit our Facebook community: https://www.facebook.com/groups/diyflowbench/
 * 
 * @license This project and all associated files are provided for use under the GNU GPL3 license:
 * https://github.com/DeeEmm/DIY-Flow-Bench/blob/master/LICENSE
 * 
 ***/
#pragma once

#include <stdint.h>

// AsynWebServer literals from: literals.h
// much more efficient to just load those literals that we need
static constexpr const char* T_text_html = "text/html";
static constexpr const char* T_Content_Encoding = "content-encoding";
static constexpr const char* T_gzip = "gzip";
static constexpr const char* T_application_json = "application/json";

enum VolumetricUnits {
    CFM,    // Cubic feet per minute
    LPM,    // Liters per minute
    M3H     // Cubic meters per hour
};

/***********************************************************
 * General
 ***/
#define ARDUINOJSON_ENABLE_STD_STRING 1 // allow support for std::string
#define PINSFILE 1
#define MAFFILE 2
#define INDEXFILE 3
#define CONFIGFILE 4
#define NO_TASK 0
#define ADC_TASK 1
#define BME_TASK 2
#define SSE_TASK 3

/***********************************************************
 * Physical constants
 ***/
#define MOLAR_MASS_DRY_AIR 28.96469 // g/mole or 0.028964 kg/mol.
#define MOLAR_MASS_WATER_VAPOUR 18.01528 //g/mol or 0.0180153 kg/mol
#define SPECIFIC_GAS_CONSTANT_DRY_AIR 287.058  // J/ (kg.K).
#define SPECIFIC_GRAVITY_DRY_AIR 0.0013 // SG
#define UNIVERSAL_GAS_CONSTANT 8.3144598 // (48) J⋅mol^−1⋅K^−1.
#define SPECIFIC_GAS_CONSTANT_WATER_VAPOUR 461.5 //  J/(kg⋅K).


/***********************************************************
 * Conversion factors
 ***/
#define ISO1585_CFM_PER_KGH 0.49710961
#define ISO1585_KGH_PER_CFM 2.01162879
 
#define ISO5011_CFM_PER_KGH 0.488851967
#define ISO5011_KGH_PER_CFM 2.045609 


/***********************************************************
 * Standard Units
 ***/
#define  RAW 0
#define  DECI 0
#define  INH2O 1
#define  KPA 2
#define  PSIA 3
#define  DEGC 4
#define  DEGF 5
#define  RANKINE 6
#define  PERCENT 7
#define  BAR 8
#define  HPA 9
#define  KELVIN 10
#define  ATM 11
#define  PASCALS 12


/***********************************************************
 * Error handler codes
 ***/
#define  NO_ERROR 0
#define  REF_PRESS_LOW 1
#define  LEAK_TEST_FAILED 2
#define  LEAK_TEST_PASS 3
#define  DHT11_READ_FAIL 4
#define  BME280_READ_FAIL 5
#define  BENCH_RUNNING 6


/***********************************************************
 * MAF Data File constants
 ***/

#define  VOLTAGE 1
#define  FREQUENCY 2
#define  KEY_VAL 1
#define  RAW_ANALOG 2
#define  KG_H 1
#define  MG_S 2
#define  GM_M 3


/***********************************************************
 * MAF Data Coefficients
 ***/

#define COEFF_0 0
#define COEFF_1 1
#define COEFF_2 2
#define COEFF_3 3
#define COEFF_4 4
#define COEFF_5 5
#define COEFF_6 6


/***********************************************************
 * Sensor types
 ***/
#define SENSOR_DISABLED 1
#define REF_PRESS_AS_BARO 2
#define FIXED_VAL 3
#define MPXV7007 4
#define MPX4250 5
#define MPXV7007DP 6
#define BOSCH_BME280 7
#define MPX4115 8
#define SIMPLE_TEMP_DHT11 9
#define ADS1015 10
#define ADS1115 11
#define LINEAR_ANALOG 12
#define MPXV7025 13
#define XGZP6899A007KPDPN 14
#define XGZP6899A010KPDPN 15
#define M5STACK_TubePressure 16
#define BOSCH_BME680 17
#define ADS_ADC 18


/***********************************************************
 * Flow Tile types
 ***/
#define MAFFLOW_TILE 1
#define ACFM_TILE 2
#define ADJCFM_TILE 3
#define SCFM_TILE 4
#define KGH_TILE 5



/***********************************************************
 * Flow Differential types
 ***/
#define USERTARGET 1
#define BASELINE 2
#define BASELINE_LEAK 3

/***********************************************************
 * Currnt GUI page
 ***/
#define INDEX_PAGE 1
#define DATA_PAGE 2
#define SETTINGS_PAGE 3
#define CONFIG_PAGE 4
#define PINS_PAGE 5
#define CALIBRATION_PAGE 6
#define MIMIC_PAGE 7


/***********************************************************
 * International Standards
 ***/
#define ISO_1585 1
#define ISO_5011 2
#define ISA 3
#define ISO_13443 4
#define ISO_2533 5

/***********************************************************
 * Capture Datatypes
 ***/
#define ACFM 1
#define STD_ACFM 2
#define ADJ_ACFM 3
#define ADJ_STD_ACFM 4
#define RAW_MASS 5


/***********************************************************
 * Bench Types
 ***/

#define MAF_BENCH 1
#define ORIFICE_BENCH 2
#define VENTURI_BENCH 3
#define PITOT_BENCH 4



/***********************************************************
 * Data Filter Types
 ***/

#define NONE 1
#define MEDIAN 2
#define AVERAGE 3
#define MODE 4



/***********************************************************
 * Data Rounding Types
 ***/
#define INTEGER 2
#define HALF 3


/***********************************************************
 * Decimal Accuracy
 ***/
#define TENTHS 2
#define HUNDREDTHS 3
#define THOUSANDTHS 4


/***********************************************************
 * Temperature
 ***/
#define CELCIUS 1
#define FARENHEIT 2


/***********************************************************
 * BME Registers
 ***/
#define BME280_REG_DIG_T1    0x88
#define BME280_REG_DIG_T2    0x8A
#define BME280_REG_DIG_T3    0x8C

#define BME280_REG_DIG_P1    0x8E
#define BME280_REG_DIG_P2    0x90
#define BME280_REG_DIG_P3    0x92
#define BME280_REG_DIG_P4    0x94
#define BME280_REG_DIG_P5    0x96
#define BME280_REG_DIG_P6    0x98
#define BME280_REG_DIG_P7    0x9A
#define BME280_REG_DIG_P8    0x9C
#define BME280_REG_DIG_P9    0x9E

#define BME280_REG_DIG_H1    0xA1
#define BME280_REG_DIG_H2    0xE1
#define BME280_REG_DIG_H3    0xE3
#define BME280_REG_DIG_H4    0xE4
#define BME280_REG_DIG_H5    0xE5
#define BME280_REG_DIG_H6    0xE7

#define BME280_REG_CHIPID          0xD0
#define BME280_REG_VERSION         0xD1
#define BME280_REG_SOFTRESET       0xE0

#define BME280_REG_CAL26           0xE1

#define BME280_REG_CTRLHUMID        0xF2
#define BME280_REG_CTRL             0xF4
#define BME280_REG_CONFIG          0xF5
#define BME280_REG_PRESSUREDATA    0xF7
#define BME280_REG_TEMPDATA        0xFA
#define BME280_REG_HUMIDITYDATA    0xFD




/***********************************************************
 * Favicon
 ***/
#define favicon_ico_gz_len 1956
const uint8_t favicon_ico_gz[] = {
0x1F, 0x8B, 0x08, 0x00, 0x00, 0x00, 0x00, 0x00, 0x00, 0x03, 0xED, 0x5A, 0x09, 0x6C, 0x15, 0x55, 
0x14, 0x1D, 0x16, 0x15, 0x11, 0xA5, 0x20, 0xA8, 0x88, 0x4A, 0x11, 0xC5, 0xAA, 0x89, 0xA2, 0x06, 
0x5C, 0x22, 0x8A, 0x7B, 0x8C, 0x4B, 0x34, 0x8A, 0x8A, 0xC1, 0x44, 0xE3, 0x12, 0xA2, 0x44, 0xC4, 
0xA8, 0xC4, 0x88, 0x04, 0xA3, 0x84, 0x16, 0x5A, 0x0A, 0xA5, 0x14, 0x4A, 0xCB, 0x52, 0xA0, 0xA5, 
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
0xBC, 0xFE, 0x57, 0xA1, 0x6D, 0x6D, 0x4B, 0x50, 0x3E, 0x5B, 0xE9, 0x25, 0x4F, 0xF9, 0x8E, 0x0F, 
0x14, 0xFA, 0xF4, 0xB3, 0x78, 0xBF, 0xE6, 0x27, 0xE1, 0x21, 0xA4, 0xA9, 0x27, 0x7D, 0x22, 0xA2, 
0xBD, 0x9A, 0x73, 0x29, 0x90, 0xF8, 0x72, 0x0D, 0xF4, 0x87, 0x88, 0xEF, 0x54, 0x1F, 0xFA, 0x73, 
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
};
