DeeEmm/DIY-Flow-Bench/(commit log)

2018-06-11 Add Arduino sketch
    Initial version.
    Basic translation of MAF signal into voltage displayed on 4 character 7 segment LED display.
2018-06-11 Create BOM
2019-11-23 Revert "V1 Code Foundation"
    This reverts commit 45953637f523efffeb73c55413e8696dc598f1ae.
    [DIY-Flow-Bench.ino, calculations.h, calibration.h, sensors.h]
2019-11-23 Revert "Revert "V1 Code Foundation""
    This reverts commit 01cb12dc2c7e5db4ed7580eb48321169fc5125a8.
    [DIY-Flow-Bench.ino, calculations.h, calibration.h, sensors.h]
2019-11-23 Added Mega 2560 pin mapping
2019-11-24 Update calibration.h
    Added function for bench test
2019-11-25 Added cases for linear / non-linear MAF sensors
2019-11-25 Added pin definitions
2019-11-29 tcMenu integration
    [configuration.h]
2019-11-29 Update configuration.h
    TODO - NVM addresses for calibration data storage
    [configuration.h]
2019-11-29 Added definitions for Uno
    [configuration.h]
2019-12-01 Added code version + build display to menu
    Allows for easier identification of code and build version that is installed on system. Code and Build constants set in main file.
    Build number should be unique for each push. Format used is YYMMDDVV where VV is incremental number starting from 01
    Would be good to automate this.
    [configuration.h]
2019-12-01 Updated Pin-Outs
    [configuration.h]
2019-12-01 Basic code function finished
    Added calibration routine to save to eeprom
    Finalised sensor functions
    Added additional display functions
    Finalised menu functions
    [configuration.h]
2019-12-02 Updated comments
    [configuration.h]
2019-12-04 Added Ref Pressure / Mid Flow calibration functions
    [configuration.h]
2019-12-05 Fixed typo
    [configuration.h]
2019-12-05 Refactored Folder structure
    [configuration.h]
2019-12-05 Fixed compile error
    [configuration.h]
2019-12-06 Build 19120701
    - Changed directory structure to resolve dependency issue
    - Moved libraries into src subfolder folder
    - Created this changelog file
    [configuration.h]
2019-12-08 MAF Lookup table support
    Added support for additional MAF sensors via lookup tables using both millivolts/cfm and raw analog/cfm
    [configuration.h]
2019-12-08 BUILD 19120802
    - Added partial support for additional languages
    - Created function for popover display dialog
    - Added max-flow error check
    [configuration.h]
2019-12-08 Build 19120803
    - #7 Update calibration functions
    [configuration.h]
2019-12-08 Build 19120804
    - Display Calibration results on screen
2019-12-10 Build 19121001
    V1.0-Beta.2 release. Minor changes to make menus easier to read and code more robust.
    [configuration.h]
2019-12-20 Build 19122001
    - Added support for BMP280
    - Fixed potential MAF conversion issue
    - Minor bugfixes
    [configuration.h]
2019-12-20 Build 19122002
    - Bugfix BMP 280 Library
    [configuration.h]
2019-12-23 Build 19122301
    - Changed order of display items for better visibility on 2 line Display
    - Added one decimal places to display values value (changed divisor to 10 in tcMenu)
    - Renamed existing BMP280 code references to ADAFRUIT_BMP280
    - Added support for ILIB_BMP280 library
    - Added support for DHT11 sensors
    - Added mass > volumetric flow compensation calculations
    - Remapped Siemens_5WK9605 mafdata from cfm to kg/h
    [configuration.h]
2019-12-23 Build 19122401
    - Bugfix release various display bugs
    - Validated Mass > Volumetric flow conversion
    - Validated Flow reference conversion
    - Disabled menu timeout
    - Added MafVolts to display for testing / diagnostics
    - Tidied Display layout
    [configuration.h]
2019-12-26 Build 19122601
    - #23 DHT11 compile issue
    - #19 Support for RH sensor
    - Added MIN_MAF_MILLIVOLTS to filter MAF results
    [configuration.h]
2020-01-01 Build 20010101
    - Fixed spelling mistake for ilibBmp280 calls
    - Fixed float issue for pRef
    [DIY-Flow-Bench.ino]
2020-04-15 Reorganisation
    Reorganised project folder structure
    [configuration.h]
2020-07-28 Build 20072901
    - Changed format version varables
    - Added basic serial API functions
    - Dropped ilib280 support (depreciated)
    - Added Adafruit BME280 support
    - Corrected datatypes in mafData files
    - Added website URL to docs / comments
    [configuration.h]
2020-08-01 BUILD 20080102
    - #28 fixed incorrect CFM reading...
    - Updated getMafFlowCFM function
    - Corrected mafData files voltage
    - Added additional functions to API
    - update configuration.h set default values
    [configuration.h]
2020-08-01 Build 20080201
    - Added additional variables to MAF data files #29
    [configuration.h]
2020-08-02 Build 20080204
    - Differentiate between kg/h & mg/s in API MAF Data command.
    - Added support for MPX4250 reference pressure sensor
    [configuration.h]
2020-08-03 Build 20080307
    - Added support for Sparkfun BME280 (works with generic 10 pin BME280)
    [configuration.h]
2020-08-04 Build 20080401
    - Fixed some typos and reduced program size
    - #32 Added additional array type for analog mafData files (memory issue)
    - #33 Fixed humidity correction issue
    [configuration.h]
2020-08-04 Build 20080402
    - Added analog mafData example
    [configuration.h]
2020-08-06 Build 20080501
    - Moved language file call to configation settings
    - Move pin configuration into pins.h
    - Refactored menu code and moved calibration into dedicated functions
    - Removed redundant calibration functions
    - Rewrote calibration functions
    [configuration.h]
2020-08-06 Build 20080601
    - #37 Commented out 'freeze' statement (line 139) - while(1); //Freeze
    [configuration.h]
2020-08-06 Update BOM
2020-08-06 Build 20080603
    - Updated LS2 MAF part number
    - #37 updated temp / baro / humidty menu functions
    - Added sensor test menu
    - Added Baro menu item
    - #38 Fixed version + build menu items
    [configuration.h]
2020-08-06 Build 20080604
    - #36 MPX4250 scaling error - subtracted atmospheric pressure from reading
    - #39 Fixed flow value fraction value (displaying zero)
    - #40 Fixed adjusted flow display
    - Updated tcmenu
    - Fixed & tested pitot display
    - Changed pitot display to show differential as percentage difference (to P Ref)
    [configuration.h]
2020-08-07 Build 20080702
    - Added I2C address to Sparkfun BME280 initialisation
    - Added configuration defaults for baro / temp / relH
    - Fixed bench is running conditions / commented out low ref pressure alarm for testing
    - Added releases to changelog
    [configuration.h]
2020-08-07 Build 20080703
    - Updated MPX4250 Ref pressure calculations
    [configuration.h]
2020-08-07 Build 20080704
    - Added MPX2050 Reference pressure sensor
    - Improved code for using ref pressure value for baro on system boot
    - Dropped support for BMP280
    [configuration.h]
2020-08-07 Build 20080705
    - Dropped support for PMX2050 (only posotive range so will not work with vac - D'Oh!)
    - Updated BOM
    - Updated hardware schema
    - Updated readme
    [configuration.h]
2020-08-09 Build 20080901
    - Added CRC Checksum function
    [configuration.h]
2020-08-09 Build 20080902
    - Added API Enum : Flow:Ref:Temp:Humidity:Baro
2020-08-11 Build 20081101
    - Added pins definition for DIYFB shield
    - Added serial comms handler
    - Added secondary serial comms for bluetooth
    - Created digital manometer function (for additional flow / pitot displays)
    - General code tidying
    - Renamed pins.h to boards.h
    - Added PMAS MH95-3000 MAF
    [configuration.h]
2020-08-11 Added 3D MAF mount
    3D printed MAF mount for 110mm diameter OD pipe (nom 100mm ID)
    [110mm Dia MAF Mount v4.f3d, 110mm Dia MAF Mount v4.stl]
2020-08-16 Build 20081601
    - #46 Added reference pressure offet to volumetric flow calculation
2021-07-18 ESP32 Initial Commit
    Porting of code to ESP32 platform
2021-07-18 Build 21071801
    - Ported code to ESP32
    - Removed TC menu support
    - Removed external display support
    - Disabled CRC checksum
    - Updated pin mapping
    - Tested via Serial API
    [configuration.h]
2021-07-18 Build 21071802
    - Added SPIFFS
    - Added system status message to serial on boot
    - Serial reporting permanently enabled
    - Added Wifi Station mode
    - Added basic web server
    [configuration.h]
2021-07-19 Build 21071901
    - Code refactor
    - Created basic Web UI
    [configuration.h]
2021-07-19 Build 21072001
    - Asynchronous web sockets
    - Added Status messages
    - Added JSON status message to API
    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
    [configuration.h]
2021-07-22 Build 21072301
    - Added Multicast DNS Service
    - Added fallback to AP mode
    - Added tabbed interface to web server
    - Added configuration settings
    [configuration.h]
2021-07-22 Build 21072301
    - Code refactoring
    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
    [config.txt, configuration.h, default.config.txt]
2021-07-24 Build 21072401
    - Added calibration settings
    - Added additional configuration settings
    - Updated configuration file JSON formatting
    - Changed config file extension from txt to JSON
    - Added modal dialogs for file management and status
    [configuration.h]
2021-07-26 Build 21072701
    - Populated modal dialogs for file management and status
    - Added status info for hardware configuration
    - Reformatted
    - Created UI Graphs for data visualisation
    - Refactored websocket communications to use JSON data
    - Moved status and config data into Structs
    [configuration.h]
2021-08-07 Build 21080701
    - #71 Added file download code to File manager
    - #71 Added file delete code to File Manager
    - #71 Added file Upload code to File Manager
    - #65 Removed alarm mute feature
    - Added data streaming inc refresh rate
    - Added data streaming controls (on/off buttons)
    - Started on code refactor (breaking changes)
    [configuration.h]
2021-08-13 Build 21081301
    - Major code refactor to object based structure complete
    - Converted procedural functions to class + method
    - Improved file upload handling
    - Return to file upload modal after file upload
    - Renamed Schema to Header to remove ambiguity
    - Added sensor types used to status dialog
    - Fixed Javascript errors for status websocket update
    - Fixed timeout for AP mode
    - Optimised websocket handler browser code
    - Remove header key from config JSON file
    [configuration.h]
2021-08-14 Update README.md
    NOTE: RE ESP32 port
2021-08-19 Build 21081902
    - Removed DIY-Flow-Bench header file
    - Flow calibration
    - Leak test calibration
    - added support for analog Temp / Baro / Relh sensors
    - general code tidy
    - added vanilla boot handling
    - #63 Reviewed I/O
    - #64 GZip compression
    - #70 Server initialisation
    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
    [configuration.h]
2021-08-19 Build 21081902
    - #75 Auto create config / calibration json file(s) if not exists
    - Minor code tidying
    - Updated README
2021-08-20 Build 21082001
    - Added vac control O/P
    - #75 Fixed calibration data handling
    [configuration.h]
2021-08-20 Work in progress
    Rewriting MAF data handling
    [configuration.h]
2021-08-21 WIP 20/08/21
    Breaking Changes
    [configuration.h]
2021-08-21 WIP 21082201
    - Breaking Changes
    - MAF sensor handling
    [configuration.h]
2021-08-22 WIP 21082202
    Breaking changes
    MAF Maths Function
    [configuration.h]
2021-08-23 WIP 21082302
    Compiling on Arduino-CLI with some warnings relating to unused vars (unfinished code in Maths / Sensors)
    Code tested and working on ESPduino
    [configuration.h]
2021-08-23 WIP 210832303
    Some general tidying of MAF data files.
    [configuration.h]
2021-08-24 Delete node_modules directory
    Have deleted node_modules directory from project and added to .gitignore
    Users can build local version using package.json as a reference if they want to run gulp tasks.
    Wiki already contains details on how to do this - https://github.com/DeeEmm/DIY-Flow-Bench/wiki/WEB-UI
2021-08-25 Build 21082501
    - Checked & updated remaining MAF data files
    - Hardware::configurePins
    - Added orifice detection code pins
    - Started on #84
    - General code tidy
    [configuration.h]
2021-08-25 Build 21082502
    - Reviewed Status and error messages
    - Changed release version to V.2.0
    - Release Candidate 1
    [configuration.h]
2021-08-25 Build 21082503
    - #87 Wifi client network
    - Corrected millivolt calc in Webserver::getDataJSON
    [configuration.h]
2021-08-26 Updated wording for ESP32
2021-08-26 Updated for revised ESP32 MAF format
2021-08-26 PCB V1-beta
    These files are untested at this stage.
    [BOM_DIY-Flow-Bench Shield.csv]
2021-08-27 Updated BOM
    - Added part # column
    - Added clarification to notes
2021-08-27 Updated BOM description
2021-08-27 Added clarification RE pressure sensor
2021-08-29 Added PCB image to Readme
2021-09-01 WIP 21090101
    [BOM_DIY-Flow-Bench Shield.csv, configuration.h]
2021-09-01 WIP 21090201
    Adding ADCs
    [configuration.h]
2021-09-02 WIP 210901012
    - Added support for 1015 / 1115 ADC for MAF / PRef / PDiff / Pitot
    [configuration.h]
2021-09-02 Build 21090101
    Added support for 1015 / 1115 ADC for MAF / PRef / PDiff / Pitot
2021-09-07 Build 21090801
    - (temporarily disabled ADC)
    - Updated BOM in docs folder
    [configuration.h]
2021-09-19 Build 21091801
    - Added additional dependencies for BME280 - ESP32
    - Custom BME280 code to replace Adafruit and Sparkfun libraries
    - Added soft reset button to config panel
    [configuration.h]
2021-09-21 Build 21092201
    - Added user defined vanity title
    - Dropped support for DHT11
    - Fixed RH reading
    - Added ADC1015 support for MAF / PRef / PDiff / Pitot
    - #97 API disabled by debug mode
    - Fixed Board voltage ADC code
    - Changed pressure sensor calcs to pascals
    - Dropped support for MPX5100/5700
    - NOTE: Remapped pins
    [configuration.h]
2022-11-12 Build 12112201
    [configuration.h]
2022-11-12 Delete ESP32/DIY-Flow-Bench/redacted directory
    Added to gitignore
2022-11-13 Build 13112201
    [configuration.h]
2022-11-18 build 18112201
    [configuration.h]
2022-11-20 build 20112201
    [configuration.h]
2022-11-20 Build 20112202
    [configuration.h]
2022-11-20 Build 21112201
    [configuration.h]
2022-11-23 Build 22112201
    [configuration.h]
2022-11-24 Build 22112401
    [configuration.h]
2022-11-25 Build 22112402
    [configuration.h]
2022-11-30 Build 22120101
    [configuration.h]
2022-12-01 Build 22120103
    [configuration.h]
2022-12-07 Build 22120801
    [configuration.h]
2022-12-12 Build 22121201
    [configuration.h]
2022-12-14 Build 22121501
    [configuration.h]
2022-12-18 Build 22121801
    [configuration.h]
2022-12-19 Build 22121901
    [configuration.h]
2023-01-15 Build 23011501
    [configuration.h]
2023-01-16 Build 23011601
    [configuration.h]
2023-01-20 Build 23012001
    [configuration.h]
2023-01-22 Build 23012301
    [configuration.h]
2023-01-31 Build 31012301
    [configuration.h]
2023-02-01 Build 23020101
    [configuration.h]
2023-02-07 Build 23020701
    [configuration.h]
2023-02-15 Build 23021501
    [configuration.h]
2023-02-25 Build 23022501
    [configuration.h]
2023-02-28 Build 23022801
    [configuration.h]
2023-03-02 Build 23030201
    [configuration.h]
2023-03-03 Build 23030202
    [configuration.h]
2023-03-07 Build 23030801
    [configuration.h]
2023-03-29 Build 23032901
    [configuration.h]
2023-03-30 Updated support.yml
    [configuration.h]
2023-04-03 Build 23040301
    [configuration.h]
2023-04-03 Build 23040302
    [configuration.h]
2023-04-04 Build 23040401
    [configuration.h]
2023-04-12 Build 23041201
    [configuration.h]
2023-04-12 Build 23041202
    [configuration.h]
2024-09-11 Build 24091101
    [BOM_DIY-FLOW-BENCH-V2-3.csv, configuration.h]
2024-09-11 Update PCB Readme
2024-10-22 Build 24102301 - #178 - Leak Test Calibration data - #179 - Flow test Calibration
    [configuration.h]
2024-10-26 Build 24102601 - #178 - Leak Test Calibration data - #179 - Flow test Calibration
    [configuration.h]
2024-10-27 Build 24102701 - Moved calibration buttons to main tab
2024-10-27 Build 24102702 - Added calibration modal to main tab
    [configuration.h]
2024-10-28 Build 24102801 - Updated flow calibration routine - Changed partition regime to allow for OTA - General code tidy - Updated language constants - Fixed issue with index.html upload
    [partitions-default.csv]
2024-10-28 Update BUILD_NUMBER
    [configuration.h]
2024-10-28 24102803 - Added data filter for Rolling Median and base code for Cyclic Average and Mode
    [configuration.h]
2024-10-28 Build 24102804 - Added flow calibration offset to ACFM value
    [configuration.h]
2024-10-28 Build 25101901 - Fixed bug where filter value was not retained
    [configuration.h]
2024-10-29 Build 24102902 - Updated README
    [configuration.h]
2024-10-30 Build 24103001 - Added manual save function for calibration data
2024-10-30 Build 24103002 - Finalised / tested manual save function for calibration data
    Note that I was unable to set up class functions as request handlers within the ESPAsynchWebServer instance using the source examples provided, and so could not call the exsiting SaveCalibrationData class method within the ESPAsynch request handler lambda.
    I am not sure why. Perhaps it is because I have a head full of snot and the challenge exceed my crrent ability lol. But at any rate the net result is that we now have some replication of the code for the saveCalibration and Calibration::SaveCalibrationData methods.
    It's untidy and goes against all good coding practice, but we can tidy it up later. At least we c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
    [configuration.h]
2024-10-30 24103002 - Reformatted BOM CSV for Git rendering
    [BOM_DIY-FLOW-BENCH-V2-3.csv]
2024-10-31 Build 24103101 - Updated leak cal fucntionality as per discssion #178 - Refactored webserver class to reduce spaghetti - General code tidying
    [BOM_DIY-FLOW-BENCH-V2-3.csv]
2024-11-01 Build 24100101 - Missing line terminator #187 - Added user definable flow differential target - Finalised flow differential code Build 24103002 - Added additional 'Flow Differential' tile
    [configuration.h]
2024-11-02 Build 24110201
    - SD Card methods validated
    - Missing line terminator #187
    - Changed unused pins to '-1' in pins.h
    [configuration.h]
2024-11-03 Changes to add M5Stack Core2 and M5Stack TubePressure unit
    [configuration.h]
2024-11-03 A couple of missing semi colons for the XGZP sensors
    [sensors.cpp]
2024-11-03 Update configuration.h
    Changed defaults
    [configuration.h]
2024-11-03 MV_TRIMPOT had not been zeroed out from my last pull request
    [configuration.h]
2024-11-03 Build 24110302 - Fixed flow thresholds to allow negative flow values in GUI
    [configuration.h]
2024-11-03 Update Changelog + Build Number
    [configuration.h]
2024-11-04 Build 24110402 - Added ability to truncate GUI values - Added rounding function to flow values in GUI
    [configuration.h]
2024-11-04 Build 24110403 - Added HTTP API Call for JSON Data
    [configuration.h]
2024-11-05 Update sensors.cpp
    I had missed adding the M5Stack Tube pressure sensors to the initialise
    [sensors.cpp]
2024-11-06 Update sensors.cpp
    mafVelocity of the original pipe area, has an error in its formula.
    [sensors.cpp]
2024-11-07 Build 24110701 - Changed min pressure threshold to allow -ve values - Moved version vars into dedicated file
    [configuration.h]
2024-11-07 24110701 - Changed min pressure threshold to allow -ve values - Moved version vars into dedicated file
2024-11-08 Update sensors.cpp
    Code tidy up so the sensors are correctly reported in the web GUI info page
    [sensors.cpp]
2024-11-08 Build 24110802 - #207 Decimal places on GUI
    [configuration.h]
2024-11-08 Update calculations.cpp
    Changed to code so it takes the absolute values for the new and old pressure, this allows the square root of the pressure ratio to be calculated.
    C++ with the std::sqrt does not return a value for a negative number.
2024-11-11 24111107 - #222 Adjusted standard flow
2024-11-12 #228 - data initialisation
    [configuration.h]
2024-11-16 WEMOS_D1_R32.json change to UART2 pins
2024-11-19 24111801 - Added BME680 Configuration / Library calls
    [configuration.h]
2024-11-19 24111901 - Added Create-Issue-Branch workflow - General project refactor 24111801 - Added BME680 Configuration - Forked BME680 library (https://github.com/DeeEmm/BME680) - Moved github documentation 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
    [configuration.h]
2024-11-21 24112101 - Working pitot velocity - Zero reset for pitot and PDiff sensors - Added pitot velocity calcs - Typecast pins to pin struct from pins.json - Change comparitor for testing pins in initialise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
    [API.cpp, DIY-Flow-Bench.ino, calibration.cpp, calibration.h, datahandler.cpp, hardware.cpp, sensors.cpp, sensors.h]
2024-11-21 24112101 - Working pitot velocity - Zero reset for pitot and PDiff sensors - Added pitot velocity calcs - Typecast pins to pin struct from pins.json - Change comparitor for testing pins in initialise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
    [sensors.cpp]
2024-11-23 24112401 - #158 Correction to output
    [webserver.cpp]
2024-11-24 24112402 - #213 Pitot / differential zeroing - #254 Report sensor voltage to API - Cookie to remember tile status
2024-11-25 24112503 - #213 Pitot offset error
    [sensors.cpp]
2024-11-25 24112601 - #213 Revert change to allow -ve delta / velocity
    [sensors.cpp]
2024-11-28 Pitot Tile not displaying correct value for ∆P
    [datahandler.cpp]
2024-11-28 Correction in calibaration.cpp for calData pdiff and pitot.
    [calibration.cpp]
2024-11-28 24112901 - Pitot Tile not displaying correct value for ∆P - Correction in calibaration.cpp for calData pdiff and pitot. - API Corrections - Added merge-firmware.py - Capitalised DOCS + CHANGELOG dire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
2024-11-30 24113001 - #205 Post compile configuration refactor 24112901 - Pitot Tile not displaying correct value for ∆P - Correction in calibaration.cpp for calData pdiff and pitot. - API Corrections - Added m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
    [configuration.h]
2024-11-30 24120101 - Tidied up status definitions in sensors.begin
2024-12-01 24120102 - Fixed compile error
    [DIY-Flow-Bench.ino]
2024-12-02 24120202 - Update sensor enable handling
2024-12-02 24120203 - Update sensor type handling
2024-12-03 24120301 - Update index.html 24120205 - Update MAF.json handling - Address issue with loading configuration.json 24120204 - Update GUI file load management
    [datahandler.cpp, datahandler.h, sensors.cpp, structs.h, system.h, webserver.cpp]
2024-12-03 24120301 - Update index.html - Change I2C addressing to decimal
2024-12-04 2412050001 - Update build number format [2 to 4 digit] - Auto build number update 24120401 - Utilise api/file/upload path for all uploads - Remove redirect from valve lift capture (change to XHR) - U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
2024-12-08 2412080010 - GUI fixed version increment in GUI info 2412080005 - Test build target for pre user actions 2412060066 - Reformat JSON Data in API
    [API.cpp, sensors.cpp, system.h]
2024-12-09 2412090065 - Fixed XHR form submission
    [API.cpp, DIY-Flow-Bench.ino, calculations.cpp, datahandler.cpp, sensors.cpp, webserver.cpp]
2024-12-09 Temperature change to ISO 5011 from 25°C to 20°C
2024-12-09 2412090001 - #277 Temperature correction for ISO 5011
2024-12-09 2412090109 - Fixed sensor_src type
    [hardware.cpp, sensors.cpp, structs.h]
2024-12-09 2412090117 - Fixed GUI info for MAF sensor type
    [sensors.cpp]
2024-12-10 2412100087 - Moved voltage trim outside of validation test 2412100084 - Fixed JSON to Vector conversion - Added verbose print mode
    [API.cpp, DIY-Flow-Bench.ino, hardware.cpp, messages.cpp, messages.h, sensors.cpp, structs.h]
2024-12-10 Fixes for Pitot GUI
    [datahandler.cpp, sensors.cpp]
2024-12-10 2412100102 - Updated PINS files 2412100094 - #281 Pitot GUi fixes
    [datahandler.cpp, structs.h, system.h, webserver.h]
2024-12-11 2412110068 - Moved MAF initalisation into DataHandler 2412110030 - SFLOW value missing when < 0 - Linked MAF info to forum thread
    [API.cpp, datahandler.cpp, sensors.cpp, structs.h, system.h, webserver.cpp]
2024-12-11 2412110103 - #285 increase template size in DataHandler::loadJSONFile 2412110079 - Fixed MAF file layouts
    [datahandler.cpp, datahandler.h, sensors.cpp]
2024-12-11 2412110117 - Refactored MAF JSON code handling - Removed MAF initialisation from sensors.begin()
2024-12-12 2412120002 - #288 fixed 60mv sensor deviation
    [hardware.cpp]
2024-12-12 2412120051 - #288 Updated Analog calcs to cast to double 2412120016 - Changed ADS1115 to 8 SPS - #288 removed struct from ADC calc - Renames buildSSEJsonData to buildSSEJsonData
2024-12-12 2412130015 - Fixed Issue with pre-compile tasks deleting release
    [sensors.cpp]
2024-12-13 2412130038 - #288 Sensor status info incorrect
2024-12-18 2412180014 - Moved calibration data in to NVM 2412180009 - Renamed _preferences to _config_pref
2024-12-26 2412260034 - Simplified data filter / rounding code 2412260018 - #303 Reset AP via API
    [API.cpp, DIY-Flow-Bench.ino, constants.h, datahandler.cpp, structs.h]
2024-12-28 2412290022 - Sensor page validation
2025-01-04 2501050009 - Resolved NVM Save issue
    [partitions.csv]
2025-01-07 2501070010 - Bugfix (Config dropdowns) - #307 Excel Polynomial Test - Removed Deprecated Code
    [DIY-Flow-Bench.ino, constants.h, datahandler.cpp, hardware.cpp]
2025-01-07 2501080013 - Added float flag to conf var initalisation - Added 3v3 + 5v bus voltage vars - Zeroed disabled sensor values - #307 Fixed ADC class instantiation
    [API.cpp, DIY-Flow-Bench.ino, datahandler.cpp, hardware.cpp, sensors.cpp, structs.h, webserver.cpp]
2025-01-09 2501090012 - ADC initialisation change
2025-01-10 2501100018 - #307 BUG NVM data type for MAF type
    [datahandler.cpp, hardware.cpp]
2025-01-11 2501110021 - 315 Wifi STA Mode Login issue fixed
    [API.h, DIY-Flow-Bench.ino, calibration.cpp, calibration.h, comms.cpp, comms.h, datahandler.cpp, datahandler.h]
2025-01-12 2501120017 - #316 Assign sensor tasks to core 2
2025-01-12 2501120020 - #316 Optimised MAF flow calcs - Deleted configuration.json (deprecated)
2025-01-13 2501130038 - ADC/BME scan timers include execution time 2501130034 - Added Loop() scan time to mimic 2501130032 - Added A/B tests to API
2025-01-13 2501130045 - #316 Moved ADC scan delay inside task loop
2025-01-13 2501130046 - Default ADC / BME scan count changed - Moved poll timer resets to end of tasks - Removed tasks from core 2
    [DIY-Flow-Bench.ino]
2025-01-13 2501130047 - #316 Reset loop delays to 1ms
    [DIY-Flow-Bench.ino, system.h]
2025-01-13 2501130048 - #275 - Set flow offset for all flow types
2025-01-14 2501140002 - #316 changed benchIsRunning to use stored value of MAF flow
2025-01-15 2501150016 - #316 Updated ADC library - Moved ADC + BME poll timers into system.h - Calibrated poll timer values - Updated ADS read frequency - Removed critical settings from GUI - Moved ADC / BME xT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
2025-01-16 2501160017 - #316 Updated Poll timers
2025-01-16 2501160023 - #316 Updated ADC-Lite-Test to DEV level
2025-01-16 2501170002 - #316 Disable ADC continuous mode
2025-01-17 2501170010 - #316 Updated poll timer values - Removed redundant calls to old ADS1115_lite library - #320 Fixed templating issue - Changed opacity of capture modal on hover (obscured flow tile) - Adde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
    [API.cpp, DIY-Flow-Bench.ino, calculations.cpp, hardware.cpp, mafdata.h, system.h]
2025-01-20 2501200030 - #321 Datagraph clear fixed 2501200001 - Removed fullpath from generated comment in htmlToBytes.py
    [API.cpp, datahandler.cpp, publichtml.cpp, publichtml.h, webserver.cpp, webserver.h]
2025-01-22 2501220004 - #322 Removed calibration fields from settings page
2025-01-22 2501220008 - #322 Moved API settings to system.h - Moved calibration settings to dedicted page
2025-01-23 2501230048 - #322 Calibration page finalised
2025-01-23 2501240002 - Optimised Pitot sensor reading
2025-01-24 2501240004 - #325 Added ADC / BME / SSE task sequencing - #325 Removed Semaphore
2025-01-26 2501260012 - #329 Rewrote liftdata.json download request handler - Update ArduinoJSON From V6 to V7
2025-01-27 2501270051 - Upgrade to espressif32 @ 6.10.0 - Increase flash partition size
    [partitions-default.csv]
2025-01-29 2501280078 - Improvements to GUI tile handling 2501280059 - Added coefficients to Mimic page 2501280022 - Improved MAF sensor integration 2501280013 - #341 Change default reference standard to ISO 15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
2025-02-02 2502020001 - Default pin value set to disabled
2025-02-04 2502040029 - Updated Wiki links for calibration and mimic pages
2025-02-04 Build Number | Description of -- | -- 2502050002 | Reformatted Cha . | Moved python fi . | General tidying
    [MAF polynomial calcs V3.xlsx, partitions.csv]
2025-02-05 2502050009 - #289 Fixed Datagraph data type
    [datahandler.cpp, system.h, webserver.cpp]
2025-02-06 2502060001 - #138 Updated BOSCH 0280218067 polynomials
    [MAF polynomial calcs V3.xlsx]
2025-02-06 2502060003 - Added VDO 5WK96132Z MAF (BMW M54B30) 2502060002 - Added Bosch 0280218038 MAF (Audi S4
    [MAF polynomial calcs V3.xlsx]
2025-02-11 Delete ESP32/DIY-Flow-Bench/release/V2.0-RC8_2502060002_install.bin
    DEPRECATED
2025-02-11 Delete ESP32/DIY-Flow-Bench/release/V2.0-RC8_2502060002_update.bin
    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
