DeeEmm/DIY-Flow-Bench/(notices)

Notices in the files:
ESP32/DIY-Flow-Bench/miniz.c:
Copyright 2016 Martin Raiber
All Rights Reserved.
